Arnold-n/P1P2MQTT/doc/Commands-Eseries.md

# Commands for Altherma 3

Most commands can be given via Home Assistant.

If you want to issue your own instructions, this documents explains how to do so for Altherma/Daikin E-series models.

## Introduction

Daikin Altherma 3 systems (many E-series, with the exception of some EKH and EWYQ/EDHQ/E\*Q series) communicate parameters between the main controller (your room thermostat or main LCD control) and auxiliary controller (P1P2MQTT bridge) in packet types 35, 36, and 3A. Packet types 35 and 3A are used to communicate 8-bit values and packet type 36 is used to communicate 16-bit values.

Using this mechanism many system settings can be controlled. This is done using the `E` command when the bridge is in auxiliary control mode (`L1`), but as of v0.9.46 these commands are generated by Home Assistant using MQTT discovery. The system can be put into control mode (`L1`) via Home Assistant.

## E command examples

The detailed info below is only if you are not using Home Assistant or want to understand the `E` command operation. Some of these parameters may be different for different systems and/or different operation modes of the system. The best way to learn which parameter you need to set it so change a setting manually on the main controller while P1P2Monitor acts as auxiliary controller and data is logged via P1P2/R/#.  The main controller will then inform the P1P2Monitor of the new settings which you can then try to write to. Even better is to have another auxiliary controller write parameters and have P1P2Monitor eavesdrop the communication.

The E command format is `E <packet-type> <parameter-number> <new-value>`, all values hexadecimal. If you hate spaces, you may concatenate these using a 2-char packet-type and 4-byte parameter number: `E35 2F 0` becomes `E35002F0`.

Multiple commands can be given in one line with `E <packet-type1> <parameter-number1> <new-value1>  <packet-type2> <parameter-number2> <new-value2>`.

Before P1P2Monitor version v0.9.55rc2 please pause for a few seconds between commands as commands are not yet buffered (buffering will be added in a future version). As of v0.9.55rc2, write commands are buffered.

If you hate spaces, you may concatenate these using a 2-char packet-type and 4-byte parameter number: `E35 2F 0` becomes `E35002F0`

Some example parameters and commands:

Parameter in packet type 35 for switching cooling/heating off
- 0x31 switches cooling/heating on/off in room temperature control mode (works on EHVX08S23D6V)
- 0x2F switches cooling/heating on/off in LWT control mode (works on EHYHBX08AAV3 and EHBH16CAV3)
- 0x2D (works on EHVX08S26CA9W and/or in certain operation modes?)

Commands to switch heating off and on on EHYHBX08AAV3 in LWT control mode:
- `E 35 2F 0` (or `E35002F0` or `E35002F00`)
- `E 35 2F 1` (or `E35002F1` or `E35002F01`)
- Some systems require both 0x31 and 0x2F: `E35002F01 35003101`

Switching between heating, cooling, and automatic mode
- parameter nr 0x4E (works on EHYHBX08AAV3) (value 0=heating 1=cooling 2=auto)
- `E 3A 4E 0` = set mode to heating
- `E 3A 4E 1` = set mode to cooling
- `E 3A 4E 2` = set mode to auto
Budulinek reports that parameter 0x3A this may not work correctly, and that parameter 0x4E in packet type 3A may have to be used instead.

Parameter in packet type 35 for switching DHW on/off
- 0x40 (works on EHVX08S23D6V and EHBH16CAV3) (and/or in certain DHW operating modes)
- 0x3E (works on EHVX08S26CA9W) (and/or in certain DHW operating modes)

Parameter in packet type 35 for switching DHW boost on/off
- 0x48 (works on EHVX08S26CB9W)

Parameter in packet type 35 for selecting heating mode (ABS/AWT/ABS+dev/AWT+dev) (not always allowed!)
- 0x56 (works on EHYHBX08AAV3)

Parameter in packet type 35 for selecting silent mode
- 0x03 (value 0=off, 1=on)

Parameter in packet type 35 for selecting silent level
- 0x01 (value 1..3 (3 most silent))

Parameter in packet type 36 for setting target room temperature (only in room-thermostat mode)
- 0x00 (works on EHYHBX08AAV3)

Example commands to set room temperature setpoint
- E 36 0 BE sets room temperature setpoint to 0xBE = 190 = 19.0 C
- E 36 0 C8 sets room temperature setpoint to 0xC8 = 200 = 20.0 C

Parameter in packet type 36 for setting DHW setpoint
- 0x03 (works on EHYHBX08AAV3 and EHBH16CAV3)

Parameter in packet type 36 for setting heating temperature setpoint (only in fixed LWT mode)
- 0x06 (works on EHBH16CAV3 and EHYHBX08AAV3)

Parameter in packet type 36 for setting cooling temperature setpoint (only in fixed LWT mode)
- 0x07 (works on EHVX08S26CB9W, likely on others too)

Example commands to set fixed LWT mode main zone temperature setpoint
- E36 6 015E sets LWT setpoint to 0x015E = 350 = 35.0 C
- E36 6 01C2 sets LWT setpoint to 0x01C2 = 450 = 45.0 C

Parameter in packet type 36 for setting main zone heating temperature deviation (only in weather-dependent LWT mode)
- 0x08 (works on EHYHBX08AAV3)

Example commands to set WD-LWT mode curve deviation
- `E36 8 0` sets deviation to +0 C
- `E36 8 A` sets deviation to +1 C
- `E36 8 FFF6` sets deviation to -1 C

Parameter in packet type 36 for setting main zone cooling temperature deviation (only in weather-dependent LWT mode)
- 0x09 (works on EHYHBX08AAV3)

Parameter in packet type 36 for setting additional zone heating temperature deviation in WD mode
- 0x0D (works on EHYHBX08AAV3)

Some other parameters:
- parameter 0x31 in packet type 3A is perhaps used to disable/enable holiday (to be confirmed)
- parameter 0x4B in packet type 3A is used to switch between 0=manual and 1=automatic DST mode
- parameter 0x5B in packet type 3A is used to switch holiday 0=off 1=on
- parameter 0x5E in packet type 3A is used to switch between heating schedules
- parameter 0x5F in packet type 3A is used to switch between cooling schedules
- parameter 0x64 in packet type 3A is used to switch between DHW schedules

Force defrost (defrost start is subject to outdoor unit conditions):
- `E35003601`

Many thanks to Budulinek for finding some of these parameters. More writable parameters can be found in Budulinek's [documentation](https://github.com/budulinek/Daikin-P1P2---UDP-Gateway/blob/main/Payload-data-write.md).
