Arnold-n/P1P2MQTT/howto/Arduino_IDE_setup_combiboard.md

# Arduino IDE setup for P1P2Monitor and P1P2-bridge-esp8266 on Arduino Uno or on Uno/ESP8266 combi-board

The Arduino Uno or combi-board is no longer recommended for this project.
