Arnold-n/P1P2MQTT/(threads)

Thread 27 (2022-08-29):

[home-assistant] Energy statistics not available

Timple, 2022-08-29:
I wanted to add my heatpump to the energy dashboard but it was not in the dropdown list.

As requested per this link: https://www.home-assistant.io/more-info/statistics/ I know opened this issue pointing this project to this link: https://developers.home-assistant.io/docs/core/entity/sensor/#long-term-statistics

Is the `state_class` something that can be communicated via mqtt?

Arnold-n, 2022-08-29:
Thanks tim, hopefully this works in just released P1P2-bridge-esp8266 v0.9.18. Coding is done ad-hoc, as it will be coded differently in P1P2MQTT.

Timple, 2022-08-30:
Great, thanks!

Would it make sense to attached these releases as binaries to the releases tab in github?

Arnold-n, 2022-08-30:
Just did! Thanks for the suggestion.

Timple, 2022-08-31:
Awesome!
I'll verify asap (which is two weeks unfortunately)

Timple, 2022-09-12:
Works! Thanks 👍

Closed 2022-08-31.

Thread 29 (2022-09-04):

[Home Assistant] some topics fail discovery

fishbone-git, 2022-09-04:
Home Assistant logs attached below. I suspect te issue is an MQTT buffer problem as it seems to be the very long topic names that get cut off at the end, so the discovery topic fails to parse due to missing closing } at least
[halogs.txt](https://github.com/Arnold-n/P1P2Serial/files/9485553/halogs.txt)

Arnold-n, 2022-09-04:
Hi @fishbone-git, indeed it is the MQTT buffer size, please upgrade to 0.9.18 which increases this (HA_VALUE_LEN) from 300 to 600 to resolve this issue.

fishbone-git, 2022-09-04:
in progress

fishbone-git, 2022-09-04:
The buffer problem appears solved, but there is a new problem.  I'm using HA 2022.9.0b4.  All topics appear in MQTT broker, and in th discovery topic.  HA is having a problem with a number of them, and so they are no longer available entities in HA after upgrading to 0.9.18. Hard  to check all topics, but the ones generating the error all seem to have state_class="".  I do not believe this is allowed by HA.  When I manually publish a discovery topic to remove state_class="", it immediately creates an entity in HA
[halogs.txt](https://github.com/Arnold-n/P1P2Serial/files/9485604/halogs.txt)

Arnold-n, 2022-09-04:
You're fast and fully correct! Sorry, I should have advised to jump to the newest version: 0fd7519 solves this too.

fishbone-git, 2022-09-04:
I just spotted that too :).  I guess let's close this and either I'll see if I can now get a working build or wait until next binaries are published. Thx!

Arnold-n, 2022-09-04:
I'll make them available soon - was waiting for the climate and water heater integration to be finished and tested.

Arnold-n, 2022-09-04:
Not as official release, but v0.9.20 images (for E_series) are [here](https://github.com/Arnold-n/P1P2Serial/tree/main/Firmware_images).

Arnold-n, 2022-09-05:
The images have been replaced as the ATmega OTA upgrade didn't work properly due to a BSP issue on my side. The current Eseries images should be fine.

fishbone-git, 2022-09-06:
Thanks.  I'll try the images tonight and see if there is a difference.  I did finally manage to get a build on arduinoIDE that seems stable

Closed 2022-09-04.

Thread 30 (2022-11-03):

Interested in buying p1p2-esp interface

stomko11, 2022-11-03:
As title says. Do you have any available?
Can I have both this and daikin controller connected at the same time? How do I wire them?

Arnold-n, 2022-11-03:
Hi @stomko11 please send me email for details.

Not sure if you refer to the main (room) controller or the Daikin LAN/WiFi adapter.

All controllers are wired in parallel on P1 and P2.
You must have one "main controller" which is the room controller/thermostat.
You may have one (in some systems two) auxiliary controllers active, such as a Daikin LAN adapter, or P1P2Serial, but not both.

P1P2Serial can also work in listen-only mode, in which case it can always be connected to P1/P2, but only if there not too many consumers on the bus (we do not know what the max bus load is).

stomko11, 2022-11-04:
Hello. I actually failed to find your email address anywhere - where do I send you email?
I am using only one controller currently, it is not serving as thermostat, for that I use external on/off contact. So my daikin controller serves only to configure my Altherma air to water heatpump. I would like to keep that available in technical room, and wire that in parallel somehow. Main goal is to be able to turn on/off DHW/Heating. Would I just connect it on the pins inside controller?
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

Arnold-n, 2022-11-04:
Indeed you can wire it in parallel, near the controller in your image, or near the heat pump, as long as there is WiFi (or if there is ethernet with the extra ethernet adapter). As the wires in your picture are quite thick I would split them outside the unit, and make the last wire thinner (= more flexible). My e-mail is a bit hidden in the README and [in the code](https://github.com/Arnold-n/P1P2Serial/blob/main/P1P2Serial.cpp#L3).

Thread 35 (2022-11-19):

About P1P2 energy consumption data

kervanaslan, 2022-11-19:
Hi Arnold,

Firstly, thanks for this great job.
I'm wondering if it is possible to periodically get Energy consumption data from P1P2. Does P1P2 some how send data?

You defined KLICK-DA is a way to get it, but without KLICK-DA are we able to get it?

Arnold-n, 2022-11-19:
Hi @kervanaslan,

Thanks for asking and your appreciation. This is possible on some systems using the "C2" command. Given limited resolution, an external meter is still preferred (and will be supported as input  over MQTT for COP calculation in the future).

The KLIC-DA is indeed not the preferred solution. It was a difficult hack made (with lots of trial and error) for a KLIC-DA owner where KLIC-DA was already acting as an auxiliary controller. There is little opportunity in the P1/P2 protocol to request the energy consumption counters. The KLIC-DA solution may not work reliably on other systems. And the KLIC-DA device ignores the heat pump replies itself, just as the main controller - the main controller only updates the counters if it requests the counters itself, and the KLIC-DA device relies on the main controller only.

Unfortunately within the Daikin protocol implementation there is no known "legal" way to request these counters from the heat pump - the main controller (the wall thermostat) only requests the counters when requested  manually, or at the end of each month. There is no (documented) way to trigger the main controller to request these counters. The current solution (enabled by the "C2" command) is to let the P1P2-ESP-interface request the counters directly from the heat pump. This may confuse the main controller; perhaps this leads in some systems to the main controller and the heat pump both responding at the same time. In my system the heat pump answers, and shortly after the main controller continues regular operation, so it works find. You can try "C2" and see if the communication pattern is acceptable. If not, it will result in errors, and after 10 errors the interface will switch itself of as a safety mechanism.

If the mechanism works (and if the heat pump does measure energy consumption and similar counters, your system may be different) the following information may be seen on MQTT topics P1P2/P/xxx/C/1/#:
```
P1P2/P/154/C/1/Electricity_Consumed_Backup_Heating 0
P1P2/P/154/C/1/Electricity_Consumed_Backup_DHW 0
P1P2/P/154/C/1/Electricity_Consumed_Compressor_Heating 16777
P1P2/P/154/C/1/Electricity_Consumed_Compressor_Cooling 0
P1P2/P/154/C/1/Electricity_Consumed_Compressor_DHW 0
P1P2/P/154/C/1/Electricity_Consumed_Total 39305
P1P2/P/154/C/1/Energy_Produced_Heatpump_Heating 148206
P1P2/P/154/C/1/Energy_Produced_Heatpump_Cooling 0
P1P2/P/154/C/1/Energy_Produced_Heatpump_DHW 0
P1P2/P/154/C/1/Energy_Produced_Heatpump_Total 148206
P1P2/P/154/C/1/Hours_Circulation_Pump 36037
P1P2/P/154/C/1/Hours_Compressor_Heating 28968
P1P2/P/154/C/1/Hours_Compressor_Cooling 0
P1P2/P/154/C/1/Hours_Compressor_DHW 0
P1P2/P/154/C/1/Hours_Backup1_Heating 0
P1P2/P/154/C/1/Hours_Backup1_DHW 0
P1P2/P/154/C/1/Hours_Backup2_Heating 0
P1P2/P/154/C/1/Hours_Backup2_DHW 0
P1P2/P/154/C/1/Hours_Unknown_34 0
P1P2/P/154/C/1/Hours_Unknown_35 0
P1P2/P/154/C/1/Counter_Unknown_00 0
P1P2/P/154/C/1/Counter_Unknown_01 0
P1P2/P/154/C/1/Counter_Unknown_02 0
P1P2/P/154/C/1/Starts_Compressor 21022
P1P2/P/154/C/1/Hours_Gasboiler_Heating 12857
P1P2/P/154/C/1/Hours_Gasboiler_DHW 513
P1P2/P/154/C/1/Counter_Gasboiler_Heating 0 (some systems report gas usage here)
P1P2/P/154/C/1/Counter_Gasboiler_DHW 0 (some systems report gas usage here)
P1P2/P/154/C/1/Starts_Gasboiler 46897
```
Strangely, the counter for Electricity_Consumed_Compressor_Heating stopped counting in 2018, also on the main controller from Daikin, even before I started with P1/P2 experiments, but the Electricity_Consumed_Total continues to update. There are other users with the same problem.

Thread 41 (2022-12-23):

Rotex RKHBRD016 (Daikin Altherma EKHBRD-ADV17), strange values

mrrepel, 2022-12-23:
Hi,

First of all, thanks to Arnold for sending the P1P2ESP quickly, it arrived within 2 days and, looking at the construction method, I can only say that it is like an commercial product! After I received it I immediately got tinkering.

Unfortunately it seems that my heat pump is not supported. The values fluctuate on some sensors (not all) and the values are not correct.

Below is a screenshot of the HA interface.

I am not a programmer but a hobbyist. I would like to hear if and how I can help with providing logs etc. so that this heat pump can also be supported. The values I am particularly interested in are;
- DHW temp
- Leaving / return temp
-Outside temp

Kind regards, Barry

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

Arnold-n, 2022-12-23:
Thanks @mrrepel for your feedback. Indeed RKH*/EKH* systems (which I think are called Altherma 2) are not as wel supported as Altherma 3 systems. For now I think we would be able to modify the code such that it reports a number of sensor values (I hope at least some of the temperatures (49.000, 44.582, 33.906) are correct for your system even if the names used may be wrong). We will need to write a separate header file for the EKH systems. It would be helpful for me to receive your logs of raw data P1P2/R/# together with a description of system changes made during the log (on/off, target setings changed manually, temperature values changing as a response, so we can match these to the changes in the raw data logs).

There are a few EKH* users with the P1/P2 interface so this issue would be a good place to start sharing EKH/RKH experiences.

inmantaci, 2022-12-24:
Now that my holidays have started I picked it up again for my Altherma 2 (EKHVH008BB6WN). I can already report the following:

1. Set point values are decoded correctly. However the labels are not correct. The following changes need to happen.
   - `S1_DHW_Setpoint_Response` -> Target temperature leaving water. There is no room thermostat in my system, so room temperature is not the correct label I think.
   - `S0_Target_Temperature_Room` -> Target temperature DHW Tank

2. All measured values seem to have the wrong encoding applied. The jump up and down while on the controller itself only the value after the . seem to fluctuate. I "hacked" the NTC of my boiler with 2 relays so that I can let it measure the correct value, a very low value or a high value. I use this to make it heat only on solar in the summer. This also means that I can create an mqtt dump while the values change before the .

I have not dived deeps enough into but at the very least it seems that the byte order is different (or not fixed point at all). Often the part behind the . is stable while the part before it fluctuates a lot. The results of my experiment are as follows. The files attached are the dumps that correspond to the values the daikin controller reported. I wrote down all the values I saw:

A. 44.1 44.2 44.4
B. 31.5 31.6
C. 56.9 57

[B.txt](https://github.com/Arnold-n/P1P2Serial/files/10298491/B.txt)
[C.txt](https://github.com/Arnold-n/P1P2Serial/files/10298492/C.txt)
[A.txt](https://github.com/Arnold-n/P1P2Serial/files/10298493/A.txt)

Based on the changing values, my guess is that this sensor is labeled `T1_Temperature_DHW_Tank`

Once we can find the correct encoding, it should not be to difficult anymore to also correctly label all other values. They all report the same strange values.

bartv, 2022-12-24:
Now that my holidays have started I picked it up again for my Altherma 2 (EKHVH008BB6WN). I can already report the following:

1. Set point values are decoded correctly. However the labels are not correct. The following changes need to happen.
   - `S1_DHW_Setpoint_Response` -> Target temperature leaving water. There is no room thermostat in my system, so room temperature is not the correct label I think.
   - `S0_Target_Temperature_Room` -> Target temperature DHW Tank

2. All measured values seem to have the wrong encoding applied. The jump up and down while on the controller itself only the value after the . seem to fluctuate. I "hacked" the NTC of my boiler with 2 relays so that I can let it measure the correct value, a very low value or a high value. I use this to make it heat only on solar in the summer. This also means that I can create an mqtt dump while the values change before the .

I have not dived deeps enough into but at the very least it seems that the byte order is different (or not fixed point at all). Often the part behind the . is stable while the part before it fluctuates a lot. The results of my experiment are as follows. The files attached are the dumps that correspond to the values the daikin controller reported. I wrote down all the values I saw:

A. 44.1 44.2 44.4
B. 31.5 31.6
C. 56.9 57

[B.txt](https://github.com/Arnold-n/P1P2Serial/files/10298491/B.txt)
[C.txt](https://github.com/Arnold-n/P1P2Serial/files/10298492/C.txt)
[A.txt](https://github.com/Arnold-n/P1P2Serial/files/10298493/A.txt)

Based on the changing values, my guess is that this sensor is labeled `T1_Temperature_DHW_Tank`

Once we can find the correct encoding, it should not be to difficult anymore to also correctly label all other values. They all report the same strange values.

Arnold-n, 2022-12-24:
Hi @bartv - thanks very much, very useful information. I will set up a separate header file for EKH over the next week based on your findings.

The user manual for the EKHBRD-ADV17 system indicates that it supports a main controller (room thermostat) and a slave controller (2nd room thermostat, used for controlling but not really as room thermostat). If someone would have a system with 2 such controllers and make raw data logs when changing settings on the 2nd auxiliary/slave controller, we could determine whether the protocol between main controller (master) and auxiliary controller (slave) would function in the same way as on other systems, and we would actually be able to control EKH/RKH systems too!

bartv, 2022-12-24:
Yeah, I have already started searching ebay and 2hands for something like that. No luck so far :-)

bartv, 2022-12-24:
My C is a bit rusty and the code is not the most accessible to make changes to so I wrote a short python script to validate my suspicion that the bytes are swapped. In the A trace I was able to get the 3 values I read on the controller like this:

```python
data = """05084C2CD41704184818F414A9
05084C2CD417181848180C1557
05084C2CD41730183018F4140E
05084C2CEC17181830180C1530
05084C2CEC1718184818F41456
05084C2CEC17301848180C152D
0508282C0418181830180C15EC
0508282C0418301848180C15F1
0508282CD417041860180C1594
0508282CD417181830180C1512
0508282CD41718184818F41474
0508282CEC17041830180C15ED
0508282CEC17181830180C1557
0508282CEC1718184818F41431
05084C2C0418301848180C1596
05084C2CBC17181830180C1521
05084C2CD417181830180C1575
05084C2CD41718183018F41431
05084C2CD417181848180C1557
05084C2CD41718184818F41413
05084C2CD417181860180C1549
05084C2CD41730183018F4140E
05084C2CEC17181830180C1530
05084C2CEC1718183018F41474
05084C2CEC17181848180C1512
05084C2CEC1718184818F41456
05084C2CEC17301830180C150F
05084C2CEC17301848180C152D
05084C2CEC1730184818F41469
05086C2CBC17181830180C1534
05086C2CD41704184818F414BC
05086C2CD41718183018F41424
05086C2CD417181848180C1542
05086C2CEC1704184818F414F9"""

for line in data.splitlines():
    data = []
    for i in range(int(len(line) / 2)):
        data.append(int(line[2*i:2*i+2], 16))

    vars = data[2:4]
    print("{:2.1f}".format(vars[1] + vars[0] / 256))
```

So the value is like f8_8, except the function should be:
```c
float FN_f8_8(uint8_t *b)            { return (((int8_t) b[0]) + (b[-1] * 1.0 / 256)); }
```

mrrepel, 2022-12-24:
The DHW setpoint response seems to be the  "stooklijn" from the weather setpoint. This is the preset for leaving temp hot water for heating (when it is cold, the heatingwater will be warmer and vice versa, see graph). Setting 3 in the menu. I also use an external thermostat with the EKRP1AHTA interface card (dry relais), so there are no room temperature settings for me.

Also the next sensors are correct:
S0_Heating_OnOff
S0_DHW_OnOff
S0_Quiet_Mode
S1_Defrost_Operation

Mismatches in names:
T1_Temperature_Refrigerant_1 seems to be T1_Temperature_Return_Water
T1_Temperature_Outside_1 seems to be  T1_Temperature_DHW_Tank

Because i switch the heatpump on/off externally for heating i think these ones are correct to:
S1_Circulation_Pump_OnOff
S1_Compressor_OnOff

The warmtepomp on/off is a relais starting/stopping heating

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

bartv, 2022-12-25:
I did an attempt to update the firmware to already figure out the correct labels. I am unable to generate a working firmware using the arduino ide. It compiles and can uploaded (both using serial and OTA), the boards responds to a ping but it does not connect to MQTT and the telnet interface does not come up. I used my arduino ide before, even for esp* boards. I guess there must be some setting that is wrong?

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

Arnold-n, 2022-12-25:
Hi @bartv, I think you have flash size set to default 1MB instead of 4MB. This value determines where the "EEPROM" (wifi/mqtt) data is stored. Even with 1MB selected, the WiFiManager AP "P1P2MQTT" should restart to allow entering your wifi/mqtt settings. If you change the configuration to 4MB, I think you will get the original settings back. Please let me know if that does not help - ultimate fall-back is programming with the USB programmer and "Erase Flash: All".

Also there are some changes needed to the BSP and libraries. The ESP_Telnet library owner implemented my suggestion for making the library working with ethernet differently than I did, so for the current ESP code you still need my modified version of the library, or #undefine ETHERNET, or change the code. I will update the code to allow the use of the official library now it is updated.

bartv, 2022-12-25:
That did the trick. I patched the f8_8 function to swap the bytes and now I get all stable readings
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

Arnold-n, 2022-12-25:
Great, many thanks! I'll incorporate this change and the name corrections into the new header file for EKH/RKH systems, or if you prefer, feel free to do so yourself.

bartv, 2022-12-25:
I created a draft PR with my findings and experiments: https://github.com/Arnold-n/P1P2Serial/pull/46

@mrrepel if you want I can also post a firmware image

Arnold-n, 2022-12-25:
Thanks - I would suggest to use #ifdef EKH constructs to keep the original functionality maintained for Altherma 3, or to create a separate header file for EKH.

bartv, 2022-12-25:
That is why I created the PR. I am not sure on how much is shared between E* and EKH*. So first I am going to make the change in the E header and then decide on how to support both.

mrrepel, 2022-12-25:
@bartv , that would be really nice!

Some logs from my system are added. If there is any need for specific logs / actions, please tell.
[log1.txt](https://github.com/Arnold-n/P1P2Serial/files/10300037/log1.txt)

bartv, 2022-12-25:
I can confirm that the outside temperature is correct.

bartv, 2022-12-25:
> @bartv , that would be really nice if you post the image.
>
> Some logs from my system are added. If there is any need for specific logs / actions, please tell. [log1.txt](https://github.com/Arnold-n/P1P2Serial/files/10300037/log1.txt)

[P1P2-bridge-change.ino.generic.zip](https://github.com/Arnold-n/P1P2Serial/files/10300619/P1P2-bridge-change.ino.generic.zip)

bartv, 2022-12-25:
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

You might need to remove the integration from HA and let it discover again so that the renamed values are gone.

bartv, 2022-12-26:
I was able to figure out some more fields. Others are still work in progress. I create another repo with my scripts and current documentation:
https://github.com/bartv/p1p2decoder/blob/main/ekh.py

The summary:
https://github.com/bartv/p1p2decoder/blob/main/ekh.md

mrrepel, 2022-12-26:
Thanx Bart for sharing the firmware. Just finished flashing the ESP and after some trial and error i got the interface working again (fully my fault :-)).

The values and labels have changed, some readings work, others dont.

<html xmlns:v="urn:schemas-microsoft-com:vml"
xmlns:o="urn:schemas-microsoft-com:office:office"
xmlns:x="urn:schemas-microsoft-com:office:excel"
xmlns="http://www.w3.org/TR/REC-html40">

<head>

<meta name=ProgId content=Excel.Sheet>
<meta name=Generator content="Microsoft Excel 15">
<link id=Main-File rel=Main-File
href="file:///C:/Users/mrrepel/AppData/Local/Temp/msohtmlclip1/01/clip.htm">
<link rel=File-List
href="file:///C:/Users/mrrepel/AppData/Local/Temp/msohtmlclip1/01/clip_filelist.xml">
<style>
<!--table
	{mso-displayed-decimal-separator:"\,";
	mso-displayed-thousand-separator:"\.";}
@page
	{margin:.75in .7in .75in .7in;
	mso-header-margin:.3in;
	mso-footer-margin:.3in;}
tr
	{mso-height-source:auto;}
col
	{mso-width-source:auto;}
br
	{mso-data-placement:same-cell;}
td
	{padding-top:1px;
	padding-right:1px;
	padding-left:1px;
	mso-ignore:padding;
	color:black;
	font-size:11.0pt;
	font-weight:400;
	font-style:normal;
	text-decoration:none;
	font-family:Calibri, sans-serif;
	mso-font-charset:0;
	mso-number-format:General;
	text-align:general;
	vertical-align:bottom;
	border:none;
	mso-background-source:auto;
	mso-pattern:auto;
	mso-protection:locked visible;
	white-space:nowrap;
	mso-rotate:0;}
.xl63
	{mso-number-format:"\@";}
-->
</style>
</head>

<body link="#0563C1" vlink="#954F72">

Label | Arnold | Bart
-- | -- | --
S0 DHW on/off | ok | ok
S0DHW setpoint response | not sure | fault, stays at 16'C
S0 heating on/off | ok | ok
S0 Quit mode | ok | ok
S1 circulation pump | ok | to be tested (seems ok)
S1 compressor on/off | ok | to be tested (seems ok)
S1 defrost operation | ok | ok
S1 target temp leaving water | NA | ok
T1 temperature DHW tank | fault (+120/-120'C) | fault (0,2/0,8'C)
T1 Temperature_HP2Gas_Water | NA | fault (5/-80'C)
T1 leaving water | fault (near 0'C) | ok (resolution 1 degree)
T1 temp outside | label fault, must be T1_Temperature_DHW_Tank | fault, stays at 0'C
T1 temp refrigirant 1 | label fault, must be T1_Temperature_Return_Water | fault, (+120/-120'C)
T1 temp return water | fault (near 0'C) | label fault, must be T1_Temperature_Outside
mqtt: valve 3 way |   | equal to S0 DHW on/off

</body>

</html>

For my heatpump a combination of both could do the trick:

<html xmlns:v="urn:schemas-microsoft-com:vml"
xmlns:o="urn:schemas-microsoft-com:office:office"
xmlns:x="urn:schemas-microsoft-com:office:excel"
xmlns="http://www.w3.org/TR/REC-html40">

<head>

<meta name=ProgId content=Excel.Sheet>
<meta name=Generator content="Microsoft Excel 15">
<link id=Main-File rel=Main-File
href="file:///C:/Users/mrrepel/AppData/Local/Temp/msohtmlclip1/01/clip.htm">
<link rel=File-List
href="file:///C:/Users/mrrepel/AppData/Local/Temp/msohtmlclip1/01/clip_filelist.xml">
<style>
<!--table
	{mso-displayed-decimal-separator:"\,";
	mso-displayed-thousand-separator:"\.";}
@page
	{margin:.75in .7in .75in .7in;
	mso-header-margin:.3in;
	mso-footer-margin:.3in;}
tr
	{mso-height-source:auto;}
col
	{mso-width-source:auto;}
br
	{mso-data-placement:same-cell;}
td
	{padding-top:1px;
	padding-right:1px;
	padding-left:1px;
	mso-ignore:padding;
	color:black;
	font-size:11.0pt;
	font-weight:400;
	font-style:normal;
	text-decoration:none;
	font-family:Calibri, sans-serif;
	mso-font-charset:0;
	mso-number-format:General;
	text-align:general;
	vertical-align:bottom;
	border:none;
	mso-background-source:auto;
	mso-pattern:auto;
	mso-protection:locked visible;
	white-space:nowrap;
	mso-rotate:0;}
.xl65
	{font-weight:700;}
-->
</style>
</head>

<body link="#0563C1" vlink="#954F72">

Label | Function
-- | --
S0 DHW on/off | Arnold/bart S0 DHW on/off
S0DHW setpoint response | Arnold S0 DHW setpont response
S0 heating on/off | Arnold/bart S0 heating on/off
S0 Quit mode | Arnold/bart S0 Quit/mode
S1 circulation pump | Arnold/bart S1 circulation/pump
S1 compressor on/off | Arnold/bart S1 compressor on/off
S1 defrost operation | Arnold/bart S1 defrost/operation
S1 target temp leaving water | Bart S1 target temp leaving water
T1 temperature DHW tank | Arnold T1 temp outside
T1 leaving water | Bart T1 leaving/water
T1 temp outside | Bart T1 temp return water
T1 temp return water | Arnold T1 temp refrigirant 1

</body>

</html>
My programming skills are the same as my French....bonjour, croissant and thats it. So i am sorry my help is limited. If it is possible to make an combination of both, you would be my heroes! :-)

Greetings,

Barry

aluisperezh, 2023-01-03:
Hi everybody. I'm using Arnold's interface with my EKHBRD011ADV17, and found the same results of the first part of this thread. I'll try to read the rest and report back.

For what is worth, my installation includes a RTD-W interface, which is connected to the P1/P2 inetrface and provides ModBus connection. I can manage some options and read and write (some) values with the ModBus connection, but not all of them.

If anybody wants me to test something, just tell me.

Thanks everybody for your work and regards.

Angel

bartv, 2023-01-03:
That would be really cool. It would be interesting if you can create two dumps:

1. a longer dump that just records what is going on when you are not making change. Mainly to see if and how there is interaction between the RTD-W and the main controller.
2. a short dump where you change setting through modbus

I create the dumps like this (replace with your mqtt server):

```
mosquitto_sub --host 192.168.32.23 -v -t "P1P2/R/040" > dump.txt
```

Arnold-n, 2023-01-03:
@aluisperezh indeed as @bartv mentions: logs are useful both making no changes, when making changes on the main controller, and when making changes with the RTD-W.

Perhaps it is interesting to do a full log also when the system restarts, to determine if there is any particular extra communication with the RTD-W which is only there during/shortly after a system restart.

aluisperezh, 2023-01-03:
I'm recording the "standard working" logs right now, but there are not many lines written: only one ("P1P2/R/078 R T  0.003: 40F0344B") in the last few minutes. Should I enable some verbose option or anything like that? I'll leave it recording all night and tomorrow I'll record some more changing things through RTD-W. Restarting the whole machine (I understand that that's what you mean, Arnold) is a little bit more difficult, but I'll try.

Regards

Angel

aluisperezh, 2023-01-04:
Must be doing something wrong. No other lines in the output file but the one I saw yesterday...

bartv, 2023-01-04:
> Must be doing something wrong. No other lines in the output file but the one I saw yesterday...

What command do you use to subscribe to the mqtt stream?

aluisperezh, 2023-01-04:
This is what I'm using:

nohup mosquitto_sub --host 192.168.98.11 -u myuser -P mypassword -v -t "P1P2/R/078" > dump_standard_working.txt &

With mqtt Explorer I can't see any more messages. And I assumed that your 040 should be my 078 (final byte of IP address).

Regards

aluisperezh, 2023-01-04:
There is nothing else there:
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

And I can see that the device is connected through telnet:
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

aluisperezh, 2023-01-05:
I restarted the Altherma machine. I won't be able to do it when I'm back home tonight, so I did it now. There are no other lines besides the one I sent yesterday, but the telnet session gives some more info. I have attached what I could see there.

My P1P2 device is powered by the P1P2 interface, so everything is restarted. I mean, no commands provided through telnet or any other way.

I can connect trhough telnet or to the MQTT server from home, so I can do some tests later.

Regards
Angel
[Conexión Telnet.txt](https://github.com/Arnold-n/P1P2Serial/files/10352181/Conexion.Telnet.txt)

Arnold-n, 2023-01-05:
Hi @aluisperezh , thanks and interesting, you seem to have a Daikin system where a payload may be longer than 24 bytes. P1P2Serial is optimized for Daikin and we have never seen payloads more than 24 bytes so far. This explains the ":OR- buffer overrun error. Telnet by default only shows messages with errors, so that is why you see only 00F038 and related messages (and a few caused by ESP serial input buffer overruns - this is another issue).

MQTT explorer cannot easily log all the P1P2/R/# data, but in telnet you will see all raw hex data by entering the command
`j13013
`
Could you try that?

Increasing P1P2Serial's buffer size can be done by changing, in P1P2Serial.h, RX_BUFFER_SIZE and TX_BUFFERSIZE from 25 in max-packet-length+1 (I cannot deduce the max packet length from your log, too large will give instability issues, but 65 would be OK and may be enough). I just sent you a P1P2Monitor firmware image by mail with increased buffer size.

aluisperezh, 2023-01-06:
Wow. More than 1M of text in a few minutes... I attached the zip-compressed file. Now I'm trying to find out how to update the firmware without breaking everything (I'm an expert on doing that). As soon as I do it I'll try to get both MQTT and telnet info.

Regards.
[telnet_j13013.zip](https://github.com/Arnold-n/P1P2Serial/files/10362420/telnet_j13013.zip)

trantoriana, 2023-01-07:
> MQTT explorer cannot easily log all the P1P2/R/# data, but in telnet you will see all raw hex data

I have a small python program for logging mqtt topics to file as telnet is bothersome.
If needed I can share.

Arnold-n, 2023-01-07:
Thanks for your inputs. My analysis so far is that there are differences:
@bartv has a EKHVH008BB6WN
@aluisperezh  and @aluisperezh have a EKHBRD* system
and the raw packet data is not the same:

For the EKHVHV, there are unfortunately no 00F0* messages in the logs above, suggesting the system does not support an auxiliary controller, whereas for EKHBRD* systems there are 00F0* messages and communication between main system and RTD-W, and the communication style is closer to the F* Daikin models than to the Altherma 3 models.

Packet type 000010 (from main controller):
-EKHVHV: 17 byte payload with a number of settings
-EKHBRD: 18 byte payload with  a number of (similar) settings

Packet type 000011 (from main controller):
-both: 3 byte payload, likely with last 2 bytes representing measured room temperature (LE)

Packet type 400010 (from EKH):
-both: 20 bytes, with somewhat similar structure

Packet type 400011 (from EKH):
-EKHVHV: 12 bytes, 2 bytes unknown followed by 5 temperature sensors (BE (!))
-EKHBRD: 12 bytes, 2 bytes unknown followed by perhaps 5 temperature sensors (LE)

Packet types 38 with header 00F038/40F038 for main-aux control data (EKHBRD only)  are
```00F038 00 00 01 00 41 00 0A 00 20 00 08 00 00 00 00 00 00 06 00 05```
```40F038 00 01 00 41 00 0A 00 20 00 00 00 00 00 05```
and most of these settings relate directly to the heat pump status information in 400010 from EKH to main controller:
`400010 00 00 01 00 41 00 0A 00 20 00 18 00 00 00 00 00 02 00 00`

It would be interesting to monitor 00F038* and 40F038* when making changes on the main controller and via RTD-W, and match time of these changes.

aluisperezh, 2023-01-07:
Thanks for the info, Arnold. I will try to make some changes through RTD-W while monitoring the P1P2 device, but I'm not sure about timing. I manage RTD-W through Home Assistant, which is NTP synchronized, but I don't remember assigning an NTP server to P1P2. Let's hope Mosquitto in HA is in sync. I'll try to make changes with some time in between to be sure they don't get meses.

I can't try this until monday morning, but I'll be back with the results.

Thanks again everybody.

Arnold-n, 2023-01-08:
Hi @aluisperezh, and indeed I meant to log telnet while making the changes; time is then derivable from the 00F034 message which contains DayOfWeek, Hour, Minute, and Second.

There is no direct ESP time stamp in telnet yet (other than the Uptime info and the 00F034 time stamp), but a decent time stamp is on my todo-list.

But indeed it may be much easier to use HA to log any changes, let me make a EKHBRD firmware image so all relevant information is made available in HA. Not sure if I can manage that today.

aluisperezh, 2023-01-08:
Don't worry. I'll log the telnet sesión and try to match times. And of course I can repeat that any time.

Regards

aluisperezh, 2023-01-09:
Hello everybody.

I'm attaching 3 files. The txt just explains what I did and the results I can see through ModBus. I tried to get the best timing I could.

The "Enable Heating" telnet session is just that, the standard telnet output and the results of enabling heating in HA (through ModBus interface and RTD-W).

The "Heating+Thermostat" includes a few actions. In my installation, the remote thermostat (a Tuya WiFi thermostat) activates the external pump when On and deactivates it when Off. Besides, it is connected to the external Thermostat connector of the machine (I don't remember if it's connected directly to the motherboard or to the RTD-W, sorry).
I turned on the thermostat, and because Heating was already enabled (previous file), STart/Defrost mode was activated first and then compressor turned on too. I recorded the time when Leaving Water Temp got to 45º. Then I stopped heating. Detected changes and times are recorded too. Then I changed the heating Temp and recorded changes.

Finally I turned On and Off DHW.

If there is anything else I can test or need some more data (e.g. from MQTT or HA) or explanations, just tell me.

Thanks and regards.
Angel

[Modbus RTD-W Actions.txt](https://github.com/Arnold-n/P1P2Serial/files/10373399/Modbus.RTD-W.Actions.txt)
[enable_heating.zip](https://github.com/Arnold-n/P1P2Serial/files/10373400/enable_heating.zip)
[heating+thermostat.zip](https://github.com/Arnold-n/P1P2Serial/files/10373401/heating%2Bthermostat.zip)

Arnold-n, 2023-01-09:
Hi @aluisperezh , many thanks, very useful information, I'll process this later.

alandpearson, 2023-02-04:
Hi folks, I've just got a wonderful P1P2 interface from Arnold.
I've got a Daikin EDH016BB6V3 which is the same protocol as EKH (@bartv system)
Very grateful for the work done to get some decoding going.

On my system there are a few things that aren't quite right yet
*) Defrost Operation
*) Compressor active
*) Circ pump active

Things that have not yet been decoded I can think of:
*) Backup Heater Stage 1 active
*) Backup Heater Stage 2 active
*) DHW booster heater active

If only I knew where to start, I'd love to help identify these. Is there a pointer to how I can start to experiment and look at the decodes ?

alandpearson, 2023-02-05:
I've now digested the protocol info (thanks Arnold) and managed to start looking at the data.
 Found a couple of bits that flick in the 40010 message when I call for heat (I suspect these are compressor and circulation pump, but they both happen at the same time)

```
400010 10 0B 01 0023000700010000000000 F8 08 00 1F 01 78 8E		heating off
400010 10 0B 01 0023000700010000000000 0E 09 00 1F 01 78 E0		heating off
400010 **20** 0B **21** 0023000700010000000000 EE 07 00 1F 01 78 42		heating on
```

Modified code accordingly to get them publishing via MQTT and will watch to see if they are compressor and pump.

aluisperezh, 2023-02-05:
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

Maybe you can compare with the captured data I sent a couple messages above. I have both the P1/P2 interface and a ModBus interface, and with this one I can see which device is turned on. But I'm not sure if I have an internal circulation pump. For sure I have an external one, which is turned on by my thermostat, but I can't see anything about an internal pump in the ModBus interface. Perhaps it is in every EKH?

Regards.

alandpearson, 2023-02-05:
Thanks @aluisperezh that's not a bad idea. You have a slightly different system (EKHBRD) than mine (which is the same protocol as @bartv system). But it may be useful.

Seems my guess
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

Thread 56 (2023-01-04):

Altherma 3 RW (EHBH08EF9W) interpretation

trantoriana, 2023-01-04:
Hi Arnold,

Been watching the data on MQTT and home assistant for two days now, and most of the times the mqtt data and HA sensors make sense.

One sensor I am missing though is the operation. In espaltherma this is the 'IU Operation Mode' which is delivered as Stop or Heating.
I am unable to find the right counterpart in p1p2serial.
Presumably one of the OnOff ones, but none are chaning their state. For instance 'S0_Heating_OnOff' is always 1 and does not change.
Any pointers for me on the meaning on some of the sensors?

Also, I am heavily using home assistant in my setup and see it is being worked on.
One thing that may make intergration better is to prefix all HA sensors with 'P1P2_' because the current names are too generic and not unique. Prefixing may help with the finding of the right sensors.

Thanks, Trant

trantoriana, 2023-01-05:
> For instance 'S0_Heating_OnOff' is always 1 and does not change.

ok, 'S0_Heating_OnOff' is the general OnOff for the heatpump.

Looking for another ones... for instance the one when the madoka is displaying heating using the blue light.
Is there a counterpart or should the pump and rising leaving temperature be used for that?

T

Arnold-n, 2023-01-05:
Hi @trantoriana , thanks for your help!

Actually S0_Heating_OnOff is not directly related to "IU operating mode" as it represents the request from the main controller to switch heating on or off (0 indicates source is main controller).

I think that
-"IU Operation Mode" corresponds to S2_DHW_Heating_Gas_Status_related (0=Off, 1=Heating, 4=DHW, 5=Heating+DHW), however this value is only available if an auxiliary controller is present ("L1" or another device), and it is a combination of
-S1_Heating_OnOff or S1_Valve_Zone_Main (both seem to change together, 0 for no heating, 1 for heating, not sure if there are situations where these differ and which would then correspond to IU Operation Mode), and
-S1_Valve_DHW_Tank (0 for no DHW, 1 for DHW).

Can you check how these values are reported on your system?

trantoriana, 2023-01-05:
> Can you check how these values are reported on your system?

Bit inconsistant:

* S/1/Heating_OnOFF_1  is in MQTT but not in HA
* S/1/Valve_Zone_Main   is in MQTT but not in HA
* S/1/Valve_DHW_Tank   is in MQTT but not in HA
* S/2/DHW_Heating_Gas_Status_related not available in HA

I will keep an eye on the values in MQTT so I can let you know

Thanks.

trantoriana, 2023-01-05:
Both heating onoff 1 and Valve main zone switch outside of the heating schedule between 0 and 1, Does not seem to indicate heating :-)

Arnold-n, 2023-01-06:
Thanks, and I can add these sensors to HA in the next version.

W.r.t. your earlier request to prefix sensors with P1P2_, I am hesitant as the names are often too long to be shown entirely, and they are already part of a single device. They should be unique, also because of the S1_ -style prefixes.

trantoriana, 2023-01-07:
>  They should be unique, also because of the S1_ -style prefixes.

True.

However, speaking from a user perspective when creating automations or template sensors, home assistant auto complete is a bit dumb and since I cannot remember the exact p1p2 sensor to pick, starting with p1p2 would reduce the pickable list to only those devices I want to pick from.

Starting with S1 or A9 or A8 or P1 is not unique enough (for me) to pick the sensors, besides... depending on personal naming convention I may already have sensors starting with S1 or P1, commonly modbus devices for instance.

How about adding a configurationable item where user can set the prefix themselves?

> as the names are often too long to be shown entirely

I have yet to come in conflict with the max sensor name length in home assistant, and my fronius sunspec (hacs) integration generates some awfully long sensor names, example:

* sensor.power_photovoltaics_fronius_power_flow_0_http_mountdoom_untrusted_fenced_*********_at

(domain redacted :-) )

so if it is the HA sensor name you worry about, then we should be on the save side.

S/1/Valve_main_Zone seems to indeed be exactly the same as the blue 'heating' light on the modoka thermostat. So that is one I would need.

Slowly I will start looking into controlling the heatpump but I am very modest. I only need:

* Turn heatpump on or off (basically controlling S0_Heating_OnOff)
* Set the target heating water temperatur (S0_Target_Temperature_Heating_Zone_Main_Abs)
* Set the main thermostat room temperatur (s0_target_temperature_room)

All the rest is just to showoff to my friends with the same heatpump :-)

Thanks, Fred

Arnold-n, 2023-01-07:
> How about adding a configurationable item where user can set the prefix themselves?

Understand your ratio, and good idea, I will add it to a next version.

> S/1/Valve_main_Zone seems to indeed be exactly the same as the blue 'heating' light on the modoka thermostat. So that is one I would need.

So it indeed makes sense to add these valves to HA too, consider it done in next version.

Arnold-n, 2023-01-15:
A prefix (defined in P1P2_Config.h) of "P1P2_" is added to all entities if useSensorPrefixHA is true; this can be set using the 8th argument of the B command or (if flash is erased or EEPROM signature is changed) via INIT_USE_SENSOR_PREFIX_HA in P1P2_Config.h. For backwards compatibility the prefix is not set by default, but if there is interest I can make it default for new installations.

The valves should be visible in HA too now.

trantoriana, 2023-01-15:
I guess once I manage to get a new firmware in the esp32 I will be able to verify, still I assume this addresses and close the issue.

Thanks, Trant

Closed 2023-01-15.

Thread 68 (2023-03-20):

Fallback hotspot doesn't stop if wifi is available again

Timple, 2023-03-20:
We just had a full power-outage. And the P1P2Serial device was booted way before my router was.

Therefor the fallback hotspot was enabled. However when the wifi was finally up, the hotspot stayed and the mqtt connection was (thus) not established.

Easily fixed by a powercycle of the heatpump. But next time I might not notice it and we go weeks without logging :slightly_smiling_face:

So this is a minor, but might be easy to fix, dunno. Some frameworks provide such a hotspot fallback themselves (esphome).

Arnold-n, 2023-03-22:
Timeout added in P1P2-bridge-esp8266 v0.9.34.

Timple, 2023-03-23:
Awesome, thanks for all your efforts!

Closed 2023-03-23.

Thread 69 (2023-05-31):

Smart grid option

Timple, 2023-05-31:
Our Daikin heatpump has two relays for smart grid connectivity.

I am not sure if this is even within the protocol, but could this project support the smart grid features as well?

Arnold-n, 2023-06-04:
I think it is possible within the P1/P2 protocol, and it is on my todo-list; I purchased an BRP069A61 to see to what extent this can be done via P1/P2, but this will take some time. I hope P1/P2 enables for more precise control than is possible via the SG relay inputs.

bausi2k, 2023-06-05:
Maybe the hints on this side will help you further: https://community.openhab.org/t/how-to-integrate-daikin-altherma-lt-heat-pump/16488/14

I use the BRP069A61 with a shelly that closes the pins
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
and I send HTTP Request to the BRP069A61 with the form data to change the value the _allowed power consupmtion_. This is a bit hacky, but it works.
The get the formdata, just open an debug window in your browser and see what is going on, when you change values.
But be careful, this only works for an hour, after starting the BRP069A61. After that, the Website will show you a HTTP500 on connection.

Timple, 2023-06-05:
> I hope P1/P2 enables for more precise control than is possible via the SG relay inputs.

And the P1/P2 wires already run into my house, so saves me some new cabling as wireless connection near/inside the heatpump is hard.

I might look into your suggestions as well @bausi2k

Main purpose for now is to start heating the boiler water when te sun is high. To prevent my solar pannels to drop out due to too high voltage on the main :smile: . I need some consumes and this seems like a useful one.

bausi2k, 2023-06-05:
For that case, the BRP069A61 works like a charm. Even if you have a static value for the allowed consumption eg. 3500W the heat-pump takes the power and heats up the boiler(if room buffering is disabled) to the max allowed temperature(60degrees Celsius in my example) event though the desired temperature is only set to 47°C.

olfon, 2023-06-07:
> and I send HTTP Request to the BRP069A61 with the form data to change the value the _allowed power consupmtion_. This is a bit hacky, but it works. The get the formdata, just open an debug window in your browser and see what is going on, when you change values. But be careful, this only works for an hour, after starting the BRP069A61. After that, the Website will show you a HTTP500 on connection.

Would you mind to share the needed HTTP request? My LAN adapter always runs into issues after power loss, it is a hazzle to get it running again. Many thanks in advance :)

bausi2k, 2023-06-09:
This is my complete HTML File - find the form in the lower third

```<!DOCTYPE html>
<html>
	<head>
		<title></title>
	</head>
	<body>
		<form method="post" style="display:initial">
			<h1>
				Smart Grid
			</h1>
			<table id="table_smartgrid" width="40%">
				<tr style="display:table-row">
					<td>
						<p align="right">
							Pulse meter setting
						</p>
					</td>
					<td>
						<select name="DA_SG_PULSE_METER_SETTING">
							<option value="0" selected>
								No meter
							</option>
							<option value="4">
								100 pulse/kWh
							</option>
							<option value="5">
								1000 pulse/kWh
							</option>
						</select>
					</td>
				</tr>
				<tr style="display:table-row">
					<td>
						<p align="right">
							Electrical heaters allowed
						</p>
					</td>
					<td>
						<input type="radio" name="DA_SG_ELECTRICAL_HEATERS_ALLOWED" value="0">No <input type="radio" name="DA_SG_ELECTRICAL_HEATERS_ALLOWED" value="1" checked>Yes
					</td>
				</tr>
				<tr style="display:table-row">
					<td>
						<p align="right">
							Room buffering allowed
						</p>
					</td>
					<td>
						<input type="radio" name="DA_SG_ROOM_BUFFERING_ALLOWED" value="0" checked>No <input type="radio" name="DA_SG_ROOM_BUFFERING_ALLOWED" value="1">Yes
					</td>
				</tr>
				<tr style="display:table-row">
					<td>
						<p align="right">
							Static power limitation
						</p>
					</td>
					<td>
						<select name="DA_SG_STATIC_POWER_LIMITATION">
							<option value="500">
								0.5kW
							</option>
							<option value="1000">
								1kW
							</option>
							<option value="1500">
								1.5kW
							</option>
							<option value="2000">
								2kW
							</option>
							<option value="2500" selected>
								2.5kW
							</option>
							<option value="3000">
								3kW
							</option>
							<option value="3500">
								3.5kW
							</option>
							<option value="4000">
								4kW
							</option>
							<option value="4500">
								4.5kW
							</option>
							<option value="5000">
								5kW
							</option>
							<option value="5500">
								5.5kW
							</option>
							<option value="6000">
								6kW
							</option>
							<option value="6500">
								6.5kW
							</option>
							<option value="7000">
								7kW
							</option>
							<option value="7500">
								7.5kW
							</option>
							<option value="8000">
								8kW
							</option>
							<option value="8500">
								8.5kW
							</option>
							<option value="9000">
								9kW
							</option>
							<option value="9500">
								9.5kW
							</option>
							<option value="10000">
								10kW
							</option>
						</select>
					</td>
				</tr>
				<tr>
					<td>
						<!-- leer -->
					</td>
					<td>
						<input type="submit" name="DA_SG_SUBMIT" value="Submit">
					</td>
				</tr>
			</table>
		</form>
	</body>
</html>
```
[Daikin BRP069A61.txt](https://github.com/Arnold-n/P1P2Serial/files/11709431/Daikin.BRP069A61.txt)

nicx, 2023-09-21:
@Arnold-n any idea when this smart grid feature will be implemented?

@bausi2k am I right that the heat-pump will always be included and its not possible to use only the backup heater? I would like to conserve the heat pump and use only the backup heater for buffering heat in the water tank.

Arnold-n, 2023-09-21:
@nicx this may take some time as other things are higher priority (HA integration and COP calculation).

But why would you prefer the backup heater over the more efficient heat pump?

nicx, 2023-09-21:
> @nicx this may take some time as other things are higher priority (HA integration and COP calculation).
>
> But why would you prefer the backup heater over the more efficient heat pump?

good question, i have also thought about this: i have considered that it might be more gentle for the compressor, especially in the summer months, if it does not only start briefly for the hot water heating.

in my case, the hot water is heated to 45 degrees per default, which takes approx. 1h. in case of pv surplus i switch the smart grid contact, the hot water is then heated up to 55 degrees. this again takes about 1h. this would mean 2 compressor starts per day, which could be saved by using the heating rod. out of the belly, the heating rod is wear-free, but the compressor is not. maybe the compressor will last a few years longer this way?! ;)

bausi2k, 2023-09-21:
As far as I know, you can only tell the heatpump to do it's work with a defined amount of power in kWh.
Options are
* Electrical Heater [TREU/FALSE]
* Room Buffering [TREU/FALSE]

Arnold-n, 2023-09-21:
> good question, i have also thought about this: i have considered that it might be more gentle for the compressor, especially in the summer months, if it does not only start briefly for the hot water heating.
> in my case, the hot water is heated to 45 degrees per default, which takes approx. 1h. in case of pv surplus i switch the smart grid contact, the hot water is then heated up to 55 degrees. this again takes about 1h. this would mean 2 compressor starts per day, which could be saved by using the heating rod. out of the belly, the heating rod is wear-free, but the compressor is not. maybe the compressor will last a few years longer this way?! ;)

True, though 30 starts/day is not uncommon in winter due to defrosts, so I would personally not worry about 2 starts/day for DHW.

> oh and with pv surplus the efficiency is rather secondary I think.

I guess that depends on your personal goals and local electricity pricing.

nicx, 2023-09-21:
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

I will monitor that in the upcoming winter which is my first one ;) My Goal would be to have as minimum compressor starts as possible. so in best case its 1 and the heat pump ist just running all day (for heating my house).

bausi2k, 2023-09-21:
With the BRP06(whatever) you have full control about when and how long your heatpump runs, so you can optimise that. Defrosting is another issue of course…

My heatpump is controlled by Loxone, because ist is much easier and also more energy efficient. I don't see any reason why my hp should run at 3am in autumn at moderate temperature…

nicx, 2023-09-21:
@Arnold-n another thought: i could switch the heating rod on and off more often, and depending on the pv surplus, i could also let it run for a short time. i could imagine that the compressor prefers it to run for a minimum time at startup and not to clock. it wouldn't matter to the heating rod, which could also be switched on every 5 minutes, for example.

Th301, 2024-01-09:
Hi @bausi2k ,
I found your comment here, that you are using the LAN-adapter for Daikin with Loxone.
I also use Loxone and I am still looking for the best possibility to read/write stuff in my Altherma 3 H/HT (with the old Rotex-Controll Unit).
Which heatpump and controller do you have? Do you have some additional info on your general setup between heatpump and Loxone? Would be cool! :)

bausi2k, 2024-01-10:
> Hi @bausi2k , I found your comment here, that you are using the LAN-adapter for Daikin with Loxone. I also use Loxone and I am still looking for the best possibility to read/write stuff in my Altherma 3 H/HT (with the old Rotex-Controll Unit). Which heatpump and controller do you have? Do you have some additional info on your general setup between heatpump and Loxone? Would be cool! :)

@th301
Hi, since Loxone doesn't know anything about ws(websockets) I'm using NodeRed to translate.
I use the *Level 3* intergration of [the Loxone climate control](https://www.loxone.com/enen/kb/overview-indoor-climate/) where the Daikin EHBH/X(whatever) operations modes:

* switched on/off
* heating/cooling
* VLT/incomming water temperature
* tank operation on/oof
* tank water temperature
are controlled.

for details on NodeRed Integration find this [thread & post](https://community.openenergymonitor.org/t/hack-my-heat-pump-and-publish-data-onto-emoncms/2551/45)

joncage, 2024-05-09:
Any updates on this @Arnold-n? Anything a fellow dev could help with?

I've got ESPAltherma hooked up to my EHVH11SU26CB6W but what I really want to do is do whatever it is the LAN adapter does to handle a PWM signal to adjust the power usage of the heatpump.

We have a 5kW cap on our export and on sunnier days are regularly hitting that so would be nice to have a gentle way to soak up the extra head into our DHW.

Since the LAN adapter supposedly can do this via PWM and my heatpump is apparently compatible with the BRP, I'm hoping there could be a way to do the same thing via your little module when hooked up to my RPI5 home assistant :)

Arnold-n, 2024-05-18:
Still on my activity list, for now the only power limiting option is to use the quiet levels which also limit the maximum power consumption.

Staacks, 2024-05-19:
Although I only did a quick manual test so far, I would like to add my thoughts about the differences between quiet mode and power limiting as I am not only interested in this because of solar power management, but also to improve efficiency.

If my heatpump draws full 2kW for water heating I observe a massive drop of the average heat exchanger temperature on the outside unit. This is of course not surprising, but it also reduces the COP as the unit has to work against a larger temperature difference. I expect that in a situation when time is not critical, slowly heating the water at 1kW or less would lead to a higher COP when the heat exchanger is not cooled down that much and can maintain a higher temperature.

In the release notes for v0.9.46 you mention that the quiet mode actually has a better efficiency then the default mode, which you attribute to lower power consumption of the fan. I suspect that it is actually due to the heat exchanger not being cooled down so much and the reduced fan speed would actually be counter productive here. So, if time is not an issue and if you are not concerned about noise, running the fan at max, but heating only at 50% (i.e. power limiting instead of quiet mode) might actually be even more efficient.

(Disclaimer: These are the thoughts of a physicists with a Carnot process in mind. Some insights by an engineer or just some experience from someone who tested this more systematically are very welcome :) )

Arnold-n, 2024-05-19:
Your experience matches with mine: that is why I prefer 24-hour operation at low load and also prefer to have 24-hour averaging of outside temperature to avoid having a higher load at lower outside temperatures when COP is worse.

But surprisingly, if the system is already in low-load, it still helps to reduce the fan setting. At 1kW power consumption in my 8kW system, silent level 3 does not limit the compressor any further but does limit the fan, giving a 5% higher COP:
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

Staacks, 2024-05-19:
Fantastic info, thanks. Can't wait to find some time (and good weather conditions) to compare with my system. Have been thinking about using 24h average as well. (But then we would be leaving the original topic of this issue.)

nicx, 2024-06-04:
> @nicx this may take some time as other things are higher priority (HA integration and COP calculation).

@Arnold-n many thanks for the HA and COP integration! :) Now I think we can go back to the origin topic question: Is the smart grid control still on your list? any idea when it will be implemented.

This feature would be the last missing feature to completely get rid of my ESPaltherma which I have running in parallel to P1P2MQTT ;)

Arnold-n, 2024-06-04:
You're welcome, thanks! Smart grid release is still (and high) on the agenda, but cannot predict yet when.

forTT78, 2024-09-28:
>  Smart grid release is still (and high) on the agenda, but cannot predict yet when.

Hi together, is there an update on this? :innocent:

Arnold-n, 2024-09-29:
Hope to provide this in October!

buennerbernd, 2024-11-04:
> Your experience matches with mine: that is why I prefer 24-hour operation at low load and also prefer to have 24-hour averaging of outside temperature to avoid having a higher load at lower outside temperatures when COP is worse.

Has your heatpump a setting to support 24-hour averaging of outside temperature?
I don't find this in my Altherma 3HHT. I would love to use such a setting. My heatpump reacts a little bit too fast on changing temperatures. So I have these two effects:

- I have an unnecessary overheating when there is just a single cold night.
- If it was longer cold and the walls are still cold and it is the first warmer day at the outside, it is getting fresh in the house.

donjonsn, 2024-11-06:
Out of curiosity, will it be possible to support the same settings which are possible with the Dakin Home Hub EKRHH? The device has an extensive set of registers accessible by modbus. It looks like this is what is needed for this ticket, even better than the BRP069A61.

Arnold-n, 2024-11-06:
> > Has your heatpump a setting to support 24-hour averaging of outside temperature?
>
> See e.g. 9.B.3 [1-0A]. But I don't know if this average value is visible via P1P2MQTT.

As far as I know the average value is not communicated over P1/P2. If the outside temperature is within the weather-dependent range points, it can be calculated from the current LWT setpoint. I plan to add temperature averaging in the code anyway.

Arnold-n, 2024-11-06:
> Out of curiosity, will it be possible to support the same settings which are possible with the Dakin Home Hub EKRHH? The device has an extensive set of registers accessible by modbus. It looks like this is what is needed for this ticket, even better than the BRP069A61.

Plan is to something similar indeed. It seems the EKRHH implements SG more direct, if I understand correctly it adds a dynamic power limitation via modbus registers 57/58, whereas the BRP069A61 calculates from the E_meter input what the power limitation should be.  However availability of the EKRHH is still very limited.

donjonsn, 2024-11-07:
> Plan is to something similar indeed. It seems the EKRHH implements SG more direct, if I understand correctly it adds a dynamic power limitation via modbus registers 57/58, whereas the BRP069A61 calculates from the E_meter input what the power limitation should be. However availability of the EKRHH is still very limited.

In addition, register 1 (inlet temperature) looks very promising to me because it allows to dynamically limit the heating to what is needed or do rooms heat buffering even if you do not have a Daikin room thermostat.

Arnold-n, 2024-11-07:
> In addition, register 1 (inlet temperature) looks very promising to me because it allows to dynamically limit the heating to what is needed or do rooms heat buffering even if you do not have a Daikin room thermostat.

Depending on the operation mode (LWT absolute or weather-dependent) it is already possible from HA to control power indirectly via the LWT setpoint resp. LWT deviation setpoint. The power is then determined by flow and difference with return temperature; the latter may be influenced by other factors depending on your heating system.

MichaelST01, 2024-11-07:
Does your Modul work with EKRHH? I thought it is not working? I have EKRHH working (Modbus-Mode), if you need to try something I would be happy to help.

Arnold-n, 2024-11-07:
Thanks! The bridge does not communicate with EKRHH, so EKRHH and the P1P2MQTT bridge will both act as auxiliary controller. I expect that when LWT is set from either that the last value will remain active. Would be interesting to see how dynamic power limitation is communicated in the P1/P2 traffic, so a log of P1P2/R# while hex data output is activated ('J3') and power limitations are changed over Modbus would be very useful.

MichaelST01, 2024-11-09:
I'll try to do it. I need to update my Modbus settings first (I actually don't use power limitations at all).
For installing of the EKRHH the firmware of the heatpump had to be updated.
Also the modbus registers changed compared to MB/IO modul.

When I telnet to the bridge I get following msgs:
`[ESP] 2024-11-09 22:10:08 Unknown packetSrc 0x40 packetType 0x31 index 3
[ESP] 2024-11-09 22:10:08 Unknown packetSrc 0x40 packetType 0x31 index 4
[ESP] 2024-11-09 22:10:09 Unknown packetSrc 0x00 packetType 0x31 index 0
[ESP] 2024-11-09 22:10:09 Unknown packetSrc 0x00 packetType 0x31 index 3
[ESP] 2024-11-09 22:10:09 Unknown packetSrc 0x00 packetType 0x31 index 4
[ESP] 2024-11-09 22:10:09 Unknown packetSrc 0x00 packetType 0x31 index 11`

any hints how I can get rid of this?

These are the modbus registers related to that:
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
Do you mean setting that? For dynamic power a special power meter is needed which I don't have.

Arnold-n, 2024-11-09:
The msg suggests the EKRHH gets another ID than 0xF0/0xF1/0xFF. I need to modify the code a bit to get rid of these but I would need a bit more info, can you either run [v0.9.56rc1](https://github.com/Arnold-n/P1P2MQTT/blob/main/Firmware_images/P1P2MQTT-bridge-v0.9.56rc1-Daikin-E.ino.bin) and look at the msgs again, or have a look at the hex data packet 00xx31/40xx31 where xx deviates from 0xF0/0xF1/0xFF which triggers these messages?

As for the power meter, I think it is one of the ways the EKRHH can do power limitation, but instead of a meter input signal I think you can also write the power limit directly to the modbus register (58 or 1002, not sure which).

MichaelST01, 2024-11-09:
I tried v0.9.56rc1. It is still the same msg. In attachment there is the hex log.
[Log unknown packetsrc.txt](https://github.com/user-attachments/files/17689564/Log.unknown.packetsrc.txt)

Arnold-n, 2024-11-09:
Thanks! The msg is slightly more informative, and the hex log is even more useful. The EKRHH takes auxiliary controller address 0xF2. I'll provide you with an updated firmware tomorrow that can keep history of the 0x31/0x32 messages.

Arnold-n, 2024-11-10:
[P1P2MQTT-bridge v0.9.56rc2](https://github.com/Arnold-n/P1P2MQTT/blob/main/Firmware_images/P1P2MQTT-bridge-v0.9.56rc2-Daikin-E.ino.bin) gets rid of the error messages and can inform you about changes in the 0x31 and in the new 0x32 packet from/to the EKRHH in topics like `P1P2/P/P1P2MQTT/bridge0/U/E/PacketSrc_0x40_Type_0x32_Byte_15` if you use the 'J102' command.

MichaelST01, 2024-11-10:
Hi Arnold, it works now.
Here is the log file where I changed General Power Limit (Modbus 58) to 19, 18, 17, 18, 19, 20  (kW)
If this is useful, I can try it with the specific Power Limit (Modbus 57) and the Operating-Modus (SG)

[log p1p2 modbus 58 (general power limit).txt](https://github.com/user-attachments/files/17693118/log.p1p2.modbus.58.general.power.limit.txt)

MichaelST01, 2024-11-25:
> [P1P2MQTT-bridge v0.9.56rc2](https://github.com/Arnold-n/P1P2MQTT/blob/main/Firmware_images/P1P2MQTT-bridge-v0.9.56rc2-Daikin-E.ino.bin) gets rid of the error messages and can inform you about changes in the 0x31 and in the new 0x32 packet from/to the EKRHH in topics like `P1P2/P/P1P2MQTT/bridge0/U/E/PacketSrc_0x40_Type_0x32_Byte_15` if you use the 'J102' command.

There is no change in this values:
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

On the heatpump it was changes because the modbus register shows the new values.
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

Still getting some errors:
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

Arnold-n, 2024-11-27:
Many thanks! Seems packet 0x32 is surprisingly meaningless.

The EKRHH seems to use (previously unseen) parameter numbers 0x0093-0x00A0 and 0x0194-0x0195 in packet type 35, but these are mostly 0 all the time. The only parameter which matches your system changes is 0x0094 which seems to communicate the general power limit (with 0.5kW resolution, in u16div2 notation).

New P1P2MQTT-bridge firmware v0.9.57 should resolve all errors above and will output various SG related entities in subdevice HC_SG, perhaps one of these will show up to change during your experiments.

MichaelST01, 2024-11-27:
Hi Arnold, I installed v0.9.57 but in HomeAssistant I don't get values (even if I change) (I changed SG Mode Value and And Limit for "Empfohlen Ein")
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

when I changed "General Power Limit" new sensors appeared:
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

MichaelST01, 2024-11-27:
Long Log:
[log p1p1 modbus SG Mode new.txt](https://github.com/user-attachments/files/17937102/log.p1p1.modbus.SG.Mode.new.txt)

From that log I found out that this: repeats 6 times and is related to SG Mode: 3
00F235950100FFFFFFFFFFFFFFFFFFFFFFFFFFFFFF27
```
        Line   181: [MON] 2024-11-27 15:24:57 R T  0.025: 00F235950101FFFFFFFFFFFFFFFFFFFFFFFFFFFFFFFE
	Line   700: [MON] 2024-11-27 15:25:30 R T  0.025: 00F235950101FFFFFFFFFFFFFFFFFFFFFFFFFFFFFFFE
	Line 51082: [MON] 2024-11-27 16:20:12 R T  0.025: 00F235950101FFFFFFFFFFFFFFFFFFFFFFFFFFFFFFFE
	Line 51567: [MON] 2024-11-27 16:20:42 R T  0.025: 00F235950101FFFFFFFFFFFFFFFFFFFFFFFFFFFFFFFE
	Line 52362: [MON] 2024-11-27 16:21:32 R T  0.025: 00F235950101FFFFFFFFFFFFFFFFFFFFFFFFFFFFFFFE
	Line 52692: [MON] 2024-11-27 16:21:52 R T  0.025: 00F235950101FFFFFFFFFFFFFFFFFFFFFFFFFFFFFFFE
```

this log should be SG Mode 2 (but not 100% sure)
00F235950100FFFFFFFFFFFFFFFFFFFFFFFFFFFFFF27
`	Line   381: [MON] 2024-11-27 15:25:10 R T  0.025: 00F235950100FFFFFFFFFFFFFFFFFFFFFFFFFFFFFF27
	Line   865: [MON] 2024-11-27 15:25:39 R T  0.025: 00F235950100FFFFFFFFFFFFFFFFFFFFFFFFFFFFFF27
	Line 51278: [MON] 2024-11-27 16:20:24 R T  0.025: 00F235950100FFFFFFFFFFFFFFFFFFFFFFFFFFFFFF27
	Line 51730: [MON] 2024-11-27 16:20:52 R T  0.025: 00F235950100FFFFFFFFFFFFFFFFFFFFFFFFFFFFFF27
	Line 52529: [MON] 2024-11-27 16:21:43 R T  0.025: 00F235950100FFFFFFFFFFFFFFFFFFFFFFFFFFFFFF27
	Line 52853: [MON] 2024-11-27 16:22:02 R T  0.025: 00F235950100FFFFFFFFFFFFFFFFFFFFFFFFFFFFFF27`

log related to SG Mode 0 not found

the times are related to the actual changes with modbus (I made the log larger to filter out other stuff)

I changed in total 6 times in the order SG Mode 3, SG Mode 2, SG Mode 0

Arnold-n, 2024-11-27:
I just uploaded v0.9.58rc2 which should now really fix the errors/unavailability of the SG entities and should make analysis easier... I have not yet renamed the info above to make a SG-mode entity, it is still called SG_Q_35-0195. In the messages above, the message 00F235 9501 01 encodes in packet type 35 that the single-byte parameter nr 0195 has changed to 01.

MichaelST01, 2024-12-11:
Hi Arnold, still no values at in SG section: Just HC_SG SG_General_Power_Limit shows "127" which is not correct.
Could this single Byte parameter Nr.195 be anyhow related with SG Mode? Is this somehow connected to : parameter list?
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

nicx, 2024-12-29:
I just installed 0.9.58 and got the SC sensors. Am I right that this is the current dev state and I cannot set the SG ready state yet?

nicx, 2025-01-08:
@Arnold-n could you perhaps give me a very short yes/no answer? :)

Arnold-n, 2025-01-08:
Sorry, slipped through, indeed currently SG control paramters can only be set via the cryptic E command and not yet from HA, for example setting limit parameter 94 in packet 35 to 19kW can be done with E35009426 (0x26=38, 38/2=19).

I think "127" means "no limit" - to be verified.

Confusingly there were 2 entities with the same name `SG_General_Power_Limit`, these are now renamed to `SG_35_0094-General_Power_Limit_kW` and `SG_General_Power_Limit_2`. Entity `SG_Q_35-0195` is (for) now renamed to `SG_35-0195-Mode3` in v0.9.58rc9.

MichaelST01, 2025-01-09:
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

This one works:
SG_General_Power_Limit_2 -> corresponds to Modbus 58 (Allgemeine Leistungsbegrenzung) 0-20kW (20 -> 127)

Changes in Modbus 57 (Leistungsbegrenz während Empfohlen Ein / Pufferung)
and
Changes in Modbus 56 (SG_Mode)

are not displayed in HC_SG

Arnold-n, 2025-01-13:
Thanks, I'll try to look into the others.

nicx, 2025-01-28:
Some more insights from my setup, maybe it helps in getting this smart grid control done :)

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

Arnold-n, 2025-01-28:
This suggests that 5 is not a power limit but a status?

nicx, 2025-01-29:
@Arnold-n no I don't think so. As far as I understand the sensor value "HC_SG SG_35_0093-General_Power_Limit_Active_Q" is directly reflecting the Smart Grid mode (free running = 0; recommended on = 1). after smart grid mode is switched tn "recommended on", the Daikin itself decides when to start extra heating. That's why the value "5" is set a little bit later in the sensors "HC_SG SG_35_0094-General_Power_Limit_kW" and "HC_SG SG_General_Power_Limit_ 2". This is exactly the time when the Daikin decides to start the extra heating.

savage7, 2025-03-04:
@Arnold-n I is there a chance that this work via the P1P2 adapter?
If no I'll try to connect a shelly uni to control the Smart Grid option.

buennerbernd, 2025-04-01:
The only SG related topic I can see is SG_General_Power_Limit_2 (always = 127)
Are there any preconditions to get the other mentioned values? (Any configurations?)

I'm using pur MQTT, not HA.
I don't have any SG hardware connected to the heatpump.

buennerbernd, 2025-04-02:
I will answer my latest question by myself.
The other SG topics (0093 - 00A0) occurred immediately after I have enabled the controller mode by
`L1`

MichaelST01,
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

Thread 73 (2023-07-20):

counter request mode not reliable

nicx, 2023-07-20:
When trying to activate the counter request mode via telnet it sometimes works, sometimes not. When not working I get these messages:

```
P1P2/S/009 * [ESP] To ATmega: ->C1<-
P1P2/S/009 * [MON] Single counter request cycle initiated
P1P2/S/009 * [MON] T  0.024: -PE:4000B8000000000000000000000000000000000000007A readError=0x0004
P1P2/S/009 * [ESP] Uptime 1380
P1P2/S/009 * [MON] T  0.024: 4000-PE:B0-PE:10-PE:00-PE:00000000000000-PE:00-PE:00-PE:00000000-PE:4059 CRC error readError=0x0014
P1P2/S/009 * [ESP] Uptime 1390
P1P2/S/009 * [MON] T  0.024: -PE:4000B800000000000000000000000000-PE:80-PE:80F2 CRC error readError=0x0014
P1P2/S/009 * [MON] T  0.024: 4000-PE:A4-PE:01-PE:04-PE:040000-PE:08000000-PE:10-PE:04-PE:0400000000000000DA CRC error readError=0x0014
P1P2/S/009 * [ESP] Uptime 1400
P1P2/S/009 * [MON] T  0.024: -PE:40-PE:005C02-PE:00-PE:200000-PE:000000-PE:00-PE:00-PE:000000-PE:20-PE:40F2 CRC error readError=0x0014
P1P2/S/009 * [ESP] Uptime 1410
P1P2/S/009 * [MON] T  0.024: 40A0-PE:A1-PE:A8-PE:02-PE:02EAFB-PE:C3-PE:F9-PE:FF-PE:FF-PE:01-PE:01-PE:01-PE:FF-PE:FF-PE:FF-PE:0300000029 CRC error readError=0x0014
P1P2/S/009 * [ESP] Uptime 1420
P1P2/S/009 * [ESP] Uptime 1430
```

After the "not working case" the Auxiliary controller mode is disabled automatically, too. I cannot reenable it afterwords, I get the following error message:

```
P1P2/S/009 * [ESP] To ATmega: ->L1<-
P1P2/S/009 * [MON] Errorspermitted (error budget) too low; control functionality cannot enabled
```

As already said, sometimes the counter request mode works. I am wondering what I could do to get both modes working reliable. My Daikin model is a Altherma 3 R Ech2O EHSXB08P30E. Any hints?

Arnold-n, 2023-07-20:
Thanks for reporting this. Can you please share a short part of the P1P2/R/# log (or the telnet output in "J10" mode? There is one other system where the main Daikin controller doesn't like the protocol violation that is necessary for the counter request. What happens is that the output with the counters from the Daikin EHSCB08P30E collides with the next request from the main Daikin wall controller (Daikin forgot to implement bus collission detection). And indeed sometimes it works, sometimes it does not, depending on exactly when the counter requests are inserted. An improved counter request insertion mechanism (works on one other system) will be released soon in v0.9.41; I hope that it will work for you too.

Disabling the auxiliary control after read errors is a safety measure to prevent the risk of bus collissions or other errors. Once the "error budget" is restored (after 10 hour of error-free operation, or after an ATmega reset), you can restart auxiliary control again. The ATmega can be reset with the "A" command.

nicx, 2023-07-26:
@Arnold-n just a short feedback: with v0.9.41 P1P2Monitor it works now for several days. I still get errors sometimes, but no more disabling of aux control and counter request mode. for me this is a working solution :)

Arnold-n, 2023-07-26:
@nicx, thanks, good to hear, though I am not happy with any remaining errors especially not if they are caused by the counter requests. Would you be able to log P1P2/R/# for a longer period so we can determine the cause of the errors? It's about 140MB/day raw data log, or 6MB/day compressed.

nicx, 2023-07-27:
@Arnold-n sure I can give you logs... any hint how exactly I could get them? :)

Arnold-n, 2023-07-27:
@nicx On a Ubuntu or Raspberry Pi system I use a MQTT client that logs all MQTT traffic to P1P2/R/xxx:
`mosquitto_sub -h 192.168.4.12 -u P1P2 -P P1P2 -v -t P1P2/R/# > mqtt.log`
If that does not work, I can temporarily make a MQTT server available for you that I can log myself - of course I would use a better password known to you and me only.

nicx, 2023-07-29:
@Arnold-n just sent you the logfile via mail. hope it helps :)

nicx, 2023-10-17:
@Arnold-n unfortunately, the "Counter request Mode" has not worked at all for some time. Knowingly I have changed nothing. not even a reset helps.
I installed the latest firmware 0.9.42 today (incl. monitor), but that didn't help either.
Ideas?

```
V
P1P2/S/009 * [ESP] P1P2-bridge-esp8266 v0.9.42
P1P2/S/009 * [ESP] Compiled Sep 29 2023 08:53:51
P1P2/S/009 * [ESP] E-Series
P1P2/S/009 * [ESP] ESP_hw_identifier 1
P1P2/S/009 * [ESP] Connected to MQTT server
P1P2/S/009 * [ESP] MQTT Clientname = P1P2_009
P1P2/S/009 * [ESP] MQTT User = P1P2
P1P2/S/009 * [ESP] MQTT Server = 192.168.0.1
P1P2/S/009 * [ESP] MQTT Port = 1883
P1P2/S/009 * [ESP] ESP reboot reason = 0xFF
P1P2/S/009 * [ESP] outputMode = 0x13003
P1P2/S/009 * [ESP] outputFilter = 1
P1P2/S/009 * [ESP] mqttInputByte4 = 0
P1P2/S/009 * [ESP] EEPROM version = 0
P1P2/S/009 * [ESP] To ATmega: ->V<-
P1P2/S/009 * [MON] 1970-01-01_01:09:45 Verbose 3
P1P2/S/009 * [MON] 1970-01-01_01:09:45 P1P2Monitor-v0.9.42
P1P2/S/009 * [MON] 1970-01-01_01:09:45 Compiled Sep 27 2023 12:49:03 +control NEWP1P2LIB E-series
P1P2/S/009 * [MON] 1970-01-01_01:09:45 Reset cause: MCUSR=2 (ext-reset)
P1P2/S/009 * [MON] 1970-01-01_01:09:45 P1P2-ESP-interface ATmegaHwID v1.2
P1P2/S/009 * [MON] 1970-01-01_01:09:45 Control_ID=0xF0
P1P2/S/009 * [MON] 1970-01-01_01:09:45 CONTROL_ID_DEFAULT=0x0
P1P2/S/009 * [MON] 1970-01-01_01:09:45 Counterrepeatingrequest=1
P1P2/S/009 * [MON] 1970-01-01_01:09:45 F030DELAY=100
P1P2/S/009 * [MON] 1970-01-01_01:09:45 F03XDELAY=30
P1P2/S/009 * [MON] 1970-01-01_01:09:45 Verbosity=3
P1P2/S/009 * [MON] 1970-01-01_01:09:45 CPU_SPEED=8000000
P1P2/S/009 * [MON] 1970-01-01_01:09:45 SERIALSPEED=250000
P1P2/S/009 * [ESP] Uptime 580 at 19700101_01:09:50
C2
P1P2/S/009 * [ESP] To ATmega: ->C2<-
P1P2/S/009 * [MON] 1970-01-01_01:10:10 Repetitive requesting of counter values was already active
P1P2/S/009 * [ESP] Uptime 600 at 19700101_01:10:10

```

Arnold-n, 2023-10-17:
Hi @nicx , can you please share a P1P2/R/# log of a few minutes of your system in C2 mode, both in L0 mode and in L1 mode, preferably after an ATmega reset ('A' command) to ensure writing to the bus is allowed?

Arnold-n, 2023-10-18:
@nicx thanks for the log. The message above may be a bit confusing but there is no error there: it reports ca 10 seconds after ATmega reboot that your system supports two auxiliary controllers 0xF0 and 0xF1. Because the EEPROM remembers that your system was in "L1" mode, it will start using auxiliary control slot 0xF0. I think it is a coincidence that your system gave this message just after you gave the L1 command.

Your log also shows that C2 works nicely: all counter values are requested and provided by your system in the raw bus data. So if the values are not reported to HA, this could be because (1) they are not changed, or (2) they are changed, but for some reason not communicated over MQTT. Is your Daikin system operating (so that counters increase)? Can you try to give the "D3" command, which causes your interfaceto re-communicate all counters even if not recently changed and to re-init all HA sensors?

nicx, 2023-10-18:
ok thats weird... I can see the values again since doing the logging. I dont know if it was the Atmega reset command, or the switching of the C/L modes, or the reset with "d1" at the end of my testings.

The problem was there for some days/weeks... and yes, the daikin was working in that time. anyway, it works again and I will monitor it.

thanks a lot again for your great support!

Arnold-n, 2023-10-18:
You're welcome - if it returns, can you log some P1P2/R/# before reset, to see what might be causing it? Would be even better to log all data on P1P2/# continuously to back-track the cause, but it is ~200MB/day of data.
One possible cause might be if you see more than 1CRC error/hour; actually there should be no CRC errors at all except for when you reset the ATmega and/or the ESP.

nicx, 2023-10-19:
I was too early: after the nightly reboot of HA and MQTT the values are gone, again. "D3" didn't help. "D1" gives me *some* values in HA back. Very strange: In MQTT there are alle values, in HA not:

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

I will do some more tests and give more feedback if there is any comprehensible behavior.

nicx, 2023-10-19:
hm it seems the device/entities in HA has changed somehow. I deleted the MQTT device in HA completely, made a reboot of HA, and the device came back with newly named entities. But now all C-entities are missing completely. BTW a lot of other entities are not shown in HA either (T2, A9, etc.). Is this by design? How decides the MQTT Integration in HA which MQTT values should be populated into HA entities?

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

Arnold-n, 2023-10-19:
Thanks for the info @nicx, I found a bug (introduced in v0.9.41) which explains the issue after a D3 and possibly also after D1, it should be fixed in v0.9.43. It only effects the counters.

In v0.9.43, both D1 and D3 should give all counters back, but it may take 2 minutes for all counters to show in HA. If some are still missing, can you show which counters do not come back in HA?

In the current software architecture it is hard-coded which entities are shown in HA (using the macro "HACONFIG"). It is planned to make this easier to configure.

nicx, 2023-10-19:
@Arnold-n after some more time I can see counters are updating in MQTT, but they are not appearing in HA.
I will test the behavior with the bug fixed version and report what's happening ;) thanks!

nicx, 2023-10-19:
@Arnold-n wit the new version all counters came back after a "D3". I will monitor that over the time. Thanks again!

nicx, 2023-10-20:
@Arnold-n one day later and the problem is back again... no counters are updated. but what I have learned: "d1" or "d3" did not help, switching "C" off and on did not help. only after an atmega reset with "A" all counters are working again immediately. anything I could do to help finding the root cause?

Arnold-n, 2023-10-20:
@nicx can you share logs again (preferably before the "A" / "Dx" commands)? Without I am kind of blind. Did you see an error message after "C2" on P1P2/S/# ? If yes, it might be the safety mechanism that blocks writing after too many bus read errors were observed (such errors should really not be present), and we would need to find the cause for the errors; in this case it is worth looking at all logs, and at V_bus_ATmega_ADC_* values reported (which should be ~12V for _avg and small for _diff) and at Error_Budget (which should increase from 10 to 20 and should not decrease except during reset actions). If no, I am not sure yet on the cause.

nicx, 2023-10-21:
@Arnold-n I just sent you the logfile. If you need more, let me know :)

Arnold-n, 2023-10-22:
@nicx thanks. I can see a problem now.

In the log several ESP resets are visible. These ESP resets cause a state change in P1P2Monitor's counter request code making it to stop requesting counters. I'll need to look a bit deeper into the precise cause and solution.

As for the ESP resets, did you trigger all of these? I wonder if the ESP resets are caused by the missing connection to the NTP server - does your bridge indeed have no internet access for an NTP server at your location?

nicx, 2023-10-22:
@Arnold-n yes, non of my IOT devices do have access to the internet. I have an internal NTP server. I did not trigger any reset during logging.

is it possible to configure the ntp server in any way? otherwise I could grant internet to the module.

Arnold-n, 2023-10-22:
@nicx it seems the missing NTP server is causing the ESP resets. Even worse, it causes a low-memory situation which causes the ESP to skip some of the outgoing MQTT messages. You can see this in the MQTT output (even if is is sometimes incomplete, see below). Free memory should be around 15000, not near 6000. I can reproduce this problem by blocking internet access from my module. I do not currently know whether it is a memory leak by the TZ library or a MQTT buffer problem due to NTP-related delays (I think the latter), and how I should avoid this problem in case of a missing NTP server. I will look into that later, but have other priorities first. But let me send you a firmware version with NTP disabled - that should solve the ESP resets and restore MQTT reliability on your side.

Separately I will improve the P1P2Monitor counter request code such that it isn't disturbed by ESP resets.

`ESP_Mem_free = 6024`
`MQTT_disconnected_skipped_packets = 110`
`MQTT_disconnected_time_total = 6`
`MQTT_disconnects = 2`
`MQTT_messages_skipped_low_mem = 56476`
`MQTT_messages_skipped_not_connected = 117`

Arnold-n, 2023-10-22:
Hi Timo,

As promised, the firmware without NTP/TZ support. I guess the waits for a
missing server are causing havoc, in combination with some behaviour in
P1P2Monitor seen only in ESP reboots which will be solved later.

Kind regards,
Arnold

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

nicx, 2023-10-22:
@Arnold-n thanks a lot, but where can I find the firmware? :)

Arnold-n, 2024-05-18:
v0.9.48 and later have an option to disable NTP requests (`P33 0`), and all counter request issues are hopefully solved.

nicx, 2024-06-04:
@Arnold-n thanks! is disabling NTP available via Home Assistant HC_ controls, too?

Arnold-n, 2024-06-04:
Not yet, but thanks for the suggestion, I will add it in a next version, in the `HC_Setup` section. For now it can be done with the commands (via P1P2/W or telnet)  `P33 0` to change it and `D5` to save it to EEPROM.

Closed 2024-05-18.

Thread 74 (2023-07-23):

mqtt reconnect timeout

nicx, 2023-07-23:
hey, i am using the module now for a few days. in general it works good :)

my problem: every night, i stop all my docker containers (including mqtt server container and ha docker container) for backup purposes. after the backup they are restartet. the duration for this is 10 to 15 minutes.

the p1p2serial module is not reconnecting at all, all sensors are "unknown" in ha. after the command "d1" via telnet, all is working fine again.

is there any reconnection implemented in the software? if yes: is the a maximum timeout? could this be configured in any way?

Arnold-n, 2023-07-23:
Glad it works usually! And I think it should reconnect automatically even in your situation. It reconnects here automatically even after a longer MQTT server timeout.

As long as WiFi remains available, the ESP will try to reconnect to the MQTT server every 5 seconds; if that doesn't succeed within 150 seconds, the ESP will restart (=D0), after which it will continue its reconnection attempts every 5 seconds, and it will also restart every 150 seconds. So there is no maximum timeout. And even without WiFi, the portal that will initiate after an ESP restart will timeout after 180 seconds to enable a WiFi reconnection attempt. So I do not yet understand why it does not reconnect on your side.  (and at this moment the maximum timeout (or reattempt time) can only be changed in the configuration header file but this requires recompilation).

Can you log and check what the ESP reports over telnet during and after the MQTT server timeout? This may require restarting your telnet sessions several times as the telnet sessions end when the ESP restarts. Are you sure it does not connect, or does it connect but is it not publishing new MQTT info?

nicx, 2023-07-24:
@Arnold-n thanks for your explanation. and you are right: the mitt connection reconnects, just checked it after the last night. I can see some values publishing, but not all of them (eg the C- and S-values are no more published). I am wondering why in HA *all* sensors are unknown... even the still published ones (T-values). As already written, after a reboot everything works again without any extra configuration needed.

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

vie telnet I can see only this messages:

```
P1P2/S/009 * [ESP] Uptime 47470
P1P2/S/009 * [ESP] Uptime 47480
P1P2/S/009 * [ESP] Uptime 47490
P1P2/S/009 * [ESP] Uptime 47500
P1P2/S/009 * [ESP] Uptime 47510
P1P2/S/009 * [ESP] Uptime 47520
P1P2/S/009 * [ESP] Uptime 47530
P1P2/S/009 * [ESP] Uptime 47540
```

anything I could do to see more? ;)

Arnold-n, 2023-07-24:
Thanks for your fast feedback, I think 2 different issues are involved:
-you mention you also restart HA, so I guess HA requires the sensor initialization messages, which are "retained" messages on the MQTT server - but these are lost because the MQTT server was also restarted. These messages are currently not re-transmitted by the ESP after a MQTT reconnection, and
-the C and S values (any unchanged value)  will only be published after a change and these values change infrequently.

But if the ESP restarted at least once during the MQTT server unavailability, both HA init messages and all C/S values should be retransmitted; are you sure your MQTT server is unavailable for more than 150 seconds?

An quick solution would be to (add an option to) restart the ESP after each MQTT reconnect (similar to your D1 restart) or after a MQTT reconnect longer than a certain period (currently effectively already implemented as the 150s restart timer). Or the ESP should resend all HA sensor initialization messages and all data values after each MQTT reconnect. I am not sure it is the best solution to retransmit a lot of data after each MQTT reconnect as it will be a burden for less reliable networks (MQTT reconnects signal a server restart or a network problem).

nicx, 2023-07-24:
@Arnold-n I just checked the logs of my NAS in detail. You are again right: the Matt server ist only unavailable for about seconds. the HA instance is unavailable for some more seconds :)

```
[24.07.2023 02:08:16][mosquitto][info] Stopping mosquitto...
[24.07.2023 02:08:17][mosquitto][info] done! (took 1 seconds)
[24.07.2023 02:08:17][mosquitto][info] Should NOT backup external volumes, sanitizing them...
[24.07.2023 02:08:17][mosquitto][info] Calculated volumes to back up: /mnt/user/appdata/mosquitto
[24.07.2023 02:08:17][mosquitto][info] Backing up mosquitto...
[24.07.2023 02:08:17][mosquitto][info] Backup created without issues
[24.07.2023 02:08:17][mosquitto][warning] Skipping verification for this container because its not wanted!
[24.07.2023 02:08:17][mosquitto][info] Starting mosquitto... (try #1)
[24.07.2023 02:08:20][zigbee2mqtt][info] Stopping zigbee2mqtt...
[24.07.2023 02:08:27][zigbee2mqtt][info] done! (took 7 seconds)
[24.07.2023 02:08:27][zigbee2mqtt][info] Should NOT backup external volumes, sanitizing them...
[24.07.2023 02:08:27][zigbee2mqtt][info] Calculated volumes to back up: /mnt/user/appdata/zigbee2mqtt
[24.07.2023 02:08:27][zigbee2mqtt][info] Backing up zigbee2mqtt...
[24.07.2023 02:08:28][zigbee2mqtt][info] Backup created without issues
[24.07.2023 02:08:28][zigbee2mqtt][warning] Skipping verification for this container because its not wanted!
[24.07.2023 02:08:28][zigbee2mqtt][info] Starting zigbee2mqtt... (try #1)
[...]
[24.07.2023 02:08:58][homeassistant][info] Stopping homeassistant...
[24.07.2023 02:09:09][homeassistant][info] done! (took 11 seconds)
[24.07.2023 02:09:09][homeassistant][info] Should NOT backup external volumes, sanitizing them...
[24.07.2023 02:09:09][homeassistant][info] Calculated volumes to back up: /mnt/user/appdata/homeassistant
[24.07.2023 02:09:09][homeassistant][info] Backing up homeassistant...
[24.07.2023 02:09:09][homeassistant][info] Backup created without issues
[24.07.2023 02:09:09][homeassistant][warning] Skipping verification for this container because its not wanted!
[24.07.2023 02:09:09][homeassistant][info] Starting homeassistant... (try #1)
```

so as far as I understand you, I need to restart the ESP manually (or via an automation in HA which sends the "D1" command via telnet), as long as the ESP doesn't send its init messages again after a mutt reconnect. I will try that as a workaround.

Ist it possible to just send the init messages without all other data messages after reconnection? or maybe could I retain the init messages via the server?

Arnold-n, 2023-07-24:
Indeed, and I can add is as an option for a next release.

Based on [this topic](https://stackoverflow.com/questions/36126725/how-to-retain-messages-in-mqtt-if-the-mosquitto-broker-goes-down) storing retained messages on the server over a restart is possible via the persistence option.

Resending the init messages after a reconnect is possible but also a lot of data, so the data throttling after a restart is needed, can be done but takes a bit more work than just a restart.

nicx, 2023-07-24:
@Arnold-n ok I created a short python script as workaround:

```
#!/usr/bin/python3

import sys
import telnetlib

HOST = "192.168.1.9"
PORT = "23"
TIMEOUT = 5

tn = telnetlib.Telnet(HOST,PORT,TIMEOUT)
tn.read_until(b"Uptime")
tn.write(b"D1\n")
tn.close()
```

in addition I created an automation in HA which calls that script triggers by the HA restart itself. Will see if it works as expected this night and give feedback :)

anyway, it would be great if you implement a solution directly in the firmware ;)

fuecy, 2023-07-24:
Just my 2 cents.

If you are using mosquito, you can save retained messages to disk which make them available after reboot of mosquito. See https://mosquitto.org/man/mosquitto-conf-5.html autosave_on_changes.

@Arnold-n, as an alternative, you could potentially listen to the birth message of home assistant on the mqtt, to send the ha sensor configuration again.

gmcmicken, 2023-07-24:
I meant to report this as well a few months back! Good to see some solutions presented

nicx, 2023-07-26:
just a short feedback: both methods work as a workaround. you could use a script for resetting the p1p2 module, or you could save retained messages on persistent storage with mosquitto.

Arnold-n, 2023-08-06:
v0.9.41, just released, adds a few solutions:
-/homeassistant/status online is received, the parameter reporting/throttling is restarted from scratch (thanks @fuecy!)
-if command D3 is received, parameter reporting/throttling is restarted
-if MQTT reconnects AND j-mask includes 0x40000, ESP restarts (and data reporting/throtthling will start from scratch)
-if MQTT reconnects AND j-mask includes 0x80000, data reporting/throttling is restarted from scratch

Thanks again for your feedback which triggered these changes.

Closed 2024-05-18.

Thread 77 (2023-08-12):

I have a sample set extracted, now how do I interpret the payload

BradleyFord, 2023-08-12:
I have managed to get a large data dump from my Daikin VAM; I have get this into Excel.

I can see various notes about different packet types, etc.

How do I take the next step to interpret this info?
(I am hoping to give Arnold an XLS with the various data interpted quite well, as I have about 6 or 7 different types of indoor units and VAM)

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

Arnold-n, 2023-08-13:
Hi @BradleyFord, many thanks for the logs.

Actually the amount of data of this model it not overwhelming; my analysis follows below.

Next step would be to add the 40, 41, and 42 packets to the ESP decoding firmware so you can monitor and try to understand any changing data in relation to your system's operation. I will ping you here when it is ready.

Your log shows the following packets:
-request 000015, always the same content "10 00   00 F0 FF FF    00 F0 FF FF    00 F0 FF FF    00 F0 FF FF"
-reply 4000FF ("not supported?")

-request 00001F, empty payload
-reply 4000FF ("not supported?")

-request 000040, payload length 20, no variation in your log, likely basic settings (on/off etc)
-reply 400040, payload length 19,  no variation in your log

-request 000041, payload length 15, only payload byte 6 changes; byte 5+6 may represent a temperature
-reply 400041, payload length 9,  only byte 5+6 change, may represent a temperature

-request 000042, payload length 8, only payload byte 6 changes
-reply 400042, payload length 11, only payload byte 5 changes

-request 000020, payload length 1, no variation, sensor request?
-reply 400020, payload length 20, no variation

-requests 000120 .. 001020, payload length 1, no variation
-no reply

-requests 00F030, payload length 20
-no reply (no auxiliary controller present)

-request 0000A1, payload length 16, all-zeroes
-reply 4000FF ("not supported")

-request 0000B1, payload length 18, all-zeroes
-reply 4000B1, payload length 18, all-zeroes

-request 800018, payload length 11, no variation
-no reply

-request 808000, empty payload
-no reply

BradleyFord, 2023-08-14:
Great thanks for that, although it would be good if I could help to interpret the payload for you!!!

I will be back home again on Sunday, so can upload the changes then.

It seems I temporarily broke the unit for the other VAM. When configuring I added the wifi, but didnt configure the MQTT and could not find the WebUI to add the MQTT info after configuring Wifi.
So I will reflash it at the same time as well back to defaults with these enhancements, then set Wifi and MQTT at the same time.

The bigger one will be the AC units, that shall be fun :), although that will take me some more time to physically install.

Arnold-n, 2023-08-14:
When the data is reported over MQTT you can definitely help to interpret!

A webUI for MQTT reconfiguration is planned. For now, if you restart (with the reset button) the unit while WiFi is unavailable, it restarts the webUI to configure WiFi and MQTT. Alternatively, you can telnet to it and enter MQTT settings with the B command (B MQTT-IPv4 [MQTT-port [MQTT-user [MQTT-passwrod]]]). Reflashing does not reset MQTT settings unless you explicitly erase all flash memory before doing so.

BradleyFord, 2023-08-21:
I just uploaded another batch of data, also I recorded a video as I slowly go through adjusting each of the settings.
[VAM Raw Data r2.xlsx](https://github.com/Arnold-n/P1P2Serial/files/12395141/VAM.Raw.Data.r2.xlsx)

Here is a link to the video:
https://photos.app.goo.gl/Z3VgmSTmc2sqPWWd9

BradleyFord, 2023-09-21:
Hi Arnold,
Is there anything I can do to help with this?

Thread 80 (2023-09-04):

invalid json in HA sensor discovery for Water_pressure

fuecy, 2023-09-04:
Hi Arnold,

Something minor for Water_pressure. There is an invalid json in the HA sensor discovery. It looks like unit_of_meas is missing. "bar" is in the string, but the key is missing.

{"name":"M1_Water_pressure","stat_t":"P1P2/P/018/M/1/Water_pressure","uniq_id":"M1_Water_pressure_018",bar"ic":"mdi:water","dev":{"name":"P1P2-018","ids":["P1P2ID018"],"mf":"NPC","mdl":"P1P2MQTT_bridge","sw":"0.9.41"}}

Arnold-n, 2023-09-05:
Hi @fuecy,

Thanks for noting this, this will be solved in 0.9.42.

Closed 2024-05-18.

Thread 81 (2023-09-09):

Usage without existing Daikin control module

rubenvanparys, 2023-09-09:
I was wondering, can the presented module work without a Daikin control module attached to the P1P2 port? I have an Altherma 3 without central module but with external thermostat that just gives an on/off relay signal on a different port.

If so, can the P1P2toMQTT do the following things:
- Turning on/off room heating/cooling
- Set dynamically the current/power limit
- Read the on/off state of the external thermostat
These are all things that can be set/read from the heathpumps display, but not sure if they are accessible over P1P2?

Arnold-n, 2023-09-10:
Hi @rubenvanparys ,
Most newer systems have an LCD controller in the inside unit which acts as main controller so even if the P1/P2 port seems empty, any new device should and can still act as auxiliary controller.
At the moemnt you can turn heating/cooling on/off. I haven't looked into the on/off state of an external (relay) thermostat, but I think that is very likely possible. Current/power limit setting should be(come) possible too but is not supported yet in the current version v0.9.41.

Arnold-n, 2024-05-18:
Updates:
-P1/P2 communicates the status of the heating/cooling relay inputs for both main and additional zones, regardless of the mode (room thermostat, external thermostat, or LWT), so the P1P2MQTT bridge outputs these too (starting at v0.9.48) so they can be used as input in HA.
-Power limit setting via P1/P2 is now available via the quiet level selection, which can limit maximum power consumption to a few fixed levels.

Closed 2024-06-05.

Thread 83 (2023-10-20):

Simulate Madoka room thermostat with P1P2Serial

nicx, 2023-10-20:
Is it possible to simulate an external Madoka room thermostat with the P1P2serial module?

My idea: activate the external room thermostat function in my Altherma, then setting the current room temperature with the p1p2 module by writing it via MQTT to the Altherma. with that, I could set the desired room temperature and control the behavior of the Altherma.

My understanding is that the only missing feature is writing the room temperature to the correct register.... or maybe this is already possible?

Arnold-n, 2023-10-20:
This is not yet possible (or not yet known how to), but I hope to dive into this and get it to work. If not, I have been working on a work-around to achieve the same effect.

Arnold-n, 2024-05-18:
A fake room temperature can now be generated by the P1P2MQTT bridge for Daikin E-series systems. This may help to avoid an error message on certain systems that the bridge does not generate a temperature, but we do not know which systems require or accept this.

Command `F1` will switch this function on, with default reported room temperature of 20.0C. Command `F1 205` will change the fake temperature sensor to 20.5C. The permitted room temperature range is 0.0C-25.5C. Command `F0` will switch this function off. By default this function is off. It will also switch off after an ATmega restart, the state is not yet stored in EEPROM.

DiabloVmax1200, 2024-07-14:
Hi I tried this option today with the v0.9.53 two things I mentioned.

- The "F1" is reset after a restart of the Heatpump (as you have written above) Could you store it in the EEPROM?
- at my Daikin Altherma 3 GEO - (EGSAX06DA9W) the Room temperature is always 25.6°C I can't change the value to a different one. this value is shown in MQTT and on the display

Arnold-n, 2024-07-15:
Can you test P1P2Monitor v0.9.54? It should store the setting in EEPROM and should fix the 25.6C bug.

adam-the, 2024-09-29:
Hi Arnold. I've just setup my HA to send the current room temperature to the P1P2 bridge on change, but it seems as though the value isn't actually getting faked, and hence the heating is staying on permanently. Unless I'm misunderstanding how this feature is meant to work?
I don't have the thermostat plugged in, only the main controller, but even with the thermostat in, the bridge's fake temperature value wasn't being respected.
<details>
<summary>Screenshots</summary>

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

</details>

Arnold-n, 2024-10-05:
Sorry, I am not sure how this function works in the Madoka. The temperature sensor simulation was originally added to avoid an error message message on the Madoka - perhaps there is a configuration option to select a 2nd/external sensor?

Closed 2025-03-31.

Thread 84 (2023-10-22):

P1P2 Serial will not connect to Wifi

PietSmits, 2023-10-22:
Yesterday I had to reset my router and since then P1P2 Serial has lost connection. When I connect to the AP and input the credentials it does not connect anymore. I have not had this issue previously, it always reconnected without issue, even when its power was switched off/on.
After entering the credentials and saving it just opens the AP again. Unfortunately I cannot find where things go wrong.

Any suggestions to make the module connect again?

Arnold-n, 2023-10-22:
@PietSmits, this may be difficult to debug. It sounds like a poor WiFi signal, or wrong SSID or password, or a router which no longer accepts this ESP as client. You didn't change the SSID or password or other settings on your router?

The only way to debug this is to listen-in on the serial output of the ESP after you set the credentials, how to do that (with the extra ESP-01 that was included with your interface) is described in Annex 2 of your installation guide. Please let me know if you need any help with this.

PietSmits, 2023-10-23:
Thanks Arnold, although all my other ESP's connected without any issues I decided to set up the 2.4GHz bit of my router from scratch. After I did that I did see that the module connected, but lost connection again after a few minutes. I decided to leave it for the night, and lo and behold this morning all data was coming in again.
No idea what happened but it seems to have solved itself for now.
Thanks for your input, it triggered me to do the full reset.

Arnold-n, 2023-10-23:
Thanks Piet, let me know if the problem returns. One known cause for "lost connection after a few minutes" is if the MQTT connection isn't restored, but even then it should reconnect to WiFi to retry.

gmcmicken, 2023-10-23:
I had a ton of trouble with my Wi-Fi and the P1P2 esp, it would sometimes connect and other times not, or take hours. Eventually I figured it "airtime fairness" of my Wi-Fi router in advanced wireless settings needed to be turned off.

Arnold-n, 2023-10-23:
Interesting, thanks for that hint! In that case it might help to change the j-mask setting: if you change it from 13003 (default) to 3002 a lot less data is being communicated as the raw hex data and non-HA parameters are no longer communicated. This can be done with the command "J3002" via telnet or via topic P1P2/W.

gmcmicken, 2023-10-23:
> Interesting, thanks for that hint! In that case it might help to change the j-mask setting: if you change it from 13003 (default) to 3002 a lot less data is being communicated as the raw hex data and non-HA parameters are no longer communicated. This can be done with the command "J3002" via telnet or via topic P1P2/W.

The issue only manifested in a delay to connect not actually in the quality once connected... strangely! I use output mode J2 so there's not a whole lot of traffic.

Closed 2023-10-23.

Thread 85 (2023-11-10):

FXMQ-P7 Series

Enelar, 2023-11-10:
I will use this thread to organize my research process on [FXMQ-P7 series] (http://www.daikintech.co.uk/Data/VRV-Indoor/FXMQ-P/2014/FXMQ-P7VEB/FXMQ-P7VEB_Databook.pdf)

My indoor unit is FBQ60C7VEB, my outdoor unit is RXS60F2V1B.

There is an protocol dump where I pressed turn on and off button at 24:00 and 24:10
https://docs.google.com/spreadsheets/d/1w95OQW-eVxMFEjkyJB_ZmwWfgBITxUhmqZfW2W5A39E/edit?usp=sharing

It seems that protocol is different from https://github.com/budulinek/arduino-altherma-controller/blob/main/Payload-data-write.md

gmcmicken, 2023-11-10:
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

Should work fine with the existing F series FXMQ code in this library (not the altherma code)

Arnold-n, 2023-11-10:
Hi @Enelar, your bridge is flashed with the generic F-series, so you could first try with "L5" to see which 00F03x messages it triggers. If your system is indeed FXMQ-like (I had not derived that from the FBQ product code), you could flash the ATmega with the  the FXMQ code as @gmcmicken also mentions.

Arnold-n, 2023-11-10:
Hi @Enelar, your bridge was originally flashed with the Altherma (E-series) code, as I wasn't aware that you have a FBQ system and assumed you have an Altherma system. So it would be good to flash the FXMQ code on the ATmega and the F-series code on the ESP. Afterwards I would recommend to start with "L5" to see if the 00F03x messages it triggers match the FXMQ structure before trying "L1" mode.

Enelar, 2023-11-12:
Thanks a lot for your support. However I'm still experience issues. Following the guide I'm in L1 mode.
And during power on-off cycle I intercepted this packets:

```
P1P2/R/033 R 2023-11-12_02:27:53 00F03800006101180011001A001101002A00C0E4
P1P2/R/033 R 2023-11-12_02:27:54 00F03803006101180011001A001101002A00C03C
P1P2/R/033 R 2023-11-12_02:27:54 00F03801006101180011001A001101002A00C03D
P1P2/R/033 R 2023-11-12_02:27:54 00F03801006101180011001A001101002A00C03D
P1P2/R/033 R 2023-11-12_02:27:55 00F03801006101180011001A001101002A00C03D
P1P2/R/033 R 2023-11-12_02:27:55 00F03802006101180011001A001101002A00C0E5
P1P2/R/033 R 2023-11-12_02:27:55 00F03800006101180011001A001101002A00C0E4
P1P2/R/033 R 2023-11-12_02:27:55 00F03800006101180011001A001101002A00C0E4
```

Which follows this documentation perfectly: https://github.com/Arnold-n/P1P2Serial/blob/main/LogicalFormat/Daikin-protocol-FDY125LV1.md

I tried to reply this data
```
P1P2/S/033 * [ESP] To ATmega: ->F 3803006101180011001A001101002A00C0<-
P1P2/S/033 * [MON] 2023-11-12_02:34:55 wr_nr invalid, should be 0, 1, 2, 4, 6, 8 (or for packet type 0x3B: 16 or 17): 3
P1P2/S/033 * [ESP] Uptime 1400 at 20231112_02:34:59
P1P2/S/033 * [ESP] To ATmega: ->F 3801006101180011001A001101002A00C0<-
P1P2/S/033 * [MON]:w 2023-11-12_02:35:04r_val for payload byte 1 (operating-mode) must be in range 0x60-0x67
```

It seems that it does not like 03 mode (turn on), and with 01 mode it doesn't expect second byte (00).

I tried without it
```
P1P2/S/033 * [ESP] To ATmega: ->F 38036101180011001A001101002A00C0<-
P1P2/S/033 * [MON] 2023-11-12_02:35:41 wr_nr invalid, should be 0, 1, 2, 4, 6, 8 (or for packet type 0x3B: 16 or 17): 3
P1P2/S/033 * [ESP] Uptime 1450 at 20231112_02:35:49
P1P2/S/033 * [ESP] To ATmega: ->F 38016101180011001A001101002A00C0<-
P1P2/S/033 * [MON] 2023-11-12_02:35:53 Initiating write for packet-type 0x38 payload byte 1 to value 0x61
```
but with no reaction of AC.

I wasn't able to find any documentation on FXMQ series protocol so I kinda suck here
https://github.com/Arnold-n/P1P2Serial/tree/main/LogicalFormat

Enelar, 2023-11-12:
Update: success with
```
F 38 01 61
F 38 01 62
F 38 01 61
F 38 00 01
F 38 00 00
```
Now it makes sense, instead of providing whole 16 byte string I can alter only value I need to change. Very neat!

gmcmicken, 2023-11-12:
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

Sorry, I don't know where you got the impression you needed to send a manual payload, the documentation specifies the commands as you've now found them and the library packages it up into a proper payload. :-)

Arnold-n, 2023-11-12:
Great to see your system works! I'll start documenting FXMQ protocol data, as indeed that is still missing, though your system mimics FDY. I have also added a separate file with the F-series commands. If you have any full logs in L1 mode or more experiences what works or not, I'd really appreciate it (via here or DM).

Enelar, 2023-11-12:
> Sorry, I don't know where you got the impression you needed to send a manual payload, the documentation specifies the commands as you've now found them and the library packages it up into a proper payload. :-)
I couldn't find any documentation on F series... I only found mention of F command that not yet supported... So I had to improvise.

Also it was very surprising to me to learn that my AC is not Atherma 3. I thought it's like generations of their motherboards, 1990-2010, 2010-2018, 2018-present time, or something.

> If you have any full logs in L1 mode or more experiences what works or not, I'd really appreciate it (via here or DM).
Sure, I can share both, will try to gather something usefull.

Also, since byte 4 and 8 only affect FAN speed, maybe lets set possible values to 0-2, instead of calculating hex numbers with no reason. (Like F 38 04 02 -> Max fan speed, L 38 04 00 -> Min fan speed)
https://github.com/Arnold-n/P1P2Serial/blob/main/LogicalFormat/Daikin-protocol-FDY125LV1.md

Arnold-n, 2023-11-12:
I think the name Altherma is used only for air-to-water and water-to-water heat pumps (models start with an E), not for AC units (starting with an F).

I like your suggestion to use lower fan speed numbers. I will have 0/1/2 translate to 0x11/0x31/0x51, but also keep the original possibility to use values in the 0x11-0x51 range. @gmcmicken, did you draw conclusions from experiments with other values than the default ones for fan speed?

gmcmicken, 2023-11-12:
> I think the name Altherma is used only for air-to-water and water-to-water heat pumps (models start with an E), not for AC units (starting with an F).
>
> I like your suggestion to use lower fan speed numbers. I will have 0/1/2 translate to 0x11/0x31/0x51, but also keep the original possibility to use values in the 0x11-0x51 range. @gmcmicken, did you draw conclusions from experiments with other values than the default ones for fan speed?

Yes you can set one value higher than the maximum x51 but I do forget what that value was exactly, and I don't think it needs to stay in there so you can do as you like.

gmcmicken, 2023-11-12:
I think it would be helpful to update the "F Series" readme with this nomenclature document. If we use "major version" as a compatibility starting point it might clear some things up.

[F Series Nomenclature.pdf](https://github.com/Arnold-n/P1P2Serial/files/13328955/F.Series.Nomenclature.pdf)

Arnold-n, 2023-11-12:
Thanks, it seems plausible that the first letter after the heat capacity is a generation, but for generation L there are still different data protocol variations, as so far we have 3 "major protocol variations" identified:
-FDY-LV1 seems similar to 2002 FBQ-B, ADEQ-B2VEB, FBQ-C7VEB, and perhaps FBQ-B7V1 (major versions: B, C, L)
-FDYQ-MV (major version: M)
-FXMQ-PWM seems similar to FXMQ-PAVE, FDYQN-LAV1, perhaps FBA-A9 (major versions: P, L, A)

gmcmicken, 2023-11-12:
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

Interesting. Perhaps the protocol might match closer to the manufacture year, or the controller model (for example my FTQ series uses BRC1E71 and is from 2012)

gmcmicken, 2023-11-23:
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

I'm not sure why I didn't think of this earlier as my model is a two letter major version (PB, and the field settings are quite different from the PA version). I think it's the same discrepancy as L and LA.

Closed 2023-11-12.

Thread 88 (2023-11-14):

WiFi backdoor

Enelar, 2023-11-14:
This vector is highly unlikely, but still exists.
Each time device looses connection, it will reopen public hotspot.
The wifi password of this hotspot is already in databases.
If anyone would just drive by in a car, send wifi deauth beacons, it will make device expose itself.

My proposal: if the device has no wifi connection, create hotspot only after restart (physical key press)

Arnold-n, 2023-11-14:
You mean it is in databases other than github?

My concern is that the device does not only reset if the reset button is pressed, but also after a Daikin system restart (if powered via P1/P2), or when the known WiFi is no longer available to retry to connect (and if it fails, to start the AP). So how should we differentiate between reset-button-restarts and other restarts? Tasmota uses a method of repeated restarts, but this must be at the cost of flash writes, which may be a risk in some situations when the device continues to restart every 2-3 minutes.

Enelar, 2023-11-14:
Maybe if device has been restarted faster than 1 second after initial start?

Arnold-n, 2024-05-18:
@Enelar : Thanks for your suggestion, this is implemented in v0.9.46:
-the AP SSID and password can be configured by the user, and
-if the password is no longer known, a double-tap of the reset button makes an AP available with the default SSID/password. This mode is visible as the blue LED will remain be on in the 2nd case.
Not sure whether Tasmota uses flash - I doubt it, as it can be done via the RTC memory, which is what P1P2MQTT uses.

Closed 2024-06-05.

Thread 92 (2023-12-04):

Invalid heat pump power measurement?

AlbrechtL, 2023-12-04:
Thanks for this great project and hardware!

I have a strange heat pump power measurement behavior (see graph below). The orange line are the numbers directly reported from the heat pump. The blue line are the numbers read from a smart power meter. The orange line should be a little bit lower than the blue line but it is the other way around. What is really strange is that sometimes the reported orange numbers are negative. Can it be that the heat pump power measurement is wrong?

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

Firmware: 0.9.43
Daikin EHBX08DA9W

Arnold-n, 2023-12-04:
You're welcome! I think I will rename Power_Heatpump to Heat_Produced_Heatpump as the name is confusing: the orange line is actually heat produced: flow*dT*0.0697, and it is really negative during defrosts.

AlbrechtL, 2023-12-09:
Thanks for the clarification!

Axelaar, 2024-07-18:
I updated to P1P2MQTT bridge v0.9.53 and P1P2Monitor v0.9.54 from versions 9.42.  In those versions Power_Heatpump was available, as the calculated value of the heat produced.  In that older version it was positive for heating, and negative for cooling.
The topic was listed under .../M/9/...
What is the equivalent for that topic in this new version?

Arnold-n, 2024-07-19:
For answer see https://github.com/Arnold-n/P1P2MQTT/discussions/116

Closed 2023-12-09.

Thread 93 (2023-12-18):

Control outdoor unit without requiring an indoor unit?

PeteC1773, 2023-12-18:
Could this project be used to switch on an outdoor unit without the use of anything else (IE an indoor unit, control module etc)? Ideally I would be able to make the outdoor unit run and control its output (what parameters are made available to the indoor unit I don't know -  for instance maybe the indoor unit controls the EEV or maybe it just asks for a particular amount of cooling / heating - but somehow the outdoor unit can ramp up and down its compressor power, vary the EEV opening and control the reversing valve, whether under its own control or the indoor units control IDK).

Why:
I have access to free outdoor units sometimes (never with a matching indoor unit though) and I would like to hack together a water to water heat pump. I can make an open loop GSHP system as I have ground water. Buying a heat pump like this would be very expensive and I have experience with the brazing, charging etc of non inverter HVAC systems like these but since most of the units that are made available to me now through my local scrap yard are inverter, and since inverter is much better, I would like to use an inverter system to cannibalise. I would use a water heated evaporator of my own construction and an indoor underfloor heating loop driven via a plate heat exchanger - so I need to hack the original aircon unit completely to bits. Controlling the compressor myself is the sticking point though.

Thanks, Pete

Arnold-n, 2023-12-19:
Not at this moment, as at this moment the project only supports P1/P2, which is only used for the connection to the indoor unit on split systems (and to monoblocks outside).

PeteC1773, 2023-12-21:
OK thanks. Also thanks for getting back to me on that.

Kind regards
Pete

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

Closed 2024-05-18.

Thread 94 (2024-01-12):

Write parameter via MQTT unreliable

nicx, 2024-01-12:
I use the Home Assistant to set the hot water temperature several times a day depending on the electricity price. For example, I publish the value "E 35 2F 1" in the topic P1P2/W to set the hot water temperature to 30 degrees.

Unfortunately, this rarely works... Strangely enough, it sometimes works if I simply publish the same value again without resetting the P1P2 module. Most of the time, however, it only works exactly once, then not again until the module is reset.

In my MQTT Broker the value is reliably published by HA.

It seems that either the P1P2 module only sometimes reads the value (why?), or the heat pump only sometimes accepts the value from the P1P2 module (why?).

Arnold-n, 2024-01-12:
This is intentional - P1P2Monitor does not allow more than 1 parameter write per hour to avoid too much flash wear: see [README](https://github.com/Arnold-n/P1P2Serial/blob/03f53dc752166231369eb8cdedb86b0f0fb4c85f/README.md?plain=1#L149)  and [this discussion](https://github.com/Arnold-n/P1P2Serial/discussions/89).

You should see an error message on P1P2/S/# that you are out of write budget.

In a next version I will make the limit flexible but allowing more writes is "at your own risk".

nicx, 2024-01-13:
@Arnold-n hm ok, understood. but in my case Ill do writes only 4 to 8 times a day, and there is a 3 hour pause to the next write. so it should work an do not harm any budget.

is there a counter or sensor regarding the write budget? in my case for example the A8_Writes_Refused sensor is always 0.

Arnold-n, 2024-01-13:
@nicx Can you check the P1P2/W/# topic for write instructions? In your log of less than 1 hour there are really 7 parameter writes (and perhaps more failed  attempts): 2 to switch heatpump on (35:2F -> 01/01) and 5 writes to change the DHW setpoint (36:03 -> 40.0/35.0/30.0/43.0/30).

You can make the write-budget visible by adding 0x20000 to the J-mask, and restarting mqtt-discovery for HA with D3.

Writes_Refused only counts writes which are refused due to command overruns (which will be solved by buffering); perhaps another counter is useful. There is a counter "Counter_Parameter_Writes" but by default it is not output unless you add the 0x20000 mask option.

nicx, 2024-01-14:
@Arnold-n you are right, these multiple writes where my manual tests... but that is not the normal case ;) i didnt now the budget-feature before.

could you give an answer to my second question? because maybe that is my problem: i am setting the write parameter in mqtt regularly, even if ther is no change. for example the on/off setting you can see in the log, the daikin is on, i am setting the write parameter to turn on. the parameter changes max twice a day. but it is set every hour.

Arnold-n, 2024-01-14:
The module always performs a parameter write action when asked to with the 'E' command. This could be filtered but so far I did not see the need for it.

nicx, 2024-01-14:
@Arnold-n Unfortunately, I don't quite understand: what do you mean by "asked for it"?

example: i publish the value "E 35 2F 1" in the topic P1P2/W at 10:00 a.m. the same happens at 10:30 a.m., i.e. the identical value is published again. between 10 and 10:30 there is no publishing of any value.

do 2 write processes then take place? is the time of the publishing the write trigger and not, for example, a value change?

Arnold-n, 2024-01-16:
Indeed I meant that each publishing on P1P2/W, even if a duplicate of an earlier value, leads to a "parameter write" on the P1/P2 interface for the main controller; but as this is not a real change (unless there was a manul change in between) this does not lead to a real parameter change in the indoor unit. I think this can be filtered in the P1P2MQTT interface but I am not sure it will work in all circumstances. For now I would recommend to filter it at the source: in HA.

nicx, 2024-01-16:
I changed the automation in HA for now and will monitor the behaviour. Thanks so far @Arnold-n for clarifying.

Closed 2024-06-05.

Thread 95 (2024-04-03):

New HA Climate integration in 0.9.43 missing?

stomko11, 2024-04-03:
I flashed P1P2-bridge-esp8266 v0.9.43 (P1P2-ESP-Interface version) for Daikin E-series as i saw description even in earlier releases that preliminary climate controls were added. However i do see only sensors, there is no climate object yet. Is it not supported yet or do I need to do anything in addition? I was hoping for some easier controls of DHW/Heating on/off (and boost DHW to turn it on when I have extra power from PV). Thanks for info.

Closed 2024-05-18.

Thread 98 (2024-05-19):

Cannot set quiet mode on an Altherma 3 R W

Staacks, 2024-05-19:
Just installed to test the power limits in quite mode (as suggested in https://github.com/Arnold-n/P1P2MQTT/issues/69#issuecomment-2119007683), but I am not able to set the quiet mode / quiet level.

In HA I see Quiet_Level, Quiet_Level_When_On and Quiet_Mode. The latter do not reflect the actual setting of the heatpump and changing them has no effect. Quiet_Level actually changes correctly if I manually set the quiet level on the heatpump's control panel, but changing the entity does not have an effect and its value just resets to the old state.

Via telnet I can actually see that the HA entity results in an action on the P1P2bridge:
```
[MON] 2024-05-19 12:28:59 Initiating parameter write for packet-type 0x3A parameter nr 0x4D to value 0x1
[MON] 2024-05-19 12:28:59 Initiating parameter write for packet-type 0x3A parameter nr 0x4C to value 0x2
[MON] 2024-05-19 12:29:00 Executing E command for packet 0x3A setting param 0x4D to 0x1
[MON] 2024-05-19 12:29:00 Executing E command for packet 0x3A setting param 0x4C to 0x2
```
I am running an Altherma 3 R W heatpump (EHBX08EF9W) without any additional P1P2 devices (no wall panel, no thermostat, no LAN adapter etc.). (Arnold, you might remember that we were in touch via email in March.)

Also, there are a few things that surprised me about the quiet mode on my pump and I am not sure if that is normal or the reason that it is not working: I am not allowed to change the quiet mode on a user level (only with the installer code) and the quiet mode is not reflected by any field. Both are also documented in the manual (sorry, these are screenshots of the German manual, but hopefully it still illustrates what I mean).

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
The two asterisks mean "only accessible by the installer", so I am allowed to change the programming if in auto mode, but noch change the mode or level as a user.

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
This is the quiet mode level setting and the empty second column is where other settings have a field code associated with them.

Not sure if any of this is unusual or related with the problem.

Arnold-n, 2024-05-19:
German is fine for me, thanks for the information, and I do remember! Quiet level setting appears to be complicated and communication happens via different message formats (0x35 and 0x3A) and took some time to get working here. Your system is at least different in that it has a 4th "automatic" mode in 7.4.1, and that it may indeed depend on the authorization level. Perhaps the P1P2MQTT bridge must claim to be in installer level before changing quiet level, which would make things complicated.

What would be helpful is to log the 0x35 and 0x3A messages when you manually change your quiet level and when you change authorization level. This can be done by setting `J12B` or even better also log all hex data with `J13B`.

Staacks, 2024-05-19:
I was also surprised to find it represented as a single setting because in the menu it is represented as OFF, MANUAL and AUTOMATIC and you can only set three levels "LEISE", "LEISER" and "AM LEISESTEN" (German for quiet, quieter, quietest) in MANUAL mode.

In AUTOMATIC there are also menus to program times as well as an installer menu where you can set limitations for the user, so he can only set certain levels at some time intervals (these restrictions are all disabled at the moment).

Here are the logs with J13B. I recorded a few seconds each while switching from OFF to LEISE, from LEISE to LEISER, from LEISER to AM LEISESTEN and finally back from AM LEISESTEN to OFF:

[P1P2-quiet-mode-am-leisesten-to-off.log](https://github.com/Arnold-n/P1P2MQTT/files/15369391/P1P2-quiet-mode-am-leisesten-to-off.log)
[P1P2-quiet-mode-leiser-to-am-leisesten.log](https://github.com/Arnold-n/P1P2MQTT/files/15369392/P1P2-quiet-mode-leiser-to-am-leisesten.log)
[P1P2-quiet-mode-leise-to-leiser.log](https://github.com/Arnold-n/P1P2MQTT/files/15369393/P1P2-quiet-mode-leise-to-leiser.log)
[P1P2-quiet-mode-off-to-leise.log](https://github.com/Arnold-n/P1P2MQTT/files/15369394/P1P2-quiet-mode-off-to-leise.log)

Arnold-n, 2024-05-19:
Thanks, and also emailed you about this. It appears from your logs that the system does not communicate quiet settings via 0x35/0x3A packets from/to the P1P2MQTT bridge. This means that for now some or all Altherma 3 R systems (=? systems having an 'E' after the capacity number) may not support control of quiet mode and level setting, only monitoring.

forTT78, 2024-09-30:
Hi, it looks like I have a similar situation on my System:
Indoor: EHSXB08P50EF
Outdoor: ERGA06EAV3H

I can see the change in HA via telnet, but no change at all at the system.
It looks as if only the installer is allowed to make a specification and the user is not.

Thread 99 (2024-05-19):

MQTT settings lost during firmware update

Staacks, 2024-05-19:
I just updated both controllers to the latest firmwares (P1P2MQTT-bridge-v0.9.50-Daikin-E.ino.bin and P1P2Monitor-v0.9.46-Daikin-E.ino.hex via OTA, web and avrdude respectively).

After the update, the P1P2bridge tried to connect to an MQTT broker at 192.168.4.12 with default P1P2 user and password instead of the 192.168.2.x IP and the user and password I had set. The Wifi credentials were still the correct ones from before the update, so it was correctly connected to my network with a 192.168.2.x address.

This made setting new MQTT credentials via webinterface impossible (no 192.168.4.1), but I could set them via telnet, so everything is fine for me.

Note that I updated from a prerelease v0.9.45rc30 (Arnold, you sent me that one in March), so if this is only an issue with this test rc version, the issue can be closed immediately.

BTW: The documentation you sent me mentions a B command to set up MQTT via telnet. This command was not available and I used P instead.

Arnold-n, 2024-05-19:
Indeed that documentation is outdated, the B and I commands have been replaced by the more generic P command. I have tried to keep EEPROM (which includes MQTT settings) as much as possible from version to version but indeed sometimes this may have gone wrong especially for rc versions shared individually, sorry about that. And the only two options to recover from wrong MQTT settings is:
-telnet as you did, and use the commands `P7 IPv4-MQTT-server`, and if necessary also `P8 MQTT-port-nr`, `P9 MQTT-username` and `P10 MQTT-password`
-double-tap reset-button until blue LED lights up, and enter WiFi+MQTT credentials in AP (SSID/password `P1P2`/`P1P2P3P4`) via WiFiManager

Staacks, 2024-05-19:
No need to be sorry, your work is much appreciated. Just wanted to avoid others to get stranded. So, if you think it is indeed rc version specific, this can be closed.

Arnold-n, 2024-05-19:
I'll keep it open for a while for a few other rc users, and in case more people encounter it. I'll also add a few lines to the HA doc.

Thread 101 (2024-06-04):

Sensors for Power Consumption and Realtime COP not working

nicx, 2024-06-04:
Maybe it's the same problem: My sensors for Power consumption (HC_Power) and Realtime COP (HC_COP) are always 0. Power Production Sensors are working, COP-Lifetime seems also correct. What could I check to find the reason for that? :)

Arnold-n, 2024-06-04:
It's the same problem: power consumption and real-time COP calculation rely on an external electricity meter providing data via `P1P2/P/meter/U/9/Electricity_Power`. Daikin unfortunately does not provide any real-time consumption data via the P1/P2 interface. So without external input, these values remain 0.

HomeWizard meter users may use a local API and a separate ESP8266 to request data from the meter and copy it to MQTT.

nicx, 2024-06-04:
@Arnold-n ah ok. understood. so could I populate thempower value from my espaltherma to this topic and then the COP is calculated automatically? should the value be the total power of the heatpump with or withour the backup heater?

Arnold-n, 2024-06-04:
Yes, but it may be less accurate than a real external electricity meter, as the current reported by ESPAltherma has low resolution (0.2-0.3A), and does not take blind power into account.
For COP the compressor power would be needed. The code for the backup heater power input is not complete yet (and less useful).

buuhsmead, 2024-07-18:
I am updating topic 'P1P2/P/meter/U/9/Electricity_Active_Power' with current used Watts of the WP.
And the topic 'P1P2/P/P1P2MQTT/bridge0/C/9/COP_Realtime' is not updated.
Is there a time differences or other conditions that should be filled before?

buuhsmead, 2024-07-19:
@Arnold-n The value in Watts is allowed to have a decimal point or should it be an int [0-32767].
Currently, I am sending 17.1 or 18 or 18.4.

Arnold-n, 2024-07-19:
The entity provided by `P1P2/P/meter/U/9/Electricity_Active_Power` should be repeated at least once/minute. But COP_Realtime is currently only calculated for heating, and not for cooling, I will add that in the next version.

The value is rounded down (actually it just ignores any character other than [0-9]).

adam-the, 2024-09-28:
Is there any potential harm in sending the value more frequently? i.e, every second or every 15 seconds?

Arnold-n, 2024-09-29:
No harm at all, and it increases accuracy of the real-time COP reporting. The real-time COP calculation is done almost once/second and takes the most recent input values for active power and for heat production (flow * delta-T) unless power information is too old (>1 minute). Active power is not (planned to be) integrated over time; for this Electricity_Total will be used.

And as I just corrected above and in the documentation, by default it is `P1P2/P/meter/U/9/Electricity_Power`.

hdaems, 2024-09-29:
Adjusting to P1P2/P/meter/U/9/Electricity_Power the COP is calculated, both realtime and lifetime.
For me this can be closed.

Closed 2025-03-31.

Thread 102 (2024-06-04):

Heating_Only is not correct for my system.

miguelangel-nubla, 2024-06-04:
I have a EHVX08S23DJ6V7 indoor unit which definitely has cooling mode reporting `Heating_Only=1`, therefore `HC_LWT Abs_Cooling` climate entity is unavailable.

Staacks, 2024-06-04:
On my system some of the field settings are communicated if I scroll through them on the heatpump's interface. I need to enter the installer's code, then go into the "Installer settings" and the entry "Overview field settings" at the bottom. Correct parameters including the availability of cooling become available on the bridge as soon as I scroll through the pages there. Unfortunately, this needs to be done each time the bridge is restarted (a heatpump restart is no problem), but the bridge pretty much never needs to be restarted once it is working properly.

Arnold-n, 2024-06-04:
@Staacks Thanks - but actually if the WiFi and the same MQTT server is immediately available after restart and retained data can be read back, and the bridge was not powered down, only restarted, it should maintain the heating-only and cooling-capability status via the MQTT-retained messages and via the ESP8266 RTC memory. Only if the RTC memory is invalidated (power-down, AP?), or if the MQTT server retained info cannot be read back, the info will be lost. Are you also seeing a state loss if there is no change in MQTT server and no power-down?

Staacks, 2024-06-04:
Well, I think we can stop investigating at "retained messages" :) The restart after which I had to go through the procedure was the one I did to get rid of old entities in HA. For this I deleted all retained messages of the bridge on my MQTT broker.

Arnold-n, 2024-06-04:
The bridge now can delete its own (or all) retained and then rebuild its MQTT messages  (`D12` for own or `D14`for all, in HA: `MQTT_Delete_Own_Rebuild` or `MQTT_Delete_All_Rebuild`). But it also invalidates RTC memory in the process so it still loses state; upon reconsideration that is not really needed so let me remove that from a next release, then it should keep state over `D12`/`D14`.

Arnold-n, 2024-06-05:
In v0.9.53 the tank-installation and cooling-capacity are both assumed present until field setting detection is done. After this upgrade (*) a new round of field setting invitations may be necessary to update the bridge.
(*) and in some of the future upgrades if the version nr of the internal data structure increases.

miguelangel-nubla, 2024-06-05:
Tested and working as expected, thanks!

Closed 2024-06-05.

Thread 103 (2024-06-04):

hc_bridge_v_interface not handled correctly

nash1975, 2024-06-04:
This sensor is flooding my logbook in Home Assistant when the value changes (e.g from 14.7V to 14.8V)
It is somehow not handled as a numeric value but more as a string?
At least when I click on this entity no graph is showing but only the history (Verlauf)

Arnold-n, 2024-06-04:
Thanks for reporting. Which P1P2MQTT-bridge version are you running? V0.9.49 introduced a hysteresis check to reduce the flooding. Only changes of at least 0.2V should be reported now.
I'll make the entity a true "voltage" one in the next release so a graph can be made.

Arnold-n, 2024-06-05:
In v0.9.53 it is formatted as a voltage. Only the icon is still missing, I didn't yet look for a nice mdi image.

Thread 104 (2024-06-04):

sensor.hc_mode_date_time_daikin is flooding my logbook with every second update

nash1975, 2024-06-04:
This sensor is reflecting the date and time of the heatpump.
It is changing every second and by this flooding the history

Arnold-n, 2024-06-04:
There are so many history changes, so I wonder which ones we should limit, and which not? I like to have the correct time visible on a dashboard and do not use history. For the longer term I'd like to make everything configurable using config-files on the ESP, for now I wonder if this justifies a lower update frequency, or alternatively making an option to have the entity disappear?

nash1975, 2024-06-05:
For me ignoring the seconds of the date time and updating on minute change would be the sweet spot.
For my setup I deactivated the entity completely as I have no real need of it.

Arnold-n, 2024-06-05:
In v0.9.53 a parameter 48 is added to remove reporting of seconds in the time format. Commands required to use this are `P48 1` followed by `D5`.

WTH70, 2024-10-03:
You could add this to your configuration.yaml file:

logbook:
  exclude:
    entities:
      - sensor.hc_mode_date_time_daikin

nash1975, 2024-10-05:
Thanks, I will try.
I was not aware of this exclude option for the logbook.
I can use also for another entity.

Thread 105 (2024-06-04):

DHW climate entity missing current DWH temperature.

miguelangel-nubla, 2024-06-04:
Entity `climate.hc_dhw_dhw_setpoint` should include the current temp from sensor `sensor.hc_dhw_temperature_r5t_dhw_tank`.

Arnold-n, 2024-06-04:
Indeed, this is very much related to [tank/cooling detection](https://github.com/Arnold-n/P1P2MQTT/issues/102). The current temp is only available for systems with a tank, but the tank is not recognized until the related field setting is seen. Next release will have as a default setting that a tank is available unless a field setting indicates there is no tank.

Arnold-n, 2024-06-05:
In v0.9.53 tank is assumed to be present, which should show R5T, until a field setting is received. On my tank-less system R5T will show -40C.

Closed 2024-06-05.

Thread 106 (2024-06-05):

Combining LWT heating and cooling entities.

miguelangel-nubla, 2024-06-05:
Right now, with the system set to cooling, both thermostats show as "on", heating and cooling.

Could it be possible to mix `HC_LWT Abs_Cooling` and `HC_LWT Abs_Heating` into a single entity?
Mode command could link to `HC_Mode Heating_Cooling_Auto`, and current status (for reporting) can be read from `HC_Mode Climate_Cooling` and `HC_Mode Climate_Heating` entities which work as expected for `cooling`, `heating`, and `auto` modes.

Arnold-n, 2024-06-06:
This applies to E-systems: I tried hard to make this one entity, but it did not work nicely - for example HA would not select the right color for heating and cooling. Also, the Daikin system really has separate settings and feedback for cooling and for heating.  So I decided to only rewrite the climate entities (when heating/cooling mode changes) to add and remove the "on" button but not the "off" button for climate entities in E systems depending on heating/cooling mode, and make the "on" visualization depending on whether the climate entity is really active or not. This gives you the option to also control the cooling setpoint in heating mode . This works only after adding climate entities to your dashboard and then setting switch `HA_Setup` to `off` in `HC_Setup` folllowed by `EEPROM_ESP_Save_Changes` in `HC_Bridge`. Could this switch still be on in your system?

miguelangel-nubla, 2024-06-07:
Ok that makes sense, different setpoints for heating and cooling is not supported by HA yet.
I don't understand the `HA_Setup` thing, reading the docs:
>Enables proper initial set-up of HA dashboards (or otherwise controls may be incomplete)
What does it do exactly and why it is needed?

Arnold-n, 2024-06-07:
This is at the moment needed only for Daikin E series, but may become necessary for Daikin F series later too. It ensures that more functionality is available (all climate entities, including on/off buttons), some of which is later (temporarily) removed depending on system status: in heating mode the "on" button disappears in the cooling climate entity.

miguelangel-nubla, 2024-06-07:
> in heating mode the "on" button disappears in the cooling climate entity.

That sounds reasonable.

-----------------

Excuse my insistence but I really don't get the point of HA_Setup, especially the description "proper initial set-up of HA dashboards". I believe I will not be the only one confused about it.

Maybe I'm missing something but turning other entities unavailable does not fit HA architecture IMO.
You can always disable entities you don't want to touch, or simply not add them to a dashboard.

Arnold-n, 2024-06-08:
This relates to the three subdevices HC_Room, HC_LWT, and HC_LWT2. If you add for example the HC_LWT (sub)device to one of the dashboards manually, this will add 2 climate entities, one for cooling and one for heating. If you would do this in regular mode, for example in heating mode, the active heating entity will get 2 buttons: `heating` and `off`, and the not-active cooling entity will get 1 button, `off` - which will then not become visible in HA. If the system switches to cooling mode, the cooling entity configuration will be redefined to have `cooling` and `off` buttons, but they will not become visible, while the heating entity configuration will be redefined to have only the `off` button, and the system can no longer be switched on or off. There is no way to make the `cooling` button inactive in heating mode, which I think would be a better solution.

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

 If you do this in `HA_Setup` mode as intended, cooling will (temporarily) get 2 buttons, `cooling` and `off`, and both entities will get a button bar. When `HA_Setup` is switched off, the intended behaviour occurs that only the active mode gets a button to switch it on.

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

Overall I would have preferred the old way (<HA2023.02) where the operating mode and the on/off state were separate button bars, but [this discussion](https://github.com/home-assistant/core/issues/85187#issuecomment-1396876054) makes clear that separate button bars will not be re-introduced (and hiding things in "more info" would be even worse).

As for making entities unavailable, there are several reasons why I do this:
-Control entities: are not available when the bridge `Control_Function` is off,
-kWh/start counters are made unavailable when `Counter_Request_Function` is off as these counters are not updated then,
-HC_Room climate entities and `RT_Modulation`/`RT_Modulation_Max`: when in LWT control mode, these cannot be used and are thus made unavailable,
-Cooling related entities are not available for systems without cooling capacity,
-Additional zone related entities are not available if the system operates in single-zone mode,
-several more 'risky' buttons during `HA_Setup` phase are made unavailable afterwards, and `MQTT_Rebuild` is not available during MQTT throttling in first 2 minutes after a bridge restart, and
-the `Daikin_Restart_Careful` button is not available if the Altherma is currently heating or cooling, i.e. if `Altherma_On` is on (this may not really be needed as the Daikin interface allows a restart during operation).

To me making entities unavailable is the same as disabling them; why do you think it does not fit the HA architecture? Would you know a better way?

miguelangel-nubla, 2024-06-08:
Thanks for the detailed explanation.

Bear with me as I hope you understand this conversation is not an attack, but a honest attempt at improving P1P2MQTT and ease its usage and development.

### Devices
First off regarding this:
> If you add for example the HC_LWT (sub)device to one of the dashboards manually, this will add 2 climate entities.

Why would you add a whole device to a dashboard?
Are you aware you can include the cards you like, referencing the entities you need manually?
The device thing in HA is mainly to hierarchically organize devices, which the current implementation with many `HC_*` devices does not make much sense in my opinion.

### Climate entity
Regarding the climate entity, I understand what you are trying to achieve and the fact that the current HA implementation for climate entities does not cover the use case here.

My issue is that the default lovelace climate card(UI) or current implementation in HA side should not warrant destroying the "Model-View-Controller" separation in home assistant.
That would invalidate the whole point of HA, the expandability and cross-compatibility.

> the not-active cooling entity will get 1 button, `off` - which will then not become visible in HA.

> cooling will (temporarily) get 2 buttons, cooling and off, and both entities will get a button bar.

> Overall I would have preferred the old way (<HA2023.02) where the operating mode and the on/off state were separate button bars, and a single climate entity might be used, but https://github.com/home-assistant/core/issues/85187#issuecomment-1396876054 makes clear that separate button bars will not be re-introduced

Then what about users using other lovelace climate cards (such as [mushroom](https://github.com/piitaya/lovelace-mushroom/blob/main/docs/cards/climate.md) or [many others](https://smarthomescene.com/blog/top-8-home-assistant-thermostat-cards/))?
What about when the climate entity is exposed to Google Home or Alexa?
The presentation there will be diferent.
Would issues with the presentation there warrant a climate entity *hack* to make them behave as we would like to, breaking the specification?
I think not, the specification is what enables the expandability of HA, hence the separation between the climate entity and the desired presentation (lovelace card).
And the issues with the presentation and control are to be expected *everywhere*, since a climate entity represents the idea of a zone thermostat, which the Altherma is not.

The root of the problem is that climate entities where never intended for this use case, they are supposed to be used as thermostats, which in this case would be used to control/represent individual rooms/zones (and the corresponding valves controlling them).

I don't want to say to not use a climate entity, but strictly speaking it should not be as it will lead to issues with whatever interacts with it (as we have seen with the core [Thermostat card](https://www.home-assistant.io/dashboards/thermostat/)).

In same sense, this leads me to the `HA_Setup` switch, which is the workaround to a workaround:
> When HA_Setup is switched off, the intended behaviour occurs that only the active mode gets a button to switch it on, and that only one of these 2 climate entities is active when Altherma_On is switched on

Worst case scenario that should be the only behaviour.

### My take
How I would do it:
As stated before the current device thing does not make sense.
Devices:
 1. The bridge, with entities:
     - All the entities relevant to the bridge only such as restart, wifi signal, enable control switch, write eeprom etc. All them available all the time **unless** they actually can't be used or are not available. Read bellow I expand on unavailable vs disabled.
     - All of them organized in [diagnostic](https://developers.home-assistant.io/docs/core/entity/#generic-properties), config or default categories.
 2. The heat pump, with entities:
     - All field settings with `entity_category` set as `diagnostic`.
     - Every value that can be modified such as `sensor.hc_lwt_abs_heating` should be a `number` instead with `entity_category` set as config.
     - Every other display only sensor set without `entity_category`.
     - A climate entity meeting the spec, meaning showing modes from `select.hc_mode_heating_cooling_auto`, target temp corresponding setpoint (`sensor.hc_lwt_abs_cooling` or `sensor.hc_lwt_abs_heating`), etc.

All of these entities should have reliable naming for `entity_id` and `unique_id`, simplest that comes to mind: `[domain].[configurable-prefix]_[groups]_[name]`.

- `sensor.hc_lwt_abs_cooling` as `number.myaltherma_climate_lwt_abs_cooling_setpoint` for:
[domain]: number
[configurable-prefix]: myaltherma
[group]: climate
[subgroup]: lwt
[subgroup]: abs mode
[name]: cooling_setpoint
- `select.hc_mode_heating_cooling_auto` as `select.myaltherma_climate_mode` for:
[domain]: select
[configurable-prefix]: myaltherma
[group]: climate
[name]: mode

Doing it that way is generally more expandable, and specifically:
- You have control over any setting at any given time, such as cooling and heating setpoints regardless of climate mode.
- You can display specific sensors or controls of interest to you, for example using [`auto-entities`](https://github.com/thomasloven/lovelace-auto-entities):
```
type: custom:auto-entities
card:
  type: entities
  title: Altherma
  show_header_toggle: false
filter:
  include:
    - entity_id: sensor.myaltherma_climate_.*
sort:
  method: name
```
- You can present your entities and configure your cards as you see fit for your model and use case and distribute them across your dashboard as needed.
- You have a climate entity that does match the spec in case you want to interact with it in unexpected ways, such as exposing it to Assist.

When the entities match the spec and the base data is organized, then and only then we should worry about presentation. If the current HA thermostat card is not a good fit I am sure it can be solved with some custom card.[ Link to example custom climate card.](https://community.home-assistant.io/t/mushroom-cards-build-a-beautiful-dashboard-easily-part-1/388590/1183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)

### Unavailable vs disabled
Generally speaking entities are supposed to become `unknown` when it does not have a valid state (such as not yet read) and `unavailable` when they don't have a valid value (due to network error, timeout, controller offline, etc).
As such, [many users](https://community.home-assistant.io/t/unavailable-unknown-entity-monitoring-template-sensor/147618/24?page=18) including myself actively monitor and have notifications specifically looking for unavailable or unknown entities.

Disabled on the other hand "forgets" about the entity. It is a clear instruction to not process/record changes which reduces the load and to everything else to ignore it.

A unknown or unavailable entity requires my attention. A disabled one does not, but I have the option to enable it and track/use it anytime when needed.

Therefore these use cases look fine to me:
>-Control entities: are not available when the bridge Control_Function is off,
-kWh/start counters are made unavailable when Counter_Request_Function is off as these counters are not updated then,
-HC_Room climate entities and RT_Modulation/RT_Modulation_Max: when in LWT control mode, these cannot be used and are thus made unavailable,
-Cooling related entities are not available for systems without cooling capacity,
-Additional zone related entities are not available if the system operates in single-zone mode,

This should be unavailable only those first two minutes:
>-several more 'risky' buttons during HA_Setup phase are made unavailable afterwards, and MQTT_Rebuild is not available during MQTT throttling in first 2 minutes after a bridge restart, and

And in my opinion this should never be unavailable, but disabled manually in any case:
>-the Daikin_Restart_Careful button is not available if the Altherma is currently heating or cooling, i.e. if Altherma_On is on (this may not really be needed as the Daikin interface allows a restart during operation).

Arnold-n, 2024-06-08:
Many thanks for your detailed feedback and suggestions. I really appreciate it - it's definitely not an attack. I am relatively new to HA, and have tried to make using the bridge with HA as easy as possible, without having to know much on how to configure everything in HA.

Before responding in detail, I'd like to better understand what you are saying, being a relative HA novice:

>     * You have a climate entity that does match the spec in case you want to interact with it in unexpected ways, such as exposing it to Assist.

Which "specification" are you referring to? I am primarily using the documentation at www.home-assistant.io, but it's not really a specification prescribing how things must be done, only how things can be done.

> ### Unavailable vs disabled
> Generally speaking entities are supposed to become `unknown` when it does not have a valid state (such as not yet read) and `unavailable` when they don't have a valid value [..]
> Disabled on the other hand "forgets" about the entity. It is a clear instruction to not process/record changes which reduces the load and to everything else to ignore it.

How do you disable an entity? Via MQTT discovery an entity can only be made unavailable with the `availability` option or can be deleted by deleting the config message, but I would not know how to disable an entity via MTT.

> > When HA_Setup is switched off, the intended behaviour occurs that only the active mode gets a button to switch it on, and that only one of these 2 climate entities is active when Altherma_On is switched on
>
> Worst case scenario that should be the only behaviour.

Sorry, I do not grasp what you are saying here, can you please explain?

miguelangel-nubla, 2024-06-08:
> Which "specification" are you referring to? I am primarily using the documentation at [www.home-assistant.io](http://www.home-assistant.io), but it's not really a specification prescribing how things must be done, only how things can be done.

Yes, that is a good point. The most formal specification you are going to find is at https://developers.home-assistant.io/docs/core/entity/climate/, and usage at https://www.home-assistant.io/integrations/climate/ but it is constantly expanded and improved. I can see why it can be confusing to new users. Once you are a regular HA user you get the "idea" behind it and everything makes more sense.

In that particular instance I meant:
- I haven't seen anywhere that changing the modes available is out of the official "spec", but I assure you developers will mostly take for granted that not to be the case.
- The original climate entity you described might only had a [`HVACMode.OFF`](https://developers.home-assistant.io/docs/core/entity/climate/#hvac-modes) mode, which again, as far as I know is technically nowhere forbidden, but informally it is. It does not make sense for such an entity to exist.

As I write this I see the confusion so let me try to change the reasoning route in hope of explaining myself better:

Everything in HA is a entity, a value, a button, a automation... it is the base element on which to expand.
There are very basic entities denoted by its domain, such as `sensor`, which is a readonly value, `number` which is like a readwrite integer, `switch` which represent a relay etc.
All the entities are independent, and HA uses devices to logically group them.
You can represent almost all the data for the Altherma with those. Setpoints as `number.setpoint_cooling`, `number.setpoint_heating`, climate enabled as `switch.climate_running`, current temp as `sensor.current_temp` etc and that would be perfectly fine.
However some patterns repeat very commonly, such as thermostats having all current temp, target and on/off switch, so the `climate` domain is created to ease that task. Now instead of 3 entities those can be represented with one. It is a "higher order" entity. Other parts of HA can expect climate entity to have those 3 properties and to develop around that.
In my example I mentioned Assist, so in this case I can ask Assist to tell me current temp. Assist knows what I am asking and knows what to give me.
Now imagine P1P2MQTT comes and creates a climate entity without current temp. Assist dead. It negates the benefit achieved by exposing a `climate`. I might as well ask assist directly about the simpler entities.
It is obviously exaggerated but you see where I am going with this?

There is no reason to go the hacky climate entity in this case, just using "simpler" entities would enable all functionality, and having those right enables power users to combine them and do their own advanced entities using templates by themselves.

> How do you disable an entity?

That is expected of the user. Via the UI, click on an entity, then gear icon->enabled. It is not on MQTT discovery on purpose, only the user should control that. The integration must send state to MQTT anyway for if and when HA (the user) wants to know about it again.

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

I mean that, as described earlier in this same reply, at the very least the  available properties/behaviour of the entity should at least be stable. Only having OFF as a mode is hacky, but additionally being in that state ***on purpose and sometimes*** is way worse from a compatibility perspective.

miguelangel-nubla, 2024-06-08:
> > When HA_Setup is switched off, the intended behaviour occurs that only the active mode gets a button to switch it on, and that only one of these 2 climate entities is active when Altherma_On is switched on
>
> Worst case scenario that should be the only behaviour.

I messed up here I should have written:
Worst case scenario should be that both climates have both ON and OFF, which is confusing but at least gives you total control **and** "entity stability" at the expense of one of the climates reporting ON incorrectly.

Thread 108 (2024-06-29):

Auxiliary mode disabled after reboot

fuecy, 2024-06-29:
Hi Arnold

Iam not sure if i do something wrong. I have put my controller in auxiliary mode using telnet L1 and it works awesome. The documentation says (L state info maintained in EEPROM) however when shutdown the power or the wifi connection is lost (and i guess it  reboots), the auxiliary mode is off again. So i would expect the auxiliary mode stays enabled after reboot or is it intended otherwise

P1P2/S/018 * [ESP] P1P2-bridge-esp8266 v0.9.42
P1P2/S/018 * [ESP] Compiled Sep 29 2023 08:53:51
P1P2/S/018 * [ESP] E-Series
P1P2/S/018 * [ESP] ESP_hw_identifier 1
P1P2/S/018 * [ESP] Connected to MQTT server
P1P2/S/018 * [ESP] MQTT Clientname = P1P2_018
P1P2/S/018 * [ESP] MQTT User = P1P2
P1P2/S/018 * [ESP] MQTT Server = 192.168.xx.xx
P1P2/S/018 * [ESP] MQTT Port = 1883
P1P2/S/018 * [ESP] ESP reboot reason = 0xFF
P1P2/S/018 * [ESP] outputMode = 0x3002
P1P2/S/018 * [ESP] outputFilter = 1
P1P2/S/018 * [ESP] mqttInputByte4 = 0
P1P2/S/018 * [ESP] EEPROM version = 0
P1P2/S/018 * [ESP] To ATmega: ->V<-
P1P2/S/018 * [MON] 2024-06-29_23:19:44 Verbose 3
P1P2/S/018 * [MON] 2024-06-29_23:19:44 P1P2Monitor-v0.9.42
P1P2/S/018 * [MON] 2024-06-29_23:19:44 Compiled Sep 27 2023 12:49:03 +control NEWP1P2LIB E-series
P1P2/S/018 * [MON] 2024-06-29_23:19:44 Reset cause: MCUSR=5 (brown-out-detected)  (power-on-reset)
P1P2/S/018 * [MON] 2024-06-29_23:19:44 P1P2-ESP-interface ATmegaHwID v1.2
P1P2/S/018 * [MON] 2024-06-29_23:19:44 Control_ID=0xF0
P1P2/S/018 * [MON] 2024-06-29_23:19:44 CONTROL_ID_DEFAULT=0x0
P1P2/S/018 * [MON] 2024-06-29_23:19:44 Counterrepeatingrequest=0
P1P2/S/018 * [MON] 2024-06-29_23:19:44 F030DELAY=100
P1P2/S/018 * [MON] 2024-06-29_23:19:44 F03XDELAY=30
P1P2/S/018 * [MON] 2024-06-29_23:19:44 Verbosity=3
P1P2/S/018 * [MON] 2024-06-29_23:19:44 CPU_SPEED=8000000
P1P2/S/018 * [MON] 2024-06-29_23:19:44 SERIALSPEED=250000

Arnold-n, 2024-06-29:
Hi @fuecy,

The line with Control_ID=0xF0 indicates that the EEPROM still has 'L1' mode actively stored, so it should try to restart auxiliary control mode after a reboot. Assuming the bridge receives data from P1/P2, it should report after ca 6 seconds report "* No auxiliary controller answering to address 0xF0 detected, control functionality will restart". Do you see that message, or do you seen any other message?

If you see no message at all, can you set output mode temporarily to show hex packet data (add 0x0010 to J-mask for output via telnet or 0x0001 for output via MQTT), and see if there is proper data being received, including any 00F030* message without 40F030* reply?

Arnold-n, 2024-06-29:
For testing purposes, it can be useful to reset the ATmega manually with the `A` command (your telnet session will survive the restart of the ATmega as the ESP is not restarted).

fuecy, 2024-06-30:
Hi Arnold
The above output was after i enabled the auxiliary again. The controll id was 0x00. It happened to me twice, hence i made the ticket but now i am not able to reproduce. I have to do some longer testing as it happened when the wifi was down for some time. Normal power reboot seems to work fine.

Arnold-n, 2024-06-30:
Hi @fuecy,
It would not hurt to update to newer firmware, there were some issues in earlier versions in case of network issues.

If Control_ID is reset to 0x00 it is likely that the auxiliary control mode was switched off due to detection of multiple errors - a safety feature.

fuecy, 2024-07-03:
I think you can close the issue. Is this safety feature documented somewhere?, maybe i missed it.
Due to a lose wire in the RJ45 connector to the closes accesspoint and together with the fact that i push my configuration dynamicy to my accesspoint it resulted in unexpected behaviour of the wifi which resulted mainly my head pump to get into an error state. I think that would have triggered the safety feature and fall back on read-only mode. I dont think it was the wifi of the p1p2mqtt device that had issues with it.

Arnold-n, 2024-07-03:
Thanks for your feedback. It is not really documented although it is now touched upon in [P1P2Monitor command documentation](https://github.com/Arnold-n/P1P2MQTT/blob/main/doc/P1P2Monitor-commands.md) that auxiliary control mode and counter request mode will be switched of in case of too many bus collissions (and, in fact, in case of other errors too).

Closed 2024-07-03.

Thread 109 (2024-06-30):

Some action not taken into account in HA

Tmbao, 2024-06-30:
Hi Arnold, I've got an issue that if multiple commands are sent to the bridge at almost the same time (they're all triggered via a HA automation), one of the command isn't effective. In the example below, I've got 2nd, 3rd and 5th which all update the controller state. Without the 5 second delay (4th action), the 5th seems to be ignored.

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

I think in one of the recent changes, some command buffering was added. Wondering if this is due to some race condition?

Arnold-n, 2024-06-30:
Hi Bao, my mistake, the release notes for v0.9.53 indeed included a message that buffering was added, but that change was moved to a later release. It is currently under test. I  will send you the test version by e-mail.

nicx, 2024-10-11:
@Arnold-n could you send me the test version as well? I have the same problem... as a workaround I configured some Wait-Timers in the automation. But this is not reliable.

Arnold-n, 2024-10-12:
Bao received the F-series test version. I am working on the E-series version and will send it to you later.

Thread 111 (2024-07-12):

Entity climate.hc_LWT Abs_Cooling and climate.hc_LWT Absnot available

MasterRubke, 2024-07-12:
The entity for setting the leaving water temperature is not available.
The only climate entity's available are for deviation.

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

Arnold-n, 2024-07-15:
This is  intentional, at least in the current version (subject to discussion on reconfiguration of climate entities). You cannot set LWT yourself if your system operates in weather-dependent mode, only the deviation of LWT as calculated by the WD curve. The Deviation_* climate entities will be reconfigured to LWT_* climate entities if you switch your system from WD mode to ABS mode (which can be done from HA).

Staacks, 2024-07-15:
Not sure if this is the case for @MasterRubke, but I noticed an edge case that might add to the confusion:
On my heatpump one does not set WD and ABS mode globally, but WD/ABS is set independently for heating and cooling.

In my case it was set to WD for heating and ABS for cooling by default (or the installer). The bridge showed the WD setting of heating and disabled the ABS controls for cooling with the result that the heating controls were fine, but I could only control relative temperature of cooling which had no effect as the heatpump was using the absolute setting.

Arnold-n, 2024-07-16:
Thanks, that might explain it. In that case we would need to search for the bits and bytes that report and control WD/ABS mode in cooling mode; I will add some monitoring code to P1P2MQTT-bridge later this week, perhaps this evening, to support this search.

MasterRubke, 2024-07-16:
Putting the system in ABS-mode solved the problem. I can now set the LWT temperature.

Staacks comment is partially true for me. I can not set the heating and cooling modes separate.
Instead my system has 3 operating modes:
1: ABS
2: WD for heating / ABS for cooling
3: WD
So for me it would be the same entity, only adding a third option "WD/ABS"

Is there a way where i can check the value of the paramter? I think over TELNET but i don't know the command yet.
I am new to this matter. :)

Staacks, 2024-07-16:
Oh, sorry, you are right, it is also not entirely independent for me:
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

Thread 113 (2024-07-15):

Room temperature is always 25.6°C - F1 xxx has no effect

DiabloVmax1200, 2024-07-15:
Hi I tried this option today with the v0.9.53 two things I mentioned.

At my Daikin Altherma 3 GEO - (EGSAX06DA9W) the Room temperature is always 25.6°C. I can't change the value to a different one. This value is shown in MQTT and on the display.

Can I do anything to help debugging?

`[MON] 2024-07-15 01:39:16 Room Temperature insertion function switched on, temp  is 20.00
F1 205
[MON] 2024-07-15 01:40:13 Room Temperature insertion function switched on, temp set to 20.50
F1 190
[MON] 2024-07-15 01:40:43 Room Temperature insertion function switched on, temp set to 19.00
F1 000
[MON] 2024-07-15 01:46:12 Room Temperature insertion function switched on, temp set to 0.00
F1
[MON] 2024-07-15 01:46:24 Room Temperature insertion function switched on, temp  is 0.00
F0
[MON] 2024-07-15 01:46:38 Room Temperature insertion function switched off
F1 205
[MON] 2024-07-15 01:47:29 Room Temperature insertion function switched on, temp set to 20.50
F1 230
[MON] 2024-07-15 01:48:54 Room Temperature insertion function switched on, temp set to 23.00`

But no effect
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

DiabloVmax1200, 2024-07-15:
Is fixed with Version Firmware_images/P1P2Monitor-v0.9.54-Eseries-P1P2MQTT-bridge.ino.hex

DiabloVmax1200, 2024-07-15:
Is fixed with Version Firmware_images/P1P2Monitor-v0.9.54-Eseries-P1P2MQTT-bridge.ino.hex

Closed 2024-07-15.

Thread 117 (2024-07-21):

Telnet session not possible after several days, non-heating mode

buuhsmead, 2024-07-21:
I normally use the telnet session to send commands. After two days in mode 'E35002F00' and not using telnet I am not able to reconnect with a telnet session.
The only option I have is to write a mode change from LWT to RT-ext/RT onto 'P1P2/W/P1P2MQTT/bridge'.
And because of that, the MMI is resetting the system and dropping the power on P1P2 lines.
The system gets a reboot.
After that, it works again.

Can I do something else to get a telnet session.
I tried to write 'K' to 'P1P2/W/P1P2MQTT/bridge', but that did not work.

Arnold-n, 2024-07-21:
The bridge allows only 1 telnet session at any point in time. A 2nd connection will fail if the first is still active, but will drop the 1st too, and the next telnet attempt should work again. Could this behaviour explain your observations?

As you have only 1 bridge, it is easier to write `K` to P1P2/W (easier). The correct full topic is P1P2/W/P1P2MQTT/bridge0, with a 0 at the end. But 'K' resets the ATmega, which does not help to restore telnet. If you write `D0` instead of `K` you will reset the ESP which should re-enable telnet if telnet would not work.

buuhsmead, 2024-07-23:
Update:
Again 24-36 hours not connected to telnet, and not sure if cleanly stop the telnet session. A telnet session was not possible. But I will try to test a little more and cleanly stop the telnet session. And get back with an update.

What did help was writing 'D0' to 'P1P2/W/P1P2MQTT/bridge0'. I was able to get a telnet session.
So that part is solved, thanks Arnold.

Arnold-n, 2024-07-23:
I currently use v2.1 of the ESP Telnet library, I'll try to upgrade to 2.2.1 to see if that solves your issue.

buuhsmead, 2024-07-24:
I made sure that I correctly closed the telnet session. Currently, no hick-ups getting connected.
Think it is just PEBKAC.

Closing this for now. If needed, will re-open it.
Thanks for your support, Arnold.

Closed 2024-07-24.

Thread 122 (2024-08-01):

Heating shows Enabled when system is off, and dual states

matthijsberg, 2024-08-01:
Hi,

I'm looking at  HC_Mode Climate_Heating (or Cooling or Auto) in a E series HP. When I enable this (as in enabled, not actually active / running / heating) state, like heating, in the app, this gets reflected in the system, however there are two situations I'd like to run by you for discussion;

1. There are 3 states that are unique (heat / cool / auto). When I enable auto, the last other active state is also still active in HASS (example, Heat was active, when I select Auto, Heat remains active, but Cool does not become active). I would expect ONLY auto to be active, not heat and / or cool.
2. When a state is active (let's say heat) and I disable the complete heatpump (the "power" button in my app, basically disabling all heating / cooling) the active state remains the last known state. I would expect it to disable all states as the complete system is off. (DHW is seperate from this by the way).

Would it make sense to build this logic in?

thnx, Matthijs

Arnold-n, 2024-08-01:
Hi Matthijs,

Climate_Heating/Cooling is the information directly provided by the Daikin indoor unit. It reports in which mode the system is, even if off. If you select heat/cool  mode, this should be reflected, but in auto mode, the system will select heating/cooling based on outside temperature, taking a hysteresis into account. To me it makes sense that these can be active even if the system is off, similar to the fact that the system can be on even if the compressor if off (during start-up, or due to LWT overshoot or due to a too-high (in heating) or too-low (in cooling) return water temperature).

If you want a radio-button type behaviour, it is provided in the `Heating_Cooling_Auto` select entity itself.

matthijsberg, 2024-08-02:
Thanks, makes sense.

Just a FYI, when selecting auto, coming from heat / cool, that last state remains on too in my experience so far. This does not seem to be an informed decision by the system.

Closed 2024-08-02.

Thread 123 (2024-08-10):

Hitachi H-link2 - support for writing to the P1P2 bus

user890104, 2024-08-10:
We have a Hitachi H-link2 system installed at our office. There is a P1P2MQTT bridge made by Arnold that we installed and we can see the raw packets going back and forth. But we are unable to control the units, since writing to the bus is not implemented.

We also have a spare remote control, but unsure if it can be of any use for debugging/reversing the protocol needed for write support on the bus.

This is our reverse-engineering effort so far, based on raw packet sniffing, and chaning the system to run in various modes:
https://docs.google.com/spreadsheets/d/13hszgDAdVjzlA0g9ORPiE48NfMgoU1kxcpj9PWbSJ1w/edit

Please let me know if anything else is needed so that writing to the bus e.g. for replaying command from the remote, can be achieved.

Arnold-n, 2024-08-11:
Hi Vencislav,
Many thanks for your support in reverse engineering this - I am very busy in August but will pick up Hitachi support in September again.
For other Hitachi users: please upgrade to at least v0.9.51 which contains some decoding based on Vencislav's analysis.
Kind regards,
Arnold

user890104, 2024-10-02:
Hi, just a kind reminder on this. As I said previously, we are open to help understanding the protocol, including hooking up a logic analyzer to the bus and/or sniffing the raw data from the original remote. We don't have access to the central management software, just to our office's units and wall remote control panel, and this is why we need remote access to configure the HVAC system.

linhpd88, 2025-05-16:
@user890104 what is the progress of this, can you share something?

daniyo27, 2025-07-31:
Hi @Arnold-n !
Is there any progress on writing to the P1P2 bus? I have a Hitachi system and would really love to get some sort of WiFi control on it.

I bought a chinese thermostat Acmelec, and it seemed to do basic functions such as heating, cooling, dry, and fan, but the fan control did not support auto mode nor the fourth fan setting which is the highest.

If I can be of assistance somehow, I would love to help out.

Arnold-n, 2025-08-03:
We know that sending commands to the indoor unit works but, not fully reliably, but we do not know how bus arbitration works to avoid bus collission. It would be really nice to understand how writes should be timed on the bus.

remynicol, 2025-08-22:
No, I didn’t need an oscilloscope — the low-level part of reading the Hitachi bus was already very well implemented.
In particular, the handling of double bits (UC errors) and parity bit errors (PE).
The only missing piece was the emulation of a remote control in order to “drive” the physical remote (the messages with header `0x41`).

Displaying the PE errors (by changing the *E* mask) allowed me to see that my Hitachi heat pump correctly sends all parity bits, whereas my remote controls systematically invert the parity bit of the first byte.

And if we want to emulate a remote control, we need to reproduce this behavior, otherwise the heat pump ignores the message.

That’s the lowest-level work I had to do — but using the P1P2MQTT hardware, so.

linhpd88, 2025-08-25:
> I believe this message is how a new remote control obtains its addressing on the bus. It sends this special packet when it connects for the first time. The main remote then replies with a packet where the data field contains the remote ID that the new RC should use. In other words, the main remote assigns the ID to the newcomer.

You beleave is not a proof, that why I ask about data capture from the bus, and to act like a sub controler, your code is not finish. To make it act as Sub, you must remove 1 RC and simulate like the other, you have PC-ARFP1E (2020) + PC-ARFG2-E (2024), now you need to keep 1, example PC-ARFP1E (2020) set as Main RC, then code the firmware to make the p1p2mqtt act like the PC-ARFG2-E (as Sub RC).

linhpd88, 2025-08-26:
> Exactly what I did. I have only one remote and the p1p2. Again tonight, I was able to turn on the air conditioning remotely. Let me know if you have any difficulties testing it.

I have the York one, and your code not working with it, So I try to understand the code to adapt it with try/fail. But there are some place I do not understand it, that why I ask. You can point me some importance place of your current PR? I do not care abour decode data for HA, just the part to make p1p2mqtt as secondary remote.

linhpd88, 2025-08-29:
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

It only have:
21 00 1A, 21 00 30, 21 00 1B and 21 1f 0a, there is no 89 00 2D data or it failed to decode, Can you tell me your email?

Thread 127 (2024-09-12):

Link Between outside and inside units

x3oo, 2024-09-12:
Hi does anybody know if the link between the outside and inside units use the same protocoll? Usually many ACs only use one wire for communication between those.

Arnold-n, 2024-09-15:
Some AC units use 2-wire F1/F2 which is electrically the same as P1/P2, but logically different. And F1/F2 may not provide bus power.

Other units use a one-wire protocol, this may be unsafe to touch, and which is definitely different from P1/P2.

x3oo, 2024-09-16:
For context:
Many ACs are well capable of heating up your water based heating system, if only you could attach a heat exchanger as an indoorunit. Since many people already do have AC Units it would be quite easy to connect them to the heating system if only you could communicate with the Outside unit.

Another application would be to build some specialised systems for example to heat your RV and warm water.

Also prices for Waterunits seem to be quite high compared to Air/Air Units.

x3oo, 2024-09-16:
> Some AC units use 2-wire F1/F2 which is electrically the same as P1/P2, but logically different. And F1/F2 may not provide bus power.
>
> Other units use a one-wire protocol, this may be unsafe to touch, and which is definitely different from P1/P2.

Daikin Emura uses only one wire to my knowledge.

x3oo, 2024-09-17:
> Some AC units use 2-wire F1/F2 which is electrically the same as P1/P2, but logically different. And F1/F2 may not provide bus power.

Logically only means that there are other messages or that it's another protocol?

Arnold-n, 2024-09-17:
It's also packet-based, but with different packet lenghts and (unknown) content.

x3oo, 2024-09-17:
> It's also packet-based, but with different packet lenghts and (unknown) content.

how hard would it be for a motivated human being to decode?

Arnold-n, 2024-09-18:
Certainly doable!

Thread 128 (2024-09-14):

Problem set heat temperature

mochitoju, 2024-09-14:
Hi there,

i've the "modul" now since 2 month for my Daikin Altherma 3 (new model) and now its the first time to start testing heating.
i can not set any heating temperature (Room Room_Heating) above 20,4 degrees.
-> "only allowed between 12 and 20,4 degrees"

in cooling i can set temperature till 27 degrees.

anybody who can help?
in Daikin Onecta HomeAssistant it would be possible to set the correct temperature till 32 degrees.

gtx, juergen

mochitoju, 2024-09-14:
sensor.bridge1_fieldsettings_3_06_a3212_temp_range_room_heating_max
= 20.4

so, its obtained from Daikin, but i cannot find where i can change it

Arnold-n, 2024-09-14:
Hi Juergen,

You cannot change this value - by coincidence I learned yesterday that some field settings, in particular the stepsize for certain field settings, are not decoded properly on some systems, and I think this is the cause of your problem too.

Can you please share the MQTT reported values of the following 4 (or 8) settings?
```
P1P2/P/P1P2MQTT/bridge0/F/2/3_06_A3212_Temp_Range_Room_Heating_Max
P1P2/P/P1P2MQTT/bridge0/F/2/3_07_A3211_Temp_Range_Room_Heating_Min
P1P2/P/P1P2MQTT/bridge0/F/2/3_08_A3214_Temp_Range_Room_Cooling_Max
P1P2/P/P1P2MQTT/bridge0/F/2/3_09_A3213_Temp_Range_Room_Cooling_Min
P1P2/P/P1P2MQTT/bridge0/F/4/3_06_A3212_Temp_Range_Room_Heating_Max
P1P2/P/P1P2MQTT/bridge0/F/4/3_07_A3211_Temp_Range_Room_Heating_Min
P1P2/P/P1P2MQTT/bridge0/F/4/3_08_A3214_Temp_Range_Room_Cooling_Max
P1P2/P/P1P2MQTT/bridge0/F/4/3_09_A3213_Temp_Range_Room_Cooling_Min
```

On my system these report:
```
P1P2/P/P1P2MQTT/bridge0/F/2/3_06_A3212_Temp_Range_Room_Heating_Max {"val":30.0, "min":18, "max":30, "stepsize":0.5, "bits":"00", "bitsstep":"0x01"}
P1P2/P/P1P2MQTT/bridge0/F/2/3_07_A3211_Temp_Range_Room_Heating_Min {"val":12.5, "min":12, "max":18, "stepsize":0.5, "bits":"00", "bitsstep":"0x01"}
P1P2/P/P1P2MQTT/bridge0/F/2/3_08_A3214_Temp_Range_Room_Cooling_Max {"val":35.0, "min":25, "max":35, "stepsize":0.5, "bits":"00", "bitsstep":"0x01"}
P1P2/P/P1P2MQTT/bridge0/F/2/3_09_A3213_Temp_Range_Room_Cooling_Min {"val":15.0, "min":15, "max":25, "stepsize":0.5, "bits":"00", "bitsstep":"0x01"}
```
with a stepsize of 0.5C (which is configurable on my system as 0.5C or 1.0C). I think your system has a stepsize of 1.0C (fixed) whereas it seems to be wrongly decoded as 0.2C. I would be interested to see the value of your "bits" and "bitsstep" in these messages to see if they are needed in the field setting decoding.

mochitoju, 2024-09-14:
3_06_A3212_Temp_Range_Room_Heating_Max = {"val":20.4, "min":18, "max":20, "stepsize":0.2, "bits":"00", "bitsstep":"0x40"}
3_07_A3211_Temp_Range_Room_Heating_Min = {"val":12.0, "min":12, "max":13, "stepsize":0.2, "bits":"00", "bitsstep":"0x40"}
3_08_A3214_Temp_Range_Room_Cooling_Max = {"val":27.0, "min":25, "max":27, "stepsize":0.2, "bits":"00", "bitsstep":"0x40"}
3_09_A3213_Temp_Range_Room_Cooling_Min = {"val":15.0, "min":15, "max":17, "stepsize":0.2, "bits":"00", "bitsstep":"0x40"}

mochitoju, 2024-09-14:
mhm, i think i could change the value to more than 20 in the beginning (also a friend of mine have the same problem) - maybe something changed according a firmware update of Daikin?

Arnold-n, 2024-09-14:
Quite possibly - it seems Daikin now uses a mantissa which can be 1.0 which I haven't seen in the past. I am updating the firmware and hope that will solve it.

mochitoju, 2024-09-14:
little update.
- rebuild mqtt
- changed field_settings > RT > LT and back to RT
- temperature range to 30 degrees possible!

Arnold-n, 2024-09-14:
Seems weird, but I think this happens because the rebuild-mqtt action (with current 0.9.53) will work only for a few minutes (it uses 30 as a best-guess value, while waiting for the real max) before it then changes back to 20.4.

Just mailed you a new firmware 0.9.54, which should solve it. Daikin seems to use 10E-1 instead of 1E0 for certain step sizes.

Arnold-n, 2024-09-15:
[P1P2MQTT-bridge-v0.9.54rc1-Daikin-E.ino.bin](https://github.com/Arnold-n/P1P2MQTT/blob/main/Firmware_images/P1P2MQTT-bridge-v0.9.54rc1-Daikin-E.ino.bin) should decode 10E-1 step size correctly.

mochitoju, 2024-09-15:
> Seems weird, but I think this happens because the rebuild-mqtt action (with current 0.9.53) will work only for a few minutes (it uses 30 as a best-guess value, while waiting for the real max) before it then changes back to 20.4.
>
> Just mailed you a new firmware 0.9.54, which should solve it. Daikin seems to use 10E-1 instead of 1E0 for certain step sizes.

Problem seem to be solved.

> [P1P2MQTT-bridge-v0.9.54rc1-Daikin-E.ino.bin](https://github.com/Arnold-n/P1P2MQTT/blob/main/Firmware_images/P1P2MQTT-bridge-v0.9.54rc1-Daikin-E.ino.bin) should decode 10E-1 step size correctly.

is this the same file or a diffferent one/version?

Thank you much for your quick solution!

Arnold-n, 2024-09-15:
It's the same, except for the version itself.

Excentyl, 2025-03-22:
I am having an issue (on firmware 0.9.58rc13) which I think might be the same as this one? I am not able to set my temperature because my min_temp is wrong, here is the attributes of the cliamte entity:
```
hvac_modes:
  - "off"
  - heat
min_temp: 212
max_temp: 26
target_temp_step: 0.5
current_temperature: 19.9
temperature: 17
icon: mdi:coolant-temperature
friendly_name: Central Heating
supported_features: 385
```

I checked the setting of F/F/3_07_A3211_Temp_Range_Room_Heating_Min and it looks quite strange:
```
{
    "val": 212,
    "min": 12,
    "max": 612,
    "stepsize": 100,
    "bits": "00",
    "bitsstep": "0x00"
}
```

On the MMI the setpoint range is correct, but if I change it to something else and then change it back, the climate entity in Home Assistant will correct itself and I can change the temperature setpoint again. However, after a little while, the problem will reoccur - I have so far been unable to determine what causes this (note: sometimes it effects the max temperature instead).

Also, if you'd rather, I can open a new issue for this, just let me know.

Arnold-n, 2025-03-22:
@Excentyl thanks for reporting this. I think it has the same root cause, and I will rewrite the code to be more lenient on stepsize used.

Arnold-n, 2025-03-22:
The cause is likely somewhat similar, but still a bit strange. This version has a work-around which I hope works better: [P1P2MQTT-bridge v0.9.58rc14 for Daikin-E](https://github.com/Arnold-n/P1P2MQTT/blob/main/Firmware_images/P1P2MQTT-bridge-v0.9.58rc14-Daikin-E.ino.bin)

Excentyl, 2025-03-22:
Thank you @Arnold-n, I have installed the new firmware and after resetting the setpoints in the MMI, the climate entity in Home Assistant is working and F/F/3_07_A3211_Temp_Range_Room_Heating_Min looks correct:
```
{
    "val": 14,
    "min": 12,
    "max": 18,
    "stepsize": 1,
    "bits": "00",
    "bitsstep": "0x00"
}
```

Since I'm not sure what was causing the problem to reoccur before, I'll keep and eye on it and let you know if there are any further issues.

Thank you again for your support.

Arnold-n, 2025-03-22:
You're welcome. You mentioned earlier that the problem would,  "after a little while", reoccur. Do you know what time frame this was, less than 10 minutes, or if longer, perhaps correlated to a Daikin system restart? As I think the problem could be triggered
-during a restart
-during a regular repetition of field settings values (which does not happen on all systems)
-or due to another cause

Excentyl, 2025-03-24:
I haven't had a reoccurance over the weekend - before the update on Friday, it was happening a couple times a day, which gives me confidence. Now that you mention it, it may be linked to system restarts.

I first noticed this after I had power monitoring installed (a few days after the heat pump was installed). I initially didn't think that would cause an issue since it's just a CT clamp on a wire, but the system did get powered down and then restarted to install it. Following that, I was still regularly changing settings on the MMI (set points, weather curve ect) and the MMI did occationally ask to restart the system. I also changed settings in the MMI over the weekend without issue.

Thread 134 (2024-10-16):

Temperatures from compressor module

bwindsor, 2024-10-16:
Firstly, thanks so much for this project, I've been using data from it for the last year and it's been brilliant. I have the Altherma 3 EDLA09DA3V3. I notice in the user manual it mentions 5 thermistors in the compressor module.

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

I can see the 4 "hydro module" thermistors fine. I can also see outdoor air temperature and "refrigerant_2" which looks like it may be
R4T of the compressor module, but could be R3T or R5T. My question is do you know if these remaining temperature sensor measurements are sent over P1P2 and therefore may be accessible in some way?

I am running older firmware but from a brief look through the code I can't see a mention of any other refrigerant temperatures, and references like "R1T" seem to refer to the hydro module not the compressor module. Thanks!

Arnold-n, 2024-11-27:
Sorry for my late answer - I think your analysis is fully correct. We have not yet found the missing compressor module sensors in the P1/P2 data. There is a small chance that these are communicated in the "packet 15 parameter data" which so far was not reported but as of today's P1P2MQTT-bridge v0.9.57 is reported as Param15_Temperature_* values.

Thread 136 (2024-10-24):

UDP or ESPHome

uKL, 2024-10-24:
Hello,
Are you considering adding support for UDP based communication or creating ESP Home based configuration?

Arnold-n, 2024-10-24:
Yes, but several other topics have higher priority, so sorry but this may take a while.

DiabloVmax1200, 2024-10-24:
uKL for what do you plan to use UDP based communication? Because of Loxone integration? If yes Loxberry with MQTT Sever works pretty. I also first thought UDP would be great to have. But the MQTT integration has huge benefit for Loxone. https://wiki.loxberry.de/konfiguration/widget_help/widget_mqtt

uKL, 2024-10-27:
> uKL for what do you plan to use UDP based communication? Because of Loxone integration? If yes Loxberry with MQTT Sever works pretty. I also first thought UDP would be great to have. But the MQTT integration has huge benefit for Loxone. https://wiki.loxberry.de/konfiguration/widget_help/widget_mqtt

Yes, for Loxone. I'd be using MQTT for now but for stability I'd like to make it independent of my Loxberry Instance like I have it for other ESP32 based sensors.

DiabloVmax1200, 2024-10-27:
Hi. Where do you have stability issues? I’ve the same setup but actually have the feeling that it runs stable

uKL, 2024-10-27:
> Hi. Where do you have stability issues? I’ve the same setup but actually have the feeling that it runs stable

In general it is stable. Conceptually, I’m having an idea of making critical items like security, heating, electricity, independent of Loxberry - just in case.

DiabloVmax1200, 2024-10-28:
Hi, this makes sense. Less parts more reliable.
In my configuration I only would lose some comfort and I might would use a bit more energy.

uKL, 2024-11-07:
> Hi, this makes sense. Less parts more reliable. In my configuration I only would lose some comfort and I might would use a bit more energy.

Well, it depends. If the heatpump would be stuck in DHW heating disabled, this means that there's no hot water in the shower ;-) Wife acceptance factor = -1

... and his had happened with the cloud integration for a few times.

DiabloVmax1200, 2024-11-07:
That’s definitely an issue ☺️

Gorgar91, 2024-11-17:
I purchased "older" model just because of lack of UDP functionality, using budulinek setup now with loxone, but if UDP will come into place , I am ready to do purchase again .  Thanks Arnold for all this !

Thread 138 (2024-11-11):

Daikin altherma EAVH16S23DA6V model

Sigmun, 2024-11-11:
Hi,

I have a Daikin Altherma heating and cooling system. Inter al unit is a EAVH16S23DA6V model. How do you think it can be managed?

Thanks for your answer, I need a way to use correctly my system which does not seem to use correctly the pump system to heat when my command temperature is under 25°C which is way to high for my house.

Arnold-n, 2024-11-11:
Sound like your heating system is very efficient! Unfortunately Daikin heat pumps are not able to generate leaving water temperature below 25°C using the compressor. It will use the backup heater instead. It has been suggested that this is either to prevent short-cycling or due to physical limitations of the heat pump. It seems your only solution would be to set the LWT setpoint at 25°C and either mix it down to your target temperature or to accept 25°C and switch the compressor on/off (which can be done using the thermostat or using the P1P2MQTT bridge).

Closed 2024-11-27.

Thread 145 (2024-11-27):

Altherma 3 - ETBX12EF9W - No installer mode, no silent mode

Rewertius, 2024-11-27:
Hello,
first of all: thank you very much for you important work to emancipate from the cloud and the closed source software.
After a little struggle with the setup, i am able to control the main features ob my ETBX12EF9W.

Now i would like to monitor the behavior of the heatpump and the bridge. Therefore i try to find the mqtt topics as described in your manual. But in my mqtt explorer i can only see the topics as you see in my attached screenshot
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

I would like to the these informations because if i try to change the silent mode or the user mode by using the entitys in homeassistant , it does'nt have any impact. Also if use the L92 commant via telnet.

thanks in advance for any hints.
Philip
PS: if this post is more a kind of a discussion than an issue, fell free to move.

Rewertius, 2024-11-27:
Now i found an entry as using the L92 command:
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
but nothing after that.

Arnold-n, 2024-11-27:
This is likely the same issue as [issue #98](https://github.com/Arnold-n/P1P2MQTT/issues/98) - it seems that the bridge attempting to change quiet mode or trying to claim installer mode does not work on all systems - not sure why yet. Perhaps it is not possible, perhaps the mechanism is different.

Thread 148 (2024-12-03):

Is climate.set_preset_mode available?

fauust, 2024-12-03:
Hi!

First of all, this is an awesome project! I have just received the bridge (well packed) and thanks to the documentation, it was pretty straightforward to setup and to start using it (I had prepared the MQTT part). Thanks a lot @Arnold-n and anybody that has contributed to this project!

I have a very simple question, is the preset mode available `climate.set_preset_mode`?

Here are HA logs:
```console
homeassistant  | 2024-12-03 18:13:11.271 ERROR (MainThread) [homeassistant.components.automation.tdegc_lavoro_09h00_17degc] Error while executing automation automation.tdegc_lavoro_09h00_17degc: Entity climate.hc_room_room_heating does not support this service.
```

The reason I am trying to use it is to synchronize what the Daikin LCD screen shows with what HA actually does (temperature targets are in sync though which is already awesome).

I am very sorry if this was already discussed (I could not find any issue), or if it's explained somewhere in the documentation.

fauust, 2024-12-04:
Thanks!

Yes, I am referring to the eco/comfort state of the controller. The use case would be someone (a guest) without HA access that could still easily understand what's going on on the Daikin LCD and make changes between confort and eco, which he still can but need to check the desired temperature to understand the HA program.

But I can totally live without it!

Arnold-n, 2024-12-04:
Thanks for your explanation. I will add a schedule/eco/comfort selection menu in the next version. However I think that it only shows the manual preset (=override), but not what the schedule itself prescribes, this can only be derived from the actual  room temperature setpoint.

fauust, 2024-12-05:
Thanks! BTW is there a way to be alerted of new firmware release, I see that the repo has only 3 tags so you probably don't release through GitHub?

Arnold-n, 2024-12-06:
[v0.9.58rc3](https://github.com/Arnold-n/P1P2MQTT/blob/main/Firmware_images/P1P2MQTT-bridge-v0.9.58rc3-Daikin-E.ino.bin) includes preset mode. Firmwares are frequently released via github, but usually not tagged as most versions are only incremental. I think you can "watch" a repo to be informed of any commits (some of which are firmware).

Arnold-n, 2024-12-10:
Thanks for providing this script - but why 2 actions, isn't the 2nd action enough, the wall controller should change the temperature setting to the value configured for eco when the preset mode is set to eco.

fauust, 2024-12-11:
You are right, it is but I don't want to rely on the wall setup so that I can change Eco/Comfort temp from HA. But next step is to make those changes in sync between HA and Daikin so that only preset_mode is needed :)

fauust, 2024-12-13:
Awesome!

fauust, 2024-12-16:
I have just upgraded the firmware, it's working like a charm! Best couple of euros spend in 2024 ;)

Closed 2024-12-10.

Thread 150 (2024-12-05):

HC_Sensors Temperature_R2T_Leaving_Water showing as negative number

brainrecursion, 2024-12-05:
With my heat pump (EDLA06E2V3) the leaving water temperature is showing as a negative number.
`HC_Sensors Temperature_R2T_Leaving_Water : -128C`

This might be because the heatpump doesn't have a backup heater so I might need R1T instead?

brainrecursion, 2024-12-05:
Ah not an issue, just seen R1T is available so I can use that.

Arnold-n, 2024-12-05:
Indeed some systems do not have R2T. You might still want to set the bridge to give command `P43 1` followed by `D5` to set parameter 43 to have the bridge use R1T instead of R2T to get the names of the entities right.

Thread 152 (2024-12-06):

Duplicate HA entries created

brainrecursion, 2024-12-06:
After setup I get a few duplicate entries created:
- climate.hc_room_room_cooling
- climate.hc_room_room_cooling_2
- climate.hc_room_room_heating
- climate.hc_room_room_heating_2

Also is it possible to add a config option to not create any of the cooling entities if the P1P2 device does not support cooling?
Thanks

Arnold-n, 2024-12-06:
Did you change any config options (like MQTT prefix)? If not, can you share the related config items (before deleting them)? You can delete no longer used entities with `MQTT_Delete_Own_Rebuild`. or even `MQTT_Delete_All_Rebuild`.

Deciding whether to make cooling entities is tricky, as the cooling capability - a field setting - is only reported by the Daikin system once, shortly after system restart, and in many but not all systems also every regularly thereafter, every 5-10 minutes. In an earlier version cooling entities were deleted once it was detected that a system is heating-only but that wasn't working reliably with the way HA shows various entities so they are currently not deleted. For now the next-best solution is to delete the entities from your dashboard.

brainrecursion, 2024-12-06:
> Did you change any bridge config options (like MQTT prefix)? If not, can you share the related config items (before deleting them)? You can delete no longer used entities with `MQTT_Delete_Own_Rebuild` or even `MQTT_Delete_All_Rebuild`.

I haven't changed any bridge config options. The duplicate entries were after running `MQTT_Delete_Own_Rebuild`. I just ran it again and got a different set of duplicate entries, so something strange going on.

Arnold-n, 2024-12-07:
Not only changing MQTT prefix (configuration P12), but also changing the device name (P13, default P1P2MQTT), changing the bridge name (P14, default bridge0), whether to use device name in topic (P24), whether to use bridge name in topic (P28), and perhaps also whether to use bridge name in entity, may give duplicate entries. Would that explain your situation? In that case `MQTT_Delete_Own_Rebuild` will create a new entry without deleting the original one (as it no longer recognizes the original entry as its own), and `MQTT_Delete_All_Rebuild` is needed.

rjpearce, 2024-12-07:
I have this issue too with the following duplicate entries:
- climate.hc_room_room_cooling
- climate.hc_room_room_cooling_2
- climate.hc_room_room_cooling_3
- climate.hc_room_room_heating
- climate.hc_room_room_heating_2
- climate.hc_room_room_heating_3

I hadn't changed P12, P13, P14, P24 or P28.
I turn L1 on, off and then back on, I turned on C2 and change some of the Field Settings.

I can confirm that MQTT_Delete_All_Rebuild (command D14) does remove them all from HC_Room but I now have the following back:

- climate.hc_room_room_cooling
- climate.hc_room_room_cooling_2
- climate.hc_room_room_heating

brainrecursion, 2024-12-07:
I haven't changed P12, P13, P4, P24 or P28.
I have tried `MQTT_Delete_Own_Rebuild` a few times and I can see it removes all the entities but I end up with a few random duplicates each time. Is it something simple like the MQTT topic config messages are not being sent with a QoS of 2 so are received duplicated? Equally it could be a HomeAssistant bug.

Arnold-n, 2024-12-07:
Perhaps its HA. I sometimes had to delete the entire MQTT configuration and add it again in HA to resolve things. Though duplicated messages should have the same uniq id and should not give duplicate entries. If you have mosquitto_sub, you can read back all retained homeassistant config messages to check if there are duplicated config messages, as in
`mosquitto_sub -h 192.168.4.12  -p 1883  -u P1P2 -P P1P2 -v -t homeassistant/# | grep Room_Cooling`. This will also show any messages get deleted and reconfigured during a rebuild.

If your WiFi signal is weak, that could cause loss of some messages too due to limited buffer sizes.

brainrecursion, 2024-12-07:
I tried the `mosquitto_sub ...` command and it did return three entries which matches the amount of entities I am seeing. Interesting they all have different unique IDs.

```
homeassistant/climate/bridge0/P1P2MQTT_bridge0_U4_Room_Cooling_4/config {"temp_stat_t":"P1P2/P/P1P2MQTT/bridge0/S/0/Room_Cooling_Setpoint","min_temp":15.0,"max_temp":35.0,"temp_step":0.5,"curr_temp_t":"P1P2/P/P1P2MQTT/bridge0/T/1/Temperature_Room","mode_stat_t":"P1P2/P/P1P2MQTT/bridge0/S/0/Altherma_On","mode_stat_tpl":"{% set modes={'0':'off','1':'cool'} %}{{ modes[value] if value in modes.keys() else modes['0']}}","modes":["off","cool"],"mode_cmd_t":"P1P2/W/P1P2MQTT/bridge0","mode_cmd_tpl":"{% set modes={'off':0,'cool':1} %}{{'E35002F%02X 350031%02X 35002D%02X'|format((modes[value]|int) if value in modes.keys() else 0, (modes[value]|int) if value in modes.keys() else 0, (modes[value]|int) if value in modes.keys() else 0)}}","temp_cmd_t":"P1P2/W/P1P2MQTT/bridge0","temp_cmd_tpl":"{{'E360001%04X'|format((value*10)|int)}}","name":Room_Cooling","uniq_id":"P1P2MQTT_bridge0_U4_Room_Cooling_4","avty":[{"topic":"P1P2/L/P1P2MQTT/bridge0","pl_avail":"online","pl_not_avail":"offline"},{"topic":"P1P2/P/P1P2MQTT/bridge0/A/8/Control_Function","pl_avail":1,"pl_not_avail":0},{"topic":"P1P2/P/P1P2MQTT/bridge0/C/9/RT","pl_avail":1,"pl_not_avail":0},{"topic":"P1P2/P/P1P2MQTT/bridge0/S/9/Heating_Only","pl_avail":0,"pl_not_avail":1}],"avty_mode":"all","dev":{"name":"HC_Room","ids":["HC_Room"],"mf":"Home-CliCK","mdl":"P1P2MQTT_bridge","sw":"0.9.58rc2"},"ic":"mdi:coolant-temperature","qos":1}
homeassistant/climate/bridge0/P1P2MQTT_bridge0_U6_Room_Cooling_6/config {"temp_stat_t":"P1P2/P/P1P2MQTT/bridge0/S/0/Room_Cooling_Setpoint","min_temp":15.0,"max_temp":35.0,"temp_step":0.5,"curr_temp_t":"P1P2/P/P1P2MQTT/bridge0/T/1/Temperature_Room","mode_stat_t":"P1P2/P/P1P2MQTT/bridge0/S/0/Altherma_On","mode_stat_tpl":"{% set modes={'0':'off','1':'cool'} %}{{ modes[value] if value in modes.keys() else modes['0']}}","modes":["off","cool"],"mode_cmd_t":"P1P2/W/P1P2MQTT/bridge0","mode_cmd_tpl":"{% set modes={'off':0,'cool':1} %}{{'E35002F%02X 350031%02X 35002D%02X'|format((modes[value]|int) if value in modes.keys() else 0, (modes[value]|int) if value in modes.keys() else 0, (modes[value]|int) if value in modes.keys() else 0)}}","temp_cmd_t":"P1P2/W/P1P2MQTT/bridge0","temp_cmd_tpl":"{{'E360001%04X'|format((value*10)|int)}}","name":Room_Cooling","uniq_id":"P1P2MQTT_bridge0_U6_Room_Cooling_6","avty":[{"topic":"P1P2/L/P1P2MQTT/bridge0","pl_avail":"online","pl_not_avail":"offline"},{"topic":"P1P2/P/P1P2MQTT/bridge0/A/8/Control_Function","pl_avail":1,"pl_not_avail":0},{"topic":"P1P2/P/P1P2MQTT/bridge0/C/9/RT","pl_avail":1,"pl_not_avail":0},{"topic":"P1P2/P/P1P2MQTT/bridge0/S/9/Heating_Only","pl_avail":0,"pl_not_avail":1}],"avty_mode":"all","dev":{"name":"HC_Room","ids":["HC_Room"],"mf":"Home-CliCK","mdl":"P1P2MQTT_bridge","sw":"0.9.58rc2"},"ic":"mdi:coolant-temperature","qos":1}
homeassistant/climate/bridge0/P1P2MQTT_bridge0_U2_Room_Cooling_2/config {"temp_stat_t":"P1P2/P/P1P2MQTT/bridge0/S/0/Room_Cooling_Setpoint","min_temp":15.0,"max_temp":35.0,"temp_step":0.5,"curr_temp_t":"P1P2/P/P1P2MQTT/bridge0/T/1/Temperature_Room","mode_stat_t":"P1P2/P/P1P2MQTT/bridge0/S/0/Altherma_On","mode_stat_tpl":"{% set modes={'0':'off','1':'cool'} %}{{ modes[value] if value in modes.keys() else modes['0']}}","modes":["off","cool"],"mode_cmd_t":"P1P2/W/P1P2MQTT/bridge0","mode_cmd_tpl":"{% set modes={'off':0,'cool':1} %}{{'E35002F%02X 350031%02X 35002D%02X'|format((modes[value]|int) if value in modes.keys() else 0, (modes[value]|int) if value in modes.keys() else 0, (modes[value]|int) if value in modes.keys() else 0)}}","temp_cmd_t":"P1P2/W/P1P2MQTT/bridge0","temp_cmd_tpl":"{{'E360001%04X'|format((value*10)|int)}}","name":Room_Cooling","uniq_id":"P1P2MQTT_bridge0_U2_Room_Cooling_2","avty":[{"topic":"P1P2/L/P1P2MQTT/bridge0","pl_avail":"online","pl_not_avail":"offline"},{"topic":"P1P2/P/P1P2MQTT/bridge0/A/8/Control_Function","pl_avail":1,"pl_not_avail":0},{"topic":"P1P2/P/P1P2MQTT/bridge0/C/9/RT","pl_avail":1,"pl_not_avail":0},{"topic":"P1P2/P/P1P2MQTT/bridge0/S/9/Heating_Only","pl_avail":0,"pl_not_avail":1}],"avty_mode":"all","dev":{"name":"HC_Room","ids":["HC_Room"],"mf":"Home-CliCK","mdl":"P1P2MQTT_bridge","sw":"0.9.58rc2"},"ic":"mdi:coolant-temperature","qos":1}
```

Arnold-n, 2024-12-07:
Many thanks, this clearly identifies the cause of the duplicate entries. The Room_Cooling entry is generated when a 00Fx30 packet is received. This packet is generated on my system addressed to auxiliary controller F0 only, but on your system for 3 auxiliary controllers (F0/F1/FF). I will fix this and let you know when the updated version is available.

brainrecursion, 2024-12-07:
Excellent, glad it makes sense!

I also seem to have duplicate entries for quite a few of the UI ones. Not sure if this is same issue?
Thanks
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

Arnold-n, 2024-12-07:
Same issue indeed (but a bit trickier as some of the duplicate entries represent different things), and you might also see duplicate field setting values.

Arnold-n, 2024-12-08:
I hope v0.9.58rc4 resolves all duplicate entries and does not introduce any new issues. After installing, `MQTT_Delete_Own_Rebuild` (/D12) is needed to remove/replace some of the old entries.

adam-the, 2025-01-06:
I was also getting duplicates, but only of the HC_Room entries - I didn't think much of it as changing any of them worked anyway haha... 0.9.58rc4 with a rebuild reduced it to one entry.

brainrecursion, 2025-01-08:
I can confirm the rc4 removed my duplicate entries as well.

Arnold-n, 2025-01-08:
Great, thanks for your confirmations.

Closed 2025-01-08.

Thread 154 (2024-12-23):

Reverse Engineering Daikin Ducted AC unit FBQ71C7VEB

yiannosi, 2024-12-23:
Hi,

I ve designed a similar device based on an ESP32 module for the above ducted  split type air conditioner which also has a wired controller with P1P2 interface.

Trying to figure out how the various packets are interpreted, I ve lefet my unit just listening the recording traffic with the AC off and here's what I get :

Note that the first number indicates the length of the packet.

Can anybody help decoding this as it doesn't seem to follow the rules of the P1P2 packets given

```

new Incoming 13 - 00 0 10 0 62 2 1A 0   11 0 2 0 0
new Incoming 13 - 40 00 10  - 00 00 62 2 1A 0 11 0 3A 0
new Incoming 11 - 80 0 18 0 0 0 0 0 0   0 8A
new Incoming 13 - 00 00 11- 0 0 0 0 0   13 28 0 0 0
new Incoming 13 - 40 00 11 - 0 -0 -0   -0 -0 -13 -6C -0- 0- 0-
new Incoming 5 - 0 D 20 4 C7
new Incoming 13 - 0 0 10 0 62 2 1A 0   11 0 2 0 0
new Incoming 13 - 40 0 10 0 0 62 2 1A   0 11 0 3A 0
new Incoming 5 - 0 E 20 4 34
new Incoming 13 - 0 0 10 0 62 2 1A 0   11 0 2 0 0
new Incoming 13 - 40 0 10 0 0 62 2 1A   0 11 0 3A 0
new Incoming 5 - 0 F 20 4 65
new Incoming 13 - 0 0 10 0 62 2 1A 0   11 0 2 0 0
new Incoming 13 - 40 0 10 0 0 62 2 1A   0 11 0 3A 0
new Incoming 13 - 0 0 1F 31 40 0 1F 0   76 B 44 C E
new Incoming 13 - 0 0 10 0 62 2 1A 0   11 0 2 0 0
new Incoming 13 - 40 0 10 0 0 62 2 1A   0 11 0 3A 0
new Incoming 11 - 80 0 18 0 0 0 0 0 0   0 8A
new Incoming 13 - 0 F0 30 0 23 B0 0   20 10 20 10 1 21
new Incoming 5 - 0 10 20 4 86
new Incoming 13 - 0 0 10 0 62 2 1A 0   11 0 2 0 0
new Incoming 13 - 40 0 10 0 0 62 2 1A   0 11 0 3A 0
new Incoming 4 - 80 80 0 12
new Incoming 13 - 0 0 10 0 62 2 1A 0   11 0 2 0 0
new Incoming 13 - 40 0 10 0 0 62 2 1A   0 11 0 3A 0
new Incoming 13 - 0 0 20 4 3C 40 0 20   1 23 B0 0 20
new Incoming 13 - 0 0 10 0 62 2 1A 0   11 0 2 0 0
new Incoming 13 - 40 0 10 0 0 62 2 1A   0 11 0 3A 0
new Incoming 13 - 0 0 1F 31 40 0 1F 0   76 B 44 C E
new Incoming 13 - 0 0 10 0 62 2 1A 0   11 0 2 0 0
new Incoming 13 - 40 0 10 0 0 62 2 1A   0 11 0 3A 0
new Incoming 11 - 80 0 18 0 0 0 0 0 0   0 8A
new Incoming 13 - 0 0 11 0 0 0 0 0 13   28 0 0 0
new Incoming 13 - 40 0 11 0 0 0 0 0   13 6C 0 0 0
new Incoming 5 - 0 1 20 4 6D
new Incoming 13 - 0 0 10 0 62 2 1A 0   11 0 2 0 0
new Incoming 13 - 40 0 10 0 0 62 2 1A   0 11 0 3A 0
new Incoming 5 - 0 2 20 4 9E
new Incoming 13 - 0 0 10 0 62 2 1A 0   11 0 2 0 0
new Incoming 13 - 40 0 10 0 0 62 2 1A   0 11 0 3A 0
new Incoming 5 - 0 3 20 4 CF
new Incoming 13 - 0 0 10 0 62 2 1A 0   11 0 2 0 0
new Incoming 13 - 40 0 10 0 0 62 2 1A   0 11 0 3A 0
new Incoming 13 - 0 0 1F 31 40 0 1F 0   76 B 44 C E
new Incoming 13 - 0 0 10 0 62 2 1A 0   11 0 2 0 0
new Incoming 13 - 40 0 10 0 0 62 2 1A   0 11 0 3A 0
```

Arnold-n, 2024-12-23:
This is standard data for F-series version "C", which is already supported as model 10 by this project. Some requests are replied to (00 00 10, 00 00 11), others are not (80 00 18, 00 00 1F, 00 03 20, etc) and for these extra messages the data is not reverse engineered yet.

yiannosi, 2024-12-23:
> This is standard data for F-series version "C", which is already supported as model 10 by this project. Some requests are replied to (00 00 10, 00 00 11), others are not (80 00 18, 00 00 1F, 00 03 20, etc) and for these extra messages the data is not reverse engineered yet.

Thanks for your quick  reply.
Is there any info available  for the known packets?
I understand  decoding is done within the p1p2serial library,  correct?

Arnold-n, 2024-12-23:
It's a combination of code in the P1P2MQTT library, P1P2Monitor, and P1P2MQTT-bridge.

yiannosi, 2024-12-23:
> It's a combination of code in the P1P2MQTT library, P1P2Monitor, and P1P2MQTT-bridge.

ok..could you point me where to look for to get some info to decode the packets in my code?

Arnold-n, 2024-12-24:
This code is for ESP8266+ATmega, not ESP32.

Closed 2024-12-24.

Thread 156 (2025-01-04):

Trying to decode my ducted Daikin unit

yiannosi, 2025-01-04:
Hi,

I have been collecting packets from my Daikin ducted AC unit and trying to decode them for a couple of months now.
Based on documentation provided here and else where I have managed to extract the current state of the unit from packets
0010 and 0011

```
00 00 11 00 00 00 00 00 12 E2 00 00 00 D8
40 00 11 00 00 00 00 00 12 B4 00 00 00 00 11 0C 97
00 00 10 00 61 01 17 00 11 00 02 00 00 00 00 00 80 40 00 00 00 00 00 87
40 00 10 00 00 61 01 17 00 11 00 3A 00 00 00 00 00 80 00 00 00 00 80 E1
```

For the above I have managed to get the Power State On/Off and Mode of operation and the set temperature.
My problem now is that I couldn't find a way to send commands to the unit.!

Below is the traffic when the power button is pressed and the unit is switched on
I have filtered out all 0010 and 0011 packets for clarity.

```
00 0A 20 04 C3
00 0B 20 04 92
00 0C 20 04 96
00 00 1F 31
40 00 1F 00 F2 0B D4 0C 0F FF 10 00 00 00 00 00 00 00 00 01 00 00 80 E3
80 00 18 01 00 00 00 00 00 00 4B
00 F0 30 00 23 B0 00 20 10 20 10 01 21 00 2C C2 50 0D 00 14 06 50 02 8A
00 0D 20 04 C7
00 0E 20 04 34
00 0F 20 04 65
00 00 1F 31
40 00 1F 00 F2 0B D4 0C 0F FF 10 00 00 00 00 00 00 00 00 01 00 00 80 E3
80 00 18 01 00 00 00 00 00 00 4B
00 10 20 04 86
80 80 00 12
00 00 20 04 3C
40 00 20 01 23 B0 00 20 10 20 10 24 01 21 40 2C C2 50 0D 80 14 06 50 5B
00 00 1F 31
40 00 1F 00 F2 0B D4 0C 0F FF 10 00 00 00 00 00 00 00 00 01 00 00 80 E3
80 00 18 01 00 00 00 00 00 00 4B
00 F0 30 00 23 B0 00 20 10 20 10 01 21 00 2C C2 50 0D 00 14 06 50 02 8A
00 01 20 04 6D
00 02 20 04 9E
00 03 20 04 CF
00 00 1F 31
40 00 1F 00 DC 0B C0 0C 0F FF 10 00 00 00 00 00 00 00 00 01 00 00 80 02
80 00 18 01 00 00 00 00 00 00 4B
00 04 20 04 CB
00 05 20 04 9A
00 06 20 04 69
00 00 1F 31
40 00 1F 00 DC 0B C0 0C 0F FF 10 00 00 00 00 00 00 00 00 01 00 00 80 02
80 00 18 01 00 00 00 00 00 00 4B
00 F0 30 00 23 B0 00 20 10 20 10 01 21 00 2C C2 50 0D 00 14 06 50 02 8A
00 07 20 04 38
00 08 20 04 61
00 09 20 04 30
00 00 1F 31
40 00 1F 00 DC 0B C0 0C 0F FF 10 00 00 00 00 00 00 00 00 01 00 00 80 02
80 00 18 01 00 00 00 00 00 00 4B
00 0A 20 04 C3
```
And here is the traffic when the unit is turned back to Off

```
80 00 18 01 00 00 00 00 00 00 4B
00 0A 20 04 C3
00 0B 20 04 92
00 0C 20 04 96
00 00 1F 31
40 00 1F 0C C8 0B 30 0C 10 FF 10 00 00 00 00 00 13 00 00 01 00 00 80 C2
80 00 18 00 00 00 00 00 00 00 8A
00 F0 30 00 23 B0 00 20 10 20 10 01 21 00 2C C2 50 0D 00 14 06 50 02 8A
00 0D 20 04 C7
00 0E 20 04 34
00 0F 20 04 65
00 00 1F 31
40 00 1F 0C C8 0B 30 0C 10 FF 10 00 00 00 00 00 13 00 00 01 00 00 80 C2
80 00 18 00 00 00 00 00 00 00 8A
00 10 20 04 86
80 80 00 12
00 00 20 04 3C
40 00 20 01 23 B0 00 20 10 20 10 24 01 21 40 2C C2 50 0D 80 14 06 50 5B
00 00 1F 31
40 00 1F 0C C8 0B 30 0C 10 FF 10 00 00 00 00 00 13 00 00 01 00 00 80 C2
80 00 18 00 00 00 00 00 00 00 8A
00 F0 30 00 23 B0 00 20 10 20 10 01 21 00 2C C2 50 0D 00 14 06 50 02 8A
00 01 20 04 6D
00 02 20 04 9E
00 03 20 04 CF
00 00 1F 31
40 00 1F 00 C8 0B B4 0B 11 FF 11 00 00 00 00 00 13 00 00 01 00 00 80 0A
80 00 18 00 00 00 00 00 00 00 8A
00 04 20 04 CB
00 05 20 04 9A
00 06 20 04 69
00 00 1F 31
40 00 1F 00 C8 0B B4 0B 11 FF 11 00 00 00 00 00 13 00 00 01 00 00 80 0A
80 00 18 00 00 00 00 00 00 00 8A
00 F0 30 00 23 B0 00 20 10 20 10 01 21 00 2C C2 50 0D 00 14 06 50 02 8A
00 07 20 04 38
00 08 20 04 61
00 09 20 04 30
00 00 1F 31
40 00 1F 00 C8 0B B4 0B 11 FF 11 00 00 00 00 00 13 00 00 01 00 00 80 0A
80 00 18 00 00 00 00 00 00 00 8A
00 0A 20 04 C3
00 0B 20 04 92
00 0C 20 04 96
00 00 1F 31
40 00 1F 00 DC 0B 24 0B 11 FF 11 00 00 00 00 00 00 00 00 01 00 00 80 C7
80 00 18 00 00 00 00 00 00 00 8A
00 F0 30 00 23 B0 00 20 10 20 10 01 21 00 2C C2 50 0D 00 14 06 50 02 8A
00 0D 20 04 C7
00 0E 20 04 34
```

I understand that the 00 F0 30  packets that are left unanswered are calls for an external controller.
                                                                                                                                                                                                      
Not sure what the 00 1F 31 and its reply is about.

Could you please have a look and see if you can guess where the power  on/off   command is?
Once this is spotted I might then be able to find the temperature and mode settings..

Thanks so much for you help!

Thread 162 (2025-01-07):

Setpoint HA Controls Unavailable due to unexpected Control_Function 2

lewisoaten, 2025-01-07:
I have a Daikin F-series and am using FW 0.9.58rc5.

I want to start using the climat control UI in HA, but it is unavailable. Sensors, and control through the HA `MQTT_publish` service works fine.

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

Upon looking at the configuration I noticed there's two availability checks:
```json
  "avty": [
    {
      "topic": "P1P2/L/P1P2MQTT/bridge0",
      "pl_avail": "online",
      "pl_not_avail": "offline"
    },
    {
      "topic": "P1P2/P/P1P2MQTT/bridge0/A/8/Control_Function",
      "pl_avail": 1,
      "pl_not_avail": 0
    }
  ],
  "avty_mode": "all",
```

When checking each of these, the first, `L` topic reports online. However, the `Control_Function` topic is reporting `2`.

I was already running in `L1` mode, here is the log in case it helps:

```
CONTROL_ID is 0xF0, changing control mode to L1
```

I couldn't find any documentation on the `2` state, but the climate control is expecting `1`, so this would explain why it is showing as unavailable. What state would result in `2` to be reported by the Control_Function topic?

lewisoaten, 2025-01-07:
Ah, that will be it! I'll update ATmega and confirm that was the fix shortly.

lewisoaten, 2025-01-07:
Yep, all sorted! Thanks @Arnold-n !

Closed 2025-01-07.

Thread 163 (2025-01-08):

HC_Room Room_Heating unavailable in Home Assistant

nicx, 2025-01-08:
I don't know why and since when exactly, but for a few days the HC_Room Room_Heating ist unavailable. Tried to restart the module, rebuild MQTT, but with no luck. All other sensors are working as expected. Any idea what I could do?

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

Arnold-n, 2025-01-08:
Unavailability is likely either:
-`P1P2/L/P1P2MQTT/bridge0` being `offline` (should not be the case)
-`P1P2/P/P1P2MQTT/bridge0/A/8/Control_Function` being `0` (`Control_Function` is off)
-`P1P2/P/P1P2MQTT/bridge0/C/9/RT` being `0` (system operating in LWT mode, so no RT control)

If `Control_Function` is off, can you derive when/why this happened?

nicx, 2025-01-08:
@Arnold-n ok, this is interesting: P1P2/P/P1P2MQTT/bridge0/C/9/RT is 0. But looking directly in the Altherma configuration I can see that the mode is set correctly to "room thermostat". I can control the Altherma with my Madoka.

Just tried a complete restart of the Altherma, but the problem is still the same. Any idea?

Arnold-n, 2025-01-08:
Topic `P1P2/P/P1P2MQTT/bridge0/C/9/RT` depends on field setting [C-07], but newer systems do not always communicate field settings except shortly after a restart. So you should see the correct value after a Daikin restart and a 5-minute wait. As long as the field setting is not observed, the "previously seen" field setting is used, or a default setting, which was 0 (which I am now changing to 1 in [P1P2MQTT-bridge v0.9.58rc9 for Daikin E-series](https://github.com/Arnold-n/P1P2MQTT/blob/main/Firmware_images/P1P2MQTT-bridge-v0.9.58rc9-Daikin-E.ino.bin)).

nicx, 2025-01-08:
> So you should see the correct value after a Daikin restart and a 5-minute wait.

@Arnold-n unfortunately this didn't work here. But with your updated version it works now. Thanks a lot!

Closed 2025-01-08.

Thread 164 (2025-01-12):

BUH binary sensor in HA always "0"

nicx, 2025-01-12:
I have a 9kW backup heater in my Altherma.

First question: Why is ther a binary sensor only for "BUH_2"? Am I missing a sensor "BUH_1" or is this name just a default name?
Second question: When my backup heater is running, the binary sensor is showing 0 instead of 1. what could be the problem here? (Imcan see the backup,heater is runninf via ESPAltherma)
Third question: The meters and power sensor for the BUH are not working either. Is this the same problem or another one?

Arnold-n, 2025-01-12:
The BUH_2 sensor is only used on a few systems with 2 BUHs. Can you check whether Gasboiler_Active (originating from the hybrid's system gasboiler) corresponds to your BUH?

If meters are not working, have you enabled Counter_Request_Function?

nicx, 2025-01-13:
@Arnold-n no the Gasboiler_Active does not correspond to the BUH. I dindt find any sensor which correspods. Thats why I am asking ;)

All other meters are working, its only the meter sensor.hc_power_consumption_buh which sticks at 0. the sensor sensor.hc_meters_hours_backup1_dhw on the other hand is showing correct values (about 50h in my case).

Arnold-n, 2025-01-13:
You are right - I think the `BUH_On` status is now indicated by `Climate_Active_Q` (in `HC_Unknown`), I will rename it in a next version.

It is normal that `sensor.hc_power_consumption_buh` remains 0: this depends on an external electricity meter for the BUH, with input to the bridge provided via `P1P2/P/meter/U/9/Electricity_BUH_power`.

nicx, 2025-01-15:
> You are right - I think the `BUH_On` status is now indicated by `Climate_Active_Q` (in `HC_Unknown`), I will rename it in a next version.

hm I think that is nor correct. The sensor "Climate_Active_Q" is always on in my case. So it does not correspon to the BUH. I will do some tests and have a look on all sensors if I could find anything which leads to the right direction...

nicx, 2025-01-15:
@Arnold-n I did some more research: in the HA logbook ther is absolutely no HC sensor which changes the status from 0 to 1 at the time the BUH starts heating. I think its just missing for now. Could I help you with logs to find out  more?

Arnold-n, 2025-01-15:
Thanks - but I think I found it again.. indeed it wasn't any known entity, but an unknown one (thus by default not made available), how about `HC_Mode` / `BUH`, added to [v0.9.58rc11](https://github.com/Arnold-n/P1P2MQTT/blob/main/Firmware_images/P1P2MQTT-bridge-v0.9.58rc11-Daikin-E.ino.bin)?

nicx, 2025-01-17:
@Arnold-n I have installed the new RC and will give feedback. Thanks!

nicx, 2025-01-26:
> Thanks - but I think I found it again.. indeed it wasn't any known entity, but an unknown one (thus by default not made available), how about `HC_Mode` / `BUH`, added to [v0.9.58rc11](https://github.com/Arnold-n/P1P2MQTT/blob/main/Firmware_images/P1P2MQTT-bridge-v0.9.58rc11-Daikin-E.ino.bin)?

@Arnold-n its working! thanks :)

nicx, 2025-01-26:
@Arnold-n ah I forgot to ask: ist is possible in any way to see which level the backup heater is working? as far as I unsüderstood there are two levels when using the 9kw heater. first level is mostly 3kw, second level is configurable 6kw or 9kw. when knowing the level it would be easy to calculate the power consumption ;)

Arnold-n, 2025-01-26:
Isn't that just BUH_2 (I have only 1 heater level so cannot verify)? If not, that may be another bit not yet found - if you can share (can be by email) hex data log and indicate when the heater switches between modes, I can try to find it.

nicx, 2025-01-26:
@Arnold-n ah ok, I will check that and give feedback.

nicx, 2025-01-28:
@Arnold-n you are right, it's just BUH_2 for the second level. It's now all working as expected! :)

I've created a template helper in Home Assistant for calculating the power consumption of the Altherma including the different levels of the backup heater if anybody is interested in reusing it:

```
{%- set extras = 0 -%}
{%- if is_state('binary_sensor.hc_mode_buh', 'on') %}
  {%- set extras = extras + 3000 %}
{%- endif %}
{%- if is_state('binary_sensor.hc_mode_buh_2', 'on') %}
  {%- set extras = extras + 6000 %}
{%- endif -%}
{{ extras + ( states('sensor.hc_power_consumption_heatpump')  | float ) | round(0, default=0) }}
```

nicx, 2025-03-19:
> It is normal that `sensor.hc_power_consumption_buh` remains 0: this depends on an external electricity meter for the BUH, with input to the bridge provided via `P1P2/P/meter/U/9/Electricity_BUH_power`.

@Arnold-n I recognized that even when publishing values to this topic the sensor sensor.hc_power_consumption_buh always shows "0". As far as I understood you, the sensor should reflecting the value I published to P1P2/P/meter/U/9/Electricity_BUH_power. Am I right?

nicx, 2025-03-24:
@Arnold-n could you help me?

Arnold-n, 2025-03-30:
@nicx can you check that the value of parameter P37 is `P1P2/P/meter/U/9/Electricity_BUH_power` or matches the topic you use, as the topic is configurable, and that the meter reading is published on that topic at least every 75 seconds?

nicx, 2025-03-30:
the value is the same:

[ESP] ESPuptime    352366 P37: mqtt_BUH_Power           is P1P2/P/meter/U/9/Electricity_BUH_Power
[ESP] ESPuptime    352366 P38: mqtt_BUH_Total           is P1P2/P/meter/U/9/Electricity_BUH_Total

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

I update the value every 5 seconds.

nicx, 2025-03-30:
Oh shit, is it case sensitive? I just saw I use a topic with a small "power" instead of "Power". Will try that with capital letter.

nicx, 2025-03-31:
Using case sensitive MQTT Topic works. So sorry, my fault.

Closed 2025-03-31.

Thread 166 (2025-01-15):

Freeze Protection for water piping

IamRFC1918, 2025-01-15:
Good morning,

im using the P1P2MQTT Project now for a few Months for reading Data and also Controlling my Altherma 3 Heatpump.

Im on the search for the "Freeze protection for Water piping" Information of the Heatpump. Unfortunately, the P1P2MQTT Bridge does not print out that Information.
If found in the Docs of the ESPAltherma Project (https://github.com/raomin/ESPAltherma/blob/main/doc/list%20registries.txt) this Information:

"|  19   |   0x60,2,300,1   | Freeze Protection for water piping"

Is it possible to teach the P1P2MQTT Bridge to get this Information bases on the string above? And if so, how can I do that?

Thank you for your Work and Help.

BR,

Frank

Arnold-n, 2025-01-15:
We can look for it if you (enable, "J3", and) log P1P2/R/# together with the ESPAltherma's Freeze Protection status, around the status change.

Thread 171 (2025-01-23):

Feature Request: Make "Flow Target" Editable via User Interface

paqpal, 2025-01-23:
Hi,

It would be great to have the ability to modify the **Flow Target** directly through the user interface. Currently, the system only allows viewing the parameters (8-0b, 8-0c, 8-0d) but not editing them.

**Benefits:**
- **Improved Automations:** Enables creating automations that better maintain the ΔT by adjusting the water flow, thus optimizing system performance.
- **Greater Control:** Helps maintain a more stable ΔT, increasing system efficiency and reliability.
- **User-Friendly:**

**Additional Consideration:**
It would also be preferable to allow customization of the climate curve in the future. However, this goes beyond the scope of the current request.

Thanks for your attention and the great work!

Paq

Arnold-n, 2025-01-24:
This is on the to-be-added list but I do not think it is a good idea to change this setting dynamically, because any field setting change requires a Daikin system restart. If you want to change the flow dynamically, you can have a look at [intergas_circulation_cap](https://github.com/reinier-vegter/intergas_circulation_cap).

paqpal, 2025-01-24:
Hi

Thank you for your assistance. I was initially considering modifying the pump speed only twice a day, but the solution you suggested appears to be a better approach.

-	I would also like to kindly suggest implementing the unit_of_measurement and device_class for entity HC_15_param Param15_Temperature_0A.

Currently, Home Assistant (HA) displays this parameter incorrectly in the history charts. According to Espaltherma, this parameter represents the refrigerant discharge temperature.

-	Additionally, I’m looking into the issue of the overshoot being stuck at 1°C. A technician from Daikin mentioned that this setting could be increased by configuring the system to heating-only mode.

However, I need to verify this approach.

-	My next step is to understand the Daikin defrost algorithm and attempt to tweak it, as the factory implementation seems too dumb.

I came across a user who developed an automation that tracks the running time and temperature to predict unnecessary defrost cycles.

This automation restarts the heat pump to reset the running time, with a 3-minute restart period being more effective than initiating a defrost cycle.

I'm not sure if this is within the scope of your project, but I thought it might be of interest.

Thank you again for your support, your device is helping a lot and decreased power consumption by 5kW/h a day.

Best regards,

Paq

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

Arnold-n, 2025-01-24:
Thanks - I'll add your Param15 info to the param15 work on the todo-list.

Hybrid systems unfortunately have a fixed 1C overshoot which cannot be increased (actually it is an overshoot of max 1.9C due to rounding).

Defrosting has my attention, as the hybrid systems have problems with it, though I am more concerned about the unit not defrosting when it is needed giving COPs down to 1.2. Requesting a defrost manually is already implemented as a HA button. Extending a defrost can only be done by timely off/on switching; not sure whether the cost of that is really less than accepting it. Newer full-electric systems have much better defrosting timing.

paqpal, 2025-01-24:
Well, here in northern Italy lot of people (including me) saw machines defrosting when there's no need.

Temp is around 2°C / -2°C.

Only one time I saw back radiator frosted.
Otherwise I could do my old trick to wrap outside sensor with a tiny foam, shifting outside temp by 2°C

Sent from Outlook for Android<https://aka.ms/AAb9ysg>

________________________________
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

Thread 174 (2025-01-26):

Altherma 3 wrong Leaving Water Temperature on systems without R2T sensor can be solved with "P43 1 / D5"

dededucinqun, 2025-01-26:
Hello,
On an Altherma 3, do you know why this value is wrong?

Is it because there is only one zone?
Thanks in advance

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

Arnold-n, 2025-01-26:
Your system does not have sensor R2T, you can configure the bridge to use R1T instead using command `P43 1` followed by `D5` to save.

dededucinqun, 2025-01-26:
Thanks a lot Arnold, I will do that

Closed 2025-03-30.

Thread 175 (2025-01-27):

climate.hc_room_room_heating  unavailable

dededucinqun, 2025-01-27:
Hello,
climate.hc_room_room_heating has become unavailable.
It worked perfectly and I could set the temperature as I wanted.
thanks. in advance

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

Arnold-n, 2025-01-27:
What is the value of `RW_LWT` (should be RT, not LWT) and `Control_Function` (should be on) ?

dededucinqun, 2025-01-27:
Thanks Arnold,

Indeed by putting RT, it got back to normal.
Sorry for the disturbance

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

Thread 176 (2025-01-28):

Sensor Request: Speed in RPM of outside unit compressor

nicx, 2025-01-28:
Beides the smart grid functionality I have one last sensor which I am missing to get completely rid of the additional ESPAltherma module: It is the speed of the compressor of the outside unit in RPM. Is it possible to have this sensor in P1P2MQTT, too?

Arnold-n, 2025-01-28:
So far I did not find the compressor RPM (or the fan frequency) in the P1/P2 data.

Suedschwede66, 2025-03-23:
HC_15_param Param15_Temperature_02 * 10 = Compressor RPM in U/min

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

nicx, 2025-03-24:
@Suedschwede66 cool, thank you!
@Arnold-n could you rename the entity and perhaps directly integrate the factor 10? with that done there would be no need for a helper anymore.

nicx, 2025-03-25:
@Arnold-n a short addition: the sensor value is "-0.1" when the Altherma heating is off. Maybe this could be set to "0" instead.

Arnold-n, 2025-03-30:
@nicx Thanks for your suggestions, implemented in v0.9.58rc16.

nicx, 2025-03-31:
Everything is working fine with the latest RC version. Thanks again @Arnold-n

Closed 2025-03-31.

Thread 177 (2025-01-28):

Sensor Request: Heating flow temperature setpoint value and actual value

nicx, 2025-01-28:
I am missing (or I just didn't find them) the sensors for the heating flow temperature. I don't know exactly how they are called in Englisch, in German it's called the "Vorlauftemperatur", which is the target temperature controlled by the configured heating curve.

I checked the sensor sensor.hc_lwt_lwt_setpoint, but it differs a lot to the ESPAltherma sensor for the LWT set point:

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

For the actual value I found no comparable sensor. Only sensor.hc_unknown_temperature_unknown_q could be a match:

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

Any hints?

forTT78, 2025-01-28:
Hi,
at my installation it's under sensor.hc_sensors_temperature_r2t_leaving_water

Best regards,
Thomas

forTT78, 2025-01-28:
Hi, it's the target temperature and depends on the ambient temperature (e.g. sensor.hc_sensors_temperature_outside_unit).
With out any averaging it will change as function of the outside temperature.

forTT78, 2025-01-28:
@nicx
> What we do know so far: The "Temperature_R2T_Leaving_Water" sensor is the **current** temperature of the heating water.
>
> My open main question is: Is the "LWT_Setpoint" sensor is the **target** temperature for the heating water. Is that correct?

Yes.

> In addition to this question my second question is: Why is the sensor value of "LWT_Setpoint" that different to the sensor values of the ESPAltherma pendant (see first two screenshot above)? And why is it updating so slowly in comparison?

From my understanding, the value from ESPAltherma looks more like the (internal) calculated value for target temperature, based on the heating curve and ambient temperature. For "LWT_Setpoint" I can set only whole numbers, no decimal numbers.

But I don't know exactly in which situation daikin uses one of the setpoint values first.

Arnold-n, 2025-01-28:
Indeed LWT_Setpoint is the target. On my hybrid system, it has an accuracy of 0.1C and is equal to ESPAltherma's output. On my EBLA monoblock, it has an accuracy of 1.0C and I do not yet know what ESPAltherma reports. Perhaps the data provided over P1/P2 is rounded by the Daikin unit for some units.

Arnold-n, 2025-01-29:
Mine is an older EHYHBX08AAV3 from 2014, a hybrid heat pump/gas boiler system in cascade. I think your system is an integrated heating/DHW boiler system but not 'hybrid' in the sense of being a heat pump/gas boiler?

nicx, 2025-01-29:
@Arnold-n you are right, it's not "hybrid" in that sense of being. :)

nicx, 2025-03-31:
@Arnold-n I would like to bring this topic up again. what could be the reason that ESPAltherma reports in 0.1 steps, but P1P2 only in 1.0 steps? Is there any way to change this?

BTW: All other P1P2 temperature sensors of my Altherma are reporting in 0.1 steps, only this single one "sensor.hc_lwt_lwt_setpoint" has this other behavior.

Closed 2025-05-12.

Thread 185 (2025-03-16):

Heating Off mode not working - Altherma ELBH12EF9W - Home Assistant

Sonusss, 2025-03-16:
Hi,

Having settled heating to off mode from HP LWT  (climate.hc_lwt_abs_heating) thermostat the heat pump keeps on working.

The Altherma unit is **not** settled to use external contact.

I tried also to set the Altherma to use external thermostat but then got an error on Altherma display about missing thermostat.

Is there a specific "hc" entity to manage general on-off operation ?

Arnold-n, 2025-03-16:
Both the climate entity and the Altherma_On button are to switch the general on-off operation.

Which Daikin system do you have and at which outside temperature did this occur? Sometimes this is normal behaviour due to defrost protection, and in some cases the LWT target is higher in defrost protection mode than it is in normal operation mode.

It could also be running out of write budget of the bridge, which you can resolve by restarting (with button Restart_P1P2Monitor_ATmega), by reducing writes and/or by reducing the Write_Budget_Period (if this is 60, you can do one parameter write/60 minutes, and one on/off action counts as 3 parameter writes).

As for external thermostat, ([C-07] = 2), you can enable the bridge to report a fake sensor temperature with the 'F' command which should resolve the missing thermostat message.

Sonusss, 2025-03-16:
Indoor unit:
ELBH12EF9W
software: 22009C01
EEprom: 1709433-12

Outdoor unit:
ERRA10EV3
Software: 18000211

When I  Restart_P1P2Monitor_ATmega  I got directly  HC_Bridge Error_Budget = 10 normal ?

Outside temp is not very cold, around 10°C

A strange thing is HC_LWT2 LWT_Setpoint_Add is changing a lot without any action on my side...

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

Arnold-n, 2025-03-16:
At 10C and not being a monoblock, frost protection is not likely the cause.

An error budget of 10 at ATmega restart, increasing afterwards, is perfectly normal. Only if it decreases, it is a sign of interface issues.

The LWT2_Add shows a weather-dependent target for the 2nd zone and the jumps also likely due to a clock program (day/night difference), looks OK to me. It's not useful unless you have two zones.

Did the restart/write budget solve your issue?

Sonusss, 2025-03-18:
No, the Restart_P1P2Monitor_ATmega didn't fix my issue.
I don't have a second heating zone.

At this stage, I need to check Altherma unit settings but it can't be done before April.
I'm away from home, this is why I'd like to switch heating OFF.

Will come back.

Arnold-n, 2025-03-19:
Even without 2nd heating zone the heat pump still calculates the LWT target, but never uses it.

Do other settings (LWT target change / RT target change) still work? Is Control_Function still ON?

Sonusss, 2025-03-20:
The external unit compressor is OFF for more than two days now but I'm not sure if this is due to control command or due to warm outside temperature conditions in the meanwhile.

It needs to be investigated further when I'm back home...

Sonusss, 2025-04-20:
I made some extra tests and finally it seems that Onecta Cloud is overriding P1P2MQTT ON/OFF command with it's own states

Sonusss, 2025-04-22:
After a while the problem comes back without any Cloud/Internet connectivity.
Looks to be really connected to write budget, but I'm really confused about write parameters...
"HC_Bridge Write_Budget" value is this:
- Number of commands
- Number of bytes transmitted

In the course to allow a dynamic control I settled Write Budget to 12 and Write Budget Period to 30 is it safe ?
I understand that this is made to spare the EEprom but in this case isn't it better to use the external physical switch for ON/OFF control ?

And finally what is the purpose of: HC_Bridge Counter_Request_Function ?

Arnold-n, 2025-04-22:
The write budget is the number of parameter writes. Some actions, like on/off, write to 3 parameters at the same time.

For E-series I do think it is safe to increase the max number of writes - Onecta does not warn at all against too many actions, the only public warning relates to the older airco units. I am using a period of 15 (minutes) myself.

Counter_Request_Function ensures that all counters (kWh/hours) are requested each minute. If not active, reported counter values can quickly become outdated.

Sonusss, 2025-04-23:
Many thanks for your clarification !

Closed 2025-04-23.

Thread 188 (2025-03-24):

Sensor Request: Inverter primary current in Ampere

nicx, 2025-03-24:
Is ist possible to get the Inverter primary current in Ampere as a sensor? With that value, it's easy to calculate the current power consumption of the Altherma. I'll do it in the same way with ESPAltherma, where the sensor is existing (register {0x21,0,105,2,-1,"INV primary current (A)"})

This is the current template in HA which could be adopted to P1P2: `{{ ( state_attr('sensor.althermasensors','INV Primärstrom (A)')  | float * 230 | float(0) ) | round(0, default=0) }}`

nicx, 2025-03-24:
I thing I found the corresponding sensor: sensor.hc_15_param_param15_temperature_10 is it! :)

@Arnold-n could you rename it in a future version? thanks!

nicx, 2025-03-24:
@Arnold-n In addition to the renaming of the sensor would it be possible to add an automatically calculated power sensor with the voltage of 230V to P1P2? That would make the HA template sensor and the automation for pushing that value via MQTT to the topic P1P2/P/meter/U/9/Electricity_Power obsolete when not using an external power sensor.

nicx, 2025-03-25:
@Arnold-n a short addition: the sensor value is "-0.1" when the Altherma heating is off. Maybe this could be set to "0" instead.

buennerbernd, 2025-03-26:
@nicx This is a cool observation.

My Altherma 3 H HT is connected by 3 phases.
3 * 230 * Param15_Temperature_10
would rather fit to the power consumption of the house in my case.

nicx, 2025-03-26:
@buennerbernd you are right... should be configurable then, or the template sensor is unavoidable after all.

buennerbernd, 2025-03-26:
I have observed the calculated power over the day. It fits very good to the power consumption of the house.
Perhaps the result of 3 * 230 * Param15_Temperature_10 is 50 or 100 Watt too high, but it is good enough.

With that knowledge I was able to integrate the heat pump into the solar charging tool evcc by MQTT. (evcc is currently leraning to control SG Ready heatpumps.)
Now I'm able to see the consumption there and I would be happy if we would get the SG Ready functionality running, to control it.

See https://docs.evcc.io/en/docs/devices/heating

nicx, 2025-03-26:
@buennerbernd same for me, I currently use EVCC with ESPAltherma for switching the SGready modes. Works great. When the SG feature is working in P1P2 I could get rid of the additional ESPAltherme module :)

DiabloVmax1200, 2025-03-26:
I can confirm this as well for the Geo Variant. The Param15_Temperature_10 seems to be the amps - I only have a single Phase compressor

buennerbernd, 2025-03-27:
Now we have the open question, if the backup heating has its own sensor.

nicx, 2025-03-27:
@buennerbernd no open question, its already answered: https://github.com/Arnold-n/P1P2MQTT/issues/164

Arnold-n, 2025-03-30:
@nicx Thanks for your info - new param15 sensors are added in v0.9.58rc16, and if external meter input is missing, the power consumption will be based on the current info from param15, multiplied by new configurable parameters for voltage (P49, default 230V) and nr of phases (P50, default 1).

nicx, 2025-03-30:
@Arnold-n great, your are the best! will tray it and give feedback.

btw: could you implement a similar calculation for the BUH power consumption? (see https://github.com/Arnold-n/P1P2MQTT/issues/164#issuecomment-2764469486)
In my opinion this should be very easy: we need 2 more configurable parameters (watt usage for buh step 1, and watt usage for buh step 2). in my case its 3000w for step 1, and 6000w for step 2. I have a 9kW buh. With this values configured, they could be just used for the power sensor when the buh sensors are on.

if buh1 is on then buh power consumption is set to 3000w.
if buh2 is on then buh power consumption is set to 3000w+6000w=9000w.

Arnold-n, 2025-03-30:
@nicx Added in v0.9.58rc17. P51/P52 re used to configure power of BUH step1/2. My "3kW" BUH actually uses only ~2.9kW.

nicx, 2025-03-31:
Everything is working fine with the latest RC version. Thanks again @Arnold-n

buennerbernd, 2025-04-01:
@Arnold-n Thank you for that implementation, I have tested this at my Altherma 3 H HT with v0.9.58rc19.

If we had also a C/9/Consumption_Total, it would be even easier to use this directly in evcc.

nicx, 2025-04-03:
@Arnold-n an additional,sensor,for the overall consumption would be great.
@buennerbernd I am using the calc plugin in evcc to sum/add both values of the buh and the heatpump: https://docs.evcc.io/docs/devices/plugins#calc

buennerbernd, 2025-04-04:
@nicx Thank you for that hint, I also had this idea.
The reason why I'm ignoring the Consumption_BUH so for is that the MQTT topics are only updated when they change.
I don't remember if I have configured this by myself.
The Consumption_BUH is most time 0 and is rarely updatet so evcc complains always after a restart that the value is outdated.

Closed 2025-03-31.

Thread 197 (2025-05-02):

Feature Request: Support Altherma 4

joklee, 2025-05-02:
Hi, very nice project.

Do you see a possibility of supporting the Altherma 4? The Altherma 4 also supports Madoka via P1/P2. I'm commissioning an Altherma 4 with ech2O in the next few weeks and could provide support. I'm a software developer, so basic knowledge is a must. :D

[plan.pdf](https://github.com/user-attachments/files/20018172/plan.pdf)

Arnold-n, 2025-05-02:
Would love to see if it works with the Altherma 4 or if the code needs to be modified. From the Altherma 4 manuals it seems that the field settings have been changed completely, and I am not sure how many other changes were made to the protocol. Would be happy to support you if you'd like to try!

joklee, 2025-05-04:
Great, I would love to try it. I'll send you a purchase email right away.

mhuijgen, 2025-08-19:
@joklee Did you managed to get any data from the Altherma 4 yet?

VmaxTurbo, 2025-08-22:
I recently installed the Altherma 4. EPBX10A4V indoor unit, EPSK06AV3 outdoor unit, EKHWSP200D3V3 boiler tank, and Madoka thermostat. The WiFi module via onecta provides me with various sensors in Home Assistant. ESPAltherma doesn't provide me the correct sensors and values.

I have already played around a lot with all (403) known (ESPAltherma) registers, but I have a lot of wrong values for various (needed) sensors like;

Inlet water temp. (R4T): 0
DHW tank temp. (R5T): -40.6
Indoor ambient temp. (R1T): 0.4
Ext. outdoor ambient sensor (R6T): 0

Does anyone have any idea how I can find the correct registers and/or values for an Altherma 4?

The P1P2MQTT would be preferable, because I want being able to switch the DHW heater while energy prices are low to none.

Thread 198 (2025-05-12):

Wrong accuracy of sensor sensor.hc_lwt_lwt_setpoint

nicx, 2025-05-12:
As already recognized [here](https://github.com/Arnold-n/P1P2MQTT/issues/177) there seems a bug in the accuracy of the sensor sensor.hc_lwt_lwt_setpoint. It only shows values in 1.0 steps, but not in 0.1 steps (as all other temperature sensors do).

Why do I think this is a bug? Because when I compare it to the corresponding sensor of LWT2 the behavior differs: sensor.hc_lwt2_lwt_setpoint_add is showing values correctly in 0.1 steps.

sensor.hc_lwt_lwt_setpoint:
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

sensor.hc_lwt2_lwt_setpoint_add:
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

Arnold-n, 2025-05-16:
It seems some Daikin models only report the setpoints in 1.0C resolution, even though the underlying data is capable of reporting in 0.1C resolution. Not sure if Daikin would call this a feature or a bug...

nicx, 2025-05-17:
@Arnold-n I am just wondering because all other sensors of P1P2 are in 0.1 resolution, and even ESPAltherma reports this explicit value in 0.1 resolution.

Thread 208 (2025-06-08):

ESP crashes WIFI of ASUS router

buennerbernd, 2025-06-08:
Hi Arnold,

unfortunately ASUS routers sometimes struggle with ESP devices. This is also the case with the P1P2 bridge. That means the 2.4 GHz WIFI is broken until the router is restarted.
I have observed that the very last MQTT message that is received is always L_039: offline

Here are some logs out of FHEM before this happened:

```
2025-06-08_08:19:51 MQTT2_P1P2_039 M_9_Date_Time_Daikin: Su 2025-06-08 08:19:38
2025-06-08_08:19:52 MQTT2_P1P2_039 S_039: * [ESP] 2025-06-08 08:19:52 Uptime 86340
2025-06-08_08:19:52 MQTT2_P1P2_039 M_9_Date_Time_Daikin: Su 2025-06-08 08:19:39
2025-06-08_08:19:54 MQTT2_P1P2_039 M_9_Date_Time_Daikin: Su 2025-06-08 08:19:41
2025-06-08_08:19:56 MQTT2_P1P2_039 M_9_Date_Time_Daikin: Su 2025-06-08 08:19:43
2025-06-08_08:19:59 MQTT2_P1P2_039 M_9_Date_Time_Daikin: Su 2025-06-08 08:19:46
2025-06-08_08:20:00 MQTT2_P1P2_039 M_039_A: 0800201609005C00FFFFFF00E52D0000098E000000000000000000000050C0410000684100A0C3410000000000031100C01400000300000058022602FA00BC02FA00DC004600DC004600AA00F00096005E01012E133F3F0A00000050544A460000000000000000000000000000000000000000000000643C000014000000000001000000000093000000000000000016004004000000001400402C0015E600000000000000000000000000000000000000000000000000000000000000000000000000000000C000000000000000000000000000000000003200140019001400000000000000000000000000000064000064000000000000000000000000000000000000000000000000000000000000000020000000000000000000000000000000000000000000000000000000000000000000000000000000000000000000000000000000000000000000000000000000000000000000000000000000000000000000000000000000000000000000000000000000000000000000000000000000000000000000000000000000000000000000000000000000000000000000000000000000000000000000000000000000000000000000000000000000000000000000000000000000000000000000000000000000000000000000000000000000000000000000000000000000000000000000000000000000000000000000
2025-06-08_08:20:00 MQTT2_P1P2_039 M_9_Date_Time_Daikin: Su 2025-06-08 08:19:47
2025-06-08_08:20:02 MQTT2_P1P2_039 S_039: * [ESP] 2025-06-08 08:20:02 Uptime 86350
2025-06-08_08:20:02 MQTT2_P1P2_039 M_9_Date_Time_Daikin: Su 2025-06-08 08:19:49
2025-06-08_08:20:04 MQTT2_P1P2_039 M_9_Date_Time_Daikin: Su 2025-06-08 08:19:51
2025-06-08_08:20:07 MQTT2_P1P2_039 M_9_Date_Time_Daikin: Su 2025-06-08 08:19:54
2025-06-08_08:20:08 MQTT2_P1P2_039 M_9_Date_Time_Daikin: Su 2025-06-08 08:19:55
2025-06-08_08:20:10 MQTT2_P1P2_039 M_9_Date_Time_Daikin: Su 2025-06-08 08:19:57
2025-06-08_08:20:12 MQTT2_P1P2_039 M_9_Date_Time_Daikin: Su 2025-06-08 08:19:59
2025-06-08_08:20:12 MQTT2_P1P2_039 S_039: * [ESP] 2025-06-08 08:20:12 Uptime 86360
2025-06-08_08:20:15 MQTT2_P1P2_039 M_9_Date_Time_Daikin: Su 2025-06-08 08:20:02
2025-06-08_08:20:16 MQTT2_P1P2_039 M_9_Date_Time_Daikin: Su 2025-06-08 08:20:03
2025-06-08_08:20:18 MQTT2_P1P2_039 M_9_Date_Time_Daikin: Su 2025-06-08 08:20:05
2025-06-08_08:20:20 MQTT2_P1P2_039 M_9_Date_Time_Daikin: Su 2025-06-08 08:20:07
2025-06-08_08:20:22 MQTT2_P1P2_039 S_039: * [ESP] 2025-06-08 08:20:22 Uptime 86370
2025-06-08_08:20:23 MQTT2_P1P2_039 M_9_Date_Time_Daikin: Su 2025-06-08 08:20:10
2025-06-08_08:20:24 MQTT2_P1P2_039 M_9_Date_Time_Daikin: Su 2025-06-08 08:20:11
2025-06-08_08:20:26 MQTT2_P1P2_039 M_9_Date_Time_Daikin: Su 2025-06-08 08:20:13
2025-06-08_08:20:28 MQTT2_P1P2_039 M_1_Param15_09: 140
2025-06-08_08:20:28 MQTT2_P1P2_039 M_9_Date_Time_Daikin: Su 2025-06-08 08:20:15
2025-06-08_08:20:29 MQTT2_P1P2_039 A_8_V_Interface: 14.8
2025-06-08_08:20:31 MQTT2_P1P2_039 M_9_Date_Time_Daikin: Su 2025-06-08 08:20:18
2025-06-08_08:20:31 MQTT2_P1P2_039 A_8_V_Interface: 14.7
2025-06-08_08:20:32 MQTT2_P1P2_039 S_039: * [ESP] 2025-06-08 08:20:32 Uptime 86380
2025-06-08_08:20:32 MQTT2_P1P2_039 M_9_Date_Time_Daikin: Su 2025-06-08 08:20:19
2025-06-08_08:20:34 MQTT2_P1P2_039 M_9_Date_Time_Daikin: Su 2025-06-08 08:20:21
2025-06-08_08:20:36 MQTT2_P1P2_039 M_9_Date_Time_Daikin: Su 2025-06-08 08:20:23
2025-06-08_08:20:37 MQTT2_P1P2_039 A_8_V_Interface: 14.8
2025-06-08_08:20:39 MQTT2_P1P2_039 M_9_Date_Time_Daikin: Su 2025-06-08 08:20:26
2025-06-08_08:20:39 MQTT2_P1P2_039 A_8_V_Interface: 14.7
2025-06-08_08:20:40 MQTT2_P1P2_039 M_9_Date_Time_Daikin: Su 2025-06-08 08:20:27
2025-06-08_08:20:42 MQTT2_P1P2_039 S_039: * [ESP] 2025-06-08 08:20:42 Uptime 86390
2025-06-08_08:20:42 MQTT2_P1P2_039 M_9_Date_Time_Daikin: Su 2025-06-08 08:20:29
2025-06-08_08:20:44 MQTT2_P1P2_039 M_9_Date_Time_Daikin: Su 2025-06-08 08:20:31
2025-06-08_08:20:45 MQTT2_P1P2_039 A_8_V_Interface: 14.8
2025-06-08_08:20:47 MQTT2_P1P2_039 M_9_Date_Time_Daikin: Su 2025-06-08 08:20:34
2025-06-08_08:20:47 MQTT2_P1P2_039 L_039: offline
```

I have noticed that the ESP Uptime is exactly 24h, so I checked the logs 24 hours before:

```
2025-06-07_05:15:54 MQTT2_P1P2_039 S_039: * [ESP] 2025-06-07 05:15:54 Uptime 248000
2025-06-07_05:15:56 MQTT2_P1P2_039 M_9_Date_Time_Daikin: Sa 2025-06-07 05:15:43
2025-06-07_05:15:58 MQTT2_P1P2_039 M_9_Date_Time_Daikin: Sa 2025-06-07 05:15:45
2025-06-07_05:16:00 MQTT2_P1P2_039 M_039_A: 0800201609005C00FFFFFF00E52D0000098E0000000000000000000000C0C541000090410060C9410000000000031100C01400000300000058022602FA00BC02FA00DC004600DC004600AA00F00096005E01012D0F3F3F0A00000050544A460000000000000000000000000000000000000000000000643C000014000000000001000000000093000000000000000015004004000000001400403400161A00000000000000000000000000000000000000000000000000000000000000000000000000000000C000000000000000000000000000000000003200140019001400150000000000000000000000000064000064000000000000000000000000000000000000000000000000000000000000000020000000000000000000000000000000000000000000000000000000000000000000000000000000000000000000000000000000000000000000000000000000000000000000000000000000000000000000000000000000000000000000000000000000000000000000000000000000000000000000000000000000000000000000000000000000000000000000000000000000000000000000000000000000000000000000000000000000000000000000000000000000000000000000000000000000000000000000000000000000000000000000000000000000000000000000000000000000000000000000
2025-06-07_05:16:00 MQTT2_P1P2_039 M_9_Date_Time_Daikin: Sa 2025-06-07 05:15:47
2025-06-07_05:16:02 MQTT2_P1P2_039 M_9_Date_Time_Daikin: Sa 2025-06-07 05:15:49
2025-06-07_05:16:04 MQTT2_P1P2_039 M_9_Date_Time_Daikin: Sa 2025-06-07 05:15:51
2025-06-07_05:16:04 MQTT2_P1P2_039 S_039: * [ESP] 2025-06-07 05:16:04 Uptime 248010
2025-06-07_05:16:06 MQTT2_P1P2_039 M_9_Date_Time_Daikin: Sa 2025-06-07 05:15:53
2025-06-07_05:16:08 MQTT2_P1P2_039 M_9_Date_Time_Daikin: Sa 2025-06-07 05:15:55
2025-06-07_05:16:10 MQTT2_P1P2_039 M_9_Date_Time_Daikin: Sa 2025-06-07 05:15:57
2025-06-07_05:16:12 MQTT2_P1P2_039 M_9_Date_Time_Daikin: Sa 2025-06-07 05:15:59
2025-06-07_05:16:14 MQTT2_P1P2_039 S_039: * [ESP] 2025-06-07 05:16:14 Uptime 248020
2025-06-07_05:16:14 MQTT2_P1P2_039 M_9_Date_Time_Daikin: Sa 2025-06-07 05:16:01
2025-06-07_05:16:16 MQTT2_P1P2_039 M_9_Date_Time_Daikin: Sa 2025-06-07 05:16:03
2025-06-07_05:16:18 MQTT2_P1P2_039 M_9_Date_Time_Daikin: Sa 2025-06-07 05:16:05
2025-06-07_05:16:20 MQTT2_P1P2_039 M_9_Date_Time_Daikin: Sa 2025-06-07 05:16:07
2025-06-07_05:16:22 MQTT2_P1P2_039 M_9_Date_Time_Daikin: Sa 2025-06-07 05:16:09
2025-06-07_05:16:24 MQTT2_P1P2_039 M_9_Date_Time_Daikin: Sa 2025-06-07 05:16:11
2025-06-07_05:16:24 MQTT2_P1P2_039 S_039: * [ESP] 2025-06-07 05:16:24 Uptime 248030
2025-06-07_05:16:26 MQTT2_P1P2_039 M_9_Date_Time_Daikin: Sa 2025-06-07 05:16:13
2025-06-07_05:16:28 MQTT2_P1P2_039 M_9_Date_Time_Daikin: Sa 2025-06-07 05:16:15
2025-06-07_05:16:29 MQTT2_P1P2_039 L_039: offline
2025-06-07_08:20:52 MQTT2_P1P2_039 L_039: online
2025-06-07_08:20:52 MQTT2_P1P2_039 S_039: * [ESP]                     Subscribed to P1P2/W result 2
2025-06-07_08:20:52 MQTT2_P1P2_039 S_039: * [ESP]                     Subscribed to P1P2/W/039 result 3
2025-06-07_08:20:52 MQTT2_P1P2_039 S_039: * [ESP]                     Subscribed to homeassistant/status
2025-06-07_08:20:52 MQTT2_P1P2_039 S_039: * [ESP]                     Subscribed to P1P2/P/meter/U/9/Electricity_Power
2025-06-07_08:20:52 MQTT2_P1P2_039 S_039: * [ESP]                     Subscribed to P1P2/P/meter/U/9/Electricity_Total
2025-06-07_08:20:52 MQTT2_P1P2_039 S_039: * [ESP]                     Subscribed to P1P2/P/meter/U/9/Electricity_BUH_Power
2025-06-07_08:20:52 MQTT2_P1P2_039 S_039: * [ESP]                     Subscribed to P1P2/P/meter/U/9/Electricity_BUH_Total
2025-06-07_08:20:52 MQTT2_P1P2_039 S_039: * [ESP]                     AVRISP: ATmega programming: avrdude -c avrisp -p atmega328p -P net:192.168.178.39:328 -t # or -U ...
2025-06-07_08:20:52 MQTT2_P1P2_039 S_039: * [ESP]                     Telnet setup OK
2025-06-07_08:20:53 MQTT2_P1P2_039 S_039: * [ESP]                     Config NTP server with predefined TZ string CET-1CEST,M3.5.0/02,M10.5.0/03
2025-06-07_08:20:55 MQTT2_P1P2_039 S_039: * [ESP]                     Mqtt readback A failed (time-out), init data ..
2025-06-07_08:20:55 MQTT2_P1P2_039 S_039: * [ESP]                     loadRTC readback OK
2025-06-07_08:20:55 MQTT2_P1P2_039 S_039: * [ESP]                     Setup ready
2025-06-07_08:20:55 MQTT2_P1P2_039 S_039: * [ESP]                     P1P2MQTT bridge v0.9.58rc19
2025-06-07_08:20:55 MQTT2_P1P2_039 S_039: * [ESP]                     Compiled Mar 31 2025 21:47:39 for Daikin E-Series
2025-06-07_08:20:55 MQTT2_P1P2_039 S_039: * [ESP]                     IPv4 address: 192.168.178.39
2025-06-07_08:20:55 MQTT2_P1P2_039 S_039: * [ESP]                     MAC address STA: ac: b:fb:da:c0:46
2025-06-07_08:20:55 MQTT2_P1P2_039 S_039: * [ESP]                     MAC address  AP: ae: b:fb:da:c0:46
2025-06-07_08:20:55 MQTT2_P1P2_039 S_039: * [ESP]                     Connected to MQTT server
2025-06-07_08:20:55 MQTT2_P1P2_039 M_039_A: 0800201609005C00FFFFFF00E52D0000098E0000000000000000000000C0C541000090410060C9410000000000041100C01400000300000058022602FA00BC02FA00DC004600DC004600AA00F00096005E01010F103F3F0A00000050544A46000000000000000000000000000000000000000000000000000000000000000000000000000000000000000000000000000000000000000000000000000000000000000000000000000000000000000000000000000000000000000000000000000000000000000000000000000000000000000000000000000000000000000000000000000000000000000000000000000000000000000000000000000000000000000000000000000000000000000000000000000000000000000000000000000000000000000000000000000000000000000000000000000000000000000000000000000000000000000000000000000000000000000000000000000000000000000000000000000000000000000000000000000000000000000000000000000000000000000000000000000000000000000000000000000000000000000000000000000000000000000000000000000000000000000000000000000000000000000000000000000000000000000000000000000000000000000000000000000000000000000000000000000000000000000000000000000000000000000000
2025-06-07_08:20:55 MQTT2_P1P2_039 M_039_B: 0000000000000000000000000000000000000000000000000000000000000000000000000000000000000000000000000000000000000000000000000000000000000000000000000000000000000000000000000000000000000000000000000000000000000000000000000000000000000000000000000000000000000000000000000000000000000000000000000000000000000000000000000000000000000000000000000000000000000000000000000000000000000000000000000000000000000000000000000000000000000000000000000000000000000000000000000000000000000000000000000000000000000000000000000000000000000000000000000000000000000000000000000000000000000000000000000000000000000000000000000000000000000000000000000000000000000000000000000000000000000000000000000000000000000000000000000000000000000000000000000000000000000000000000000000000000000000000000000000000000000000000000000000000000000000000000000000000000000000000000000000000000000000000000000000000000000000000000000000000000000000000000000000000000000000000000000000000000000000000000000000000000000000000000000000000000000000000000000000000000000000
2025-06-07_08:20:55 MQTT2_P1P2_039 M_039_C: 0000000000000000000000000000000000000000000000000000000000000000000000000000000000000000000000000000000000000000000000000000000000000000000000000000000000000000000000000000000000000000000000000000000000000000000000000000000000000000000000000000000000000000000000000000000000000000000000000000000000000000000000000000000000000000000000000000000000000000000000000000000000000000000000000000000000000000000000000000000000000000000000000000000000000000000000000000000000000000000000000000000000000000000000000000000000000000000000000000000000000000000000000000000000000000000000000000000000000000000000000000000000000000000000000000000000000000000000000000000000000000000000000000000000000000000000000000000000000000000000000000000000000000000000000000000000000000000000000000000000000000000000000000000000000000000000000000000000000000000000000000000000000000000000000000000000000000000000000000000000000000000000000000000000000000000000000000000000000000000000000000000000000000000000000000000000000000000000000000000000000000
2025-06-07_08:20:55 MQTT2_P1P2_039 M_039_K: 00000000000000000000000000000000000000000000000000000000000000000000000000000000000000000000000000000000000000000000000000000000000000000000000000000000000000000000000000000000000000000000000000000000000000000000000000000000000000000000000000000000000000000000000000000000000000000000000000000000000000000000000000000000000000000000000000000000000000000000000000000000000000000000000000000000000000000000000000000000000000000000000000000000000000000000000000000000000000000000000000000000000000000000000000000000000000000000000000000000000000000000000000000000000000000000000000000000000000000000000000000000000000000000000000000000000000000000000000000000000000000000000000000000000000000000000000000000000000000000000000000000000000000000000000000000000000000000000000000000000000000000000000000000000000000000000000000000000000000000000000000000000000000000000000000000000000000000000000000000000000000000000000000000000000000000000000FFFFFFFFFFFFFFFFFFFFFFFFFFFFFFFFFFFFFFFFFFFFFFFFFFFFFFFFFFFFFFFFFFFFFFFF00000000000000
2025-06-07_08:20:56 MQTT2_P1P2_039 M_039_L: 0000000000000000000000000000000000000000000000000000000000000000
2025-06-07_08:20:56 MQTT2_P1P2_039 S_039: * [ESP] 2025-06-07 08:20:55 < Loaded EEPROM_version 9
2025-06-07_08:20:56 MQTT2_P1P2_039 uniq_id: 039_bridge0_S9_ESP_EEPROM_Saved_9
2025-06-07_08:20:56 MQTT2_P1P2_039 name: ESP_EEPROM_Saved
2025-06-07_08:20:56 MQTT2_P1P2_039 dev_name: bridge0_Bridge
2025-06-07_08:20:56 MQTT2_P1P2_039 dev_ids_1: bridge0_Bridge
2025-06-07_08:20:56 MQTT2_P1P2_039 stat_t: P1P2/P/039/S/9/ESP_EEPROM_Saved
2025-06-07_08:20:56 MQTT2_P1P2_039 name: ESP_Factory_Reset_Scheduled
2025-06-07_08:20:56 MQTT2_P1P2_039 uniq_id: 039_bridge0_S9_ESP_Factory_Reset_Scheduled_9
2025-06-07_08:20:56 MQTT2_P1P2_039 stat_t: P1P2/P/039/S/9/ESP_Factory_Reset_Scheduled
2025-06-07_08:20:56 MQTT2_P1P2_039 name: ESP_Waiting_For_Counters_D13
2025-06-07_08:20:56 MQTT2_P1P2_039 uniq_id: 039_bridge0_S9_ESP_Waiting_For_Counters_D13_9
2025-06-07_08:20:56 MQTT2_P1P2_039 stat_t: P1P2/P/039/S/9/ESP_Waiting_For_Counters_D13
2025-06-07_08:20:56 MQTT2_P1P2_039 pl_on: P47 1
2025-06-07_08:20:56 MQTT2_P1P2_039 name: HA_Setup
2025-06-07_08:20:56 MQTT2_P1P2_039 dev_name: bridge0_Setup
2025-06-07_08:20:56 MQTT2_P1P2_039 uniq_id: 039_bridge0_A9_HA_Setup_9
2025-06-07_08:20:56 MQTT2_P1P2_039 stat_t: P1P2/P/039/A/9/HA_Setup
2025-06-07_08:20:56 MQTT2_P1P2_039 pl_off: P47 0
2025-06-07_08:20:56 MQTT2_P1P2_039 dev_ids_1: bridge0_Setup
2025-06-07_08:20:56 MQTT2_P1P2_039 pl_off: 0
2025-06-07_08:20:56 MQTT2_P1P2_039 stat_t: P1P2/P/039/S/9/Heating_Only
2025-06-07_08:20:56 MQTT2_P1P2_039 dev_ids_1: bridge0_Mode
2025-06-07_08:20:56 MQTT2_P1P2_039 dev_name: bridge0_Mode
2025-06-07_08:20:56 MQTT2_P1P2_039 name: Heating_Only
2025-06-07_08:20:56 MQTT2_P1P2_039 pl_on: 1
2025-06-07_08:20:56 MQTT2_P1P2_039 uniq_id: 039_bridge0_S9_Heating_Only_9
2025-06-07_08:20:56 MQTT2_P1P2_039 stat_t: P1P2/P/039/S/9/ESP_Throttling
2025-06-07_08:20:56 MQTT2_P1P2_039 dev_ids_1: bridge0_Bridge
2025-06-07_08:20:56 MQTT2_P1P2_039 name: ESP_Throttling
2025-06-07_08:20:56 MQTT2_P1P2_039 dev_name: bridge0_Bridge
2025-06-07_08:20:56 MQTT2_P1P2_039 uniq_id: 039_bridge0_S9_ESP_Throttling_9
2025-06-07_08:20:56 MQTT2_P1P2_039 S_9_ESP_Throttling: 1
2025-06-07_08:20:56 MQTT2_P1P2_039 name: WiFi_RSSI
2025-06-07_08:20:56 MQTT2_P1P2_039 uniq_id: 039_bridge0_A9_WiFi_RSSI_9
2025-06-07_08:20:56 MQTT2_P1P2_039 stat_t: P1P2/P/039/A/9/WiFi_RSSI
2025-06-07_08:20:56 MQTT2_P1P2_039 A_9_WiFi_RSSI: -58
2025-06-07_08:20:56 MQTT2_P1P2_039 S_039: * [ESP] 2025-06-07 08:20:56 < ESP reboot reason: wifiManager after WiFi connect failed
2025-06-07_08:20:56 MQTT2_P1P2_039 S_039: * [MON] 2025-06-07 08:20:56 0DE00FFFFFFFFFFFFFFFFFFFFFFFFFFFFFFFFBA
2025-06-07_08:20:56 MQTT2_P1P2_039 S_039: * [ESP] 2025-06-07 08:20:56 < No ethernet hardware detected
2025-06-07_08:20:56 MQTT2_P1P2_039 S_039: * [ESP] 2025-06-07 08:20:56 < Connected to WiFi
2025-06-07_08:20:56 MQTT2_P1P2_039 S_039: * [ESP] 2025-06-07 08:20:56 < MQTT client connected
2025-06-07_08:20:56 MQTT2_P1P2_039 stat_t: P1P2/P/039/A/8/Control_Function
2025-06-07_08:20:56 MQTT2_P1P2_039 pl_off: L0
2025-06-07_08:20:56 MQTT2_P1P2_039 uniq_id: 039_bridge0_A8_Control_Function_8
2025-06-07_08:20:56 MQTT2_P1P2_039 pl_on: L1
2025-06-07_08:20:56 MQTT2_P1P2_039 name: Control_Function
2025-06-07_08:20:56 MQTT2_P1P2_039 pl_off: C0
2025-06-07_08:20:56 MQTT2_P1P2_039 stat_t: P1P2/P/039/A/8/Counter_Request_Function
2025-06-07_08:20:56 MQTT2_P1P2_039 name: Counter_Request_Function
2025-06-07_08:20:56 MQTT2_P1P2_039 pl_on: C2
```

Do you have an idea what happened here? Something that could kill the WIFI?
Why is it exactly 24h after the last reboot?
Why is there a 3 hours gap between L_039: offline and online yesterday?

Thank you, Stefan.

Arnold-n, 2025-06-08:
Hi Stefan, do you have any references to the Asus-ESP problems? Not sure what happens here, but I expect it's a problem on the Asus side - even if a client would misbehave, this should not cause the AP to crash.

That "offline" is always the last message is because that message is not transmitted by the ESP as last transmission. If the ESP disconnects too long from the MQTT server, the MQTT server will transmit a message preconfigured by the ESP, a so-called "will message".

buennerbernd, 2025-06-10:
Hello Arnold,

thank you for your answers. I didn't know the concept of last will in MQTT. That explains the offline message.
I agree that this is an ASUS issue. In the internet I found a lot of hints to solve this (changed settings in the router), but nothing really helped.
So far I have set a static IP in the router, but I will try it with a static IP in the bridge. Thank you for that idea!
I will give feedback if this helps a longer time.

buennerbernd, 2025-06-17:
Hi Arnold, regarding the DHCP lease you are right. The default in my router was 1 day. I have extended this to 7 days to reduce the problems with IOT devices.

In the P1P2 bridge I have set a static IP via telnet. I have also aligned the gateway. I hope this was correct:

```
[ESP] 2025-06-17 10:32:11 P03: use static-IP (0=DHCP)   is 1
[ESP] 2025-06-17 10:32:11 P04: static-IP IPv4 address   is 192.168.178.39
[ESP] 2025-06-17 10:32:11 P05: static-IP IPv4 gateway   is 192.168.178.1
[ESP] 2025-06-17 10:32:11 P06: static-IP IPv4 netmask   is 255.255.255.0
```

Before I did this, I have noticed an error in telnet that resulted into a disconnect:

```
[ESP] 2025-06-17 09:35:01 < --(mqtt low mem skip)--
[ESP] 2025-06-17 09:37:02 < --(mqtt low mem skip)--
[MON] 2025-06-17 09:37:28 400000000000014
[MON] 2025-06-17 09:37:29 F130010000000001000000000000000019
[ESP] 2025-06-17 09:37:35 < onMqttDisconnect() reason 0
[MON] 2025-06-17 09:37:35 00001A
[ESP] 2025-06-17 09:37:42 < Reconnect to MQTT server 192.168.178.40:1883 (user /                                                                                                                                                         password *) not successful yet, retrying in 10 seconds
[ESP] 2025-06-17 09:37:44 Uptime 2800, MQTT is disconnected (16 s total 16 s)
[ESP] 2025-06-17 09:38:10 < onMqttDisconnect() reason 0
[MON] 2025-06-17 09:38:10 000000000000000007F01040000000000001A
[ESP] 2025-06-17 09:38:20 Uptime 2836, MQTT is disconnected (52 s total 52 s)
[ESP] 2025-06-17 09:38:20 < Reconnect to MQTT server 192.168.178.40:1883 (user /                                                                                                                                                         password *) not successful yet, retrying in 10 seconds[ESP] 2025-06-17 09:38:36                                                                                                                                                          Trying to connect to fallback MQTT server (first attempt will fail)
[ESP] 2025-06-17 09:38:36 < onMqttDisconnect() reason 0
[MON] 2025-06-17 09:38:36 00000000001
[ESP] 2025-06-17 09:38:57 Uptime 2872, MQTT is disconnected (88 s total 88 s)
[ESP] 2025-06-17 09:38:57 < Reconnect to MQTT server 192.168.4.12:1883 (user P1P                                                                                                                                                         2/password *) not successful yet, retrying in 10 seconds
[MON] 2025-06-17 09:38:57 026: 40F131000000010000190611092626AD
[ESP] 2025-06-17 09:38:57 Uptime 2873, MQTT is disconnected (89 s total 89 s)
[ESP] 2025-06-17 09:38:57 < Reconnect to MQTT server 192.168.4.12:1883 (user P1P                                                                                                                                                         2/password *) not successful yet, retrying in 10 seconds

[ESP] 2025-06-17 09:39:08 < Reconnect to MQTT server 192.168.4.12:1883 (user P1P                                                                                                                                                         2/password *) not successful yet, retrying in 10 seconds
[MON] 2025-06-17 09:39:08 000000045
[ESP] 2025-06-17 09:39:15 Uptime 2891, MQTT is disconnected (107 s total 107 s)
[ESP] 2025-06-17 09:39:15 < onMqttDisconnect() reason 0[MON] 2025-06-17 09:39:15                                                                                                                                                          000000000000007
[ESP] 2025-06-17 09:39:22 Uptime 2897, MQTT is disconnected (113 s total 113 s)
[ESP] 2025-06-17 09:39:22 < Reconnect to MQTT server 192.168.4.12:1883 (user P1P                                                                                                                                                         2/password *) not successful yet, retrying in 10 seconds
[MON] 2025-06-17 09:39:22 025: 0000130000D0000000000000000000000000000000000027
[ESP] 2025-06-17 09:39:22 Uptime 2898, MQTT is disconnected (114 s total 114 s)
[ESP] 2025-06-17 09:39:24 Uptime 2900, MQTT is disconnected (116 s total 116 s)
[ESP] 2025-06-17 09:39:32 < Reconnect to MQTT server 192.168.4.12:1883 (user P1P                                                                                                                                                         2/password *) not successful yet, retrying in 10 seconds
[ESP] 2025-06-17 09:39:34 Uptime 2910, MQTT is disconnected (126 s total 126 s)
[ESP] 2025-06-17 09:39:40 < onMqttDisconnect() reason 0
[ESP] 2025-06-17 09:39:43 < Reconnect to MQTT server 192.168.4.12:1883 (user P1P                                                                                                                                                         2/password *) not successful yet, retrying in 10 seconds
[MON] 2025-06-17 09:39:44 0001240000000000000000000007F01040000000000001A
[ESP] 2025-06-17 09:39:55 Uptime 2930, MQTT is disconnected (146 s total 146 s)
[ESP] 2025-06-17 09:39:55 < Reconnect to MQTT server 192.168.4.12:1883 (user P1P                                                                                                                                                         2/password *) not successful yet, retrying in 10 seconds
[MON] 2025-06-17 09:39:55   0.575: 0000100001010000000016004004000800001400402C0                                                                                                                                                         0BF
[ESP] 2025-06-17 09:39:59 Restarting ESP to attempt to reconnect to Mqtt server
```

After some retry attempts the address of the MQTT server changes to 192.168.4.12:1883
I don't have a MQTT server at this address.

What are the conditions to get the error  `--(mqtt low mem skip)--`?
Can I do something to avoid this?

Thank you for you help!

Thread 211 (2025-07-14):

Setpoint interface always shows 255C

josephwynn-sc, 2025-07-14:
Hello! Thank you for maintaining this project, it has made my life so much better.

Yesterday I updated my bridges' firmware from 0.9.56 to 0.9.58rc21 (P1P2MQTT-bridge-v0.9.58rc21-Daikin-F.ino.bin). Since then, I am having this issue where I cannot set the temperature because HA always interprets the value as 255. I show the problem in this video:

https://github.com/user-attachments/assets/2c2332cb-9428-453d-a6f3-cc8e240d4252

I read the docs and saw something about `HA_Setup`, but I think this is not available for the F-series. I have pressed `MQTT_Rebuild` and this does not fix the issue. Is there something else I'm supposed to do?

The units are Daikin FDYAN140 and FDYBA35.

Arnold-n, 2025-07-14:
Sorry, this must be an issue in the upgrade procedure. You can repair this with the following commands to be given via MQTT topic P1P2/W or with telnet:
-P35 16
-P36 32
-P37 16
-P38 32
-D5
-D0

Arnold-n, 2025-07-15:
You may also have to restore P39, the parameter used to select the air-intake temperature instead of the temperature of the controller's sensor, which may have been set incorrectly to 1 if you didn't manually set it to 1:
-P39 0
-D5
-D33

Root cause of this issue found and will be fixed in a newer version.

Thanks for your feedback!

josephwynn-sc, 2025-07-16:
@Arnold-n just confirming: a value of `1` means it will use the air intake sensor And a value of `0` means it will use the controller sensor?

I was changing the value of P39 and I did not see a change in the "field settings" in the controller (my installer told me this was mode 20, param 2).

ArnoldNiessen, 2025-07-16:
>  a value of `1` means it will use the air intake sensor and a value of `0` means it will use the controller sensor?

Yes, but the sensor value is used only as actual measurement value in the climate dial in Home Assistant. It does not change any field setting or operation of the A/C unit.

Closed 2025-07-14.

Thread 215 (2025-07-31):

Support for Daikin Ducted FDMQ Series (FDMQ24RVJU)

chiabre, 2025-07-31:
Hi, thank you for this great project!

I’m looking to integrate a Daikin FDMQ24RVJU indoor unit (part of the FDMQ "Duct Connected Type" series) using P1P2MQTT. I couldn’t find any references to FDMQ support in the documentation or existing issues, so I wanted to ask:

Is the FDMQ series, and specifically FDMQ24RVJU, supported by this integration?

If not, is there anything I can do to help test or provide data to enable support?

For reference, here is the [Daikin service manual for the FDMQ24RVJU](https://backend.daikincomfort.com/docs/default-source/product-documents/residential/manuals/servicemanual/sm-fdmq_rvju-rx_rmvju.pdf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), which includes board diagrams and connection info.

Thanks in advance!

Thread 219 (2025-08-20):

Work on MQTT TLS (v1.2)

remynicol, 2025-08-20:
### Context

This issue is not really a bug report but more a way to **document and share the research work** I’ve done around enabling **MQTT over TLS v1.2** for the P1P2 bridge on ESP8266.
Hopefully this can help others in the future and serve as a reference for possible improvements.

---

### Current situation

- `ESPAsyncTCP` does **not support TLS v1.2**.
- It could theoretically support TLS v1.1 (now obsolete), but only with Arduino framework **< 3.0.0** (e.g. 2.7.4).
- However, P1P2 requires Arduino framework **3.x.x** (currently 3.0.2).
  - Starting from 3.x.x, Arduino dropped **axTLS** and only ships **bearSSL**.
  - `ESPAsyncTCP` does not support bearSSL.
- I could not find any maintained library/fork to replace `ESPAsyncTCP` with bearSSL support.

---

### Progress & Experiments

I evaluated [`espMqttClient`](https://github.com/bertmelis/espMqttClient), which is inspired by `Async-mqtt-client` but relies on Arduino’s native networking instead of `ESPAsyncTCP`.
It offers 3 modes:

1. **Full-async (with ESPAsyncTCP)**
   - Equivalent to `Async-mqtt-client`.
   - Works, but still impossible to use TLS v1.2.
   - Also crashes if the broker is unavailable at boot (after a few minutes).
   - Reconnection after first successful connection works fine.
   - I didn’t fully debug whether this was due to my implementation in P1P2 or the library itself.

2. **Normal (no ESPAsyncTCP)**
   - Works correctly on P1P2.
   - Handles broker-unavailable-at-boot scenario gracefully.
   - Occasionally, keepalive packets are never sent to the broker → requires a reboot.
     - This issue is random: after reboot it may run indefinitely without any problem.
     - Could be due to my P1P2 implementation (e.g. subscribing before connection is fully established).

3. **Secure (TLS v1.2, no ESPAsyncTCP)**
   - Works similarly to the “normal” mode, including the random keepalive issue.
   - Initial tests with default parameters failed handshake due to **insufficient RAM**.
   - Using `mqttClient._client.client.getLastSSLError()`, I found ~30 KB RAM required for TLS.
   - By tweaking buffer size:
     ```cpp
     mqttClient._client.client.setBufferSizes(512, 512);
     ```
     → RAM requirement dropped to ~12 KB, making TLS v1.2 possible on P1P2.
   - After this tweak: ~8–10 KB RAM left (but note: `mqtt.publish` alone consumes ~6 KB).
   - It’s **very tight**, but it works.

---

### Notes

- `espMqttClient` does not expose `getLastSSLError` and `setBufferSizes` publicly.
  - For testing I temporarily made `_client` public.
  - A long-term solution would be either to propose exposing these functions upstream, or add a wrapper.

- When not using `ESPAsyncTCP`, `espMqttClient` is still **async for publish**, but **blocking during connect()**.
  - This is due to Arduino framework internals.
  - Not a real blocker: reconnections should be rare, and the timeout could be lowered (e.g. 1–2s) to make the blocking almost unnoticeable.

---

### Conclusion

The proof of concept works:
✅ TLS v1.2 is possible on ESP8266 with P1P2 using `espMqttClient`.

⚠️ However, the **remaining free RAM (8–10 KB instead of ~20 KB)** is too tight to finalize a safe migration.

👉 So… when ESP32? 😅😉

mahendrans2405, 2025-08-29:
hi , the HVAC Daikin BRC1C62 can separately provide power supply or need to connect indoor unit

Thread 220 (2025-08-21):

MQTT delete ALL and rebuild

Koky05, 2025-08-21:
When I hit "MQTT delete all and rebuild" I didn't expect that will delete really all my MQTT messages event from my Zigbee2MQTT communications and from my OctoPrint. Before I hit that I had 32 devices after it, it left only two.
I did it because my realtime COP was stuck for 20 hours.

Arnold-n, 2025-08-21:
Sorry that this happens, but that is the reason the button is disabled unless in setup-mode and it is part of the setup documentation, [5th paragraph](https://github.com/Arnold-n/P1P2MQTT/blob/main/doc/HomeAssistant.md)).

Was your system still operating, and the meter input still available, when the realtime COP was stuck?

Arnold-n, 2025-08-27:
This is intended - your system is heating on the back-up heater (6000W) and not on the compressor. The real-time COP calculation is only done based on (heat produced by compressor) / (electricity used by main unit excluding BUH/BSH).

If temperatures outside are too high, the compressor is severely limited in its operating range, so the system may delay DHW heating, or it may use the backup-heater, depending on how you configured the field settings.

Koky05, 2025-08-27:
Thanks for clarification, now I understand what happening with my heat pump. And sorry for so basic question and mark them as issue.

Thread 221 (2025-08-21):

Rename Gasboiler to BUH

Koky05, 2025-08-21:
I own only heat pump, no gas boiler.
But during reheat of hot watter it shows at first negative values and then positive values for gas power.
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

Arnold-n, 2025-08-21:
In non-hybrid models the gasboiler refers to the backup-heater. It can be negative due to sensor offsets and/or due to delay in changes during temperature changes, you can compensate an offset of the sensors if necessary.

Arnold-n, 2025-08-21:
The naming will be corrected in a future version.

Koky05, 2025-08-22:
@Arnold-n thanks for clarification.

Closed 2025-08-22.

Thread 223 (2025-09-19):

Different Temperatur by P1P2 to Espaltherma at R9T ?

Suedschwede66, 2025-09-19:
Hello Arnold-n,

I just noticed that the temperature value of the R9T differs between P1P2 and Espaltherma, and that the value from Espaltherma is more likely to be correct.
The firmware used is the latest version.

The upper curve is P1P2 and the lower one is ESPaltherma.

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

Thread 227 (2025-09-28):

MQTT error in HA

reedy, 2025-09-28:
```
Logger: homeassistant.components.mqtt.entity
Source: components/mqtt/entity.py:156
integration: MQTT (documentation, issues)
First occurred: 01:30:08 (1 occurrence)
Last logged: 01:30:08

Error 'expected BinarySensorDeviceClass or one of 'battery', 'battery_charging', 'carbon_monoxide', 'cold', 'connectivity', 'door', 'garage_door', 'gas', 'heat', 'light', 'lock', 'moisture', 'motion', 'moving', 'occupancy', 'opening', 'plug', 'power', 'presence', 'problem', 'running', 'safety', 'smoke', 'sound', 'tamper', 'update', 'vibration', 'window' for dictionary value @ data['device_class']' when processing MQTT discovery message topic: 'homeassistant/binary_sensor/bridge0/P1P2MQTT_bridge0_T1_Defrost_Active_param15_1/config', message: '{'payload_off': 0, 'state_topic': 'P1P2/P/P1P2MQTT/bridge0/T/1/Defrost_Active_param15', 'device_class': 'temperature', 'availability': [{'topic': 'P1P2/L/P1P2MQTT/bridge0', 'payload_not_available': 'offline', 'payload_available': 'online'}], 'payload_on': 1, 'device': {'identifiers': ['bridge0_15_param'], 'sw_version': '0.9.58rc23', 'model': 'P1P2MQTT_bridge', 'name': 'bridge0_15_param', 'manufacturer': 'Home-CliCK'}, 'unique_id': 'P1P2MQTT_bridge0_T1_Defrost_Active_param15_1', 'icon': 'mdi:coolant-temperature', 'availability_mode': 'all', 'name': 'Defrost_Active_param15'}'
```
