Arnold-n/P1P2MQTT/doc/circuits/Daikin_P1P2_Uno_version2.pdf

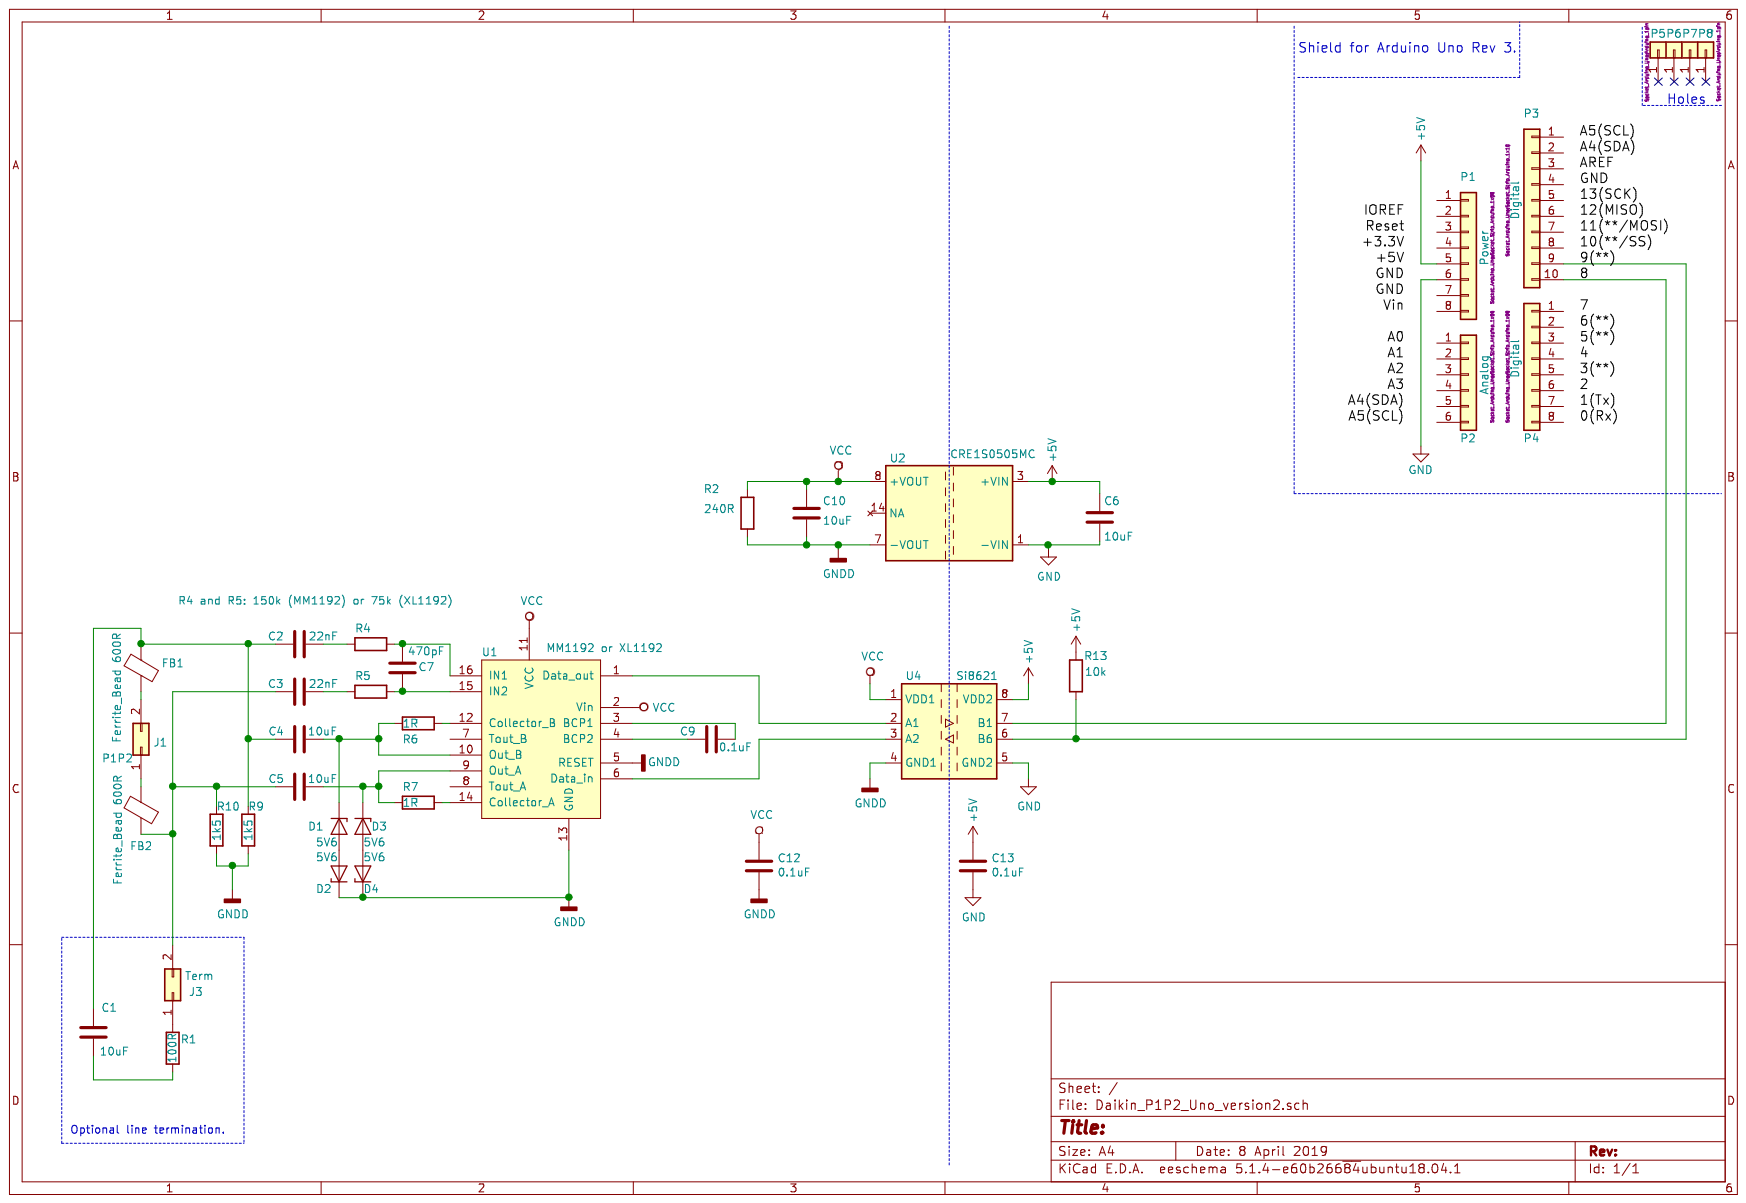
[picture p14: page 1]
