Arnold-n/P1P2MQTT/examples/P1P2MQTT-bridge/P1P2_ParameterConversion.h

/* P1P2_ParameterConversion.h
 *
 * Copyright (c) 2019-2024 Arnold Niessen, arnold.niessen-at-gmail-dot-com - licensed under CC BY-NC-ND 4.0 with exceptions (see LICENSE.md)
 *
 * Version history
 * 20240519 v0.9.51 field settings added, quiet_mode re-enabled for 0x0100 outputmode
 * 20240519 v0.9.49 hysteresis-check for V_Interface
 * 20240515 v0.9.46 full HA MQTT discovery and control, lots of other changes
 * 20231019 v0.9.43 solves resetDataStructure bug (counter in HA not visible, introduced in v0.9.41)
 * 20230604 v0.9.37 add heating/cooling/auto setting report
 * 20230526 v0.9.36 threshold
 * 20230423 v0.9.35 (skipped)
 * 20230212 v0.9.33a LWT setpoints added/renamed
 * 20230108 v0.9.31 sensor prefix, +2 valves in HA, fix bit history for 0x30/0x31, +pseudo controlLevel
 * 20221211 v0.9.29 defrost, DHW->gasboiler
 * 20221112 v0.9.27 fix to get Power_* also in HA
 * 20221102 v0.9.24 minor DHW/gas changes in reporting
 * 20221029 v0.9.23 ISPAVR over BB SPI, ADC, misc
 * 20220918 v0.9.22 degree symbol, hwID, 32-bit EE.outputMode
 * 20220821 v0.9.17-fix1 corrected negative deviation temperature reporting, more temp settings reported
 * 20220817 v0.9.17 license change
 * 20220808 v0.9.15 extended verbosity command, unique OTA hostname, minor fixes
 * 20220802 v0.9.14 AVRISP, wifimanager, mqtt settings, EEPROM, telnet, EE.outputMode, EE.outputFilter, ...
 * ..
 *
 */

// This file translates data from the P1/P2 bus to <mqttTopic,mqtt_value> pairs, code here is highly device-dependent,
// in order to implement parameter decoding for another product, rename this file and make any necessary changes
// mqttTopic and mqtt_value are globals, so take care
// (in particular in the big switch statements below).
//
// The main conversion function here is bytes2keyvalue(..),
// which is called for every individual byte of every payload.
// It aims to calculate a <mqttTopic,mqtt_value> pair for mqtt output.
//
// Return value 0 for success, or >0 indicating which bits should be individually handled
//
// The core of the translation is formed by large nested switch statements.
// Many of the macro's include break statements and make the core more readable.

#ifndef P1P2_ParameterConversion
#define P1P2_ParameterConversion

#define CAT_SETTING       { mqttTopic[ mqttTopicCatChar ] = 'S'; } // system settings, setpoints (even if WD)
#define CAT_TEMP          { mqttTopic[ mqttTopicCatChar ] = 'T'; maxOutputFilter = 1; } // temperature measurements
#define CAT_MEASUREMENT   { mqttTopic[ mqttTopicCatChar ] = 'M'; maxOutputFilter = 1; } // other measurements
#define CAT_FIELDSETTING  { mqttTopic[ mqttTopicCatChar ] = 'F'; } // field settings
#define CAT_COUNTER       { mqttTopic[ mqttTopicCatChar ] = 'C'; } // kWh/hour/start counters
#define CAT_PSEUDO        { mqttTopic[ mqttTopicCatChar ] = 'A'; } // ATmega/ESP operation
#define CAT_PSEUDO_SYSTEM { mqttTopic[ mqttTopicCatChar ] = 'C'; } // system operation (COP etc) // conflicts with CAT_COUNTER, but no real need to change - otherwise could be 'B'
#define CAT_SCHEDULE      { mqttTopic[ mqttTopicCatChar ] = 'E'; } // Schedule
#define CAT_UNKNOWN       { mqttTopic[ mqttTopicCatChar ] = 'U'; }
#define SRC(x)            { mqttTopic[ mqttTopicSrcChar ] = '0' + x; }

#ifdef E_SERIES
#define SRC_AUX_SPLIT { if (packetDst == 0xF1) src += 2; if (packetDst == 0xFF) src += 4; if (packetDst == 0xF2) src += 'D' - 2 - '0'; SRC(src); } // 4-5 for 0xF1, 6-7 for 0xFF, D-E for 0xF2 (EKRHH)
#endif /* E_SERIES */

// SRC values
// Daikin:
// 0 main controller to heat pump
// 1 (reply)
// 2 main controller to F0
// 3 (reply)
// 4 (reserved for main controller to F1)
// 5 (reply)
// 6 (reserved for main controller to FF)
// 7 (reply)
// 8 pseudo ATmega
// 9 pseudo ESP (incl date_time, power)
//
// A 80* messages (use value ('C' - '0'))
// B boot message (use value ('B' - '0'))
// D (reserved for main controller to FF)
// E (reply)
// F field settings (from different sources)
//
// Hitachi:
// 2 a remote control to IU (includes 41 00 1E packets - inter RC - for model 3)
// 8 IU to a remote control
// 7 ?
// 4 a remote control to another remote control (included Airzone) for models 1 and 2
// 0 pseudopacket, ATmega (differs from Daikin convention)
// 1 pseudopacket, ESP    (differs from Daikin convention)
// 9 other

// ESP8266, use strncpy_P (with care!), and PSTR()
#include <pgmspace.h>
#define mymin(a,b) ((a<b) ? a : b)

// macro usage
//
// regular entity reporting done by calling KEYx_PUB_CONFIG_CHECK_ENTITY which calls
//            CHECK(x), determines only new/changed, and generates pubHaEntity mask
//            PUB_CONFIG(K)   -> if needed, publishes config (if pubHa && haConfig && ...???), executes "return 0" if publishHA fails
//            CHECK_ENTITY(K) -> executes "return 0" if nothing to be published, otherwise (if pubHa||pubEntity / hysteresis): prepares to publish topic (in VALUE*)
// after which the code is supposed to call
//            VALUE           -> publishes value, and stores new value if succesful
//
// Calling order is: (set vars) CHECK PUB_CONFIG CHECK_ENTITY VALUE

#define CHECK(length)      { pubHaEntity = newCheckPayloadBytesVal(packetSrc, packetDst, packetType, payloadIndex, payload, length, 1); }
#define CHECKPARAM(length) { pubHaEntity = newCheckParamVal       (paramSrc, paramPacketType, paramNr, payloadIndex, payload, length); }
#define BITBASIS           { pubHaEntityBits = newCheckPayloadBytesVal(packetSrc, packetDst, packetType, payloadIndex, payload, 1, 0); return (pubHaEntityBits & 0xFF); }
#define BITBASIS_UNKNOWN   { switch (bitNr) { case 8 : BITBASIS; default : UNKNOWN_BIT; } }

uint16_t pubHaEntity = 0;
uint16_t pubHaEntityBits = 0;
byte bitsMask = 0;
byte FSB = 0;

#define CHECKBIT           { bitsMask = (0x01 << bitNr); pubHaEntity = pubHaEntityBits & ((bitsMask << 8) | bitsMask); }
#define CHECKBITS(x, y)    { if (x > 7) { printfTopicS("bitNr1 %i > 7", x); return 0; };  \
                             if (y > 7) { printfTopicS("bitNr2 % > 7", y); return 0; };  \
                             if (x > y) { printfTopicS("bitNr1 %i > bitNr2 %i", x, y); return 0; }; \
                             bitsMask = ((0x01 << (y - x + 1)) - 1) << x; \
                             pubHaEntity = pubHaEntityBits & ((bitsMask << 8) | bitsMask); \
}

#define pubHa (pubHaEntity & 0xFF00)
#define pubHaBit (pubHaEntityBits & (0x0100 << bitNr))
#define pubEntity (pubHaEntity & 0x00FF)

#define KEEPCONFIG 1 // do not make optional items unavailable (do not use DEL_CONFIG)

#define VALUE_flag8             { if (haDevice == HA_SENSOR) HADEVICE_BINSENSOR; value_flag8(packetSrc, packetType, payloadIndex, payload, mqtt_value, bitNr); return 0; }

#define HACONFIG { haConfig = 1; }

#define KEY(K) { strncpy_P(mqttTopic + mqttTopicPrefixLength, PSTR(K), mymin(MQTT_TOPIC_LEN - mqttTopicPrefixLength, strlen(K) + 1)); mqttTopic[ MQTT_TOPIC_LEN - 1 ] = '\0'; };
#define KEY_Fx(K) { strncpy_P(mqttTopic + mqttTopicPrefixLength, PSTR(K), mymin(MQTT_TOPIC_LEN - mqttTopicPrefixLength, strlen(K) + 1)); mqttTopic[ MQTT_TOPIC_LEN - 1 ] = '\0'; mqttTopic[ mqttTopicPrefixLength + 5] = '0' + (packetDst - 0xF0) + (packetDst > 0xF9 ? 'A' - '0' - 10 : 0); }

#define PUB_CONFIG  { if (pubHa && haConfig && (!publishHomeAssistantConfig(deviceSubName, haDevice, haEntity, haEntityCategory, haPrecision, haButtonDeviceClass, useSrc))) return 0; }
#define DEL_CONFIG  { if (pubHa && haConfig && (!deleteHomeAssistantConfig(deviceSubName, haDevice, haEntity, haEntityCategory, haPrecision, haButtonDeviceClass, useSrc))) return 0; }
#define PUB_CONFIG_COMMON_NAME(x)  { if (pubHa && haConfig && (!publishHomeAssistantConfig(deviceSubName, haDevice, haEntity, haEntityCategory, haPrecision, haButtonDeviceClass, useSrc, 1, x))) return 0; }
#define DEL_CONFIG_COMMON_NAME(x)  { if (pubHa && haConfig && (!deleteHomeAssistantConfig(deviceSubName, haDevice, haEntity, haEntityCategory, haPrecision, haButtonDeviceClass, useSrc, 1, x))) return 0; }

#define CHECK_ENTITY { if (!pubEntity || (!(haConfig || (EE.outputMode & 0x0100)))) return 0; };

#define KEY1_PUB_CONFIG_CHECK_ENTITY(K)    { CHECK(1); KEY(K); PUB_CONFIG; CHECK_ENTITY; }
#define KEY2_PUB_CONFIG_CHECK_ENTITY(K)    { CHECK(2); KEY(K); PUB_CONFIG; CHECK_ENTITY; }
#define KEY3_PUB_CONFIG_CHECK_ENTITY(K)    { CHECK(3); KEY(K); PUB_CONFIG; CHECK_ENTITY; }
#define KEY4_PUB_CONFIG_CHECK_ENTITY(K)    { CHECK(4); KEY(K); PUB_CONFIG; CHECK_ENTITY; }

#define KEY1_DEL_CONFIG_CHECK_ENTITY(K)    { CHECK(1); KEY(K); DEL_CONFIG; CHECK_ENTITY; }
#define KEY2_DEL_CONFIG_CHECK_ENTITY(K)    { CHECK(2); KEY(K); DEL_CONFIG; CHECK_ENTITY; }
#define KEY3_DEL_CONFIG_CHECK_ENTITY(K)    { CHECK(3); KEY(K); DEL_CONFIG; CHECK_ENTITY; }
#define KEY4_DEL_CONFIG_CHECK_ENTITY(K)    { CHECK(4); KEY(K); DEL_CONFIG; CHECK_ENTITY; }

#define KEYBIT_PUB_CONFIG_PUB_ENTITY(K)          { if (haDevice == HA_SENSOR) HADEVICE_BINSENSOR; CHECKBIT;        KEY(K); PUB_CONFIG; CHECK_ENTITY; VALUE_flag8; }
#define KEYBIT_PUB_CONFIG_PUB_ENTITY_INV(K)      { if (haDevice == HA_SENSOR) HADEVICE_BINSENSOR; CHECKBIT;        KEY(K); PUB_CONFIG; CHECK_ENTITY; VALUE_flag8_inv; }
#define KEYBIT_PUB_CONFIG_PUB_ENTITY_AUX_Fx(K)   { if (haDevice == HA_SENSOR) HADEVICE_BINSENSOR; CHECKBIT;     KEY_Fx(K); PUB_CONFIG; CHECK_ENTITY; VALUE_flag8; }
#define KEYBIT_PUB_CONFIG_PUB_ENTITY_AUX_Fx_INV(K) { if (haDevice == HA_SENSOR) HADEVICE_BINSENSOR; CHECKBIT;   KEY_Fx(K); PUB_CONFIG; CHECK_ENTITY; VALUE_flag8_inv; }
#define KEYBIT_PUB_CONFIG_CHECK_ENTITY(K)        { if (haDevice == HA_SENSOR) HADEVICE_BINSENSOR; CHECKBIT;        KEY(K); PUB_CONFIG; CHECK_ENTITY;  }
#define KEYBITS_PUB_CONFIG_PUB_ENTITY(x, y, K)   {                                                CHECKBITS(x, y); KEY(K); PUB_CONFIG; CHECK_ENTITY; VALUE_bits(x, y);}
#define KEYBITS_PUB_CONFIG_CHECK_ENTITY(x, y, K) {                                                CHECKBITS(x, y); KEY(K); PUB_CONFIG; CHECK_ENTITY; }

#define PARAM_KEY(K) { CHECKPARAM(paramValLength); KEY(K); PUB_CONFIG; CHECK_ENTITY; }

#define FIELDKEY(K) { if (FSB == 1) break;  \
                      CAT_FIELDSETTING; \
                      KEY(K); \
                      if (FSB == 2) { \
                        pubHaEntity = 0xFFFF; \
                      } else switch (packetType) {\
                        case 0x39 : CHECKPARAM(4); break; \
                        case 0x60 ... 0x8F : CHECK(4); break;\
                        default : printfTopicS("FIELDKEY unexpected packetType %i", packetType); break;\
                      }\
                      PUB_CONFIG; \
                      CHECK_ENTITY; break;}

#define KEYHEADER(K)    { pubHaEntity = 1; if (haConfig || (EE.outputMode & 0x0100)) { KEY(K); VALUE_header; }; return 0; } // for packet with empty payload

#define SUBDEVICE(x) { strlcpy(deviceSubName, x, DEVICE_SUBNAME_LEN); };

char timeString1[20] = "Mo 2000-00-00 00:00";    // reads time from packet type 0x12
// EKHBRD: char timeString1[12] = "Mo 00:00:00";    // reads time from packet type 0x12
char timeString2[23] = "Mo 2000-00-00 00:00:00"; // reads time from packet type 0x31 (+weekday from packet 12)

//==================================================================================================================

#define EXTRA_AV_STRING_ADD(formatstring, ...) { \
  extraAvailabilityStringLength += snprintf_P(extraAvailabilityString + extraAvailabilityStringLength, EXTRA_AVAILABILITY_STRING_LEN - extraAvailabilityStringLength, PSTR(formatstring) __VA_OPT__(,) __VA_ARGS__); \
  if (extraAvailabilityStringLength > extraAvailabilityStringLengthMax) extraAvailabilityStringLengthMax = extraAvailabilityStringLength; \
  if (extraAvailabilityStringLength >= EXTRA_AVAILABILITY_STRING_LEN) { \
    extraAvailabilityString[0] = '\0'; \
    extraAvailabilityStringLength = 0; \
  } \
}

//==================================================================================================================

#define HADEVICE_CLIMATE_TEMPERATURE(temp_stat_topic, temp_min, temp_max, temp_step) { \
  topicCharSpecific('P'); \
  HACONFIGMESSAGE_ADD(  \
    "\"temp_stat_t\":\"%s/%s\"," \
    "\"min_temp\":%1.1f," \
    "\"max_temp\":%1.1f," \
    "\"temp_step\":%1.1f," \
    , mqttTopic, temp_stat_topic \
    , (float) temp_min, (float) temp_max, (float) temp_step);  \
}

#define HADEVICE_CLIMATE_TEMPERATURE_CURRENT(curr_temp_topic) { \
  topicCharSpecific('P'); \
  HACONFIGMESSAGE_ADD(  \
  "\"curr_temp_t\":\"%s/%s\"," \
  , mqttTopic, curr_temp_topic); \
}

#define HADEVICE_CLIMATE_MODES(mode_stat_topic, modes, modes_tx) { \
  topicCharSpecific('P'); \
  HACONFIGMESSAGE_ADD( \
    "\"mode_stat_t\":\"%s/%s\"," \
    "\"mode_stat_tpl\":\"{%% set modes={%s} %%}{{ modes[value] if value in modes.keys() else modes['0']}}\"," \
    "\"modes\":[%s]," \
    , mqttTopic, mode_stat_topic \
    , modes_tx \
    , modes); \
}

//==================================================================================================================

// F-series fan mode

#define HADEVICE_CLIMATE_FAN_MODES(fan_mode_stat_topic, fan_modes, fan_modes_tx) { \
  topicCharSpecific('P'); \
  HACONFIGMESSAGE_ADD( \
    "\"fan_mode_stat_t\":\"%s/%s\"," \
    "\"fan_mode_stat_tpl\":\"{%% set modes={%s} %%}{{ modes[value] if value in modes.keys() else modes['0']}}\"," \
    "\"fan_modes\":[%s]," \
    , mqttTopic, fan_mode_stat_topic \
    , fan_modes_tx \
    , fan_modes); \
}

#define HADEVICE_CLIMATE_FAN_MODE_COMMAND_TEMPLATE(fan_mode_cmd_template) { \
  topicWrite; \
  HACONFIGMESSAGE_ADD( \
    "\"fan_mode_cmd_t\":\"%s\"," \
    "\"fan_mode_cmd_tpl\":\"%s\"," \
    , mqttTopic, fan_mode_cmd_template); \
}

//==================================================================================================================
#define HADEVICE_CLIMATE_TEMPERATURE_COMMAND(temp_cmd_template) { \
  topicWrite; \
  HACONFIGMESSAGE_ADD( \
    "\"temp_cmd_t\":\"%s\"," \
    "\"temp_cmd_tpl\":\"%s\"," \
    , mqttTopic, temp_cmd_template); \
}

#define HADEVICE_CLIMATE_MODE_COMMAND_TEMPLATE(mode_cmd_template) { \
  topicWrite; \
  HACONFIGMESSAGE_ADD( \
    "\"mode_cmd_t\":\"%s\"," \
    "\"mode_cmd_tpl\":\"%s\"," \
    , mqttTopic, mode_cmd_template); \
}

#define HADEVICE_CLIMATE_MODE_POWER_COMMAND_TEMPLATE(mode_pwr_cmd_template) { \
  topicWrite; \
  HACONFIGMESSAGE_ADD( \
    "\"power_command_topic\":\"%s\"," \
    "\"power_command_template\":\"%s\"," \
    , mqttTopic, mode_pwr_cmd_template); \
}

//==================================================================================================================
// MHI-specific climate macros — write topics point to bridge-side state-merging handlers

#ifdef MHI_SERIES
// mode_stat_t publishes string values directly ("off","auto","cool","heat","dry","fan_only")
#define MHI_HADEVICE_CLIMATE_MODES(mode_stat_topic) { \
  topicCharSpecific('P'); \
  HACONFIGMESSAGE_ADD( \
    "\"mode_stat_t\":\"%s/%s\"," \
    "\"mode_stat_tpl\":\"{{ value }}\"," \
    "\"modes\":[\"off\",\"auto\",\"cool\",\"heat\",\"dry\",\"fan_only\"]," \
    , mqttTopic, mode_stat_topic); \
}
// fan_mode_stat_t publishes numeric 1/2/3 — template converts to HA strings
#define MHI_HADEVICE_CLIMATE_FAN_MODES(fan_stat_topic) { \
  topicCharSpecific('P'); \
  HACONFIGMESSAGE_ADD( \
    "\"fan_mode_stat_t\":\"%s/%s\"," \
    "\"fan_mode_stat_tpl\":\"{%% set m={'1':'low','2':'medium','3':'high'} %%}{{ m[value] if value in m else 'low' }}\"," \
    "\"fan_modes\":[\"low\",\"medium\",\"high\"]," \
    , mqttTopic, fan_stat_topic); \
}
// Command topics use the bridge-side per-parameter write topics (defined in P1P2MQTT-bridge.ino)
#define MHI_HADEVICE_CLIMATE_MODE_COMMAND() { \
  HACONFIGMESSAGE_ADD( \
    "\"mode_cmd_t\":\"%s\"," \
    "\"mode_cmd_tpl\":\"{{ value }}\"," \
    , mhiModeWriteTopic); \
}
#define MHI_HADEVICE_CLIMATE_TEMP_COMMAND() { \
  HACONFIGMESSAGE_ADD( \
    "\"temp_cmd_t\":\"%s\"," \
    "\"temp_cmd_tpl\":\"{{ value }}\"," \
    , mhiTempWriteTopic); \
}
#define MHI_HADEVICE_CLIMATE_FAN_COMMAND() { \
  HACONFIGMESSAGE_ADD( \
    "\"fan_mode_cmd_t\":\"%s\"," \
    "\"fan_mode_cmd_tpl\":\"{{ value }}\"," \
    , mhiFanWriteTopic); \
}
// swing_mode_stat_t publishes "swing","top","mid_top","mid_bottom","bottom" directly
#define MHI_HADEVICE_CLIMATE_SWING_MODES(swing_stat_topic) { \
  topicCharSpecific('P'); \
  HACONFIGMESSAGE_ADD( \
    "\"swing_mode_stat_t\":\"%s/%s\"," \
    "\"swing_mode_stat_tpl\":\"{{ value }}\"," \
    "\"swing_modes\":[\"swing\",\"top\",\"mid_top\",\"mid_bottom\",\"bottom\"]," \
    , mqttTopic, swing_stat_topic); \
}
#define MHI_HADEVICE_CLIMATE_SWING_COMMAND() { \
  HACONFIGMESSAGE_ADD( \
    "\"swing_mode_cmd_t\":\"%s\"," \
    "\"swing_mode_cmd_tpl\":\"{{ value }}\"," \
    , mhiSwingWriteTopic); \
}
#endif /* MHI_SERIES */

//==================================================================================================================

#define HADEVICE_AVAILABILITY(availability_topic, on_value, off_value) { \
  topicCharSpecific('P'); \
  EXTRA_AV_STRING_ADD( \
    ",{\"topic\":\"%s/%s\",\"pl_avail\":%i,\"pl_not_avail\":%i}" \
    , mqttTopic, availability_topic, on_value, off_value); \
}

//==================================================================================================================

#define HADEVICE_SELECT_OPTIONS(modes, modes_tx) { \
  topicCharSpecific('P'); \
  HACONFIGMESSAGE_ADD( \
    "\"val_tpl\":\"{%% set modes={%s} %%}{{ modes[value] if (value) in modes.keys() else modes['0']}}\"," \
    "\"options\":[%s]," \
    , modes_tx \
    , modes); \
}

#define HADEVICE_SELECT_COMMAND_TEMPLATE(select_cmd_template) { \
  topicWrite; \
  HACONFIGMESSAGE_ADD( \
    "\"cmd_t\":\"%s\"," \
    "\"cmd_tpl\":\"%s\"," \
    , mqttTopic, select_cmd_template); \
}

// not used
#define HADEVICE_OPTIMISTIC { \
  HACONFIGMESSAGE_ADD( \
    "\"optimistic\":\"true\","); \
}

//==================================================================================================================

#define HADEVICE_SENSOR_VALUE_TEMPLATE(sensor_val_template) { \
  topicWrite; \
  HACONFIGMESSAGE_ADD( \
    "\"val_tpl\":\"%s\"," \
    , sensor_val_template); \
}

//==================================================================================================================

#define HADEVICE_NUMBER_RANGE(nr_min, nr_max, nr_step) { \
  topicCharSpecific('P'); \
  HACONFIGMESSAGE_ADD(  \
    "\"min\":%f," \
    "\"max\":%f," \
    "\"step\":%f," \
    , (float) nr_min, (float) nr_max, (float) nr_step);\
}

#define HADEVICE_NUMBER_MODE(nr_mode) { \
  topicCharSpecific('P'); \
  HACONFIGMESSAGE_ADD(  \
    "\"mode\":\"%s\"," \
    , nr_mode); \
}

#define HADEVICE_NUMBER_COMMAND_TEMPLATE(number_cmd_template) { \
  topicWrite; \
  HACONFIGMESSAGE_ADD( \
    "\"cmd_t\":\"%s\"," \
    "\"cmd_tpl\":\"%s\"," \
    , mqttTopic, number_cmd_template); \
}

//==================================================================================================================


// update, restart, identify
#define HADEVICE_BUTTON_CLASS(button_class) { \
  topicCharSpecific('P'); \
  HACONFIGMESSAGE_ADD(  \
    "\"dev_cla\":\"%s\"," \
    , button_class); \
}

#define HADEVICE_BUTTON_COMMAND(button_cmd) { \
  topicWrite; \
  HACONFIGMESSAGE_ADD( \
    "\"cmd_t\":\"%s\"," \
    "\"cmd_tpl\":\"%s\"," \
    , mqttTopic, button_cmd); \
}

//==================================================================================================================

#define HADEVICE_SWITCH_PAYLOADS(payload_off, payload_on) { \
  topicWrite; \
  HACONFIGMESSAGE_ADD( \
    "\"stat_off\":0," \
    "\"stat_on\":1," \
    "\"pl_off\":\"%s\"," \
    "\"pl_on\":\"%s\"," \
    "\"cmd_t\":\"%s\"," \
    , payload_off, payload_on, mqttTopic); \
}

// ====================== define data structures ======================

#ifdef E_SERIES

#define PARAM_TP_START      0x35
#define PARAM_TP_END        0x3D
#define PARAM_ARR_SZ (PARAM_TP_END - PARAM_TP_START + 1 + 1)
#define PPTI15 (PARAM_ARR_SZ - 1)
                                                      //      0       1       2       3       4       5       6       7       8       9
#ifdef FULLHISTORY

const PROGMEM uint32_t  nr_params[PARAM_ARR_SZ]      = { 0x0203, 0x00B1, 0x0002, 0x001F, 0x00F0, 0x006D, 0x00B0, 0x0002, 0x0020, 0x001A }; // number of parameters observed
//byte packettype                                    = {   0x35,   0x36,   0x37,   0x38,   0x39,   0x3A,   0x3B,   0x3C,   0x3D,   0x15 };
const PROGMEM uint32_t  parnr_bytes [PARAM_ARR_SZ]   = {      1,      2,      3,      4,      4,      1,      2,      3,      4,      2 }; // byte per parameter // was 8-bit
const PROGMEM uint32_t   valstart[PARAM_ARR_SZ]      = { 0x0000, 0x0203, 0x0365, 0x036B, 0x03E7, 0x07A7, 0x0814, 0x0974, 0x097A, 0x09FA  /* , 0x0A2E */ }; // valstart = sum  (parnr_bytes * nr_params)
const PROGMEM uint32_t  seenstart[PARAM_ARR_SZ]      = { 0x0000, 0x0203, 0x02B4, 0x02B6, 0x02D5, 0x03C5, 0x0432, 0x04E2, 0x04E4, 0x0504  /* , 0x051E */ }; // seenstart = sum (parnr_bytes)
#define sizeParamVal  0x0A2E
#define sizeParamSeen 0x051E
#define sizeParamSeenDiv8 ((sizeParamSeen + 7) / 8)

#else /* FULLHISTORY */

const PROGMEM uint32_t  nr_params[PARAM_ARR_SZ]      = { 0x0203, 0x00B1,      0,      0, 0x00F0,      0,      0,      0,      0, 0x001A }; // number of parameters observed
//byte packettype                                    = {   0x35,   0x36,   0x37,   0x38,   0x39,   0x3A,   0x3B,   0x3C,   0x3D,   0x15 };
const PROGMEM uint32_t  parnr_bytes [PARAM_ARR_SZ]   = {      1,      2,      3,      4,      4,      1,      2,      3,      4,      2 }; // byte per parameter // was 8-bit
const PROGMEM uint32_t   valstart[PARAM_ARR_SZ]      = { 0x0000, 0x0203, 0x0365, 0x0365, 0x0365, 0x0725, 0x0725, 0x0725, 0x0725, 0x0725  /* , 0x0759 */ }; // valstart = sum  (parnr_bytes * nr_params)
const PROGMEM uint32_t  seenstart[PARAM_ARR_SZ]      = { 0x0000, 0x0203, 0x02B4, 0x02B4, 0x02B4, 0x03A4, 0x03A4, 0x03A4, 0x03A4, 0x03A4  /* , 0x03BE */ }; // seenstart = sum (parnr_bytes)

#define sizeParamVal  0x0759
#define sizeParamSeen 0x03BE
#define sizeParamSeenDiv8 ((sizeParamSeen + 7) / 8)

#endif /* FULLHISTORY */

#define PCKTP_START  0x0B
#define PCKTP_END    0x15 // 0x0B-0x15 / 0x31 0x20 0x21 0x60-0x9F mapped to 0x16-.. ; 0x31/0x32 4x separately for 0xF0 0xF1 0xF2 0xFF
#define PCKTP_ARR_BLOCK (PCKTP_END - PCKTP_START + 3 + 18 + 2 + 1 + 4 /* for 60-8F: + 48 */)
#define PCKTP_ARR_SZ    ((2 * PCKTP_ARR_BLOCK) + 2)

// 00F030 : used for setting up HA, at least 11 needed, for now 14 reserved
// 40F030 : not used, no storage needed
// 00F031 : 12 bytes, storage is needed only for first 6
// 40F031 : not used, no storage needed

const PROGMEM uint32_t ptiCheck[PCKTP_ARR_SZ] =
{
0x0B,0x0C,0x0D,0x0E,0x0F,0x10,0x11,0x12,0x13,0x14,0x15,0x30,0x31,0x31,0x31,0x31,0x32,0x32,0x32,0x32,0x20,0x21,   /* 60,  61,  62,  63,  64,  65,  66,  67,  68,  69,  6A,  6B,  6C,  6D,  6E,  6F,  70,  71,  72,  73,  74,  75,  76,  77,  78,  79,  7A,  7B,  7C,  7D,  7E,  7F,  80,  81,  82,  83,  84,  85,  86,  87,  88,  89,  8A,  8B,  8C,  8D,  8E,  8F, */0x90,0x91,0x92,0x93,0x94,0x95,0x96,0x97,0x98,0x99,0x9A,0x9B,0x9C,0x9D,0x9E,0x9F,
0x0B,0x0C,0x0D,0x0E,0x0F,0x10,0x11,0x12,0x13,0x14,0x15,0x30,0x31,0x31,0x31,0x31,0x32,0x32,0x32,0x32,0x20,0x21,   /* 60,  61,  62,  63,  64,  65,  66,  67,  68,  69,  6A,  6B,  6C,  6D,  6E,  6F,  70,  71,  72,  73,  74,  75,  76,  77,  78,  79,  7A,  7B,  7C,  7D,  7E,  7F,  80,  81,  82,  83,  84,  85,  86,  87,  88,  89,  8A,  8B,  8C,  8D,  8E,  8F, */0x90,0x91,0x92,0x93,0x94,0x95,0x96,0x97,0x98,0x99,0x9A,0x9B,0x9C,0x9D,0x9E,0x9F,
0x10,0x18
 };
const PROGMEM uint32_t nr_bytes[PCKTP_ARR_SZ]     =
{
//0000xx
  0,    0,   0,  20,  20,  20,  20,  20,  20,  20,  20,  14,  12,   0,   0,   0,  16,  16,  16,  16,  20,  20,   /* 20,  20,  20,  20,  20,  20,  20,  20,  20,  20,  20,  20,  20,  20,  20,  20,  20,  20,  20,  20,  20,  20,  20,  20,  20,  20,  20,  20,  20,  20,  20,  20,  20,  20,  20,  20,  20,  20,  20,  20,  20,  20,  20,  20,  20,  20,  20,  20, */  20,  20,  20,  20,  20,  20,  20,  20,  20,  20,  20,  20,  20,  20,  20,  20,
//4000xx
 20,   20,  20,  20,  20,  20,  20,  20,  20,  20,  20,   0,  12,  12,  12,  12,  16,  16,  16,  16,  20,  20,   /* 20,  20,  20,  20,  20,  20,  20,  20,  20,  20,  20,  20,  20,  20,  20,  20,  20,  20,  20,  20,  20,  20,  20,  20,  20,  20,  20,  20,  20,  20,  20,  20,  20,  20,  20,  20,  20,  20,  20,  20,  20,  20,  20,  20,  20,  20,  20,  20, */  20,  20,  20,  20,  20,  20,  20,  20,  20,  20,  20,  20,  20,  20,  20,  20,
//800010, 800018
  17, 6,
 };

const PROGMEM uint32_t bytestart[PCKTP_ARR_SZ]     =
{  0,   0,   0,   0,  20,  40,  60,  80, 100, 120, 140, 160, 174, 186, 186, 186, 186, 202, 218, 234, 250, 270,                                                                                                                                                                                                                                                         290, 310, 330, 350, 370, 390, 410, 430, 450, 470, 490, 510, 530, 550, 570, 590,
 610, 630, 650, 670, 690, 710, 730, 750, 770, 790, 810, 830, 830, 842, 854, 866, 878, 894, 910, 926, 942, 962,                                                                                                                                                                                                                                                         982,1002,1022,1042,1062,1082,1102,1122,1142,1162,1182,1202,1222,1242,1262,1282,
 1302,1319, /* sizePayloadByteVal=1325 */ };
#define sizePayloadByteVal 1325
#define sizePayloadByteSeen 166 // ceil(1325/8)
#define sizePayloadBitsSeen 38

#ifdef SAVESCHEDULE
#define SCHEDULE_MEM_START 0x0250
#define SCHEDULE_MEM_SIZE 0x048E          // this model uses only 0x0250 - 0x070D
uint16_t scheduleMemLoc[2];
uint8_t scheduleLength[2];
uint8_t scheduleSeq[2];
byte scheduleMem[2][SCHEDULE_MEM_SIZE] = {};     // 2 * 1166 = 2332 bytes
bool scheduleMemSeen[2][SCHEDULE_MEM_SIZE] = {}; // 2 * 1166 = 2332 bytes
#endif /* SAVESCHEDULE */

#elif defined F_SERIES

#define PCKTP_START  0x08 // 0x08..0x12, others mapped, // 0x37 zone name/0xC1 service mode subtype would require special coding, not supported yet
#define PCKTP_ARR_BLOCK 38
#define PCKTP_ARR_SZ ((2 * PCKTP_ARR_BLOCK) + 1)
//byte packetsrc                                   = { 00                                                                                                                                                                                          , 40                                                                                                                                                                                         ,    80 }
//byte packettype                                  = { 08,  09,  0A,  0B,  0C,  0D,  0E,  0F,  10,  11,  12,  15,  17,  18,  19,  1F,  20,  21,  30,  31,  32,  33,  34,  35,  36,  37,  38,  39,  3A,  3B,  3C,  3D,  3E,  3F,  80,  A1,  A3,  B1,  08,  09,  0A,  0B,  0C,  0D,  0E,  0F,  10,  11,  12,  15,  17,  18,  19,  1F,  20,  21,  30,  31,  32,  33,  34,  35,  36,  37,  38,  39,  3A,  3B,  3C,  3D,  3E,  3F,  80,  A1,  A3, B1 ,    18 }
const PROGMEM uint32_t nr_bytes [PCKTP_ARR_SZ]     = {  0,  20,  20,  20,   0,  20,  20,  20,  20,  20,  17,  18,   6,   7,   5,   0,   2,  20,  20,  20,   8,   0,   5,  19,  19,   0,  20,  20,  18,  20,  12,   0,   0,   0,  10,  16,   0,  18,   0,  20,  20,  20,   0,  20,  20,  20,  20,  20,  20,  18,  11,  19,   4,  20,  20,  20,   0,  20,   1,   0,   0,   0,   0,   0,  20,   5,   8,  19,   2,   0,   0,   0,  10,  16,  19, 18,    11     };
const PROGMEM uint32_t bytestart[PCKTP_ARR_SZ]     = {  0,   0,  20,  40,  60,  60,  80, 100, 120, 140, 160, 177, 195, 201, 208, 213, 213, 215, 235, 255, 275, 283, 283, 288, 307, 326, 326, 346, 366, 384, 404, 416, 416, 416, 416, 426, 442, 442, 460, 460, 480, 500, 520, 520, 540, 560, 580, 600, 620, 640, 658, 669, 688, 692, 712, 732, 752, 752, 772, 773, 773, 773, 773, 773, 773, 793, 798, 806, 825, 827, 827, 827, 827, 837, 853, 872, 890  /*, sizePayloadByteVal = 901 */ };

#define sizePayloadByteVal  901
#define sizePayloadByteSeen 113 // ceil(901/8)

#define sizePayloadBitsSeen 1

#elif ( defined F1F2_SERIES || defined M_SERIES )

#define PCKTP_START  0x08 // 0x08..0x0F
#define PCKTP_ARR_BLOCK 8
#define PCKTP_ARR_SZ ((2 * PCKTP_ARR_BLOCK) + 0)
//byte packetsrc                                   = { 00                                    , 40 }
//byte packettype                                  = { 08,  09,  0A,  0B,  0C,  0D,  0E,  0F,  08,  09,  0A,  0B,  0C,  0D,  0E,  0F }
const PROGMEM uint32_t nr_bytes [PCKTP_ARR_SZ]     = {  0,  20,  20,  20,   0,  20,  20,  20,   0,  20,  20,  20,   0,  20,  20,  20 };
const PROGMEM uint32_t bytestart[PCKTP_ARR_SZ]     = {  0,   0,  20,  40,  60,  60,  80, 100, 120, 120, 140, 160, 180, 180, 200, 220  /*, sizePayloadByteVal = 240 */ };

#define sizePayloadByteVal  240
#define sizePayloadByteSeen  30 // ceil(240/8)

#define sizePayloadBitsSeen 1

#elif defined MHI_SERIES

#define sizePayloadBitsSeen 0x14

// no pseudo packet translation yet due to packetSrc conflict

#define PCKTP_START  0x08
#define PCKTP_END    0x0F // assume first byte of MHI packet is source identifier: 00, 80, 0C, mapped to 10, 11, 12
#define PCKTP_ARR_SZ (PCKTP_END - PCKTP_START + 4)
//byte packettype                                  = {00,  0C,  80} // map 00  01-7F or 00-7F?
// map 00-01 to 00-01
// map 02-07 to 02
// map 80-81 to 03-04
// 16 bytes each
const PROGMEM uint32_t nr_bytes [PCKTP_ARR_SZ]     = { 16,  16,  16,  16,  16  };
const PROGMEM uint32_t bytestart[PCKTP_ARR_SZ]     = {  0,  16,  32,  48,  64  /* , sizePayloadByteVal=80 */ };
#define sizePayloadByteVal  80
#define sizePayloadByteSeen 10 // ceil(80/8)

#elif defined TH_SERIES // for now, handle Toshiba as Hitachi

// for Hitachi:
// 0 .. 7 for pseudo packets 000008 - 00000F
// 8 .. F for pseudo packets 400008 - 40000F
//
// Hitachi model 1, source 1
// 10: 21 00 0B
// 11: 21 00 12
// 12: 89 00 27
// 13: 89 00 2D xx xx xx xx XX (XX = 0xE1 .. 0xE5, currently decode only 0xE2)
// 14: 41 00 18
//   : 89 06 (acknowledgement only)
//   : 21 06 (acknowledgement only)
//   : 41 06 (acknowledgement only)
//
// Hitachi, source 2
//
// 15: 21 00 29 xx xx xx xx F1
// 16: 21 00 29 xx xx xx xx F2
// 17: 21 00 29 xx xx xx xx F3
// 18: 21 00 29 xx xx xx xx F4
// 19: 21 00 29 xx xx xx xx F5
// 1A: 89 00 17 xx xx xx xx E1
// 1B: 89 00 29 xx xx xx xx E2
// 1C: 89 00 29 xx xx xx xx E3
// 1D: 89 00 29 xx xx xx xx E4
// 1E: 89 00 29 xx xx xx xx E5
//
// Hitachi, source 3
//
// 15: 21 00 29 xx xx xx xx F1
// 16: 21 00 29 xx xx xx xx F2
// 17: 21 00 29 xx xx xx xx F3
// 18: 21 00 29 xx xx xx xx F4
// 19: 21 00 29 xx xx xx xx F5 (not observed)
// 1A: 89 00 17 xx xx xx xx E1
// 1B: 89 00 29 xx xx xx xx E2
// 1C: 89 00 29 xx xx xx xx E3
// 1D: 89 00 29 xx xx xx xx E4
// 1E: 89 00 29 xx xx xx xx E5 (not observed)
// 1F: 41 00 29 xx xx xx xx E1
// 20: 8A 00 29 xx xx xx xx F1
// .. and more, reserved?
//
// Hitachi, source 4
//
// ..
// 21:
// ..
// 29:
//
// Hitachi model 2
//
// 13: 89 00 2D xx xx xx xx XX (for 0xE2 different entities from Hitachi model 1 nr 13, currently decode only 0xE2)
// 2A: 21 00 1C
//
// Hitachi HiBox AHP-SMB-01 and ATW-ATAG-02
//
// 2B: 79 00 2E
// 2C: FF 00 23
//
// Hitachi model 3
//
// 10: 21 xx 1C (p1p2 monitor does not emit this packet, no need to ckeck source : this is the main remote control)
// 11: 89 xx 2D xx xx xx xx xx xx 01
// 12: 89 xx 2D xx xx xx xx xx xx 06
// 13: 41 xx 1E xx 01 (main remote control speaks to second one : p1p2 monitor)
//   : 89 06 (acknowledgement only)
//   : 21 06 (acknowledgement only)
//   : 41 06 (acknowledgement only)
//
// nr_bytes = value 3rd byte - 4;

# if HITACHI_MODEL == 3

#define sizePayloadBitsSeen 15

#define PCKTP_ARR_SZ 0x14
//byte pti                                      =    0    1    2    3    4    5    6    7    8    9   0A   0B   0C   0D   0E   0F      10   11   12   13
//3rd byte                                      =                                                                                      1C   2D   2D   1E
//payload[0x01]                                 =                                                                                                     01
//payload[0x06]                                 =                                                                                           01   06
const PROGMEM uint32_t nr_bytes[PCKTP_ARR_SZ]  = {  20,  20,  20,  20,  20,  20,  20,  20,  20,  20,  20,  20,  20,  20,  20,  20,     24,  41,  41,  26 };
const PROGMEM uint32_t bytestart[PCKTP_ARR_SZ] = {   0,  20,  40,  60,  80, 100, 120, 140, 160, 180, 200, 220, 240, 260, 280, 300,    320, 344, 385, 426 };
#define sizePayloadByteVal 452
#define sizePayloadByteSeen 57 // ceil(452/8)

# else /* HITACHI_MODEL */

#define sizePayloadBitsSeen 12 // for Hitachi model 1 or 2, but not for Toshiba

#define PCKTP_ARR_SZ 0x2D
//byte pti                                      =   0..F  (0..7 for 000008..00000F, 8..F for 400008..40000F)                           10-14                           15-1E                                             1F-20                                               2A       2B     2C
//byte pti                                      =    0    1    2    3    4    5    6    7    8    9   0A   0B   0C   0D   0E   0F      10   11   12   13   14          15   16   17   18   19   1A   1B   1C   1D   1E   1F   20   21  22  23  24  25  26  27  28  29        2A       2B     2C  // length 25->24 when CS_GEN implemented
//3rd byte                                      =                                                                                      0B   12   27   2D   18          29   29   29   29   29   17   29   29   29   29   29   29    ?   ?   ?   ?   ?   ?   ?   ?   ?        1C       2E     23
const PROGMEM uint32_t nr_bytes[PCKTP_ARR_SZ]  = {  20,  20,  20,  20,  20,  20,  20,  20,  20,  20,  20,  20,  20,  20,  20,  20,      7,  14,  20,  35,  41,         37,  37,  37,  37,  37,  19,  37,  37,  37,  37,  37,  37,  50, 50, 50, 50, 50, 50, 50, 50, 50,       25     , 43,    32 };
const PROGMEM uint32_t bytestart[PCKTP_ARR_SZ] = {   0,  20,  40,  60,  80, 100, 120, 140, 160, 180, 200, 220, 240, 260, 280, 300,    320, 327, 341, 361, 396,/*rst*/ 320, 357, 394, 431, 468, 505, 524, 561, 598, 635, 672, 709, 746,796,846,896,946,996,1046,1096,1146,    1196   , 1221,1264     /* , 746 -> 1296 */ };
#define sizePayloadByteVal 1296
#define sizePayloadByteSeen 162 // ceil(1296/8)

# endif /* HITACHI_MODEL */

#elif defined W_SERIES

#define PCKTP_START  0x0C
#define PCKTP_END    0x0F // 0x0C - 0x0F (40 only)
#define PCKTP_ARR_BLOCK (PCKTP_END - PCKTP_START + 1)
#define PCKTP_ARR_SZ    (2 * PCKTP_ARR_BLOCK)

// 00F030 : used for setting up HA, at least 11 needed, for now 14 reserved
// 40F030 : not used, no storage needed
// 00F031 : 12 bytes, storage is needed only for first 6
// 40F031 : not used, no storage needed

//0C,  0D,  0E,  0F
const PROGMEM uint32_t nr_bytes[PCKTP_ARR_SZ]     =
{
//0000xx
  0,   0,   0,   0,
//4000xx
  0,  20,  20,  20,
 };

const PROGMEM uint32_t bytestart[PCKTP_ARR_SZ]     =
{  0,   0,   0,   0,
   0,   0,  20,  40,  /* sizePayloadByteVal=60 */ };
#define sizePayloadByteVal  60
#define sizePayloadByteSeen 8 // ceil(60/8)
#define sizePayloadBitsSeen 1

#endif /* *_SERIES */

typedef struct RTCdata {
  uint16_t RTCversion;
  uint16_t RTCdataLength;
  // ==========================
  byte month;
  byte wday;
  byte hour;
#ifdef E_SERIES
  uint32_t electricityConsumedCompressorHeating;
  uint32_t energyProducedCompressorHeating;
  int16_t power1;
  int16_t power2;
  int16_t COP_realtime;
  float LWT;
  float RWT;
  float MWT;
  float Flow;
  bool compressor;
  byte selectTimeString;
  byte climateModeACH; // bits 7-6 CH active; 5-4 CH last-request; 2 auto; 1-0 CH request
  byte climateModeC; // heating 0 cooling 1
  byte climateMode;
  byte controlRTX10;
  byte heatingOnlyX10;
  byte defrostActive;
  byte useDHW;
  byte numberOfLWTzonesX10;
  byte allowModulationX10;
  byte modulationMaxX10;
  uint16_t DHWsetpointMaxX10;
  uint16_t LWTheatMainMaxX10;
  uint16_t LWTheatMainMinX10;
  uint16_t LWTheatAddMaxX10;
  uint16_t LWTheatAddMinX10;
  uint16_t LWTcoolMainMaxX10;
  uint16_t LWTcoolMainMinX10;
  uint16_t LWTcoolAddMaxX10;
  uint16_t LWTcoolAddMinX10;
  uint16_t roomTempHeatingMinX10;
  uint16_t roomTempHeatingMaxX10;
  uint16_t roomTempCoolingMinX10;
  uint16_t roomTempCoolingMaxX10;
  byte HCmode;
  byte prevSec;
  byte prevMin;
  byte first030;
  byte first030a;
  byte overshootX10;
  byte quietMode;
  byte quietLevel;
  byte presetMode;
  byte coolingComfort;
  byte coolingEco;
  byte heatingComfort;
  byte heatingEco;
#endif /* E_SERIES */
};

typedef struct mqttSaveStruct {
  uint16_t Mversion;
  uint16_t MdataLength;
  RTCdata R;
  byte payloadByteVal[sizePayloadByteVal];
  byte payloadByteSeen[sizePayloadByteSeen];
#ifdef E_SERIES
  byte paramVal [2][sizeParamVal];
  byte paramSeen[2][sizeParamSeenDiv8];
  byte cntByte [36]; // for 0xB8 counters we store 36 bytes; 30 should suffice but not worth the extra code
#endif /* E_SERIES */
  byte payloadBitsSeen[sizePayloadBitsSeen];
};

// local
byte bcnt = 0;

mqttSaveStruct M;
#define RTC_VERSION 9
#define M_VERSION 8

// local
byte maxOutputFilter = 0;
uint16_t extraAvailabilityStringLengthMax = 0;
#ifdef E_SERIES
uint32_t espUptime030 = 0;
#endif /* E_SERIES */

// global variable to maintain info from check* to pub*
int16_t pi2 = -1;

void registerSeenByte() {
  if (pi2 >= 0) M.payloadByteSeen[pi2 >> 3] |= (1 << (pi2 & 0x07));
  return;
}

byte newButtons1 = 0; // 15 / 9 static buttons
#ifdef E_SERIES
#define NR_BUTTONS_1 15
byte newButtons2 = 0; // 2 dynamic buttons depending on controlId
#define NR_BUTTONS_2 2
#else
#define NR_BUTTONS_1 9
#endif


byte  createButtonsSwitches1(void) {
  byte nrButtonsLeft = NR_BUTTONS_1;
#ifdef E_SERIES
  if (newButtons1 >= nrButtonsLeft--) {
    HARESET;
    KEY("EEPROM_ESP_Set_Cons_Prod_Counters");
    SUBDEVICE("_Bridge");
    HADEVICE_BUTTON;
    //  HADEVICE_BUTTON_CLASS("*");
    HADEVICE_BUTTON_COMMAND("D13");
    HADEVICE_AVAILABILITY("A\/9\/HA_Setup", 1, 0);
    if (!publishHomeAssistantConfig(deviceSubName, haDevice, haEntity, haEntityCategory, haPrecision, haButtonDeviceClass, useSrc)) return 0;
    newButtons1 = nrButtonsLeft;
  }
  if (newButtons1 >= nrButtonsLeft--) {
    HARESET;
    KEY("Daikin_Restart_Careful");
    SUBDEVICE("_FieldSettings");
    HADEVICE_BUTTON;
    HADEVICE_BUTTON_CLASS("restart");
    HADEVICE_BUTTON_COMMAND("L99");
    if (!publishHomeAssistantConfig(deviceSubName, haDevice, haEntity, haEntityCategory, haPrecision, haButtonDeviceClass, useSrc)) return 0;
    newButtons1 = nrButtonsLeft;
  }
  if (newButtons1 >= nrButtonsLeft--) {
    HARESET;
    KEY("Daikin_Defrost_Request");
    SUBDEVICE("_Mode");
    HADEVICE_BUTTON;
    //  HADEVICE_BUTTON_CLASS("*");
    HADEVICE_BUTTON_COMMAND("E35003601");
    HADEVICE_AVAILABILITY("A\/8\/Control_Function", 1, 0);
    if (!publishHomeAssistantConfig(deviceSubName, haDevice, haEntity, haEntityCategory, haPrecision, haButtonDeviceClass, useSrc)) return 0;
    newButtons1 = nrButtonsLeft;
  }
  if (newButtons1 >= nrButtonsLeft--) {
    HARESET;
    KEY("Bridge_LCD_Fake_Off");
    SUBDEVICE("_UI");
    HADEVICE_BUTTON;
    //  HADEVICE_BUTTON_CLASS("*");
    HADEVICE_BUTTON_COMMAND("L80");
    HADEVICE_AVAILABILITY("A\/8\/Control_Function", 1, 0);
    if (!publishHomeAssistantConfig(deviceSubName, haDevice, haEntity, haEntityCategory, haPrecision, haButtonDeviceClass, useSrc)) return 0;
    newButtons1 = nrButtonsLeft;
  }
  if (newButtons1 >= nrButtonsLeft--) {
    HARESET;
    KEY("Bridge_Mode_0_Normal_User");
    SUBDEVICE("_UI");
    HADEVICE_BUTTON;
    //  HADEVICE_BUTTON_CLASS("*");
    HADEVICE_BUTTON_COMMAND("L90");
    HADEVICE_AVAILABILITY("A\/8\/Control_Function", 1, 0);
    if (!publishHomeAssistantConfig(deviceSubName, haDevice, haEntity, haEntityCategory, haPrecision, haButtonDeviceClass, useSrc)) return 0;
    newButtons1 = nrButtonsLeft;
  }
  if (newButtons1 >= nrButtonsLeft--) {
    HARESET;
    KEY("Bridge_Mode_1_Advanced_User");
    SUBDEVICE("_UI");
    HADEVICE_BUTTON;
    //  HADEVICE_BUTTON_CLASS("*");
    HADEVICE_BUTTON_COMMAND("L91");
    HADEVICE_AVAILABILITY("A\/8\/Control_Function", 1, 0);
    if (!publishHomeAssistantConfig(deviceSubName, haDevice, haEntity, haEntityCategory, haPrecision, haButtonDeviceClass, useSrc)) return 0;
    newButtons1 = nrButtonsLeft;
  }
#endif /* E_SERIES */
  if (newButtons1 >= nrButtonsLeft--) {
    HARESET;
    KEY("Restart_P1P2Monitor_ATmega");
    SUBDEVICE("_Bridge");
    HADEVICE_BUTTON;
    HADEVICE_BUTTON_CLASS("restart");
    HADEVICE_BUTTON_COMMAND("A");
    if (!publishHomeAssistantConfig(deviceSubName, haDevice, haEntity, haEntityCategory, haPrecision, haButtonDeviceClass, useSrc)) return 0;
    newButtons1 = nrButtonsLeft;
  }
  if (newButtons1 >= nrButtonsLeft--) {
    HARESET;
    KEY("Restart_P1P2MQTT_ESP");
    SUBDEVICE("_Bridge");
    HADEVICE_BUTTON;
    HADEVICE_BUTTON_CLASS("restart");
    HADEVICE_BUTTON_COMMAND("D0");
    if (!publishHomeAssistantConfig(deviceSubName, haDevice, haEntity, haEntityCategory, haPrecision, haButtonDeviceClass, useSrc)) return 0;
    newButtons1 = nrButtonsLeft;
  }
  if (newButtons1 >= nrButtonsLeft--) {
    HARESET;
    KEY("MQTT_Rebuild");
    SUBDEVICE("_Bridge");
    HADEVICE_BUTTON;
    HADEVICE_BUTTON_CLASS("restart");
    HADEVICE_BUTTON_COMMAND("D3");
    if (!publishHomeAssistantConfig(deviceSubName, haDevice, haEntity, haEntityCategory, haPrecision, haButtonDeviceClass, useSrc)) return 0;
    newButtons1 = nrButtonsLeft;
  }
  if (newButtons1 >= nrButtonsLeft--) {
    HARESET;
    KEY("MQTT_Delete_Own_Rebuild");
    SUBDEVICE("_Setup");
    HADEVICE_BUTTON;
    HADEVICE_BUTTON_CLASS("update");
    HADEVICE_BUTTON_COMMAND("D12");
    HADEVICE_AVAILABILITY("A\/9\/HA_Setup", 1, 0);
    if (!publishHomeAssistantConfig(deviceSubName, haDevice, haEntity, haEntityCategory, haPrecision, haButtonDeviceClass, useSrc)) return 0;
    newButtons1 = nrButtonsLeft;
  }
  if (newButtons1 >= nrButtonsLeft--) {
    HARESET;
    KEY("MQTT_Delete_All_Rebuild");
    SUBDEVICE("_Setup");
    HADEVICE_BUTTON;
    HADEVICE_BUTTON_CLASS("update");
    HADEVICE_BUTTON_COMMAND("D14");
    HADEVICE_AVAILABILITY("A\/9\/HA_Setup", 1, 0);
    if (!publishHomeAssistantConfig(deviceSubName, haDevice, haEntity, haEntityCategory, haPrecision, haButtonDeviceClass, useSrc)) return 0;
    newButtons1 = nrButtonsLeft;
  }
  if (newButtons1 >= nrButtonsLeft--) {
    HARESET;
    KEY("EEPROM_ESP_Save_Changes");
    SUBDEVICE("_Bridge");
    HADEVICE_BUTTON;
    HADEVICE_BUTTON_CLASS("update");
    HADEVICE_BUTTON_COMMAND("D5");
    if (!publishHomeAssistantConfig(deviceSubName, haDevice, haEntity, haEntityCategory, haPrecision, haButtonDeviceClass, useSrc)) return 0;
    newButtons1 = nrButtonsLeft;
  }
  if (newButtons1 >= nrButtonsLeft--) {
    HARESET;
    KEY("EEPROM_ESP_Undo_Changes");
    SUBDEVICE("_Bridge");
    HADEVICE_BUTTON;
    HADEVICE_BUTTON_CLASS("restart");
    HADEVICE_BUTTON_COMMAND("D6");
    if (!publishHomeAssistantConfig(deviceSubName, haDevice, haEntity, haEntityCategory, haPrecision, haButtonDeviceClass, useSrc)) return 0;
    newButtons1 = nrButtonsLeft;
  }
  if (newButtons1 >= nrButtonsLeft--) {
    HARESET;
    KEY("Factory_Reset_ESP_After_Restart");
    SUBDEVICE("_Setup");
    HADEVICE_BUTTON;
    HADEVICE_BUTTON_CLASS("update");
    HADEVICE_BUTTON_COMMAND("D7");
    HADEVICE_AVAILABILITY("A\/9\/HA_Setup", 1, 0);
    if (!publishHomeAssistantConfig(deviceSubName, haDevice, haEntity, haEntityCategory, haPrecision, haButtonDeviceClass, useSrc)) return 0;
    newButtons1 = nrButtonsLeft;
  }
  if (newButtons1 >= nrButtonsLeft--) {
    HARESET;
    KEY("Factory_Reset_ESP_Cancel");
    SUBDEVICE("_Setup");
    HADEVICE_BUTTON;
    HADEVICE_BUTTON_CLASS("restart");
    HADEVICE_BUTTON_COMMAND("D8");
    if (!publishHomeAssistantConfig(deviceSubName, haDevice, haEntity, haEntityCategory, haPrecision, haButtonDeviceClass, useSrc)) return 0;
    newButtons1 = nrButtonsLeft;
  }
  return 1;
}

#ifdef E_SERIES
byte  createButtonsSwitches2(void) {
  byte nrButtonsLeft = NR_BUTTONS_2;
  if (newButtons2 >= nrButtonsLeft--) {
    HARESET;
    KEY("Bridge_LCD_Fake_On");
    SUBDEVICE("_UI");
    HADEVICE_BUTTON;
    //  HADEVICE_BUTTON_CLASS("*");
    HADEVICE_BUTTON_COMMAND("L81");
    HADEVICE_AVAILABILITY("A\/8\/Control_Function", 1, 0);
    HADEVICE_AVAILABILITY("S\/2\/Main_LCD_Light", 0, 1); // Only available if main LCD is off
/*
    switch (controlId) {
      case 0xF0 : HADEVICE_AVAILABILITY("S\/2\/Main_LCD_Light", 0, 1); // Only available if main LCD is off
                  break; 
      case 0xF1 : HADEVICE_AVAILABILITY("S\/4\/Main_LCD_Light", 0, 1); // Only available if main LCD is off
                  break; 
      case 0xFF : HADEVICE_AVAILABILITY("S\/6\/Main_LCD_Light", 0, 1); // Only available if main LCD is off
                  break; 
    }
*/
    if (!publishHomeAssistantConfig(deviceSubName, haDevice, haEntity, haEntityCategory, haPrecision, haButtonDeviceClass, useSrc)) return 0;
    newButtons2 = nrButtonsLeft;
  }
  if (newButtons2 >= nrButtonsLeft--) {
    HARESET;
    KEY("Bridge_Mode_2_Installer");
    SUBDEVICE("_UI");
    HADEVICE_BUTTON;
    //  HADEVICE_BUTTON_CLASS("*");
    HADEVICE_BUTTON_COMMAND("L92");
    HADEVICE_AVAILABILITY("A\/8\/Control_Function", 1, 0);
    HADEVICE_AVAILABILITY("S\/2\/Main_Installer", 0, 1); // Only available if main not in installer mode
/*
    switch (controlId) {
      case 0xF0 : HADEVICE_AVAILABILITY("S\/2\/Main_Installer", 0, 1); // Only available if main not in installer mode
                  break; 
      case 0xF1 : HADEVICE_AVAILABILITY("S\/4\/Main_Installer", 0, 1); // Only available if main not in installer mode
                  break; 
      case 0xFF : HADEVICE_AVAILABILITY("S\/6\/Main_Installer", 0, 1); // Only available if main not in installer mode
                  break; 
    }
*/
    if (!publishHomeAssistantConfig(deviceSubName, haDevice, haEntity, haEntityCategory, haPrecision, haButtonDeviceClass, useSrc)) return 0;
    newButtons2 = nrButtonsLeft;
  }
  return 1;
}
#endif /* E_SERIES */

#ifdef E_SERIES
void resetFieldSettings(void) {
  for (uint16_t j = valstart[0x39 - PARAM_TP_START]; j < valstart[0x3A - PARAM_TP_START]; j++) M.paramVal[0][j] = 0;
  for (uint16_t j = seenstart[0x39 - PARAM_TP_START]; j < seenstart[0x3A - PARAM_TP_START]; j++) M.paramSeen[0][j >> 3] &= (0xFF ^  (1 << (j & 0x07)));
}
#endif /* E_SERIES */

void initDataRTC() {
  // 4 bytes to test the waters
  M.R.RTCversion = RTC_VERSION;
  M.R.RTCdataLength = sizeof(M.R);
// ----------------------------------------------
  M.R.month = 255;
  M.R.wday = 255;
  M.R.hour = 255;
#ifdef E_SERIES
  M.R.electricityConsumedCompressorHeating = 0;
  M.R.energyProducedCompressorHeating = 0;
  M.R.power1 = 0;
  M.R.power2 = 0;
  M.R.COP_realtime = 0;
  M.R.selectTimeString = 0;
  M.R.climateModeACH = 11;
  M.R.climateModeC = 0;
  M.R.LWT = 0;
  M.R.RWT = 0;
  M.R.MWT = 0;
  M.R.Flow = 0;
  M.R.prevSec = 0xFF;
  M.R.prevMin = 0xFF;
  M.R.compressor = 0;
  M.R.useDHW = 3;  // assume 0x01=tank-installed 0x02=DHW-installed (until field setting detection)
  M.R.controlRTX10 = 20; // default 20 = RT
  M.R.numberOfLWTzonesX10 = 0;
  M.R.climateMode = 0; // 0x40=WD 0x00=ABS 0x80/0xC0 = +prog
  M.R.allowModulationX10 = 0;
  M.R.modulationMaxX10 = 0;
  M.R.DHWsetpointMaxX10 = 650; // 750 for tank
  M.R.LWTheatMainMaxX10 = 800;
  M.R.LWTheatMainMinX10 = 250;
  M.R.LWTheatAddMaxX10 = 800;
  M.R.LWTheatAddMinX10 = 250;
  M.R.LWTcoolMainMaxX10 = 220;
  M.R.LWTcoolMainMinX10 =  50;
  M.R.LWTcoolAddMaxX10 = 220;
  M.R.LWTcoolAddMinX10 =  50;
  M.R.roomTempHeatingMinX10 = 120;
  M.R.roomTempHeatingMaxX10 = 300;
  M.R.roomTempCoolingMinX10 = 150;
  M.R.roomTempCoolingMaxX10 = 350;
  M.R.HCmode = 1; // assume heatingMode
  M.R.heatingOnlyX10 = 0; // assume cooling capacity (until field setting detection)
  M.R.defrostActive = 0;
#define heatingMode (M.R.HCmode & 0x01)
#define coolingMode (M.R.HCmode & 0x02)
  M.R.first030 = 0;
  M.R.first030a = 0;
  M.R.overshootX10 = 10;
  M.R.quietMode = 0;
  M.R.quietLevel = 0;
  M.R.presetMode = 0;
  M.R.coolingComfort = 80; // 24C
  M.R.coolingEco = 84;     // 26C
  M.R.heatingComfort = 74; // 21C
  M.R.heatingEco = 70;     // 19C
#endif /* E_SERIES */
}

#define EMPTY_PAYLOAD 0xFF

typedef enum {
  HYSTERESIS_TYPE_NONE,
  HYSTERESIS_TYPE_F8_8_BE,
  HYSTERESIS_TYPE_F8_8_LE,
  HYSTERESIS_TYPE_F8S8_LE,
  HYSTERESIS_TYPE_U8,
  HYSTERESIS_TYPE_S8,
  HYSTERESIS_TYPE_U16_LE,
  HYSTERESIS_TYPE_S16_LE,
  HYSTERESIS_TYPE_U16_BE,
  HYSTERESIS_TYPE_S16_BE,
  HYSTERESIS_TYPE_U32_LE,
//  HYSTERESIS_TYPE_S32_LE,
  HYSTERESIS_TYPE_U32_BE
//  HYSTERESIS_TYPE_S32_BE
} hysttype;

#define HYST_RESET     { applyHysteresisType = HYSTERESIS_TYPE_NONE;   applyHysteresis = 0; }
#define HYST_U8(x)     { applyHysteresisType = HYSTERESIS_TYPE_U8;     applyHysteresis = x; }
#define HYST_S8(x)     { applyHysteresisType = HYSTERESIS_TYPE_S8;     applyHysteresis = x; }
#define HYST_U16_LE(x) { applyHysteresisType = HYSTERESIS_TYPE_U16_LE; applyHysteresis = x; }
#define HYST_U16_BE(x) { applyHysteresisType = HYSTERESIS_TYPE_U16_BE; applyHysteresis = x; }
#define HYST_U32_LE(x) { applyHysteresisType = HYSTERESIS_TYPE_U32_LE; applyHysteresis = x; }
#define HYST_U32_BE(x) { applyHysteresisType = HYSTERESIS_TYPE_U32_BE; applyHysteresis = x; }

#define HYST_S16_LE(x) { applyHysteresisType = HYSTERESIS_TYPE_S16_LE; applyHysteresis = x; }
#define HYST_S16_BE(x) { applyHysteresisType = HYSTERESIS_TYPE_S16_BE; applyHysteresis = x; }

#define HYST_F8_8_LE(x)   { applyHysteresisType = HYSTERESIS_TYPE_F8_8_LE;   applyHysteresis = x; }
#define HYST_F8_8_BE(x)   { applyHysteresisType = HYSTERESIS_TYPE_F8_8_BE;   applyHysteresis = x; }
#define HYST_F8S8_LE(x)   { applyHysteresisType = HYSTERESIS_TYPE_F8S8_LE;   applyHysteresis = x; }

void writePseudoSystemPacket0B(void) {
#ifdef E_SERIES
  readHex[0] = 0x40;
  readHex[1] = 0x00;
  readHex[2] = 0x0B;
  uint16_t COPx1000;
  // COP_before_bridge
  if (EE.electricityConsumedCompressorHeating1 > 0) {
    COPx1000 = (1000 * EE.energyProducedCompressorHeating1) / EE.electricityConsumedCompressorHeating1;
  } else {
    COPx1000 = 0;
  }
  readHex[3] = (COPx1000 >> 8) & 0xFF;
  readHex[4] = COPx1000 & 0xFF;
  // COP_after_bridge
  if ((M.R.electricityConsumedCompressorHeating > EE.electricityConsumedCompressorHeating1) && (EE.electricityConsumedCompressorHeating1 > 0)) {
    COPx1000 = (1000 * (M.R.energyProducedCompressorHeating - EE.energyProducedCompressorHeating1)) / (M.R.electricityConsumedCompressorHeating - EE.electricityConsumedCompressorHeating1);
  } else {
    COPx1000 = 0;
  }
  readHex[5] = (COPx1000 >> 8) & 0xFF;
  readHex[6] = COPx1000 & 0xFF;
  // COP_lifetime
  if (M.R.electricityConsumedCompressorHeating > 0) {
    COPx1000 = (1000 * M.R.energyProducedCompressorHeating) / M.R.electricityConsumedCompressorHeating;
  } else {
    COPx1000 = 0;
  }
  readHex[7] = (COPx1000 >> 8) & 0xFF;
  readHex[8] = COPx1000 & 0xFF;

  writePseudoPacket(readHex, 9);
#endif /* E_SERIES */
}

void writePseudoSystemPacket0C(void) {
  readHex[0] = 0x40;
  readHex[1] = 0x00;
  readHex[2] = 0x0C;
#ifdef E_SERIES
  readHex[3]  = (M.R.power1 >> 8) & 0xFF;
  readHex[4]  = M.R.power1 & 0xFF;

  readHex[5]  = (M.R.power2 >> 8) & 0xFF;
  readHex[6]  = M.R.power2 & 0xFF;

  readHex[7]  = (ePower >> 8) & 0xFF;
  readHex[8]  = ePower & 0xFF;

  readHex[9]   = (eTotal >> 24) & 0xFF;
  readHex[10]  = (eTotal >> 16) & 0xFF;
  readHex[11]  = (eTotal >> 8) & 0xFF;
  readHex[12]  = eTotal & 0xFF;

  readHex[13] = (M.R.COP_realtime >> 8) & 0xFF;
  readHex[14] = M.R.COP_realtime & 0xFF;

  readHex[15]  = (bPower >> 8) & 0xFF;
  readHex[16]  = bPower & 0xFF;

  readHex[17]  = (bTotal >> 24) & 0xFF;
  readHex[18]  = (bTotal >> 16) & 0xFF;
  readHex[19]  = (bTotal >> 8) & 0xFF;
  readHex[20]  = bTotal & 0xFF;

  writePseudoPacket(readHex, 21);
#endif /* E_SERIES */
#ifdef W_SERIES
  readHex[3] = (electricityMeterActivePower >> 8) & 0xFF;
  readHex[4] =  electricityMeterActivePower       & 0xFF;
  readHex[5] = (electricityMeterTotal      >> 24) & 0xFF;
  readHex[6] = (electricityMeterTotal      >> 16) & 0xFF;
  readHex[7] = (electricityMeterTotal       >> 8) & 0xFF;
  readHex[8] =  electricityMeterTotal             & 0xFF;
  writePseudoPacket(readHex, 9);
#endif /* W_SERIES */
}

void writePseudoSystemPacket0D(void) {
  readHex[0] = 0x40;
  readHex[1] = 0x00;
  readHex[2] = 0x0D;
#ifdef E_SERIES
  if (M.R.climateModeACH & 0x02) {
    M.R.climateModeC = 1; // cooling (request)
  } else if (M.R.climateModeACH & 0x01) {
    M.R.climateModeC = 0; // heating (request)
  } else if (M.R.climateModeACH & 0x80) {
    M.R.climateModeC = 1; // cooling (actual)
  } else if (M.R.climateModeACH & 0x40) {
    M.R.climateModeC = 0; // heating (actual)
  } else if (M.R.climateModeACH & 0x20) {
    M.R.climateModeC = 1; // cooling (historic)
  } else if (M.R.climateModeACH & 0x10) {
    M.R.climateModeC = 0; // heating (historic)
  } else {
    M.R.climateModeC = 0; // oh ?
  };
  readHex[3] = M.R.climateModeC;
  if (M.R.climateModeACH & 0x04) readHex[3] = 2; // auto
  readHex[4] = M.R.controlRTX10 / 10;
  readHex[5] = M.R.controlRTX10  ? 1 : 0;

  readHex[6] = M.R.allowModulationX10 / 10;
  readHex[7] = M.R.modulationMaxX10 / 10;
  readHex[8] = (M.R.numberOfLWTzonesX10 / 10) + 1;

  readHex[9] = eTotalAvailable;
  readHex[10] = bTotalAvailable;

  readHex[11] = M.R.overshootX10 / 10;
  readHex[12] = M.R.quietMode;
  readHex[13] = M.R.quietLevel;
  readHex[14] = M.R.presetMode;

  readHex[15] = M.R.heatingComfort;
  readHex[16] = M.R.heatingEco;
  readHex[17] = M.R.coolingComfort;
  readHex[18] = M.R.coolingEco;
  writePseudoPacket(readHex, 19);
#endif /* E_SERIES */
}

uint8_t clientPublish(const char* mqtt_value, uint8_t qos) {
  topicCharSpecificSlash('P'); // slash to add entityname
  if (EE.outputMode & 0x0020) clientPublishTelnet(mqttTopic, mqtt_value);
  if (EE.outputMode & 0x0002) return clientPublishMqtt(mqttTopic, qos, MQTT_RETAIN_DATA, mqtt_value);
  return 1;
}

uint32_t u_payloadValue_LE(byte* payloadIndexed, byte valLength) {
  uint32_t v = 0;
  byte* p = payloadIndexed + 1 - valLength;
  for (byte i = valLength; i > 0; i--) { v <<= 8 ; v |= *p++ ; }
  return v;
}

int32_t s_payloadValue_LE(byte* payloadIndexed, byte valLength) {
  uint32_t t = u_payloadValue_LE(payloadIndexed, valLength);
  switch (valLength) {
    case 1 : if (t & 0x80) t |= 0xFFFFFF00; break;
    case 2 : if (t & 0x8000) t |= 0xFFFF0000; break;
    case 3 : if (t & 0x800000) t |= 0xFF000000; break;
    case 4 : break;
  }
  return (int32_t) t;
}

uint32_t u_payloadValue_BE(byte* payloadIndexed, byte valLength) {
  uint32_t v = 0;
  byte* p = payloadIndexed;
  for (byte i = valLength; i > 0; i--) { v <<= 8 ; v |= *p--; }
  return v;
}

// within loop
uint16_t applyHysteresis = 0;
byte applyHysteresisType = 0;

// global variable to maintain info from newCheckPayloadBytesVal to newCheckPayloadBitsVal

#ifdef H_SERIES
byte calculatePti(const byte packetSrc, const byte packetType, byte* payload)
#else /* H_SERIES */
byte calculatePti(const byte packetSrc, const byte packetDst, const byte packetType)
#endif /* H_SERIES */
{
  byte pti;
#ifdef E_SERIES
  switch (packetType) {
    case PCKTP_START ... 0x15 : pti = packetType - PCKTP_START;
                break;
    case 0x30 : pti = (PCKTP_END - PCKTP_START) + 1;
                break;
    case 0x31 : pti = (PCKTP_END - PCKTP_START) + 2;
                // aux_split reply only:
                if (packetSrc == 0x40) switch (packetDst) {
                  case 0xF0 : break;
                  case 0xFF : pti++;
                              // fall-through
                  case 0xF2 : pti++;
                              // fall-through
                  case 0xF1 : pti++; break;
                  default   : pti = 0xFF;
                }
                break;
    case 0x32 : pti = (PCKTP_END - PCKTP_START) + 6;
                switch (packetDst) {
                  case 0xF0 : break;
                  case 0xFF : pti++;
                              // fall-through
                  case 0xF2 : pti++;
                              // fall-through
                  case 0xF1 : pti++; break;
                  default   : pti = 0xFF;
                }
                break;
    case 0x20 : pti = (PCKTP_END - PCKTP_START) + 10;
                break;
    case 0x21 : pti = (PCKTP_END - PCKTP_START) + 11;
                break;
    case 0x60 ... 0x8F : pti = 0xFE; // no history, handle as new
                break;
    case 0x90 ... 0x9F : pti = (PCKTP_END - PCKTP_START) + 12 + (packetType - 0x90);
                break;
    default   : pti = 0xFF; break;
  }
  switch (packetSrc) {
    case 0x00  : // do nothing
                 break;
    case 0x40  : if (pti != 0xFF) pti += PCKTP_ARR_BLOCK;
                 break;
    case 0x80  : pti = (PCKTP_ARR_BLOCK << 1); // overrule earlier pti calculation
                 switch (packetType) {
                   case 0x00 ... 0x05 : pti = 0xFE; break;
                   case 0x10 : break;
                   case 0x18 : pti++;
                               break;
                   default :   pti = 0xFF;
                               break;
                 }
                 break;
    default    : pti = 0xFF;
                 break;
  }

  if ((pti < 0xFE) && (pti >= PCKTP_ARR_SZ)) {
    printfTopicS("pti error pti 0x%02X packetSrc 0x%02X packetDst 0x%02X packetType 0x%02X\n", pti, packetSrc, packetDst, packetType);
    pti = 0xFF;
  }

#elif defined W_SERIES /* *_SERIES */

  switch (packetType) {
    case 0x0C ... 0x0F : pti = packetType - PCKTP_START;
                break;
    default   : pti = 0xFF; break;
  }
  if (pti != 0xFF) switch (packetSrc) {
    case 0x00  : // do nothing
                 break;
    case 0x40  : pti += PCKTP_ARR_BLOCK;
                 break;
    default    : // do nothing
                 break;
  }

#elif defined F_SERIES /* *_SERIES */

   switch (packetType) {
    case 0x08 ... 0x12 : pti = packetType - PCKTP_START; break;        // 0 .. 9  -> 0..10
    case          0x15 : pti = 0x13 - PCKTP_START; break;              //       11
    case          0x17 : pti = 0x14 - PCKTP_START; break;              //       12
    case          0x18 : pti = 0x15 - PCKTP_START; break;              // 10 -> 13 // +3
    case          0x19 : pti = 0x16 - PCKTP_START; break;              //       14
    case          0x1F : pti = 0x17 - PCKTP_START; break;              // 11 // +4 -> 15
    case          0x20 : pti = 0x18 - PCKTP_START; break;              // 12 -> 16
    case          0x21 : pti = 0x19 - PCKTP_START; break;              // 13 -> 17
    case 0x30 ... 0x3F : pti = packetType - 30; break;                 // 14 .. 29 +4 -> 18..33
    case          0x80 : pti = 34; break;                              // 30 -> 34
    case          0xA1 : pti = 35; break;                              //       35
    case          0xA3 : pti = 36; break;                              // 31 -> 36
    case          0xB1 : pti = 37; break;                              //       37
    default            : pti = 0xFF; break;                            // no history
  }
  if (pti != 0xFF) switch (packetSrc) {
    case 0x00  : // do nothing
                 break;
    case 0x40  : pti += PCKTP_ARR_BLOCK;
                 break;
    case 0x80  : pti = (PCKTP_ARR_BLOCK << 1); // overrule earlier pti calculation
                 switch (packetType) {
                   case 0x18 : break;
                   default :   pti = 0xFF;
                               break;
                 }
                 break;
    default    : // do nothing
                 break;
  }

#elif defined F1F2_SERIES || defined M_SERIES /* *_SERIES */

   switch (packetType) {
    case 0x08 ... 0x0F : pti = packetType - PCKTP_START; break;
    default            : pti = 0xFF; break;                            // no history
  }
  if (pti != 0xFF) switch (packetSrc) {
    case 0x00  : // do nothing
                 break;
    case 0x40  : pti += PCKTP_ARR_BLOCK;
                 break;
    default    : // do nothing
                 break;
  }

#elif defined H_SERIES /* *_SERIES */

# if HITACHI_MODEL == 3

  pti = 0xFF; // default

  switch (packetType) { // pseudo packets
    case 0x08 ... 0x0F : pti = packetType - (packetSrc ? 0 : 8); break;
  }

  switch ((packetSrc << 8) | packetType) {
    case 0x211C : pti = 0x10; break;
    case 0x892D : switch (payload[0x06]) {
      case 0x01 : pti = 0x11; break;
      case 0x06 : pti = 0x12; break;
    } break;
    case 0x411E : if (payload[0x01] == 0x01) {
      pti = 0x13;
    } break;
  }

# else /* HITACHI_MODEL */

  switch (packetType) {
    // pseudo packets
    case 0x08 ... 0x0F : pti = packetType - (packetSrc ? 0 : 8); break;
    default: pti = 0xFF; break;
  }
  byte payload7 = (packetType > 7) ? payload[4] : 0;
  switch ((packetSrc << 8) | packetType) {
    // HLINK packets jetblack
    case 0x210B : pti = 0x10; break;
    case 0x2112 : pti = 0x11; break;
    case 0x4118 : pti = 0x12; break;
    case 0x8927 : pti = 0x13; break;
    case 0x892D : pti = 0x14; break;
    // new in v0.9.39
    case 0x2129 : pti = ((payload7 < 0xF1) || (payload7 > 0xF5)) ? 0xFF : 0x15 + (payload7 - 0xF1); break;
    case 0x8917 : /* fall-through */
    case 0x8929 : pti = ((payload7 < 0xE1) || (payload7 > 0xE5)) ? 0xFF : 0x15 + (payload7 - 0xE1); break;
    // new in v0.9.39a
    case 0x4129 : pti = 0x1F; break;
    case 0x8A29 : pti = 0x20; break;
    // new in v0.9.45
    case 0x1909 : pti = 0x21; break;
    case 0x190A : pti = 0x22; break;
    case 0x1910 : pti = 0x23; break;
    case 0x230A : pti = 0x24; break;
    case 0x231C : pti = 0x25; break;
    case 0x2909 : pti = 0x26; break;
    case 0x4909 : pti = 0x27; break;
    case 0x4923 : pti = 0x28; break;
    case 0x4930 : pti = 0x29; break;
    // new in v0.9.47
    case 0x211C : pti = 0x2A; break;
    // new in v0.9.55rc1
    case 0x792E : pti = 0x2B; break;
    case 0xFF23 : pti = 0x2C; break;
    default     : break;
  }

# endif /* HITACHI_MODEL */

#elif defined MHI_SERIES /* *_SERIES */

  switch (packetSrc) {
    // MHI packets
    case 0x00 : pti = 0x00; break;
    case 0x01 : pti = 0x01; break;
    case 0x02 ... 0x07 : pti = 0x02; break;
    case 0x80 : pti = 0x03; break;
    case 0x81 : pti = 0x04; break;
    default : pti = 0xFF; break;
  }

#endif /* *_SERIES */
  return pti;
}

void checkSize() {
#ifdef E_SERIES
  for (byte i = 1; i < PARAM_ARR_SZ; i++) {
// correct for byte-aligning seenstart[0x39]
    if (seenstart[i] != seenstart[i - 1] + nr_params[i - 1] + (  (PARAM_TP_START + i == 0x39) ? 0 : 0)) printfTopicS("seenstart error i %i seenstart[i] 0x%04X seenstart[i-1] 0x%04X nr_params[i-1] 0x%04X", i, seenstart[i], seenstart[i-1], nr_params[i-1]);
    if (valstart[i] != valstart[i - 1] + nr_params[i - 1] * parnr_bytes[i - 1]) printfTopicS("valstart error i 0x%04X valstart[i] 0x%04X valstart[i-1] 0x%04X nr_params[i-1] 0x%04X", i, valstart[i], valstart[i-1], nr_params[i-1]);
  }
  for (byte packetSrc = 0x00; packetSrc <= 0x40; packetSrc += 0x80) {
    for (byte packetDst = 0xF0; packetDst != 0x01; packetDst += 0x01) {
      for (byte packetType = 0x00; packetType != 0xFF; packetType += 0x01) {
        byte pti = calculatePti(packetSrc, packetDst, packetType);
//        printfTopicS("pti check pti 0x%02X ptiCheck [pti] 0x%02X packetSrc 0x%02X packetDst 0x%02X packetType 0x%02X", pti, ptiCheck [ pti], packetSrc, packetDst, packetType);
        if (pti < 0xFE) {
          if (ptiCheck[ pti ] != packetType) {
            printfTopicS("pti error pti 0x%02X ptiCheck [pti] 0x%02X packetSrc 0x%02X packetDst 0x%02X packetType 0x%02X", pti, ptiCheck [ pti], packetSrc, packetDst, packetType);
          } else {
//            printfTopicS("pti OK    pti 0x%02X ptiCheck [pti] 0x%02X packetSrc 0x%02X packetDst 0x%02X packetType 0x%02X", pti, ptiCheck [ pti], packetSrc, packetDst, packetType);
          }
        }
      }
    }
  }
#endif /* E_SERIES */
  for (uint16_t i = 1; i < PCKTP_ARR_SZ; i++) {
    if (bytestart[i - 1] + nr_bytes[i - 1] >= sizePayloadByteVal) break; // stop at last valid entry
    if (bytestart[i] != bytestart[i - 1] + nr_bytes[i - 1]) printfTopicS("bytestart error i %i bytestart[i] 0x%04X bytestart[i-1] 0x%04X nr_bytes[i-1]", i, bytestart[i], bytestart[i-1], nr_bytes[i-1]);
  }
}

void resetDataStructures(void) {
  checkSize();
  M.Mversion = M_VERSION;
  M.MdataLength = sizeof(M);
  for (uint16_t j = 0; j < sizePayloadByteVal; j++) {
    M.payloadByteVal[j]  = 0;
  }
  for (uint16_t j = 0; j < sizePayloadByteSeen; j++) {
    M.payloadByteSeen[j] = 0;
  }
#ifdef E_SERIES
  for (byte i = 0; i < 2; i++) {
    for (uint16_t j = 0; j < sizeParamVal; j++)  if ((j < valstart[0x39 - PARAM_TP_START])  || (j >= valstart[0x3A - PARAM_TP_START])  || (i == 1)) M.paramVal[i][j] = 0;
    for (uint16_t j = 0; j < sizeParamSeen; j++) if ((j < seenstart[0x39 - PARAM_TP_START]) || (j >= seenstart[0x3A - PARAM_TP_START]) || (i == 1)) M.paramSeen[i][j >> 3] &= (0xFF ^  (1 << (j & 0x07)));
  }
  for (byte j = 0; j < 36; j++) M.cntByte[j] = 0xFF;
#endif /* E_SERIES */
  for (byte j = 0; j < sizePayloadBitsSeen; j++) {
    M.payloadBitsSeen[j] = 0;
  }
#ifdef SAVESCHEDULE
  byte i;
  uint16 j;
  for (i = 0; i < 2; i++) {
    for (j = 0; j < SCHEDULE_MEM_SIZE; j++) scheduleMem[i][j] = 0;
    for (j = 0; j < SCHEDULE_MEM_SIZE; j++) scheduleMemSeen[i][j] = false;
  }
#endif /* SAVESCHEDULE */
}

uint16_t newCheckPayloadBytesVal(byte packetSrc, byte packetDst, byte packetType, byte payloadIndex, byte* payload, byte length, bool byteBasis) {
// returns (8-bit pubHa, 8-bit pubEntity)
// returns (as pubHa) if homeassistant config msg should be published
// returns (as pubEntity) which bits are new or, if (EE.outputFilter <= maxOutFilter), have been changed subject to an optional hysteresis check

  if (payloadIndex == EMPTY_PAYLOAD) {
    return 0;
  }

  byte newBits = 0;
  byte changedBits = (EE.outputFilter ? 0x00 : 0xFF);

#ifdef H_SERIES
  byte pti = calculatePti(packetSrc, packetType, payload); // pti index for nr_bytes/bytestart arrays
#else /* H_SERIES */
  byte pti = calculatePti(packetSrc, packetDst, packetType); // pti index for nr_bytes/bytestart arrays
#endif /* H_SERIES */

  if ((pti < 0xFE) && (pti >= PCKTP_ARR_SZ)) {
    printfTopicS("pti 0x%02X >= 0x%02X for Src 0x%02X Tp 0x%02X", pti, PCKTP_ARR_SZ, packetSrc, packetType);
    return 0;
  }
  if (pti == 0xFE) return 1; // always handle as new, but not for HA, meant for 0x80 boot messages
#ifdef MHI_SERIES
  if (pti == 0xFF) {
    printfTopicS("Unknown packetSrc 0x%02X", packetSrc);
    return 0;
  }
  if (length && (payloadIndex >= nr_bytes[pti])) {
    pti = 0xFF; // for BitsVal
#ifdef W_SERIES
    if (packetType != 0x0C)
#endif /* W_SERIES */
    printfTopicS("Warning: payloadIndex %i >= expected %i for Src 0x%02X", payloadIndex, nr_bytes[pti], packetSrc);
    return 0;
  }
#endif /* MHI_SERIES */
#ifdef E_SERIES
  if (packetType == 0xB8) {
    // Handle 0xB8 history
    pi2 = payloadIndex;
    if (pi2 > 13) pi2 += 2;
    pi2 >>= 2; // if payloadIndex is 3, 6, 9, 12, 15, 18, pi2 is now 0..5
    pi2 += 6 * payload[0];
    if (M.cntByte[pi2] & 0x80) {
      newBits = 1;
      // MQTT discovery
      topicCharSpecific('P');
      snprintf_P(extraAvailabilityString, EXTRA_AVAILABILITY_STRING_LEN, PSTR(",{\"topic\":\"%s\/A\/8\/Counter_Request_Function\",\"pl_avail\":1,\"pl_not_avail\":0}")
      , mqttTopic // (P)
      );
    }
    // it's a 3-byte (slow) counter, so sufficient if we look at the 7 least significant bits LSB byte (LE); bit 7 = "!seen"
    if ((M.cntByte[pi2] != (payload[payloadIndex] & 0x7F)) && (EE.outputFilter <= maxOutputFilter)) newBits = 1;
    return ((M.cntByte[pi2] & 0x80) << 1) | newBits;
  }
#endif /* E_SERIES */
#ifndef MHI_SERIES
  if (pti == 0xFF) {
    printfTopicS("Unknown packetSrc 0x%02X packetDst 0x%02X packetType 0x%02X index %i", packetSrc, packetDst, packetType, payloadIndex);
    return 0;
  }
  if (length && (payloadIndex >= nr_bytes[pti])) {
    printfTopicS("Warning: payloadIndex %i >= expected %i for Src 0x%02X Type 0x%02X", payloadIndex, nr_bytes[pti], packetSrc, packetType);
    pti = 0xFF; // for BitsVal
    return 0;
  }
#endif /* !MHI_SERIES */
  if (payloadIndex + 1 < length) {
    // Warning: payloadIndex + 1 < length
    printfTopicS("Warning: payloadIndex + 1 < length");
    return 0;
  }
  bool skipHysteresis = false;
  pi2 = bytestart[pti] + payloadIndex;

  if (applyHysteresisType && (pi2 < sizePayloadByteVal) && (M.payloadByteSeen[pi2 >> 3] && (1 << (pi2 & 0x07)))) {
    switch (applyHysteresisType) {
      case HYSTERESIS_TYPE_F8_8_BE : { int16_t oldValue = ((int8_t) M.payloadByteVal[pi2]) * 256 + M.payloadByteVal[pi2 - 1];
                                       int16_t newValue = ((int8_t) payload[payloadIndex]) * 256 + payload[payloadIndex - 1];
                                       skipHysteresis = ((newValue <= oldValue + (int16_t) applyHysteresis) && (newValue + (int16_t) applyHysteresis >= oldValue));
                                     }
                                     break;
      case HYSTERESIS_TYPE_F8_8_LE : { int16_t oldValue = ((int8_t) M.payloadByteVal[pi2 - 1]) * 256 + M.payloadByteVal[pi2];
                                       int16_t newValue = ((int8_t) payload[payloadIndex - 1]) * 256 + payload[payloadIndex];
                                       skipHysteresis = ((newValue <= oldValue + (int16_t) applyHysteresis) && (newValue + (int16_t) applyHysteresis >= oldValue));
                                     }
                                     break;
      case HYSTERESIS_TYPE_F8S8_LE : { int16_t oldValue = ((int8_t) M.payloadByteVal[pi2 - 1]) * 10 + M.payloadByteVal[pi2];
                                       int16_t newValue = ((int8_t) payload[payloadIndex - 1]) * 10 + payload[payloadIndex];
                                       skipHysteresis = ((newValue <= oldValue + (int16_t) applyHysteresis) && (newValue + (int16_t) applyHysteresis >= oldValue));
                                     }
                                     break;
      case HYSTERESIS_TYPE_U16_BE:   { uint16_t oldValue = u_payloadValue_BE(M.payloadByteVal + pi2, 2);
                                       uint16_t newValue = u_payloadValue_BE(payload + payloadIndex, 2);
                                       skipHysteresis = ((newValue <= oldValue + applyHysteresis) && (newValue + applyHysteresis >= oldValue));
                                     }
                                     break;
      case HYSTERESIS_TYPE_U32_BE:   { uint32_t oldValue = u_payloadValue_BE(M.payloadByteVal + pi2, 4);
                                       uint32_t newValue = u_payloadValue_BE(payload + payloadIndex, 4);
                                       skipHysteresis = ((newValue <= oldValue + applyHysteresis) && (newValue + applyHysteresis >= oldValue));
                                     }
                                     break;
      case HYSTERESIS_TYPE_S16_BE:   { int16_t oldValue = (uint16_t) u_payloadValue_BE(M.payloadByteVal + pi2, 2);
                                       int16_t newValue = (uint16_t) u_payloadValue_BE(payload + payloadIndex, 2);
                                       skipHysteresis = ((newValue <= oldValue + (int16_t) applyHysteresis) && (newValue + (int16_t) applyHysteresis >= oldValue));
                                     }
                                     break;
//    case HYSTERESIS_TYPE_S32_BE:   { int32_t oldValue = u_payloadValue_BE(M.payloadByteVal + pi2, 4);
//                                     int32_t newValue = u_payloadValue_BE(payload + payloadIndex, 4);
//                                     skipHysteresis = ((newValue <= oldValue + (int16_t) applyHysteresis) && (newValue + (int16_t) applyHysteresis >= oldValue));
//                                   }
//                                   break;
      case HYSTERESIS_TYPE_U8:       { uint8_t oldValue = u_payloadValue_LE(M.payloadByteVal + pi2, 1);
                                       uint8_t newValue = u_payloadValue_LE(payload + payloadIndex, 1);
                                       skipHysteresis = ((newValue <= oldValue + applyHysteresis) && (newValue + applyHysteresis >= oldValue));
                                     }
                                     break;
      case HYSTERESIS_TYPE_S8:       { int8_t oldValue = (uint8_t) u_payloadValue_LE(M.payloadByteVal + pi2, 1);
                                       int8_t newValue = (uint8_t) u_payloadValue_LE(payload + payloadIndex, 1);
                                       skipHysteresis = ((newValue <= oldValue + applyHysteresis) && (newValue + applyHysteresis >= oldValue));
                                     }
                                     break;
      case HYSTERESIS_TYPE_U16_LE:   { uint16_t oldValue = u_payloadValue_LE(M.payloadByteVal + pi2, 2);
                                       uint16_t newValue = u_payloadValue_LE(payload + payloadIndex, 2);
                                       skipHysteresis = ((newValue <= oldValue + applyHysteresis) && (newValue + applyHysteresis >= oldValue));
                                     }
                                     break;
      case HYSTERESIS_TYPE_U32_LE:   { uint32_t oldValue = u_payloadValue_LE(M.payloadByteVal + pi2, 4);
                                       uint32_t newValue = u_payloadValue_LE(payload + payloadIndex, 4);
                                       skipHysteresis = ((newValue <= oldValue + applyHysteresis) && (newValue + applyHysteresis >= oldValue));
                                     }
                                     break;
      case HYSTERESIS_TYPE_S16_LE:   { int16_t oldValue = (uint16_t) u_payloadValue_LE(M.payloadByteVal + pi2, 2);
                                       int16_t newValue = (uint16_t) u_payloadValue_LE(payload + payloadIndex, 2);
                                       skipHysteresis = ((newValue <= oldValue + (int16_t) applyHysteresis) && (newValue + (int16_t) applyHysteresis >= oldValue));
                                     }
                                     break;
//    case HYSTERESIS_TYPE_S32_LE:   { int32_t oldValue = u_payloadValue_LE(M.payloadByteVal + pi2, 2);
//                                     int32_t newValue = u_payloadValue_LE(payload + payloadIndex, 2);
//                                     skipHysteresis = ((newValue <= oldValue + (int16_t) applyHysteresis) && (newValue + (int16_t) applyHysteresis >= oldValue));
//                                   }
//                                   break;
      default :                      skipHysteresis = false;
                                     break;
    }
  }

  if (byteBasis) {
    newBits = (M.payloadByteSeen[pi2 >> 3] & (1 << (pi2 & 0x07))) ? 0 : 1;
  } else {
    if (bcnt >= sizePayloadBitsSeen) {
      printfTopicS("bcnt %i > size ", bcnt);
      return 0;
    }
    newBits =  M.payloadBitsSeen[bcnt] ^ 0xFF;
  }

  uint16_t pi2i = pi2;
  if (length) {
    for (int8_t i = payloadIndex; i + length > payloadIndex; i--) {
      if (pi2i >= sizePayloadByteVal) {
#ifdef MHI_SERIES
        printfTopicS("Warning: pi2i %i > sizePayloadByteVal, Src 0x%02X Index %i payloadIndex %i ", pi2i, packetSrc, i, payloadIndex);
#else /* MHI_SERIES */
        printfTopicS("Warning: pi2i %i > sizePayloadByteVal, Src 0x%02X Tp 0x%02X Index %i payloadIndex %i ", pi2i, packetSrc, packetType, i, payloadIndex);
#endif /* MHI_SERIES */
        return 0;
      }
      if ((EE.outputFilter <= maxOutputFilter) && !skipHysteresis) changedBits |= (M.payloadByteVal[pi2i] ^ payload[i]);
      pi2i--;
    }
  } else {
    if (EE.outputFilter <= maxOutputFilter) changedBits = 0xFF;
  }
  return (newBits << 8) | (newBits | changedBits);
}

#ifndef H_SERIES
void registerUnseenByte(byte packetSrc, byte packetDst, byte packetType, byte payloadIndex)
{

  byte pti = calculatePti(packetSrc, packetDst, packetType);
  if (pti == 0xFF) return;
  uint16_t pi2 = bytestart[pti] + payloadIndex;

  M.payloadByteSeen[pi2 >> 3] &= ~(1 << (pi2 & 0x07));
}
#endif /* !H_SERIES */

/* not needed (yet)
void registerUnseenBit(byte bcnt, byte bitNr)
{
  if (bcnt >= sizePayloadBitsSeen) {
    printfTopicS("bcnt %i > size ", bcnt);
    return;
  }
  M.payloadBitsSeen[bcnt] &= (0xFF ^ (1 << bitNr));
}
*/

#ifdef MHI_SERIES
uint8_t publishEntityByte(byte packetSrc, byte packetType, byte payloadIndex, byte* payload, const char* mqtt_value, byte length) {
  if (clientPublish(mqtt_value, haQos) && (pi2 >= 0)) {
    M.payloadByteSeen[pi2 >> 3] |= (1 << (pi2 & 0x07));
    uint16_t pi2i = pi2;
    for (int8_t i = payloadIndex; i + length > payloadIndex; i--) {
      if (pi2i >= sizePayloadByteVal) {
        printfTopicS("Warning: pi2i %i > sizePayloadByteVal, Src 0x%02X Index %i payloadIndex %i", pi2i, packetSrc, i, payloadIndex);
        return 0;
      }
      M.payloadByteVal[pi2i] = payload[i];
      pi2i--;
    }
  } // else retry later
  return 0;
}

uint8_t doNotPublishEntityByte(byte packetSrc, byte packetType, byte payloadIndex, byte* payload, const char* mqtt_value, byte length) {
  if (pi2 >= 0) {
    M.payloadByteSeen[pi2 >> 3] |= (1 << (pi2 & 0x07));
    uint16_t pi2i = pi2;
    for (int8_t i = payloadIndex; i + length > payloadIndex; i--) {
      if (pi2i >= sizePayloadByteVal) {
        printfTopicS("Warning: pi2i %i > sizePayloadByteVal, Src 0x%02X Index %i payloadIndex %i", pi2i, packetSrc, i, payloadIndex);
        return 0;
      }
      M.payloadByteVal[pi2i] = payload[i];
      pi2i--;
    }
  } // else retry later
  return 0;
}
#else /* MHI_SERIES */
uint8_t publishEntityByte(byte packetSrc, byte packetType, byte payloadIndex, byte* payload, const char* mqtt_value, byte length) {
  if (clientPublish(mqtt_value, haQos) && (pi2 >= 0)) {
#ifdef E_SERIES
    if (packetType == 0xB8) {
      M.cntByte[pi2] = payload[payloadIndex] & 0x7F;
      return 0;
    }
#endif /* E_SERIES */
    M.payloadByteSeen[pi2 >> 3] |= (1 << (pi2 & 0x07));
    uint16_t pi2i = pi2;
    for (int8_t i = payloadIndex; i + length > payloadIndex; i--) {
      if (pi2i >= sizePayloadByteVal) {
        printfTopicS("Warning: pi2i %i > sizePayloadByteVal, Src 0x%02X Tp 0x%02X Index %i payloadIndex %i", pi2i, packetSrc, packetType, i, payloadIndex);
        return 0;
      }
      M.payloadByteVal[pi2i] = payload[i];
      pi2i--;
    }
  } // else retry later
  return 0;
}

uint8_t doNotPublishEntityByte(byte packetSrc, byte packetType, byte payloadIndex, byte* payload, const char* mqtt_value, byte length) {
  if (pi2 >= 0) {
#ifdef E_SERIES
    if (packetType == 0xB8) {
      M.cntByte[pi2] = payload[payloadIndex] & 0x7F;
      return 0;
    }
#endif /* E_SERIES */
    M.payloadByteSeen[pi2 >> 3] |= (1 << (pi2 & 0x07));
    uint16_t pi2i = pi2;
    for (int8_t i = payloadIndex; i + length > payloadIndex; i--) {
      if (pi2i >= sizePayloadByteVal) {
        printfTopicS("Warning: pi2i %i > sizePayloadByteVal, Src 0x%02X Tp 0x%02X Index %i payloadIndex %i", pi2i, packetSrc, packetType, i, payloadIndex);
        return 0;
      }
      M.payloadByteVal[pi2i] = payload[i];
      pi2i--;
    }
  } // else retry later
  return 0;
}
#endif /* MHI_SERIES */

uint8_t publishEntityBits(byte packetSrc, byte packetType, byte payloadIndex, byte* payload, const char* mqtt_value) {
  if (clientPublish(mqtt_value, haQos)) {
    if (bcnt >= sizePayloadBitsSeen) {
      printfTopicS("bcnt %i > size ", bcnt);
      return 0;
    }
    M.payloadBitsSeen[bcnt] |= bitsMask;
    M.payloadByteVal[pi2] &= (0xFF ^ bitsMask);
    M.payloadByteVal[pi2] |= payload[payloadIndex] & bitsMask;
    pubHaEntityBits &= (0xFFFF ^ (bitsMask | (bitsMask << 8)));
  } // else retry later
  return 0;
}

uint8_t doNotPublishEntityBits(byte packetSrc, byte packetType, byte payloadIndex, byte* payload, const char* mqtt_value) {
  if (bcnt >= sizePayloadBitsSeen) {
    printfTopicS("bcnt %i > size ", bcnt);
    return 0;
  }
  M.payloadBitsSeen[bcnt] |= bitsMask;
  M.payloadByteVal[pi2] &= (0xFF ^ bitsMask);
  M.payloadByteVal[pi2] |= payload[payloadIndex] & bitsMask;
  pubHaEntityBits &= (0xFFFF ^ (bitsMask | (bitsMask << 8)));
  return 0;
}

#ifdef E_SERIES
// global variables to maintain info from check* to pub*
uint16_t ptbs = 0;
byte ppti = 0;
byte ppts = 0;

uint16_t newCheckParamVal(byte paramSrc, byte paramPacketType, uint16_t paramNr, byte payloadIndex, byte* payload, byte paramValLength) {
// returns whether paramNr in paramPacketType has new value M.paramValue
// (also returns true if EE.outputFilter==0)
  bool pubParam = (EE.outputFilter == 0);
  ppts = (paramSrc >> 6) & 0x01; // 0x00 -> 0; 0x40 -> 1; others not used
  if (paramSrc & 0xBF) printfTopicS("UNEXPECTED paramSrc 0x%02X in newCHeckParamVal", paramSrc);
  ppti = paramPacketType - PARAM_TP_START;
  if (paramPacketType == 0x15) ppti = PPTI15;
  uint16_t ptbv = valstart[ppti] + paramNr * parnr_bytes[ppti];
  ptbs = seenstart[ppti] + paramNr;

  if (paramNr == 0xFFFF) {
    return 0;
  }
  if (paramNr >= nr_params[ppti]) {
    printfTopicS("paramNr 0x%04X >= expected nr_params 0x%04X for packetType 0x%02X", paramNr, nr_params[ppti], paramPacketType);
    return 0;
  }
  if ((paramPacketType < PARAM_TP_START) && (paramPacketType != 0x15)) {
    printfTopicS("paramTp 0x%04X < PARAM_TP_START", paramPacketType);
    return 0;
  }
  if (paramPacketType > PARAM_TP_END) {
    printfTopicS("paramTp 0x%04X > PARAM_TP_END", paramPacketType);
    return 0;
  }
  if (M.paramSeen[ppts][ptbs >> 3] & (1 << (ptbs & 0x07))) {
    bool skipHysteresis = false;

    switch (applyHysteresisType) {
      case HYSTERESIS_TYPE_U16_BE:   {
                                       uint16_t oldValue = u_payloadValue_BE(M.paramVal[ppts] + ptbv + 1, 2);
                                       uint16_t newValue = u_payloadValue_BE(payload + payloadIndex, 2);
                                       skipHysteresis = ((newValue <= oldValue + applyHysteresis) && (newValue + applyHysteresis >= oldValue));
                                     }
                                     break;
      case HYSTERESIS_TYPE_S16_BE:   {
                                       int16_t oldValue = (uint16_t) u_payloadValue_BE(M.paramVal[ppts] + ptbv + 1, 2);
                                       int16_t newValue = (uint16_t) u_payloadValue_BE(payload + payloadIndex, 2);
                                       skipHysteresis = ((newValue <= oldValue + (int16_t) applyHysteresis) && (newValue + (int16_t) applyHysteresis >= oldValue));
                                     }
                                     break;
      default :                      skipHysteresis = false;
                                     break;
    }
    for (byte i = payloadIndex + 1 - paramValLength; i <= payloadIndex - ((paramPacketType == 0x39) ? /* 3 */ 0 : 0); i++) {        // 0x39 is field settings so only first byte changes, but (new fs strategy:) check all
      if (M.paramVal[ppts][ptbv++] != payload[i]) pubParam = (EE.outputFilter <= maxOutputFilter) && !skipHysteresis;
    }
  } else {
    // first time for this param
    // only available in bridge-control-function mode, so include avaibility check:
    if ((paramPacketType != 0x39) && (paramPacketType != 0x15)) HADEVICE_AVAILABILITY("A\/8\/Control_Function", 1, 0);
    pubParam = 1; // first time value shown irrespective of EE.outputFilter
  }

  return ((((M.paramSeen[ppts][ptbs >> 3] >> (ptbs & 0x07)) & 0x01) ^ 0x01) << 8) | pubParam;
}

void registerSeenParam() {
  M.paramSeen[ppts][ptbs >> 3] |= (1 << (ptbs & 0x07));
  return;
}

uint8_t publishEntityParam(byte paramSrc, byte paramPacketType, uint16_t paramNr, byte payloadIndex, byte* payload, const char* mqtt_value, byte paramValLength) {
  uint16_t ptbv = valstart[ppti] + paramNr * parnr_bytes[ppti];
  if (clientPublish(mqtt_value, haQos)) {
    for (byte i = payloadIndex + 1 - paramValLength; i <= payloadIndex /* - ((paramPacketType == 0x39) ? 3 : 0) */; i++) M.paramVal[ppts][ptbv++] = payload[i];
    M.paramSeen[ppts][ptbs >> 3] |= (1 << (ptbs & 0x07));
    return 1;
  } else {
    // retry later
    return 0;
  }
}
#endif /* E_SERIES */

// these conversion functions from payload to (mqtt) value look at the current and often also one or more past byte(s) in the byte array

// hex (1..4 bytes), LE

uint8_t value_u_hex_LE(byte packetSrc, byte packetType, byte payloadIndex, byte* payload, char* mqtt_value, byte length) {
  byte* p = payload + payloadIndex - length;
  snprintf(mqtt_value, MQTT_VALUE_LEN - 2, "0x");
  for (byte i = 1; i <= length; i++) snprintf(mqtt_value + i * 2, MQTT_VALUE_LEN - i * 2, "%02X", *++p);
  return publishEntityByte(packetSrc, packetType, payloadIndex, payload, mqtt_value, length);
}

// unsigned integers, LE

uint8_t value_u0(byte packetSrc, byte packetType, byte payloadIndex, byte* payload, char* mqtt_value) {
  registerSeenByte(); // do not publish entity, as only config is needed
  return 0;
}

uint8_t value_byte_nopub(byte packetSrc, byte packetType, byte payloadIndex, byte* payload, const char* mqtt_value, byte length) {
  doNotPublishEntityByte(packetSrc, packetType, payloadIndex, payload, mqtt_value, length);
  return 0;
}

uint8_t value_u_LE(byte packetSrc, byte packetType, byte payloadIndex, byte* payload, char* mqtt_value, byte length) {
  snprintf(mqtt_value, MQTT_VALUE_LEN, "%u", u_payloadValue_LE(payload + payloadIndex, length));
  return publishEntityByte(packetSrc, packetType, payloadIndex, payload, mqtt_value, length);
}

// signed integers, LE

uint8_t value_s_LE(byte packetSrc, byte packetType, byte payloadIndex, byte* payload, char* mqtt_value, byte length) {
  snprintf(mqtt_value, MQTT_VALUE_LEN, "%i", s_payloadValue_LE(payload + payloadIndex, length));
  return publishEntityByte(packetSrc, packetType, payloadIndex, payload, mqtt_value, length);
}

uint8_t value_s8(byte packetSrc, byte packetType, byte payloadIndex, byte* payload, char* mqtt_value) {
  snprintf(mqtt_value, MQTT_VALUE_LEN, "%i", (int8_t) payload[payloadIndex]);
  return publishEntityByte(packetSrc, packetType, payloadIndex, payload, mqtt_value, 1);
}

uint8_t value_s16_LE(byte packetSrc, byte packetType, byte payloadIndex, byte* payload, char* mqtt_value) {
  snprintf(mqtt_value, MQTT_VALUE_LEN, "%i", (int16_t) (uint16_t) u_payloadValue_LE(payload + payloadIndex , 2));
  return publishEntityByte(packetSrc, packetType, payloadIndex, payload, mqtt_value, 2);
}

uint8_t value_sdiv100_LE(byte packetSrc, byte packetType, byte payloadIndex, byte* payload, char* mqtt_value, byte length) {
  snprintf(mqtt_value, MQTT_VALUE_LEN, "%1.2f", s_payloadValue_LE(payload + payloadIndex, length) * 0.01);
  return publishEntityByte(packetSrc, packetType, payloadIndex, payload, mqtt_value, length);
}

uint8_t value_sdiv10_LE(byte packetSrc, byte packetType, byte payloadIndex, byte* payload, char* mqtt_value, byte length) {
  snprintf(mqtt_value, MQTT_VALUE_LEN, "%1.1f", s_payloadValue_LE(payload + payloadIndex, length) * 0.1);
  return publishEntityByte(packetSrc, packetType, payloadIndex, payload, mqtt_value, length);
}

uint8_t value_udiv10(byte packetSrc, byte packetType, byte payloadIndex, byte* payload, char* mqtt_value, byte length) {
  snprintf(mqtt_value, MQTT_VALUE_LEN, "%1.1f", u_payloadValue_LE(payload + payloadIndex, length) * 0.1);
  return publishEntityByte(packetSrc, packetType, payloadIndex, payload, mqtt_value, length);
}

uint8_t value_udiv1000_LE(byte packetSrc, byte packetType, byte payloadIndex, byte* payload, char* mqtt_value, byte length) {
  snprintf(mqtt_value, MQTT_VALUE_LEN, "%1.3f", u_payloadValue_LE(payload + payloadIndex, length) * 0.001);
  return  publishEntityByte(packetSrc, packetType, payloadIndex, payload, mqtt_value, length);
}

// single bit

bool FN_flag8(uint8_t b, uint8_t n)  { return (b >> n) & 0x01; }

uint8_t value_flag8(byte packetSrc, byte packetType, byte payloadIndex, byte* payload, char* mqtt_value, byte bitNr, bool invertValue=false) {
  snprintf(mqtt_value, MQTT_VALUE_LEN, "%i", invertValue ^ FN_flag8(payload[payloadIndex], bitNr));
  return publishEntityBits(packetSrc, packetType, payloadIndex, payload, mqtt_value);
}

// multiple bits

byte FN_bits(uint8_t b, uint8_t n1, uint8_t n2)  { return (b >> n1) & ((0x01 << (n2 - n1 + 1)) - 1); }

uint8_t value_bits(byte packetSrc, byte packetType, byte payloadIndex, byte* payload, char* mqtt_value, byte bitNr1, byte bitNr2) {
  // use bits bitNr1 .. bitNr2
  snprintf(mqtt_value, MQTT_VALUE_LEN, "%i", FN_bits(payload[payloadIndex], bitNr1, bitNr2));
  return publishEntityBits(packetSrc, packetType, payloadIndex, payload, mqtt_value);
}

uint8_t unknownBit(byte packetSrc, byte packetType, byte payloadIndex, byte* payload, char* mqtt_value, byte bitNr) {
  snprintf(mqttTopic + mqttTopicPrefixLength, MQTT_TOPIC_LEN, "PacketSrc_0x%02X_Type_0x%02X_Byte_%i_Bit_%i", packetSrc, packetType, payloadIndex, bitNr);
  snprintf(mqtt_value, MQTT_VALUE_LEN, "%i", FN_flag8(payload[payloadIndex], bitNr));
  return publishEntityBits(packetSrc, packetType, payloadIndex, payload, mqtt_value);
}

// multiple bits, do not publish

uint8_t value_bits_nopub(byte packetSrc, byte packetType, byte payloadIndex, byte* payload, char* mqtt_value) {
  return doNotPublishEntityBits(packetSrc, packetType, payloadIndex, payload, mqtt_value);
}

// misc

uint8_t unknownByte(byte packetSrc, byte packetType, byte payloadIndex, byte* payload, char* mqtt_value) {
  snprintf(mqttTopic + mqttTopicPrefixLength, MQTT_TOPIC_LEN, "PacketSrc_0x%02X_Type_0x%02X_Byte_%i", packetSrc, packetType, payloadIndex);
  snprintf(mqtt_value, MQTT_VALUE_LEN, "0x%02X %i", payload[payloadIndex], payload[payloadIndex]);
  return publishEntityByte(packetSrc, packetType, payloadIndex, payload, mqtt_value, 1);
}

uint8_t value_u8_add2k(byte packetSrc, byte packetType, byte payloadIndex, byte* payload, char* mqtt_value) {
  snprintf(mqtt_value, MQTT_VALUE_LEN, "%u", payload[payloadIndex] + 2000);
  return publishEntityByte(packetSrc, packetType, payloadIndex, payload, mqtt_value, 1);
}

int8_t FN_s4abs1c(uint8_t *b)        { int8_t c = b[0] & 0x0F; if (b[0] & 0x10) return -c; else return c; }

uint8_t value_s4abs1c(byte packetSrc, byte packetType, byte payloadIndex, byte* payload, char* mqtt_value) {
  snprintf(mqtt_value, MQTT_VALUE_LEN, "%i", FN_s4abs1c(&payload[payloadIndex]));
  return publishEntityByte(packetSrc, packetType, payloadIndex, payload, mqtt_value, 1);
}

float FN_u8div10(uint8_t *b)     { return (b[0] * 0.1);}

uint8_t value_u8div10(byte packetSrc, byte packetType, byte payloadIndex, byte* payload, char* mqtt_value) {
  snprintf(mqtt_value, MQTT_VALUE_LEN, "%1.1f", FN_u8div10(&payload[payloadIndex]));
  return publishEntityByte(packetSrc, packetType, payloadIndex, payload, mqtt_value, 1);
}

float FN_u8div2min16(uint8_t *b)     { return (b[0] * 0.5 - 16);}

uint8_t value_u8div2min16(byte packetSrc, byte packetType, byte payloadIndex, byte* payload, char* mqtt_value) {
  snprintf(mqtt_value, MQTT_VALUE_LEN, "%1.1f", FN_u8div2min16(&payload[payloadIndex]));
  return publishEntityByte(packetSrc, packetType, payloadIndex, payload, mqtt_value, 1);
}

float FN_u16div10_LE(uint8_t *b)     { if (b[-1] == 0xFF) return 0; else return (b[0] * 0.1 + b[-1] * 25.6);}

float FN_u16div100_LE(uint8_t *b)     { if (b[-1] == 0xFF) return 0; else return (b[0] * 0.01 + b[-1] * 2.56);}

uint8_t value_u16div10_LE(byte packetSrc, byte packetType, byte payloadIndex, byte* payload, char* mqtt_value) {
  snprintf(mqtt_value, MQTT_VALUE_LEN, "%1.1f", FN_u16div10_LE(&payload[payloadIndex]));
  return publishEntityByte(packetSrc, packetType, payloadIndex, payload, mqtt_value, 2);
}

uint8_t value_u16div100_LE(byte packetSrc, byte packetType, byte payloadIndex, byte* payload, char* mqtt_value) {
  snprintf(mqtt_value, MQTT_VALUE_LEN, "%1.2f", FN_u16div100_LE(&payload[payloadIndex]));
  return publishEntityByte(packetSrc, packetType, payloadIndex, payload, mqtt_value, 2);
}

uint8_t value_header(byte packetSrc, byte packetType, char* mqtt_value) {
  snprintf(mqtt_value, MQTT_VALUE_LEN, "Empty_Payload_%02X00%02X", packetSrc, packetType);
  clientPublish(mqtt_value, haQos);
  return 0;
}

#ifdef MHI_SERIES
uint8_t value_mode(byte packetSrc, byte packetType, byte payloadIndex, byte* payload, char* mqtt_value, int v) {
  switch (v) {
    case  0 : snprintf(mqtt_value, MQTT_VALUE_LEN, "Auto"); break;
    case  1 : snprintf(mqtt_value, MQTT_VALUE_LEN, "Dry"); break;
    case  2 : snprintf(mqtt_value, MQTT_VALUE_LEN, "Cool"); break;
    case  3 : snprintf(mqtt_value, MQTT_VALUE_LEN, "Fan"); break;
    case  4 : snprintf(mqtt_value, MQTT_VALUE_LEN, "Heat"); break;
    default : snprintf(mqtt_value, MQTT_VALUE_LEN, "?"); break;
  }
  return publishEntityBits(packetSrc, packetType, payloadIndex, payload, mqtt_value);
}
#endif /* MHI_SERIES */

uint8_t value_s(byte packetSrc, byte packetType, byte payloadIndex, byte* payload, char* mqtt_value, int v, int length = 0) {
  snprintf(mqtt_value, MQTT_VALUE_LEN, "%i", v);
  return publishEntityByte(packetSrc, packetType, payloadIndex, payload, mqtt_value, length);
}

uint8_t value_s_bit(byte packetSrc, byte packetType, byte payloadIndex, byte* payload, char* mqtt_value, byte v) {
  snprintf(mqtt_value, MQTT_VALUE_LEN, "%i", v);
  return publishEntityBits(packetSrc, packetType, payloadIndex, payload, mqtt_value);
}

uint8_t value_s_nosave(byte packetSrc, byte packetType, byte payloadIndex, byte* payload, char* mqtt_value, int v) {
  snprintf(mqtt_value, MQTT_VALUE_LEN, "%i", v);
  clientPublish(mqtt_value, haQos);
}

uint8_t value_f(byte packetSrc, byte packetType, byte payloadIndex, byte* payload, char* mqtt_value, float v, int length = 0) {
  // Format string based on haPrecision (0..3)
  const char* formats[] = { "%1.0f", "%1.1f", "%1.2f", "%1.3f" };
  byte prec = (haPrecision >= 0 && haPrecision <= 3) ? haPrecision : 3;
  snprintf(mqtt_value, MQTT_VALUE_LEN, formats[prec], v);
  return publishEntityByte(packetSrc, packetType, payloadIndex, payload, mqtt_value, length);
}

// 16 bit fixed point reals

float FN_f8_8_BE(uint8_t *b)                       { return (((int8_t) b[0]) + (b[-1] * 1.0 / 256)); }
float FN_f8_8_LE(uint8_t *b)                       { return (((int8_t) b[-1]) + (b[0] * 1.0 / 256)); }
float FN_s_f8_8_LE(uint8_t *b)  { return (b[-2] ? -1 : 1) * (((int8_t) b[-1]) + (b[0] * 1.0 / 256)); }

uint8_t value_f8_8_LE(byte packetSrc, byte packetType, byte payloadIndex, byte* payload, char* mqtt_value) {
  snprintf(mqtt_value, MQTT_VALUE_LEN, "%1.3f", FN_f8_8_LE(&payload[payloadIndex]));
  return publishEntityByte(packetSrc, packetType, payloadIndex, payload, mqtt_value, 2);
}

uint8_t value_s_f8_8_LE(byte packetSrc, byte packetType, byte payloadIndex, byte* payload, char* mqtt_value) {
  snprintf(mqtt_value, MQTT_VALUE_LEN, "%1.3f", FN_s_f8_8_LE(&payload[payloadIndex]));
  return publishEntityByte(packetSrc, packetType, payloadIndex, payload, mqtt_value, 3);
}

uint8_t value_f8_8_BE(byte packetSrc, byte packetType, byte payloadIndex, byte* payload, char* mqtt_value) {
  snprintf(mqtt_value, MQTT_VALUE_LEN, "%1.3f", FN_f8_8_BE(&payload[payloadIndex]));
  return publishEntityByte(packetSrc, packetType, payloadIndex, payload, mqtt_value, 2);
}

float FN_f8s8_LE(uint8_t *b)            { return ((float)(int8_t) b[-1]) + ((float) b[0]) /  10;}

uint8_t value_f8s8_LE(byte packetSrc, byte packetType, byte payloadIndex, byte* payload, char* mqtt_value) {
  snprintf(mqtt_value, MQTT_VALUE_LEN, "%1.1f", FN_f8s8_LE(&payload[payloadIndex]));
  return publishEntityByte(packetSrc, packetType, payloadIndex, payload, mqtt_value, 2);
}

uint8_t value_textString(char* mqtt_value, char* textString) {
  registerSeenByte(); // record that config was published
  snprintf(mqtt_value, MQTT_VALUE_LEN, "%s", textString);
  clientPublish(mqtt_value, haQos);
  return 0;
}

uint8_t value_byte_textStringOnce(byte packetSrc, byte packetType, byte payloadIndex, byte* payload, char* mqtt_value, char* textString) {
  snprintf(mqtt_value, MQTT_VALUE_LEN, "%s", textString);
  return publishEntityByte(packetSrc, packetType, payloadIndex, payload, mqtt_value, 1);
}

uint8_t value_bits_textStringOnce(byte packetSrc, byte packetType, byte payloadIndex, byte* payload, char* mqtt_value, char* textString) {
  snprintf(mqtt_value, MQTT_VALUE_LEN, "%s", textString);
  return publishEntityBits(packetSrc, packetType, payloadIndex, payload, mqtt_value);
}

#ifdef E_SERIES
// Parameters, unsigned, BE

uint8_t param_value_u_BE(byte paramSrc, byte paramPacketType, uint16_t paramNr, byte payloadIndex, byte* payload, char* mqtt_value, byte paramValLength) {
  uint32_t v = u_payloadValue_BE(payload + payloadIndex, paramValLength);
  snprintf(mqtt_value, MQTT_VALUE_LEN, "%u", v);
  return publishEntityParam(paramSrc, paramPacketType, paramNr, payloadIndex, payload, mqtt_value, paramValLength);
}

// Parameters, unsigned, LE

uint8_t param_value_u_LE(byte paramSrc, byte paramPacketType, uint16_t paramNr, byte payloadIndex, byte* payload, char* mqtt_value, byte paramValLength) {
  uint32_t v = u_payloadValue_BE(payload + payloadIndex, paramValLength);
  snprintf(mqtt_value, MQTT_VALUE_LEN, "%u", v);
  return publishEntityParam(paramSrc, paramPacketType, paramNr, payloadIndex, payload, mqtt_value, paramValLength);
}

uint8_t param_value_udiv2_LE(byte paramSrc, byte paramPacketType, uint16_t paramNr, byte payloadIndex, byte* payload, char* mqtt_value, byte paramValLength) {
  uint32_t v = u_payloadValue_LE(payload + payloadIndex, paramValLength);
  snprintf(mqtt_value, MQTT_VALUE_LEN, "%1.1f", v * 0.5);
  return publishEntityParam(paramSrc, paramPacketType, paramNr, payloadIndex, payload, mqtt_value, paramValLength);
}

uint8_t param_value_udiv2min16_LE(byte paramSrc, byte paramPacketType, uint16_t paramNr, byte payloadIndex, byte* payload, char* mqtt_value, byte paramValLength) {
  uint32_t v = u_payloadValue_LE(payload + payloadIndex, paramValLength);
  snprintf(mqtt_value, MQTT_VALUE_LEN, "%1.1f", v * 0.5 - 16);
  return publishEntityParam(paramSrc, paramPacketType, paramNr, payloadIndex, payload, mqtt_value, paramValLength);
}

/*
uint8_t param_value_u16div10_LE(byte paramSrc, byte paramPacketType, uint16_t paramNr, byte payloadIndex, byte* payload, char* mqtt_value, byte paramValLength) {
  // assuming paramValLength = 2
  if (paramValLength != 2) {
    printfTopicS("Only u16div10_LE supported, not %i bit", 8*paramValLength);
    return 0;
  }
  uint16_t v = u_payloadValue_LE(payload + payloadIndex, paramValLength);
  snprintf(mqtt_value, MQTT_VALUE_LEN, "%1.1f", v * 0.1);
  return publishEntityParam(paramSrc, paramPacketType, paramNr, payloadIndex, payload, mqtt_value, paramValLength);
}
*/

// Parameters, signed, LE

uint8_t param_value_s_LE(byte paramSrc, byte paramPacketType, uint16_t paramNr, byte payloadIndex, byte* payload, char* mqtt_value, byte paramValLength) {
  int16_t v;
  switch (paramValLength) {
    case 1 : v = (int8_t) (uint8_t) u_payloadValue_BE(payload + payloadIndex, paramValLength);
             break;
    case 2 : v = (int16_t) u_payloadValue_BE(payload + payloadIndex, paramValLength);
             break;
    default: printfTopicS("Only s8/s16_LE supported, not %i bit", 8*paramValLength);
             return 0;
  }
  snprintf(mqtt_value, MQTT_VALUE_LEN, "%i", v);
  return publishEntityParam(paramSrc, paramPacketType, paramNr, payloadIndex, payload, mqtt_value, paramValLength);
}

uint8_t param_value_s16div10_LE(byte paramSrc, byte paramPacketType, uint16_t paramNr, byte payloadIndex, byte* payload, char* mqtt_value, byte paramValLength) {
  // assuming paramValLength = 2
  if (paramValLength != 2) {
    printfTopicS("Only s16div10_LE supported, not %i bit", 8*paramValLength);
    return 0;
  }
  int16_t v = (uint16_t) u_payloadValue_LE(payload + payloadIndex, paramValLength);
  snprintf(mqtt_value, MQTT_VALUE_LEN, "%1.1f", v * 0.1);
  return publishEntityParam(paramSrc, paramPacketType, paramNr, payloadIndex, payload, mqtt_value, paramValLength);
}

uint8_t param_value_s16_LE(byte paramSrc, byte paramPacketType, uint16_t paramNr, byte payloadIndex, byte* payload, char* mqtt_value, byte paramValLength) {
  // assuming paramValLength = 2
  if (paramValLength != 2) {
    printfTopicS("Only s16_LE supported, not %i bit", 8*paramValLength);
    return 0;
  }
  int16_t v = (uint16_t) u_payloadValue_LE(payload + payloadIndex, paramValLength);
  snprintf(mqtt_value, MQTT_VALUE_LEN, "%u", v);
  return publishEntityParam(paramSrc, paramPacketType, paramNr, payloadIndex, payload, mqtt_value, paramValLength);
}

uint8_t param_value_s16fan_LE(byte paramSrc, byte paramPacketType, uint16_t paramNr, byte payloadIndex, byte* payload, char* mqtt_value, byte paramValLength) {
  // assuming paramValLength = 2
  if (paramValLength != 2) {
    printfTopicS("Only s16fan_LE supported, not %i bit", 8*paramValLength);
    return 0;
  }
  int16_t v = (uint16_t) u_payloadValue_LE(payload + payloadIndex, paramValLength);
  if (v > 0) {
    v = 450 + 25 * v;
  } else {
    v = 0;
  }
  snprintf(mqtt_value, MQTT_VALUE_LEN, "%u", v);
  return publishEntityParam(paramSrc, paramPacketType, paramNr, payloadIndex, payload, mqtt_value, paramValLength);
}

// u16div10, s16div10 BE

uint8_t param_value_u16div10_BE(byte paramSrc, byte paramPacketType, uint16_t paramNr, byte payloadIndex, byte* payload, char* mqtt_value, byte paramValLength) {
  // assuming paramValLength = 2
  if (paramValLength != 2) {
    printfTopicS("Only u16div10_BE supported, not %i bit", 8*paramValLength);
    return 0;
  }
  uint16_t v = u_payloadValue_BE(payload + payloadIndex, paramValLength);
  snprintf(mqtt_value, MQTT_VALUE_LEN, "%1.1f", v * 0.1);
  return publishEntityParam(paramSrc, paramPacketType, paramNr, payloadIndex, payload, mqtt_value, paramValLength);
}

uint8_t param_value_u32div100_BE(byte paramSrc, byte paramPacketType, uint16_t paramNr, byte payloadIndex, byte* payload, char* mqtt_value, byte paramValLength) {
  // assuming paramValLength = 4
  if (paramValLength != 4) {
    printfTopicS("Only u32_BE supported, not %i bit", 8*paramValLength);
    return 0;
  }
  uint16_t v = u_payloadValue_BE(payload + payloadIndex, paramValLength);
  snprintf(mqtt_value, MQTT_VALUE_LEN, "%1.2f", v * 0.01);
  return publishEntityParam(paramSrc, paramPacketType, paramNr, payloadIndex, payload, mqtt_value, paramValLength);
}

uint8_t param_value_s16div10_BE(byte paramSrc, byte paramPacketType, uint16_t paramNr, byte payloadIndex, byte* payload, char* mqtt_value, byte paramValLength) {
  // assuming paramValLength = 2
  if (paramValLength != 2) {
    printfTopicS("Only s16div10_BE supported, not %i bit", 8*paramValLength);
    return 0;
  }
  int16_t v = (uint16_t) u_payloadValue_BE(payload + payloadIndex, paramValLength);
  snprintf(mqtt_value, MQTT_VALUE_LEN, "%1.1f", v * 0.1);
  return publishEntityParam(paramSrc, paramPacketType, paramNr, payloadIndex, payload, mqtt_value, paramValLength);
}

// misc, hex output, BE

byte unknownParam_BE(byte paramSrc, byte paramPacketType, uint16_t paramNr, byte payloadIndex, byte* payload, char* mqtt_value, byte paramValLength) {
  if (!outputUnknown) return 0;
  snprintf(mqttTopic + mqttTopicPrefixLength, MQTT_TOPIC_LEN, "ParamSrc_0x%02X_Type_0x%02X_Nr_0x%04X", paramSrc, paramPacketType, paramNr);
  switch (paramValLength) {
    case 1 : snprintf(mqtt_value, MQTT_VALUE_LEN, "0x%02X", payload[payloadIndex]); break;
    case 2 : snprintf(mqtt_value, MQTT_VALUE_LEN, "0x%02X%02X", payload[payloadIndex], payload[payloadIndex - 1]); break;
    case 3 : snprintf(mqtt_value, MQTT_VALUE_LEN, "0x%02X%02X%02X", payload[payloadIndex], payload[payloadIndex - 1], payload[payloadIndex - 2]); break;
    case 4 : snprintf(mqtt_value, MQTT_VALUE_LEN, "0x%02X%02X%02X%02X", payload[payloadIndex], payload[payloadIndex - 1], payload[payloadIndex - 2], payload[payloadIndex - 3]); break;
    default : return 0;
  }
  return publishEntityParam(paramSrc, paramPacketType, paramNr, payloadIndex, payload, mqtt_value, paramValLength);
}

byte param_value_hex_BE(byte paramSrc, byte paramPacketType, uint16_t paramNr, byte payloadIndex, byte* payload, char* mqtt_value, byte paramValLength) {
  switch (paramValLength) {
    case 1 : snprintf(mqtt_value, MQTT_VALUE_LEN, "0x%02X", payload[payloadIndex]); break;
    case 2 : snprintf(mqtt_value, MQTT_VALUE_LEN, "0x%02X%02X", payload[payloadIndex], payload[payloadIndex - 1]); break;
    case 3 : snprintf(mqtt_value, MQTT_VALUE_LEN, "0x%02X%02X%02X", payload[payloadIndex], payload[payloadIndex - 1], payload[payloadIndex - 2]); break;
    case 4 : snprintf(mqtt_value, MQTT_VALUE_LEN, "0x%02X%02X%02X%02X", payload[payloadIndex], payload[payloadIndex - 1], payload[payloadIndex - 2], payload[payloadIndex - 3]); break;
  }
  return publishEntityParam(paramSrc, paramPacketType, paramNr, payloadIndex, payload, mqtt_value, paramValLength);
}

// misc, LE

byte unknownParam_LE(byte paramSrc, byte paramPacketType, uint16_t paramNr, byte payloadIndex, byte* payload, char* mqtt_value, byte paramValLength) {
  if (!outputUnknown) return 0;
  snprintf(mqttTopic + mqttTopicPrefixLength, MQTT_TOPIC_LEN, "ParamSrc_0x%02X_Type_0x%02X_Nr_0x%04X", paramSrc, paramPacketType, paramNr);
  switch (paramValLength) {
    case 1 : snprintf(mqtt_value, MQTT_VALUE_LEN, "0x%02X", payload[payloadIndex]); break;
    case 2 : snprintf(mqtt_value, MQTT_VALUE_LEN, "0x%02X%02X", payload[payloadIndex - 1], payload[payloadIndex]); break;
    case 3 : snprintf(mqtt_value, MQTT_VALUE_LEN, "0x%02X%02X%02X", payload[payloadIndex - 2], payload[payloadIndex - 1], payload[payloadIndex]); break;
    case 4 : snprintf(mqtt_value, MQTT_VALUE_LEN, "0x%02X%02X%02X%02X", payload[payloadIndex - 3], payload[payloadIndex - 2], payload[payloadIndex - 1], payload[payloadIndex]); break;
    default : return 0;
  }
  return publishEntityParam(paramSrc, paramPacketType, paramNr, payloadIndex, payload, mqtt_value, paramValLength);
}

#define UNSEEN_BYTE_00_10_19_CLIMATE_DHW registerUnseenByte(0x00, 0x00, 0x10, 19);
#define UNSEEN_BYTE_00_30_0_CLIMATE_ROOM_HEATING registerUnseenByte(0x00, 0x00, 0x30,  0);
#define UNSEEN_BYTE_00_30_1_CLIMATE_ROOM_COOLING registerUnseenByte(0x00, 0x00, 0x30,  1);
#define UNSEEN_BYTE_40_0D_12_PRESET_HEATING_COMFORT registerUnseenByte(0x40, 0x00, 0x00,  12);
#define UNSEEN_BYTE_40_0D_13_PRESET_HEATING_ECO registerUnseenByte(0x40, 0x00, 0x00,  13);
#define UNSEEN_BYTE_40_0D_14_PRESET_COOLING_COMFORT registerUnseenByte(0x40, 0x00, 0x00,  14);
#define UNSEEN_BYTE_40_0D_15_PRESET_COOLING_ECO registerUnseenByte(0x40, 0x00, 0x00,  15);
#define UNSEEN_BYTE_00_30_2_CLIMATE_LWT_HEATING registerUnseenByte(0x00, 0x00, 0x30,  2);
#define UNSEEN_BYTE_00_30_3_CLIMATE_LWT_COOLING registerUnseenByte(0x00, 0x00, 0x30,  3);
#define UNSEEN_BYTE_00_30_4_CLIMATE_LWT_HEATING_ADD registerUnseenByte(0x00, 0x00, 0x30,  4);
#define UNSEEN_BYTE_00_30_5_CLIMATE_LWT_COOLING_ADD registerUnseenByte(0x00, 0x00, 0x30,  5);
#define UNSEEN_BYTE_00_14_05_CLIMATE_LWT_ABS_HEATING registerUnseenByte(0x00, 0x00, 0x14, 5);
#define UNSEEN_BYTE_00_14_07_CLIMATE_LWT_ABS_COOLING registerUnseenByte(0x00, 0x00, 0x14, 7);
#define UNSEEN_BYTE_00_14_10_CLIMATE_LWT_DEV_HEATING registerUnseenByte(0x00, 0x00, 0x14, 10);
#define UNSEEN_BYTE_00_14_11_CLIMATE_LWT_DEV_COOLING registerUnseenByte(0x00, 0x00, 0x14, 11);
#define UNSEEN_BYTE_40_14_18_CLIMATE_LWT_ADD registerUnseenByte(0x40, 0x00, 0x14, 18);
#define UNSEEN_BYTE_40_0F_10_HEATING_ONLY registerUnseenByte(0x40, 0x00, 0x0F, 10);

#define FIELDSTORE(x, registerUnseen) { \
  if (x != fieldSettingValdiv10) {\
    registerUnseen\
    x = fieldSettingValdiv10; \
  }\
}

uint8_t common_field_setting(byte packetSrc, byte packetType, byte payloadIndex, byte* payload, uint16_t paramNr, char* mqtt_value) {
// returns 0 if PUB_CONFIG fails
// returns 1 if PUB_CONFIG succeeds
// returns 2 if no need to publish
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
