Arnold-n/P1P2MQTT/(commit log)

2019-03-19 Restructured as Arduino library
2019-03-28 Improved read circuitry
2019-04-05 circuitry update
2019-04-07 Added: write support, hardware debug mode, schematics. Lib v0.9.0.
2019-04-08 min-load resistor added
2019-04-26 Correction RESET pin
2019-04-27 Prototype board pictures added
2019-05-03 added keywords.txt for syntax highlighting
    keywords.txt with all Methods / Functions / Constants to fit current P1P2Serial
2019-05-14 adapter circuit info added
2019-05-21 updated version 2 schematic
2019-05-21 updated PCB desc
2019-06-01 updated schematics and documentation to version 2
2019-08-18 0.9.4 Arduino P1P2 example applications
2019-08-19 0.9.4 Arduino P1P2 json example application +fix
2019-08-24 v0.9.6 initial control of heating/cooling/DHW on/off function
2019-08-25 v0.9.6 initial control of heating/cooling/DHW on/off function - improved docs/minor fix
    [P1P2Monitor.ino]
2019-09-07 Update P1P2_Daikin_ParameterConversion.h (#13)
    Better reading of flow.
2019-09-07 Update P1P2_Daikin_ParameterConversion_EHYHB.h (#12)
    Few modifications.
    "Temp" = actual measured temperature
    "Target" = actual target temperature (set point)
2019-09-07 formatting/Flow calculation now using FN_u8div10
2019-09-08 v0.9.8 hysteresis added, errorbuf return value no longer including EOB
    [P1P2LCD.ino, P1P2Monitor.ino]
2019-09-14 v0.9.9 autodetect external controller, improved safety, reduced bus collision risk
    [P1P2Monitor.ino]
2019-09-14 v0.9.9 autodetect external controller, improved safety, reduced bus collision risk +counterrequest changes
    [P1P2Monitor.ino]
2019-09-14 v0.9.9 autodetect external controller, improved safety, reduced bus collision risk +counterrequest changes2
    [P1P2Monitor.ino]
2019-09-14 Only debug...
    Need them to avoid "not declared" on Arduino.
2019-09-27 added value info in schematics
2019-10-31 minor bug fix in external controller reply
    [P1P2Monitor.ino]
2019-11-05 Added newline at the end of serial printout.
2019-11-09 solved data misalignment LCD example
    [P1P2-Daikin-LCD-EHYHB.h, P1P2LCD.ino]
2019-11-15 corrected DEFAULT_ID_NONE, added config parameters
    [P1P2Config.h, P1P2Monitor.ino]
2019-11-20 LCD fix handling negative temps
    [P1P2-Daikin-LCD-EHYHB.h, P1P2LCD.ino]
2021-12-03 +MAX22088 schematic reference
2022-03-01 flow param is 16u10
2022-04-23 Announcing MAX22088 P1P2-ESP WiFi bus-powered design, updating README
2022-08-09 v0.9.15 LEDs on at boot, extended verbosity command, ..
2022-08-11 v0.9.16 S_TIMER making TIMER0 (for uptime_sec) use optional
2022-08-17 v0.9.17 License change, adding scope-mode, solving incorrect 16MHz read errors
    [P1P2Config.h, P1P2Monitor.ino, P1P2_Config.h, P1P2_NetworkParams.h]
2022-08-19 0.9.17 now with S_TIMER (ATmega uptime) default on, don't use millis()
2022-08-19 P1P2Monitor fix for nonfunctioning 'E'/'n' write commands -> v0.9.17-fix1
    [P1P2Config.h, P1P2Monitor.ino]
2022-08-20 add esp arch to resolve library considered INCOMPATIBLE by Arduino IDE
2022-08-21 correct license references, delete old programs
    [P1P2-Daikin-LCD-EHYHB.h, P1P2Config.h, P1P2HardwareTest.ino, P1P2LCD.ino]
2022-08-21 more temperature settings reported
2022-08-21 more protocol info on temperatures
2022-08-21 P1P2-bridge-esp8266 fix negative dev temp, more temp reportings and protocol doc
    [P1P2Config.h, P1P2_Config.h]
2022-08-21 One more millisec change
2022-08-23 more protocol doc, write parameter 3A-4E for heating/cooling/auto
2022-08-23 Arduino IDE setup howto
2022-08-23 README ref to howto/setup Arduino IDE
2022-08-25 Refs to ESPAsyncTCP lib corrected (->2.0.1 Phil Bowles)
    [P1P2_Config.h]
2022-08-26 Documentation: Explain data encoding and give examples
    Extend the physical layer documentation by using the signal description from README.md
    and give example how data is encoded.
    Reference physical layer markdown document from landing page.
    Images are licensed under CC BY-SA.
2022-08-29 P1P2-bridge-esp8266 0.9.18 HA energy integration support (state_class issue #27)
    [P1P2_Config.h]
2022-09-03 P1P2-bridge-esp8266 v0.9.19 reboot-reason and 80-char MQTT user/password
    [P1P2_Config.h, P1P2_NetworkParams.h]
2022-09-07 v0.9.21 more VRV, less MQTT traffic, MQTT_INPUT_BIN/HEXDATA, outputMode/Filter in EEPROM
2022-09-11 correcting P1P2_Config.h for E series
    [P1P2_Config.h]
2022-10-30 v0.9.23 for P1P2-ESP-interface v1.1 BB-AVRISP, ADC, w5500 ethernet, various fixes
    [P1P2Config.h, P1P2Monitor.ino, P1P2_Config.h]
2022-11-02 v0.9.24 noWiFi option, w5500-reset, misc
    [P1P2Config.h, P1P2Monitor.ino, P1P2_Config.h]
2022-11-08 0.9.25 ADC readout for F-series; ESP01s config fix
    [P1P2_Config.h]
2022-11-12 v0.9.27 static IPv4 support and Power_* for HA
2022-11-19 v0.9.28 reset-line behaviour, IPV4 EEPROMinit
    [P1P2_Config.h]
2022-11-29 P1P2Monitor 0.9.28 command to restart Daikin, insert user-specified msgs
2022-12-11 v0.9.28 missing-data warning added, fix on-byte crc-less read reports
    [P1P2Monitor.ino]
2022-12-11 v0.9.29 FXMQ support, fix 3+4 write commands, +scopemode via telnet, larger buffers, unlimited write budget option
    [P1P2Config.h, P1P2Monitor.ino, P1P2_Config.h]
2022-12-25 Update F series write possibilties
    Add byte 6 and 8 for heating specific target temp and fan speed, allow fan speed values in range. Tested on FTQ-PB
2022-12-26 Missed opening "(" on #553 and #557
    [P1P2Monitor.ino]
2022-12-29 v0.9.30 undef E_SERIES, switch to unmodified ESP_Telnet 2.0.0
2023-01-05 LogicalFormat: Add EJHA04AAV3 protocol
    The EJHA04AAV3 is an hybrid air-to-water heat pump in cascade
    with gas condensing technology. It does not support cooling.
    The protocol is pretty similar to EHYHBX08AAV3 and EHVX08S26CB9W.
    So far the only difference seems to be that it has less sensors
    (flow, energy produced) than the existing ones.
    Packets 10h-16h and b8h have been observed during
    passive sniffing on the P1P2 bus. Packets 00f031h-00f038h have
    been observed with an external controller on the bus.
2023-01-08 Adding IU_operation_mode+two valves to HA
2023-01-08 P1P2Monitor v0.9.31 fix nr_params check
    [P1P2Config.h, P1P2Monitor.ino]
2023-01-08 P1P2-bridge-esp8266 v0.9.31 fix bit history for 0x30/0x31; +pseudo controlLevel
    [P1P2_Config.h]
2023-01-08 sensor prefix, use 4th IPv4 byte for HA MQTT discovery enabling multiple bridges
2023-01-15 pseudopacket ADC info
2023-02-11 v0.9.33 cycle-steal in all 00F03x response windows (use with care!), Fseries 0xA3 thermistor decode
2023-07-23 adding water pressure (some E models)
2023-07-30 E-series packet10 heating/cooling on/off added
2023-07-31 reset data structures upon mqtt reconnnect/homeassistant restart
    [P1P2_Config.h]
2023-08-06 updated counter request insertion method
2023-10-03 Remove trailing comma from pressure UoMs - Minor Fix
    UoM for pressure readings currently shows as: `bar,`
    It should be: `bar`
2023-10-19 v0.9.43 E-series-only-firmware missing-counter-bug-solved bar-comma-solved
    [P1P2_Config.h]
2023-11-21 allow 0/1/2 for F-series fan speed command
2023-12-01 P1P2Monitor to continue during ESP reset
    [P1P2Monitor.ino]
2023-12-03 P1P2Monitor/bridge versions to v0.9.44rc2, strings shortened
    [P1P2Config.h, P1P2_Config.h]
2023-12-03 improved counter-request-cycle insertion method
2023-12-03 pseudo ADC code requires breaks
2023-12-03 silence-levels, fix power-change code
2023-12-10 fix comment and NTP server
    [P1P2_Config.h]
2024-05-06 use W/Heat_Production instead of kW/Power
2024-05-06 bridge-name device-name G-command
2024-05-06 2 categories pseudo, power 2 pseudo
2024-05-06 blue LED pin
2024-05-18 v0.9.46 HA control, COP realtime/lifetime See release notes for (some breaking) changes Fake room temp sensor, multiple writes Double reset, TZ, P configuration, external E-meter support, P1P2Monitor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
    [P1P2Config.h, P1P2MQTT-bridge.ino, P1P2MQTT.cpp, P1P2MQTT.h, P1P2Monitor.ino, P1P2_Config.h]
2024-05-18 v0.9.47 P1P2MQTT fix bcnt bitbasis code, add Hitachi decoding packet 21001C
    [P1P2_Config.h, P1P2_ParameterConversion.h]
2024-05-18 v0.9.48 E-series external thermostat relay input
2024-05-19 v0.9.50 Disable factory-reset and counter-lock buttons if HA_Setup is switched off
    [P1P2_Config.h, P1P2_ParameterConversion.h]
2024-05-23 Improve/separate MQTT_delete into D12 (own) and D14 (all); move MQTT_delete and factory reset buttons to HC_Setup
2024-05-30 v0.9.52 version increase timeout external electricity meter input maintain mqttserver credentials after factory reset add src=0x41 decoding for Daikin F series
    [P1P2MQTT-bridge.ino, P1P2_Config.h, P1P2_HomeAssistant.h, P1P2_NetworkParams.h, P1P2_ParameterConversion.h]
2024-06-05 v0.9.53rc bridge V_interface is voltage in HA
2024-06-05 RSSI ratelimit replaced by hysteresis
    [P1P2_ParameterConversion.h]
2024-06-05 Assume tank installed and cooling capacity while waiting for field settings
2024-06-05 improve double reset function
    [P1P2MQTT-bridge.ino]
2024-06-30 fix typo in M command explanation
    [P1P2Monitor.ino]
2024-07-15 P1P2Monitor v0.9.54 fix and store fake-temperature-sensor in EEPROM
    [P1P2Config.h, P1P2Monitor.ino]
2024-08-12 minor fix F-series 0x3A reply
    [P1P2Monitor.ino]
2024-09-15 F-series configurable min/max for heating/cooling climate entities
2024-09-15 Interface voltage icon
2024-10-11 MQTT fallback server reporting fixed
    [P1P2MQTT-bridge.ino]
2024-10-16 P1P2Monitor cmd cleanup, fix error message, fix insert message F-series
    [P1P2Config.h, P1P2Monitor.ino]
2024-10-20 Hitachi fix HA %-valve reporting
    [P1P2_HomeAssistant.h]
2024-10-20 P1P2Monitor shorter output messages
    [P1P2Monitor.ino]
2024-10-20 LCD and user mode switching (P1P2Monitor/P1P2MQTT-bridge)
2024-10-20 signed/unsigned handling minor fix
    [P1P2_ParameterConversion.h]
2024-10-22 P1P2MQTT-bridge separate 0xF0/0xF1/0xFF LCD/user mode history, improved button handling
2024-11-27 output field settings only for E comment fix
    [P1P2MQTT-bridge.ino]
2024-11-27 reduce throttle messages
2024-12-06 fix 8-bit entity reported by SG code
    [P1P2_ParameterConversion.h]
2024-12-08 resolve duplicate entries, rename UI entries, misc
    [P1P2_ParameterConversion.h]
2024-12-08 P1P2Monitor fix EEPROM init code
    [P1P2Monitor.ino]
2024-12-11 v0.9.58rc5 E-series heating/cooling eco/comfort preset values
2025-01-08 default setting P26 P27 now 1 to use device name in HA name and HA device identifier
2025-01-12 F-series option P39 for using Inside-Air-Intake in climate entity i.s.o. room temperature
2025-01-12 Restart no longer requires compressor/AlthermaOn to be off
    [P1P2Monitor.ino]
2025-01-22 fix field setting history, add unspecified field settings
    [P1P2_ParameterConversion.h]
2025-01-22 Restart button HA no longer requires Altherma_On
    [P1P2_ParameterConversion.h]
2025-01-22 ATmega reboot detection fix
    [P1P2MQTT-bridge.ino]
2025-01-26 +model 4 for E-series with MMI firmware bug
    [P1P2Config.h, P1P2Monitor.ino]
2025-02-10 Initial framework setup for Mitsubishi M-Net (M_SERIES)
2025-03-30 fix D3/D12/D14 bug (incomplete reset)
    [P1P2_ParameterConversion.h]
2025-03-30 external power timeout increase to 75s
2025-03-30 param15 rename, derive power from param15 when external meter input is missing
    [P1P2MQTT-bridge.ino, P1P2_ParameterConversion.h]
2025-03-30 sensors R9T,R10T, refr_after_heatexchanger
2025-04-07 Get rid of F-series 0x37 error messages
    [P1P2_ParameterConversion.h]
2025-04-07 Fix fallback info messages
    [P1P2MQTT-bridge.ino]
2025-06-07 field setting history fix
    [P1P2_ParameterConversion.h]
2025-08-19 fix - no need write timeout for Hitachi
    [P1P2Config.h]
2026-09-09 MHI heat pump control support (#272)
    * MHI writes support for p1p2 monitor
    * MHI bridge changes to expose climate component
    * revert RC-E5 auto-detect as it skips discovery by master after AC power cycle
    * remove commented out logging
    * add swing mode control
    [P1P2Config.h, P1P2MQTT-bridge.ino, P1P2MQTT.cpp, P1P2Monitor.ino, P1P2_ParameterConversion.h]
2026-09-09 Defrost_Active_param15: binary sensor cannot be temperature (#270)
2026-09-13 Support for fan speed auto, medium-low, and medium-high
